dan-olsen/SeniorDesign/DesignReport/Appendix/Images/ProjectPAMPrezi02.png

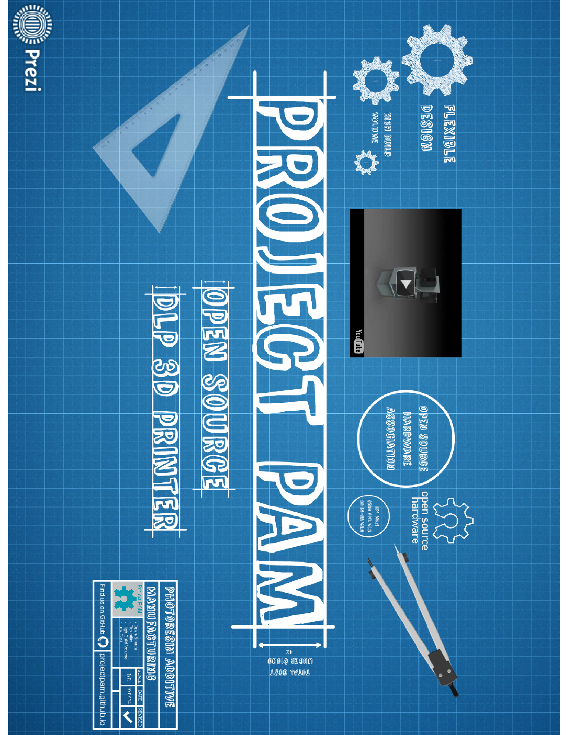
DesignReport/Appendix/Images/ProjectPAMPrezi02.png
