dan-olsen/SeniorDesign/DesignReport/Appendix/Images/Cool Crowdfunding_ October 26, 20141.png

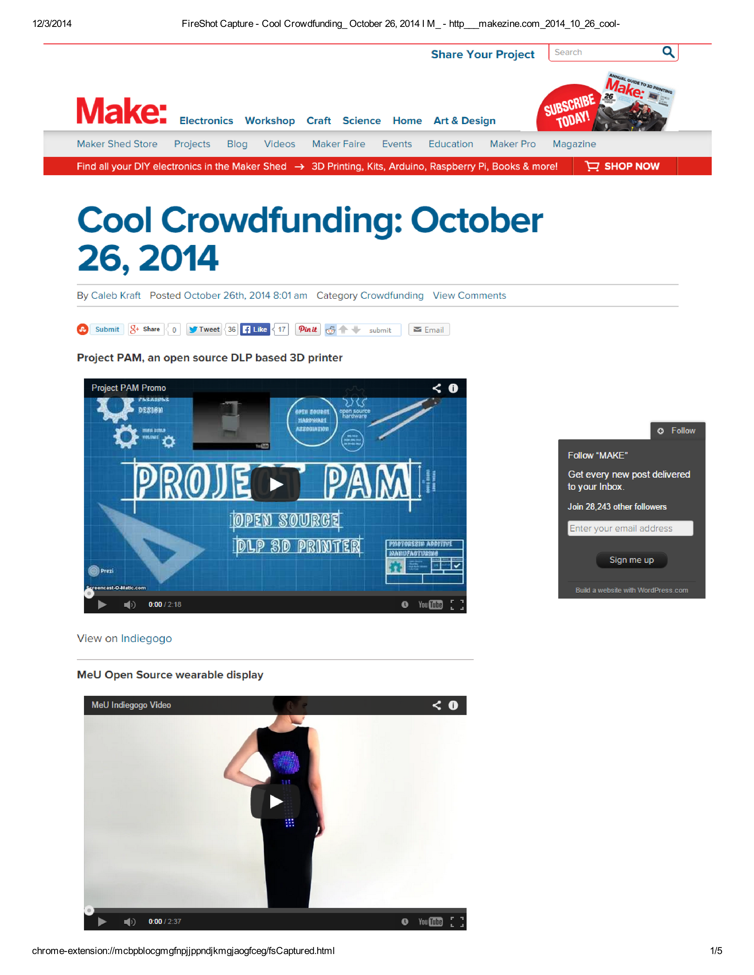
DesignReport/Appendix/Images/Cool Crowdfunding_ October 26, 20141.png
