dan-olsen/SeniorDesign/Poster/ProjectPAMPoster.pptx

## Project PAM

The world’s first open source dlp
3d printer

## Slide 2

## Slide 3

## Slide 4

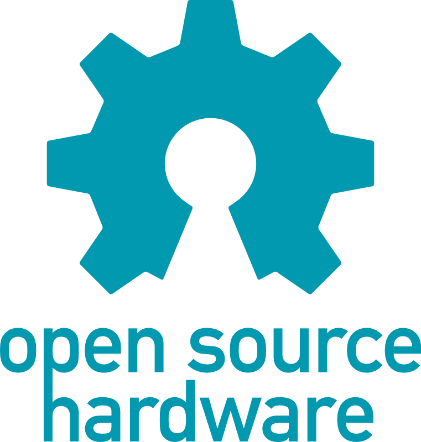
[picture p15: figure]

## Problem

  - High resolution additive manufacturing is not accessible for hobbyists (under $1,000)
  - Current hobbyist 3D printers are imprecise, fault-prone, and poorly documented
  - Available PAM systems are inflexible, use proprietary hardware and software

## Solution

  - Libre
  - Accessible to the hobbyist
  - Precise and repeatable
  - Flexible for the end user
  - Off-the-shelf open-source hardware
  - A thoroughly documented reference design

## Market Gap

## Specifications

Geometry | Dimension/Tolerance
Build Volume Size | 192 mm x 216 mm x 216 mm
X and Y Axis Resolution | 0.100 mm
Minimum Layer Height | 0.015 ± 0.002 mm
Parallelism/Perpendicularity of a 20 mm cube | 0.050 mm
Dimensional Tolerance of a 20 mm cube | ± 0.050 mm

## Current Prototype

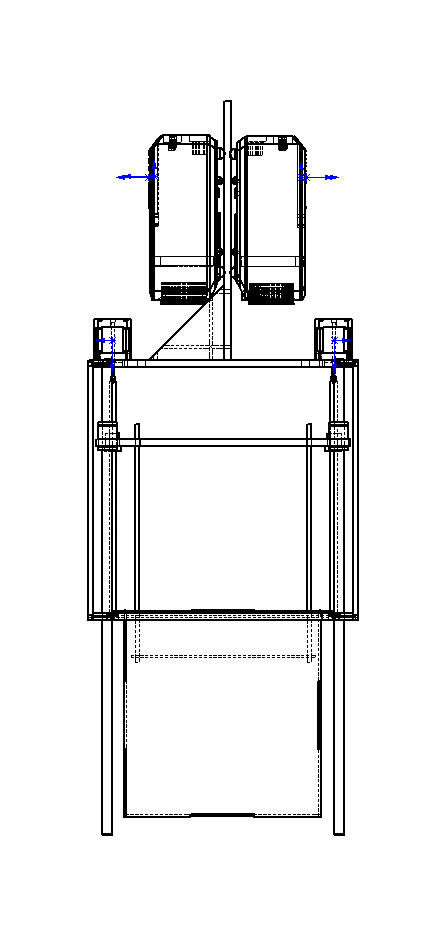
[picture p16: figure]
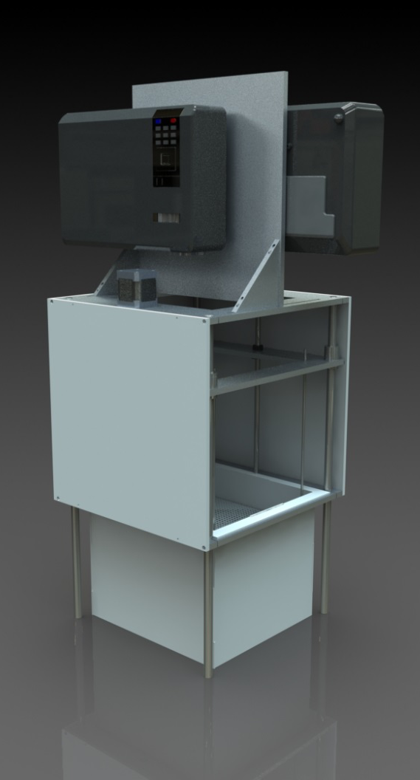
[picture p17: figure]
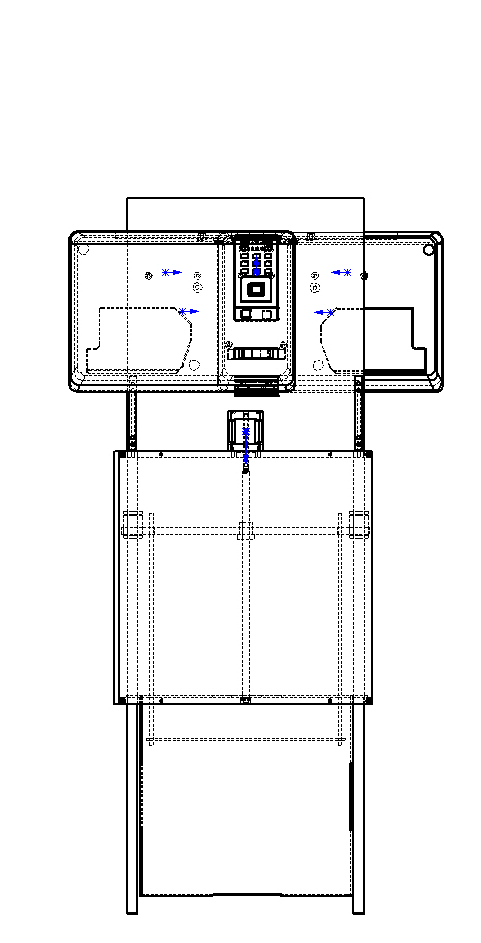
[picture p18: figure]

## Slide 10

## Wire Diagram

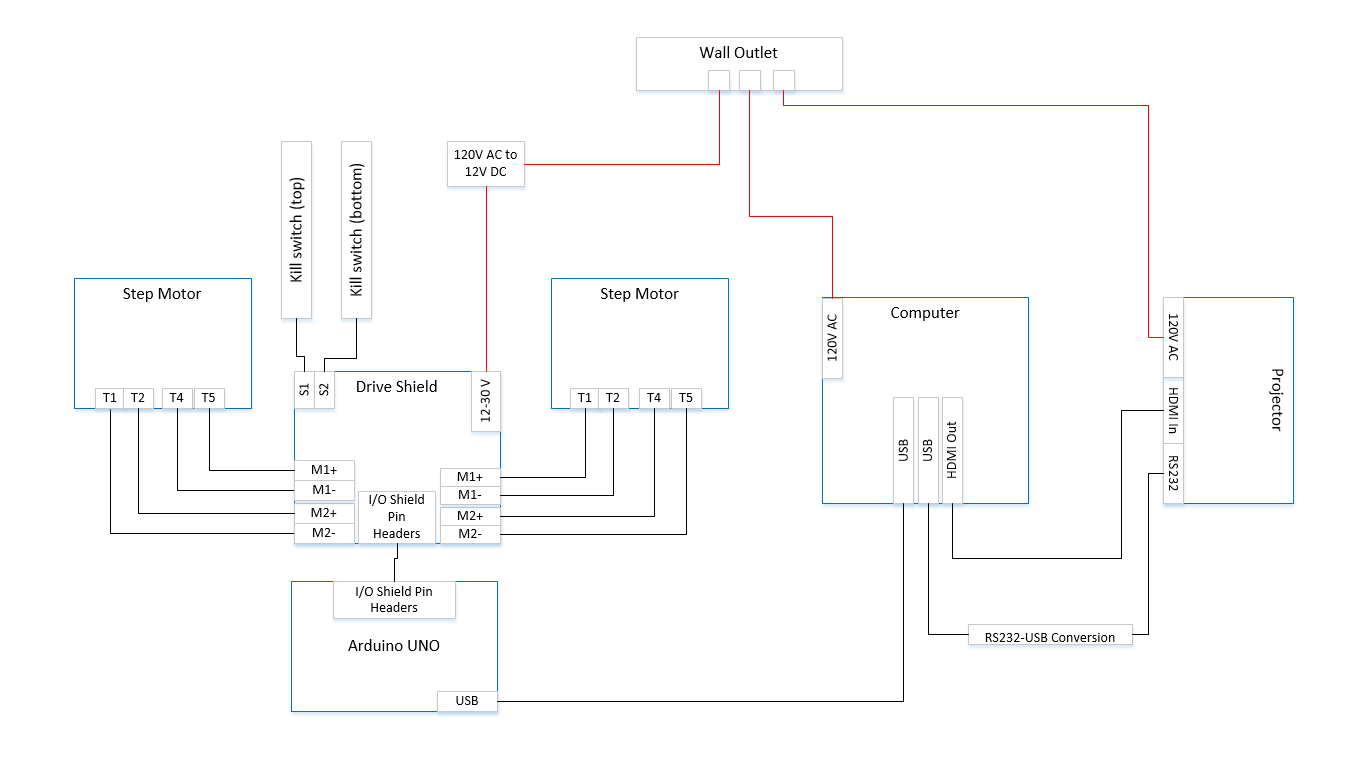
[picture p19: figure]

## Functional Block Diagram

## Cost

Item | Price
Motion control | $113.61
Chassis | $315.99
Hardware software interface | $25.97
Motors/motor control | $82.83
Maker Juice resins | $45.00
Total | $602.17

## Full System Run

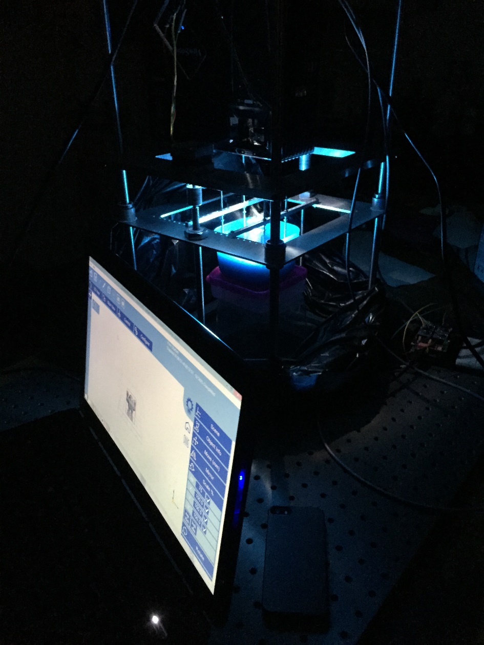
[picture p20: figure]

## Test Prints

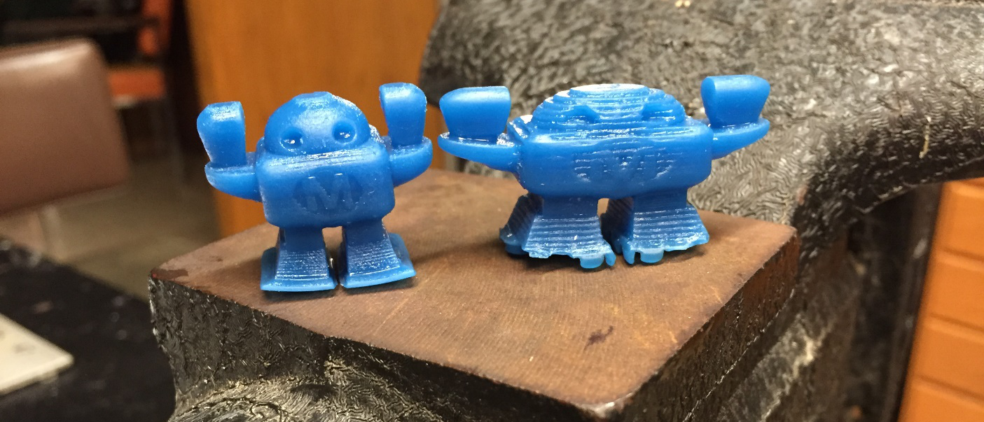
[picture p21: figure]
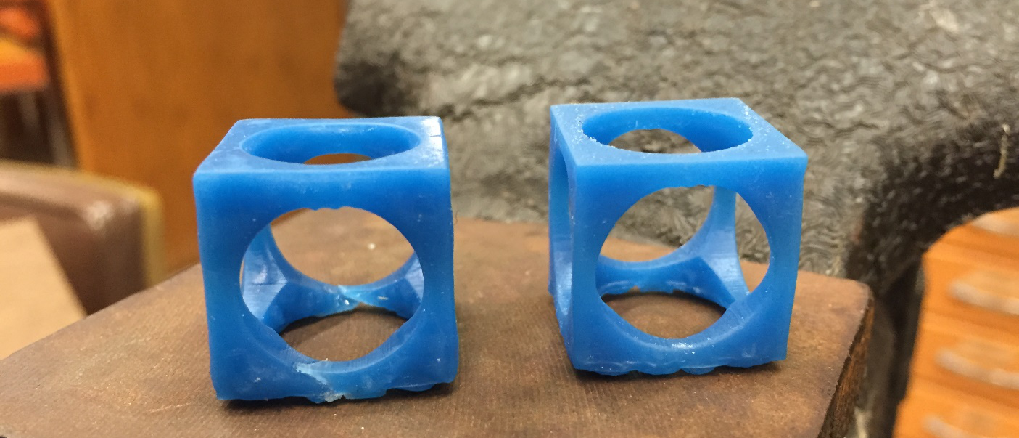
[picture p22: figure]

## Slide 16

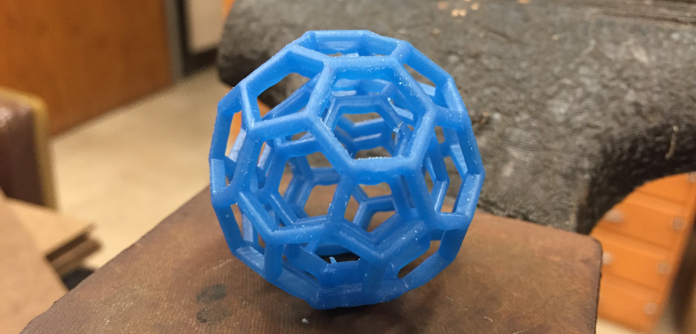
[picture p23: figure]
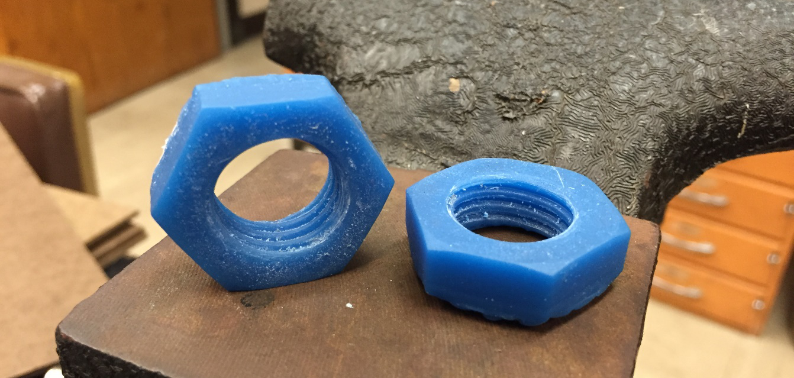
[picture p24: figure]
