dan-olsen/SeniorDesign/DesignReport/jeffsPart/ProjectPamReport.docx

Project PAM

A Reference Design for

Photoresin Additive Manufacturing for

The Open Source Community

Saluki Engineering Company

Reference Number: S14-75-3DPR

Date

Nicholas Lowman | Computer Engineering
Daniel Olsen | Computer Engineering
Chance Baker | Electrical Engineering
Casey Spencer | Electrical Engineering
Jeffrey Burdick | PM Mechanical Engineering
Nathaniel Tyler | Mechanical Engineering

# Transmittal Letter: CWB

2014-11-18

Saluki Engineering Company

Southern Illinois University Carbondale

College of Engineering – Mail Code 6603

1230 Lincoln Drive

Carbondale, IL 62901

Steven Blair, President

Saluki Makerspace

Southern Illinois University Carbondale

College of Engineering – Mail Code 6603

Room E0021

1230 Lincoln Drive

Carbondale, IL 62901

Mr. Blair,

On behalf of the Saluki Engineering Company, I would like to thank you for including us in the bid for a project to design a digital light processing printer. Attached is a design report for a DLP photoresin printer, Project PAM. Along with this report, we have included the computer host software code and build instructions of the prototype.

Project PAM proposes a reference Photoresin Additive Manufacturing (PAM) system which maximizes accessibility to the hobbyist. It is intended to be easily obtainable to consumers. This is achieved through extensive use of currently available or easily fabricated hardware and open-source software. The design allows this hardware to be very flexible, to scale to the size requirements of the maker. The reference design will be open-source hardware and software to the lowest practical level. Thorough documentation will provide the necessary means for the maker to go from an empty table to a functioning printer.

Our prototype is constructed to allow a build volume up to 192 mm x 216 mm x 216 mm with an X and Y pixel size of 100 μm and layer thicknesses down to 10 µm. In its current single-projector configuration it can provide a build volume of up to 216 mm x 121.5 mm with an X and Y pixel size of 112.5 µm. It can also close focus to provide a much smaller pixel size for smoother builds of smaller objects. This can be accompanied with a smaller build table and build vat to involve a smaller volume of resin.

The prototype comes with a 1920 x 1080 pixel ViewSonic projector which has been proven to provide very close focusing and will be perfect for later expansion to a large volume two projector system.

Please feel free to contact me at (815) 214 9661 or by email, burdickjp@siu.edu, if you have questions about this project.

Sincerely,

Jeffrey P Burdick

Project Manager

Project PAM: Team75-3DPR

Saluki Engineering Company

(815) 214-9661

burdickjp@siu.edu

# Acknowledgements: CWB

We would like to express our thanks to Dr. Spyros Tragoudas and Dr. Rasit Koc along with the Electrical and Computer Department and the Mechanical Department for the support and financial contributions. The project would not have been possible without their financial backings.

We would also like to take the time to thank the backers of the crowed funding campaign. Very person’s contribution was very much accommodating to the needs of our group. We would like to thank them for not only their financial report but their words of encouragement and belief in our project.

From the beginning of the project Dr. Lizette Chevalier has given priceless words of encouragement and advice that has been very critical to the success of the project.

At this time we would like to thank Lakendria Kenner of WSIU, Scott J. Grunewald of 3D Printing Industry, Eddie Krassenstein of 3D Print, and Austin Miller of Dailey Egyptian for the kind words in their articles. Their articles have help spread the work of Project PAM out to the global community.

We would like to take this opportunity to thank Dr. James Mathias for him allowing us to have use to his laboratory space giving Project PAM a place to call home.

We also would like to express a deep sense of gratitude to the team’s Faculty Technical Advisors; Dr. James Mabry and Joe Lennox, for their constant support, valuable guidance, and professional advice throughout the various stages of the design project.

We are grateful for the assistance of Tim Attig of the SIUC Machine Shop. His vast machining skills and knowledge have been a great part of the project’s success. Tim’s time and technical advice was invaluable to the team.

Lastly, we would like to thank the professors and teachers of the class; Dr. Tod Policandriotes, Dr. Vidya Singh-Gupta, Dr. Frances Harackiewicz, and Dr. Alan J. Weston for their support, ideas, and suggestions.

# Table of Contents: CWB

# Table of Figures: CWB

# Table of Tables: CWB

# Table of Drawings: CWB

# 1 Executive Summary:CWB

Project PAM proposes a reference Photoresin Additive Manufacturing (PAM) system which maximizes accessibility to the hobbyist. It is intended to be flexible by allowing for configurations of hardware available or easily obtainable to the maker. This is achieved through extensive use of currently available or easily fabricated hardware and open-source software. The reference design uses open-source hardware and software to the lowest practical level. Thorough documentation provides the necessary means for the maker to go from an empty table to a functioning printer.

The major subsystems of Project PAM include: Mechanical Motion, Chassis, Printer Control Software, Hardware-Software Interface, Resin Management, Optics, Vat, and Coupler. Our teams is still striving to achieve the optimist solution to achieve the highest level of quality.

Several of the design activities and decisions show how Project PAM is more desirable than the competition. One example of this is Project PAM’s build volume size. The maximum build volume is almost double that of any other DLP printer. This is achieved by supporting the use of two 1920 x 1080 pixel projectors. As consumer resins increase with quality this feature will allow the PAM system to grow. Though the maximum build volume would use up to 9 L of resin, Project PAM’s flexible design can accommodate smaller vats and build tables. The maker can use a vat and build table sized appropriately for their build. This will minimize resin waste, saving the maker money.

This printer is expected to have the capability of producing high quality prints. The initial goals of Project PAM included: keep the cost of the project under $700 excluding the price of the projectors, support the use of two projectors, have a maximum build size of approximately 8 L, layer thickness as thin as 100 µm, and have a printing resolution error within 100 µm.

The prototype is sized to support a build volume of 192 mm x 216 mm x 216 mm which is a volume of 8.9 L. This would be achieved through the use of two 1920 x 1080 pixel projectors used in tandem, providing a pixel size of 100 μm. The prototype is currently configured with a single 1920 x 1080 pixel projector. With 2mm pitch lead screws and stepper motors providing 200 steps per revolution layer heights can be as thin as 10 µm without microstepping.

This report consists of: a project description that will introduce the report and project, a cost analysis allowing the open-source community to see the end cost, expected build time schedule, detailed subsystems descriptions along with recommendations, and an appendix.

# 2 Project Description:

## 2.1 Introduction: CWS

Today when one uses the term "3D printing" they referring to the manufacturing process that allows a digital model to be manufactured through an additive process. 3D printing is unique from other machining processes because it implements what's known as additive manufacturing rather than the more common techniques of drilling or cutting to remove material. 3D Printers are able to accomplish this by slicing the virtual models into several two dimensional layers and then printing those layer one by one to build up the object. This is advantageous because it is much less wasteful than traditional techniques. A 3D printer is also capable of building nearly any object which allows manufacturers to change products without having to buy any new equipment.

The first 3D printer was built in 1984 by Chuck Hall [1] but the process has not been widely available until the early 2010's. Printers are most commonly used for cheap and rapid prototyping but the process has shown potential in a number of fields, including architecture, automotive design, and even the biomedical field to print human tissue and organs. Because of this potential the industry is estimated to be worth more than $2.2 billion today [2].

There are several techniques used to accomplish this layer-by-layer building operation, the most common of the additive manufacturing processes today is extrusion deposition. With this extrusion deposition each 2D layer is built by extruding a bead of material which will harden almost instantly upon leaving the extruder nozzle. The nozzle head moves across a surface depositing the material in the shape of the given layer and then moves on to build the next layer of the object. As each layer is added the print object gains volume. This method is simple and inexpensive but is less accurate than other techniques and also error prone since any defect can lead to a jam or clog in the extruder.

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

## 2.2 overall Printer Diagram:

Figure 1. Flow Diagram for Project PAM printer control software

# 3 Costs:

# 4 Schedules:

# 5 Subsystem Descriptions:

## 5.1 Chassis-JPB

### 5.1.1 Process of Design

An early goal of the hardware design was to have a product which was very rigid and allowed adjustability for all pieces which need to be aligned. Several options were considered for the construction of the chassis, from an incorporated enclosure and chassis design to open source linear motion systems.

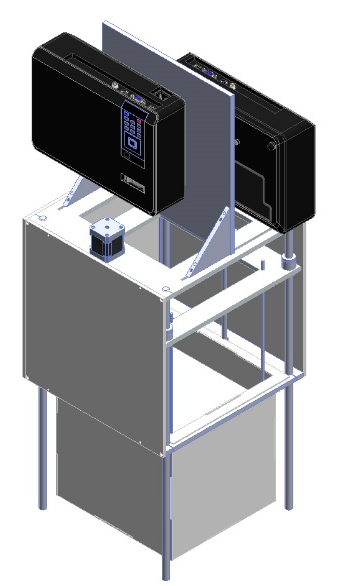
[picture p33: figure]

Figure 2. An isometric view of the current chassis design

It was decided that conventional round linear bearing shafts could be used as the vertical component of the chassis, as shown in Figure 2. This removes the necessity for a separate vertical chassis structure. This simplified the chassis design to just two horizontal structural plates to hold the motion-driving components, projector, and vat, and the linear bearing shafts. The chassis plates attach to the linear bearing shafts by clamping. The height of the system could then be easily changed, and the system could be easily squared by adjusting the plates and shafts.

A design was considered which used three linear bearing shafts as legs instead of four, as this would make the alignment process easier and was thought to reduce material. It was found that material costs would not be reduced, as a configuration using three or four legs would involve ordering the same length of shaft because of minimal material requirements with most industrial suppliers. The tripod design would also necessitate larger chassis plates and more material waste.

The initial design proposal involved chassis dimensions of 300 x 320 mm to accommodate stepper motors mounted on the bottom chassis plate. This would require the order of a 12 x 18 inch plate and involve wasting a lot of material. In order to fit the design within a 12 x 12 inch plate the stepper motors were moved to the top plate. This also allowed the weight of the carriage to be carried by thrust bearings in the bottom plate rather than the stepper motors and couplers.

The throw and focusing distance of the project allowed it to be clamped directly to the top chassis plate. Testing could then be accomplished without needing to permanently mount the projector.

### 5.1.2 Process of Assembling

The four bearing shafts are placed in the bottom chassis plate. The protrusion of the shafts from the plate is established using calipers. One of the shafts is tightened fully, while the others are left snug. The assembly is then placed on a surface plate and the chassis plate is leveled using a height gage. The carriage is placed on the bearing shafts and the top plate is placed. After the correct distance between the two plates is determined, the top chassis plate is leveled using the height gage and the carriage can be leveled according to the assembly directions in section 5.2.2.

### 5.1.3 IMPLEMENTATION SCHEDULE

### 5.1.4 Equipment Needed

Manufacturing of the prototype was completed using machine tools, but manufacturing for the maker can be achieved by water jetting, EDM, or CNC machining. This is easy and inexpensive to contract with machine shops, or made in bulk. Finish machining can be done using hand tools.

### 5.1.5 Health and Safety Issues

### 5.1.6 Recommendations

An enclosure can be assembled from nearly any sheet material. Gaffers tape is good for sealing. When doing quick testing a leaf bag can be used as an expedient enclosure.

## 5.2 Mechanical Motion-JPB

### 5.2.1 Process of Design

The single axis of motion is achieved by the use of a carriage plate riding on four linear bearings riding on the chassis shafts. The build table hangs from this carriage into the vat.

The initial motion control design involved a single lead screw. It was determined that the rigidity required to implement the design with a single lead screw would require a prohibitive amount of complication. Using two lead screws would allow for smoother operation without an excessive cost increase. Both lead screws ride on ball-bearing thrust bearings held in the bottom chassis plate.

Backlash has been a rather prolific problem with 3d printers of all varieties. Many interesting and complicated methods of handling backlash have been suggested in the community [3]. It was decided to make the lead screw nut out of acetal and attempt a novel method of implementing threads which involved heating the lead screw and allowing the acetal to flow form around it [4]. The cooled lead screw nut would then fit more snugly than cut threads. This proved excessively difficult with the acetal used. It was decided to abandon this method in favor of a more traditionally manufactured lead screw nut, but retain delrin as the material of choice. A section of lead screw was used to construct a tap and a section of acetal was drilled to the smallest inside diameter specified for the thread profile in the hopes that a tight fit could be achieved. After tapping this proved to provide a sufficiently tight enough fit to prevent backlash. When implemented on the chassis it has shown to not produce so much friction as to cause mistepping of the stepper motors.

The stepper motors are connected to the lead screws by flexible couplers, which allow axial misalignment while maintaining torque transmission. While off-the-shelf components are readily available and inexpensive, a design for these couplers is included in the project.

### 5.2.2 Process of Assembling

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

The build table should be suspended from the carriage and leveled. The level of the build table should be checked by filling the vat with salt water and adjusting the build table to ensure that the liquid is level over the build table.

### 5.2.3 IMPLEMENTATION SCHEDULE

### 5.2.4 Equipment Needed

Proper leveling should be done on a surface plate with a height gage, but can be achieved on any sufficiently flat surface with a good ruler, calipers, or trammel points.

### 5.2.5 Health and Safety Issues

### 5.2.6 Recommendations

Suspending smaller build tables by three rods instead of four should allow faster leveling. If there is a bend or warp to the table the fourth rod can be introduced to minimize this. Level and flatness of the build table is much more obvious when suspended over a level of liquid than when just using a height gage.

## 5.3 Printer Control Software- DMO

## 5.4 Hardware-Software Interface- NAL

## 5.5 Resin Management-CWB

### 5.5.1 Process of Design

As Project PAM was unfolding, the decision to become a photoresin printer emerged. The first design of the resign was to use a custom product from Momentive. Momentive Specialty Chemicals Inc. serves the global wood and industrial markets through a broad range of thermoset technologies, specialty products and technical support for customers in a diverse range of applications and industries [3]. This would have allowed Project PAM complete control over the wavelength needed to cure the resin, over the color, over the density, and over the curing agents.

Because of the goal of the project to be completely open source, this idea was abandon for buying resins that will be more accessible to the open source community. While looking through photoresin system forums, there was one company that had shown up on mutable post as being reliable and cost effective, MakerJuice [4]. MakerJuice is an American company first started in 2013 with a focus of quality and low cost resins aimed for the hobbyists’ community [5]. They have sold over eight-thousand items and have over two-thousand customers since their start [5]. This gave Project PAM the facts it needed to use MakerJuice for the prototype.

### 5.5.2 Health and Safety Issues

Resins by MakerJuice are in compliance of USA and Canada standards [5]. Safety Data Sheets (SDS) for all of their products can be found on their website. The SDS for the resin G+, ordered by Project Pam can be found in this report at 7.1.

G+ is a category 2 skin corrosion, category 1 serious eye damage, and a category 1 for skin sensitization set by the 2012 OSHA Hazard Communication Standard [5]. The precautionary prevention steps are as follows: Wash face, hands and any exposed skin thoroughly after handling, wear protective gloves/protective clothing/eye protection/face protection, avoid breathing dust/fume/gas/mist/vapors/spray, and contaminated work clothing should not be allowed out of the workplace [5].

The precautionary response steps are as follows: If in the eyes; Rinse cautiously with water for several minutes. Remove contact lenses, if present and easy to do. Continue rinsing. Immediately call a POISON CENTER or doctor/physician. If on the skin; Wash with plenty of soap and water. Take off contaminated clothing and wash before reuse. If skin irritation or rash occurs: Get medical advice/attention [5].

### 5.5.3 Recommendations

There are several different types of resins that are open to the hobbyist community. Some resins cure harder than other resin, but this can result in a longer cure time. Different types of resins can allow for the end print to be flexible, like MakerJuice’s Flex [5].

There are a few things to keep in mind while shopping for resin. The first thought is the cost. There are several companies that are based out of the US who have cheaper resins but the shipping cost is sometimes up to triple the cost of their product. Another thought is the shrink percent. MakerJuice’s G+ substance has an experimental shrinkage of 3.3%, while their G substance has an 8% experimental shrinkage [5]. Shrinkage is the most common problem with prints with a build volume over 100cm³ [4]. The G+ was $45.00 a liter, and the G was $40 a liter in May of 2014 [5]. The maker will have to decide if it is worth the extra $5 to ensure precise prints.

To help offset the use of resin several hobbyist have had success of using saltwater [4]. The resin floats on top of the saltwater. This means that a hobbyist only needs to put as much resin in the vat as what is needed for the build or the layer thickness. With the price of most resins being around $50, this idea is a great way to save resin and money.

## 5.6 Optics-CWB

### 5.6.1 Process of Design

## 5.7 Vat-NBT

## 5.8 Coupler-NBT

# 6 References: CWB

[1] | "3D Printing: What You Need to Know," [Online]. Available: http://www.pcmag.com/slideshow_viewer/0,3253,l=293816&a=289174&po=1,00.asp. [Accessed 17 April 2014].
[2] | "3D Printing Scales Up," The Economist, 7 September 2013.
[3] | "Momentive," Momentive, 2014. [Online]. Available: http://www.momentive.com/. [Accessed 2014].
[4] | "Resin," Build Your Own SLA, January 2014. [Online]. Available: www.buildyourownsla.com. [Accessed 26 February 2014].
[5] | "MakerJuice," MakrJuice Labs, 2014. [Online]. Available: www.makerjuice.com. [Accessed May 2014].

# 7 Appendix

## 7.1 MakerJuice Safety Data Sheet

Issue Date 19-Nov-2013 Revision Date 22-May-2014 Version 2

1. IDENTIFICATION OF THE SUBSTANCE/PREPARATION AND OF THE COMPANY/UNDERTAKING

Product identifier

Product Name SUBSTANCE G+

Other means of identification

Synonyms SubG+

Recommended use of the chemical and restrictions on use

Recommended Use General Purpose UV Cure Resin

Uses advised against No information available

Details of the supplier of the safety data sheet

Manufacturer Address

MakerJuice Labs LLC

14100 Santa Fe Trail Drive

Suite #105

Lenexa, KS 66215 USA

Email: josh@makerjuice.com

Website: http://www.makerjuice.com

Emergency telephone number

Company Phone Number (913) 777-4996 [9-5PM CST, M-F]

2. HAZARDS IDENTIFICATION

Classification

OSHA Regulatory Status

This chemical is considered hazardous by the 2012 OSHA Hazard Communication Standard (29 CFR 1910.1200)

Skin corrosion/irritation Category 2

Serious eye damage/eye irritation Category 1

Skin sensitization Category 1

Label elements

Emergency Overview

Danger

Hazard statements

Causes skin irritation

Causes serious eye damage

May cause an allergic skin reaction

Appearance viscous Physical state liquid Odor Ester

Precautionary Statements - Prevention

Wash face, hands and any exposed skin thoroughly after handling

Wear protective gloves/protective clothing/eye protection/face protection

Avoid breathing dust/fume/gas/mist/vapors/spray

Contaminated work clothing should not be allowed out of the workplace

Precautionary Statements - Response

IF IN EYES: Rinse cautiously with water for several minutes. Remove contact lenses, if present and easy to do. Continue rinsing.

Immediately call a POISON CENTER or doctor/physician

IF ON SKIN: Wash with plenty of soap and water

Take off contaminated clothing and wash before reuse

If skin irritation or rash occurs: Get medical advice/attention

Precautionary Statements - Disposal

Dispose of contents/container to an approved waste disposal plant

Hazards not otherwise classified (HNOC)

Not Applicable

Other Information

Unknown Acute Toxicity 0% of the mixture consists of ingredient(s) of unknown toxicity

3. COMPOSITION/INFORMATION ON INGREDIENTS

Chemical Name CAS No. Weight-% Trade Secret

acrylate ester proprietary >60 *

photoinitiator proprietary <1 *

* If CAS number is "proprietary", the specific chemical identity has been withheld as a trade secret. The exact percentage

(concentration) of composition has been withheld as a trade secret.

4. FIRST AID MEASURES

First aid measures

General advice If symptoms persist, call a physician.

Eye contact Immediately flush with plenty of water. After initial flushing, remove any contact lenses

and continue flushing for at least 15 minutes. Keep eye wide open while rinsing. If

symptoms persist, call a physician.

Skin Contact Avoid UV-radiation/sunlight. Wash off immediately with soap and plenty of water while

removing all contaminated clothes and shoes. If skin irritation persists, call a physician.

Wash contaminated clothing before reuse.

Inhalation If fumes from reactions are inhaled, move to fresh air immediately. If symptoms persist,

call a physician.

Ingestion Rinse mouth. Drink plenty of water. Do NOT induce vomiting. Call a physician immediately.

Self-protection of the first aider Use personal protective equipment as required.

Most important symptoms and effects, both acute and delayed

Symptoms May cause allergic skin reaction.

Indication of any immediate medical attention and special treatment needed

Note to physicians May cause sensitization of susceptible persons. Treat symptomatically.

5. FIRE-FIGHTING MEASURES

Suitable extinguishing media

Dry chemical, CO2, alcohol-resistant foam or water spray.

Unsuitable extinguishing media: Do not use a solid water stream as it may scatter and spread fire.

Specific hazards arising from the chemical

In the event of fire and/or explosion do not breathe fumes. May cause sensitization by inhalation and skin contact. Thermal

decomposition can lead to release of irritating and toxic gases and vapors.

Hazardous combustion products: Formaldehyde.

Explosion data

Sensitivity to Mechanical Impact: None.

Sensitivity to Static Discharge: None.

Protective equipment and precautions for firefighters

Wear self-contained breathing apparatus for firefighting if necessary.

6. ACCIDENTAL RELEASE MEASURES

Personal precautions, protective equipment and emergency procedures

Personal precautions Ensure adequate ventilation, especially in confined areas. Use personal protective

equipment as required. Avoid contact with eyes and skin. Evacuate personnel to safe

areas. Keep people away from and upwind of spill/leak.

Environmental precautions

Environmental precautions Do not flush into surface water or sanitary sewer system. See Section 12 for additional

ecological information.

Methods and material for containment and cleanup

Methods for containment Prevent further leakage or spillage if safe to do so.

Methods for cleaning up Soak up with inert absorbent material. Pick up and transfer to properly labeled containers.

After cleaning, flush away traces with water.

7. HANDLING AND STORAGE

Precautions for safe handling

Advice on safe handling Use only in well-ventilated areas. Avoid breathing fumes from hot material. Use personal

protective equipment as required. Do not breathe dust/fume/gas/mist/vapors/spray.

Conditions for safe storage, including any incompatibilities

Storage Conditions Keep out of the reach of children. Keep containers tightly closed in a cool, well-ventilated

place. Keep in properly labeled containers. Protect from direct sunlight and ultraviolet (UV).

Keep away from heat.

Incompatible materials Strong oxidizing agents. Strong acids. Strong bases.

8. EXPOSURE CONTROLS/PERSONAL PROTECTION

Control parameters

Exposure Guidelines This product, as supplied, does not contain any hazardous materials with occupational

exposure limits established by the region specific regulatory bodies.

Appropriate engineering controls

Engineering Controls Ensure adequate ventilation, especially in confined areas.

Individual protection measures, such as personal protective equipment

Eye/face protection Tight sealing safety goggles.

Skin and body protection Wear protective nitrile rubber gloves.

Respiratory protection In case of insufficient ventilation, wear suitable respiratory equipment.

General Hygiene Considerations When using do not eat, drink or smoke. Wash face, hands and any exposed skin thoroughly

after handling. Wash contaminated clothing before reuse. Regular cleaning of equipment,

work area and clothing is recommended.

9. PHYSICAL AND CHEMICAL PROPERTIES

Information on basic physical and chemical properties

Physical state liquid

Appearance viscous Odor Ester

Color red, yellow, green, blue, black, white Odor threshold No information available

Property Values Remarks • Method

pH No information available

Melting point/freezing point No information available

Boiling point / boiling range No information available

Flash point > 100 °C (> 212 °F)

Evaporation rate No information available

Flammability (solid, gas) No information available

Flammability Limit in Air

Upper flammability limit: No information available

Lower flammability limit: No information available

Vapor pressure No information available

Vapor density No information available

Specific Gravity Approx. 1

Water solubility Low solubility

Solubility in other solvents No information available

Partition coefficient No information available

Autoignition temperature No information available

Decomposition temperature No information available

Kinematic viscosity No information available

Dynamic viscosity 90 cP @ 20 °C

Explosive properties No information available

Oxidizing properties No information available

Other Information Softening point No information available

Molecular weight No information available

VOC Content (%) No information available

Density No information available

Bulk density No information available

10. STABILITY AND REACTIVITY

Reactivity

No data available

Chemical stability

Stable under recommended storage conditions.

Possibility of Hazardous Reactions

None under normal processing.

Conditions to avoid

Heat, flames and sparks. Extremes of temperature and direct sunlight. To avoid thermal decomposition, do not overheat. UVradiation/sunlight.

Incompatible materials

Strong oxidizing agents. Strong acids. Strong bases.

Hazardous Decomposition Products

Formaldehyde.

11. TOXICOLOGICAL INFORMATION

Information on likely routes of exposure

Product Information

Inhalation No data available.

Eye contact Risk of serious damage to eyes.

Skin Contact May cause sensitization by skin contact.

Ingestion

Component Information

No data available.

Chemical Name Oral LD50 Dermal LD50 Inhalation LC50

acrylate ester = 4600 mg/kg ( Rat ) > 2 g/kg ( Rabbit ) -

Information on toxicological effects

Symptoms May cause an allergic skin reaction.

Delayed and immediate effects as well as chronic effects from short and long-term exposure

Corrosivity Risk of serious damage to eyes.

Sensitization May cause sensitization by skin contact.

Germ cell mutagenicity No information available.

Carcinogenicity May release formaldehyde when heated to high temperatures [> 150 °C (> 212 °F)] in

the presence of air. Formaldehyde is a known skin and lung sensitizer and is regulated

as a carcinogen.

Reproductive toxicity No information available.

STOT - single exposure No information available.

STOT - repeated exposure No information available.

Aspiration hazard No information available.

Numerical measures of toxicity - Product Information

Unknown Acute Toxicity 0% of the mixture consists of ingredient(s) of unknown toxicity

12. ECOLOGICAL INFORMATION

Ecotoxicity

Toxic to aquatic life

Persistence and degradability

No information available.

Bioaccumulation

No information available.

Other adverse effects No information available

15. REGULATORY INFORMATION

International Inventories

TSCA Complies

Legend:

TSCA - United States Toxic Substances Control Act Section 8(b) Inventory

US Federal Regulations

SARA 313

Section 313 of Title III of the Superfund Amendments and Reauthorization Act of 1986 (SARA). This product does not contain any

chemicals which are subject to the reporting requirements of the Act and Title 40 of the Code of Federal Regulations, Part 372

SARA 311/312 Hazard Categories

Acute health hazard Yes

Chronic Health Hazard No

Fire hazard No

Sudden release of pressure hazard No

Reactive Hazard No

CWA (Clean Water Act)

This product does not contain any substances regulated as pollutants pursuant to the Clean Water Act (40 CFR 122.21 and 40

CFR 122.42)

CERCLA

This material, as supplied, does not contain any substances regulated as hazardous substances under the Comprehensive

Environmental Response Compensation and Liability Act (CERCLA) (40 CFR 302) or the Superfund Amendments and

Reauthorization Act (SARA) (40 CFR 355). There may be specific reporting requirements at the local, regional, or state level pertaining to releases of this material

US State Regulations

California Proposition 65

This product does not contain any Proposition 65 chemicals

U.S. State Right-to-Know Regulations

This product does not contain any substances regulated by state right-to-know regulations

Canada

This product has been classified in accordance with the hazard criteria of the Controlled Products Regulations (CPR) and the MSDS contains all the information required by the CPR WHMIS Hazard Class

D2B - Toxic materials

16. OTHER INFORMATION

NFPA Health hazards 2 Flammability 0 Instability 0 Physical and Chemical

Properties -

HMIS Health hazards 2 Flammability 0 Physical hazards 0 Personal protection X

Issue Date 19-Nov-2013

Revision Date 22-May-2014

Disclaimer

The information provided in this Material Safety Data Sheet is correct to the best of our knowledge, information and belief at the date of its publication. The information given is designed only as a guidance for safe handling, use, processing, storage, transportation, disposal and release and is not to be considered a warranty or quality specification. The information relates only to the specific material designated and may not be valid for such material used in combination with any other materials or in any process, unless specified in the text.

End of Safety Data Sheet
