dan-olsen/SeniorDesign/Presentations/DesignPres/Lowman.pptx

## Firmware

- GRBL - Lightweight Arduino firmware used to interface the software and the motors/hardware
- CNC Motor Shield: 4 pololu drv8825 drivers
  - 4 dual Hbridge drivers with current control logic, allowing for more precise stepping and power management
  - Adafruit Motor Shield (AFMS): Uses an hbridge motor driver
    - 4 hbridge drivers capable of running 2 stepper motors, however lacks some of the logic for more precise control
