dan-olsen/SeniorDesign/Presentations/DesignPres/Casey_HLD.pptx

## Schematic

Wiring Diagram
