dan-olsen/SeniorDesign/Proposal/Sources/GUIDrawings.docx

Startup Page

Layout Page

Slice Page

Print Page
