dan-olsen/SeniorDesign/Presentations/DesignPres/Jeff's Material/ChassisSlides.pptx

## Previous Chassis Proposal


Figure 5. Isometric view
of proposed chassis


Figure 4. Proposed chassis design

## Current Prototype
