dan-olsen/SeniorDesign/Presentations/PP2_75_CWS.pptx

## 3D Printer Team 75

PowerPoint 2: Understanding Problem and Big Picture

## The Problem

- High resolution prints are not currently accessible for hobbyists.
- A DLP printer can produce higher quality and faster prints over current FDM based 3D printers.

## Motivation / Market Gap

- Current SLA printers are not within the price range of the average hobbyist
- Current hobbyist printers produce subpar quality prints

## Our Solution

- Use off-the-shelf open-source hardware to create an open-source SLA printer that is accessible to the hobbyist.
