dan-olsen/SeniorDesign/Presentations/PP3_75_DMO.pptx

## 3D Printer Team 75

PowerPoint 3: System: Criteria, Constraints, HoQ, Functional Block Diagram

## Criteria

- Accessible to the hobbyist
- Open Source and Free ( as in speech )
- Ability to enlarge print area or have larger print area from beginning
- Precise (projector alignment, etc)

## Constraints

- Build size
- Physical size
- Hardware Cost
- Software availability

## House of Quality

## Functional Block Diagram
