dan-olsen/SeniorDesign/Presentations/PP7_75/PP7_75_DMO.pptx

## Team 75-3D Printer Power Point 7

Daniel Olsen (CE), Nicholas Lowman (CE)
Casey Spencer (EE), Chance Baker (EE)
Jeffrey Burdick (ME)- PM

## Chassis sketch

## CAD Drawing

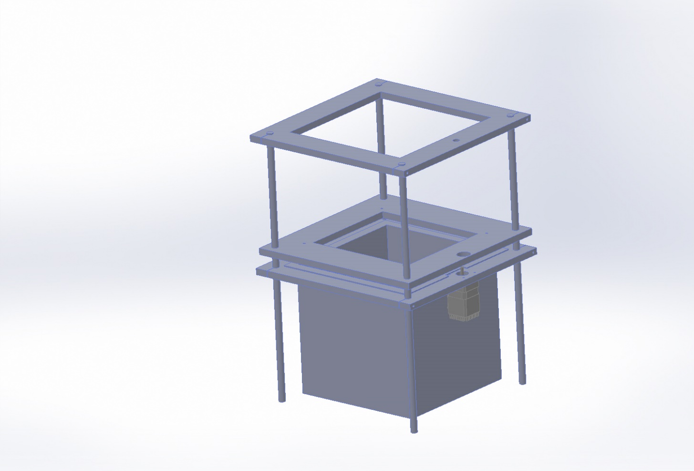
[picture p48: figure]

## User Interface: Startup Page

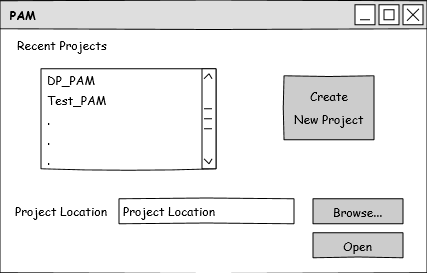
[picture p49: figure]

## User Interface: Layout Page

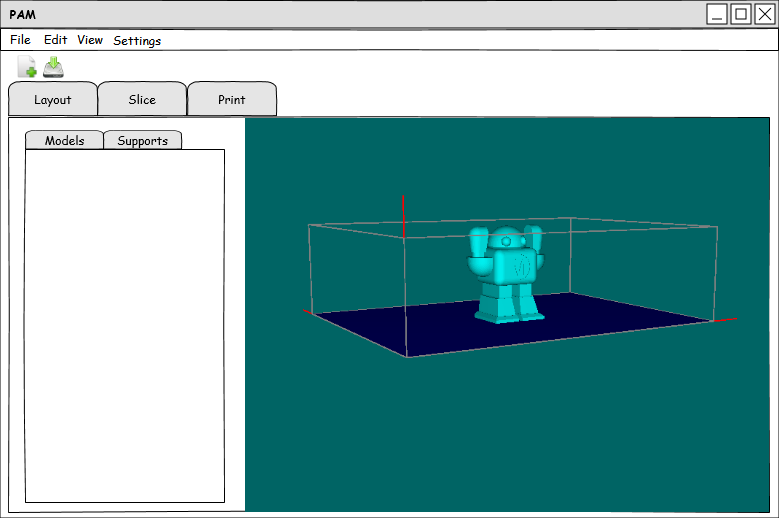
[picture p50: figure]

## User Interface: Slice Page

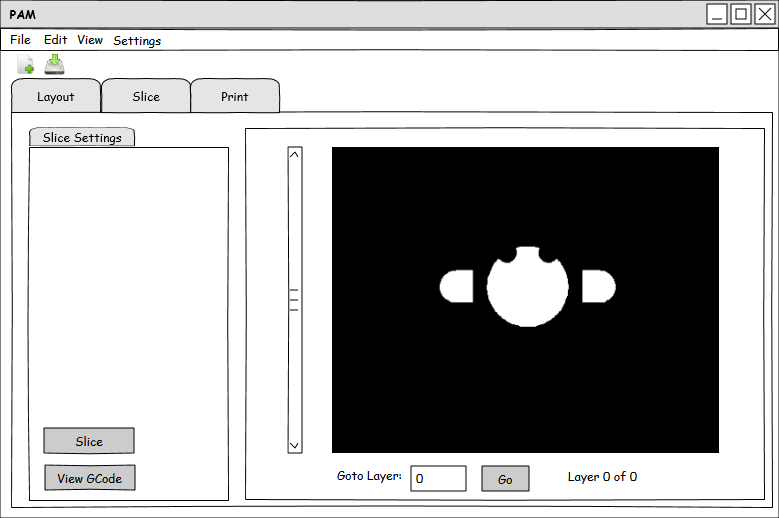
[picture p51: figure]

## User Interface: Print Page

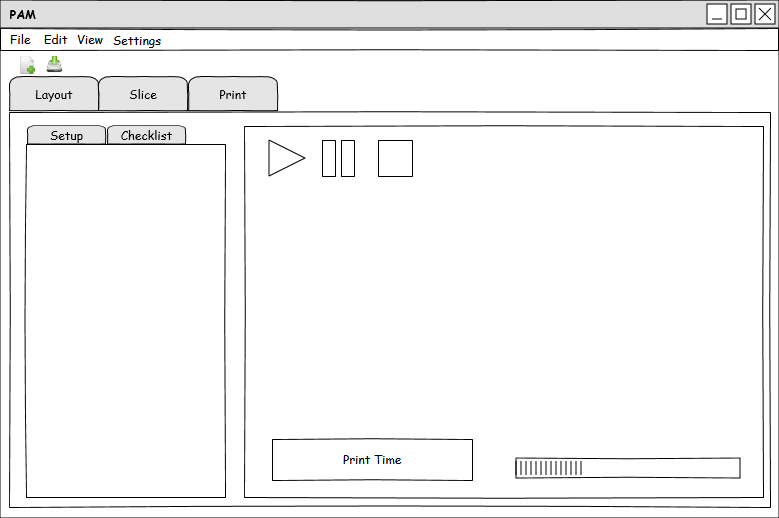
[picture p52: figure]

## Schematic

## Schematic contd.
