dan-olsen/SeniorDesign/Presentations/PP7_75/PP7_75_JPB.pptx

## Team 75-3D Printer Power Point 7

Daniel Olsen (CE), Nicholas Lowman (CE)
Casey Spencer (EE), Chance Baker (EE)
Jeffrey Burdick (ME)- PM

## Chassis sketch

## CAD Drawing


## User Interface: Startup Page


## User Interface: Layout Page


## User Interface: Slice Page


## User Interface: Print Page
