dan-olsen/SeniorDesign/DesignReport/Appendix/Website Screenshots/ProjectPAM_github_io-Hardware.pdf

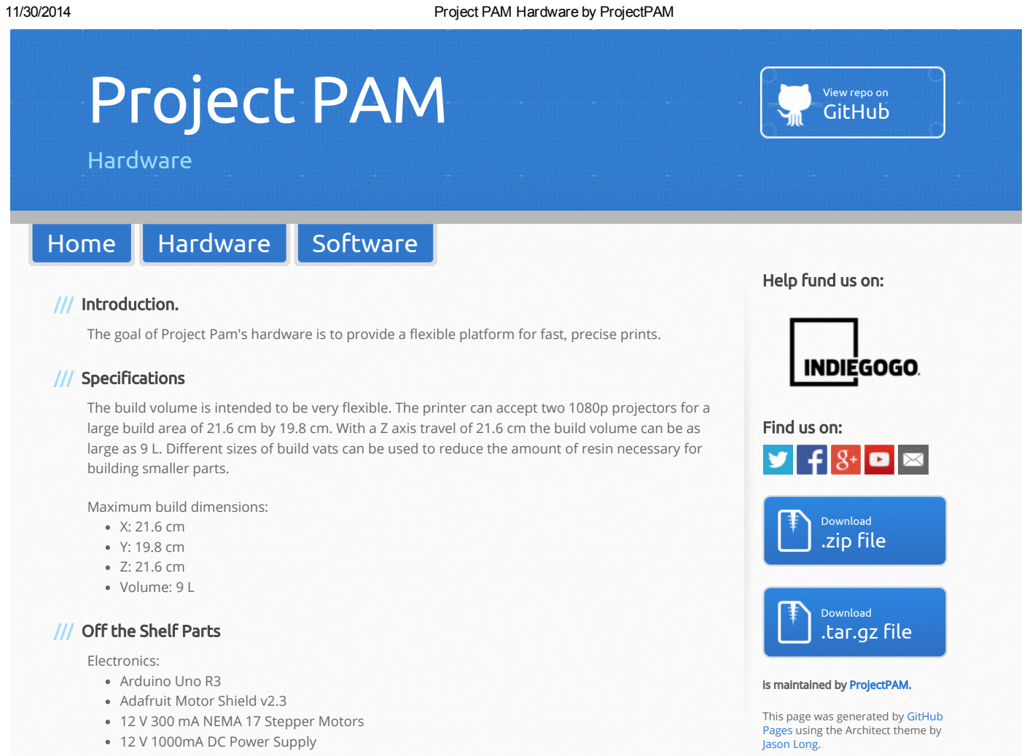
[picture p66: figure]
Project PAM Hardware by ProjectPAM; Home; Hardware; Software; Project PAM; View repo on GitHub; /// Introduction.; /// Specifications; building smaller parts.; Maximum build dimensions: X: 21.6 cm Y: 19.8 cm Z: 21.6 cm Volume: 9 L; /// Off the Shelf Parts; Electronics: Arduino Uno R3 Adafruit Motor Shield v2.3 12 V 300 mA NEMA 17 Stepper Motors 12 V 1000mA DC Power Supply; Help fund us on:; Find us on:; Download .zip file; Download .tar.gz file; is maintained by ProjectPAM.; This page was generated by GitHub Pages using the Architect theme by Jason Long.

file:///C:/Users/Daniel/Documents/GitHub/Hardware/index.html | 1/1

The goal of Project Pam's hardware is to provide a flexible platform for fast, precise prints.

The build volume is intended to be very flexible. The printer can accept two 1080p projectors for a large build area of 21.6 cm by 19.8 cm. With a Z axis travel of 21.6 cm the build volume can be as large as 9 L. Different sizes of build vats can be used to reduce the amount of resin necessary for

The prototype will be tested with G+ resin from MakerJuice Labs.

/// Releases
First Release Coming Soon!

/// Contributing Workflow
Here's how we suggest you go about proposing a change to this project:
1. Fork this project (http://help.github.com/forking/) to your account.
2. Create a branch (https://help.github.com/articles/creating-and-deleting-branches-within-your-repository) for the change you intend to make.
3. Make your changes to your fork.
4. Send a pull request (http://help.github.com/pull-requests/) from your fork's branch to our | master | branch.

Using the web-based interface to make changes is fine too, and will help you by automatically forking the project and prompting to send a pull request too.

/// Contact Us
For general correspondence please email us at projectpam.siu@gmail.com

Questions and comments can be posted on our mailing list (http://groups.google.com/d/forum/projectpam) or you can email them to projectpam@googlegroups.com

Please report all bugs and feature requests through GitHub issues (https://github.com/ProjectPAM/Hardware/issues)

Follow us on GitHub, (https://github.com/ProjectPAM) Twitter, (https://twitter.com/ProjectPAM) Facebook, (https://facebook.com/projectpam.siu) Google+, (https://plus.google.com/+ProjectpamGithubIoSIU) and YouTube. (https://www.youtube.com/user/projectpamsiu)

This work is licensed under a Creative Commons Attribution-ShareAlike 4.0 International License (http://creativecommons.org/licenses/by-sa/4.0/) .
