dan-olsen/SeniorDesign/Proposal/HoQ,Spec,Constraints&DesignBasis/DesignBasis.docx

Design Basis:

Documents | Date | References
B9 Creator | 2013 | In Dan’s lit
MiiCraft | 2012 | In Dan’s Lit
Creation Workshop | 2014 | In Dan’s Lit
