dan-olsen/SeniorDesign/DesignReport/Appendix/Website Screenshots/Project PAM - Indiegogo - Funders.pdf

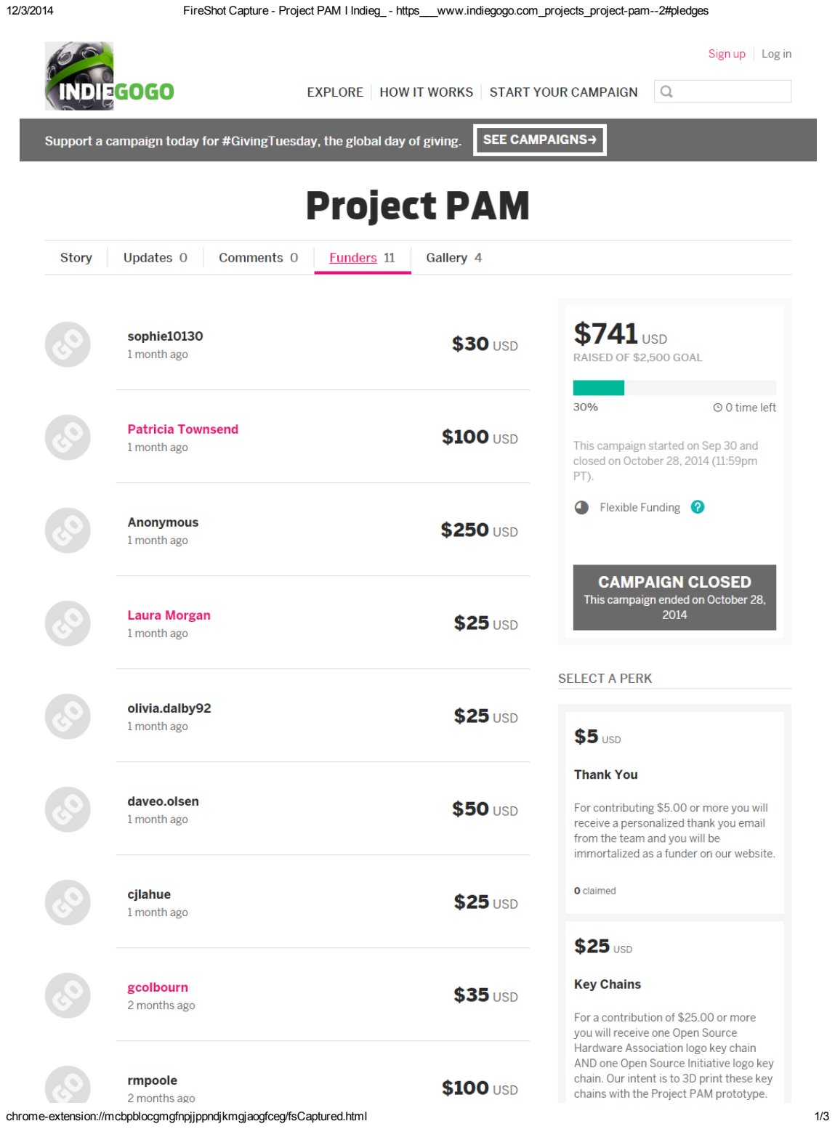
[picture p68: page 1]

12/3/2014 | FireShot Capture Project PAM I Indieg_ https___www.indiegogo.com_projects_projectpam-2#pledges
chromeextension://mcbpblocgmgfnpjjppndjkmgjaogfceg/fsCaptured.html | 1/3

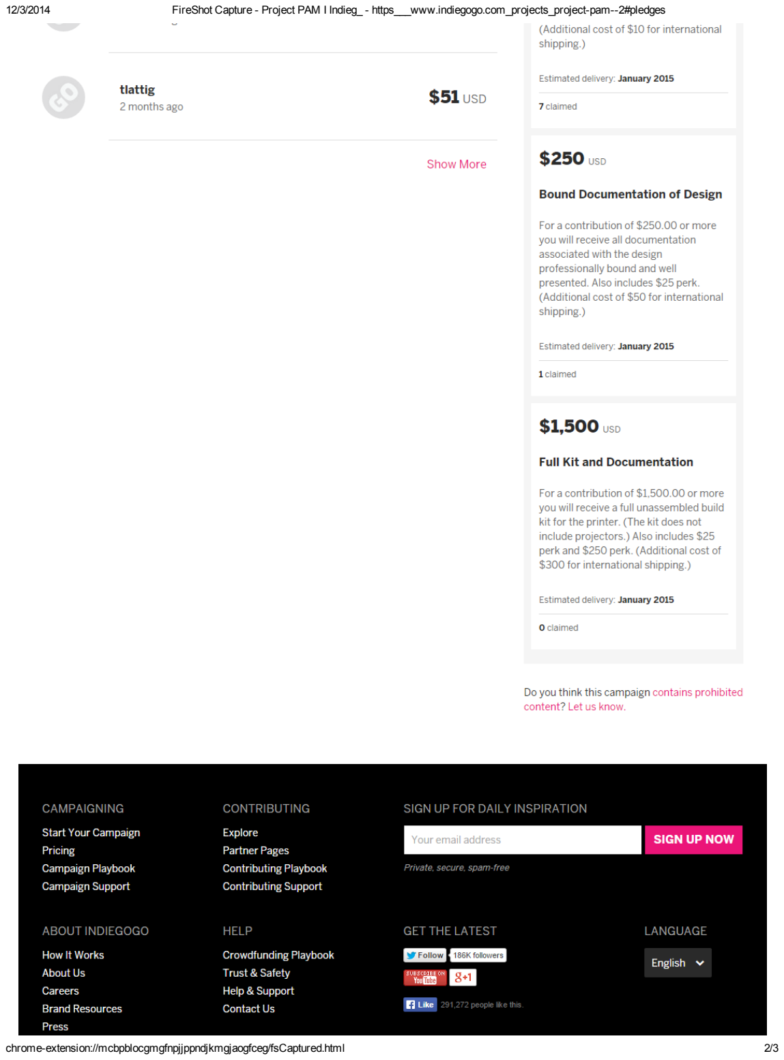
[picture p69: page 2]

chromeextension://mcbpblocgmgfnpjjppndjkmgjaogfceg/fsCaptured.html | 2/3

chromeextension://mcbpblocgmgfnpjjppndjkmgjaogfceg/fsCaptured.html | 3/3
