dan-olsen/SeniorDesign/DesignReport/Appendix/Website Screenshots/Project PAM_Twitter.pdf

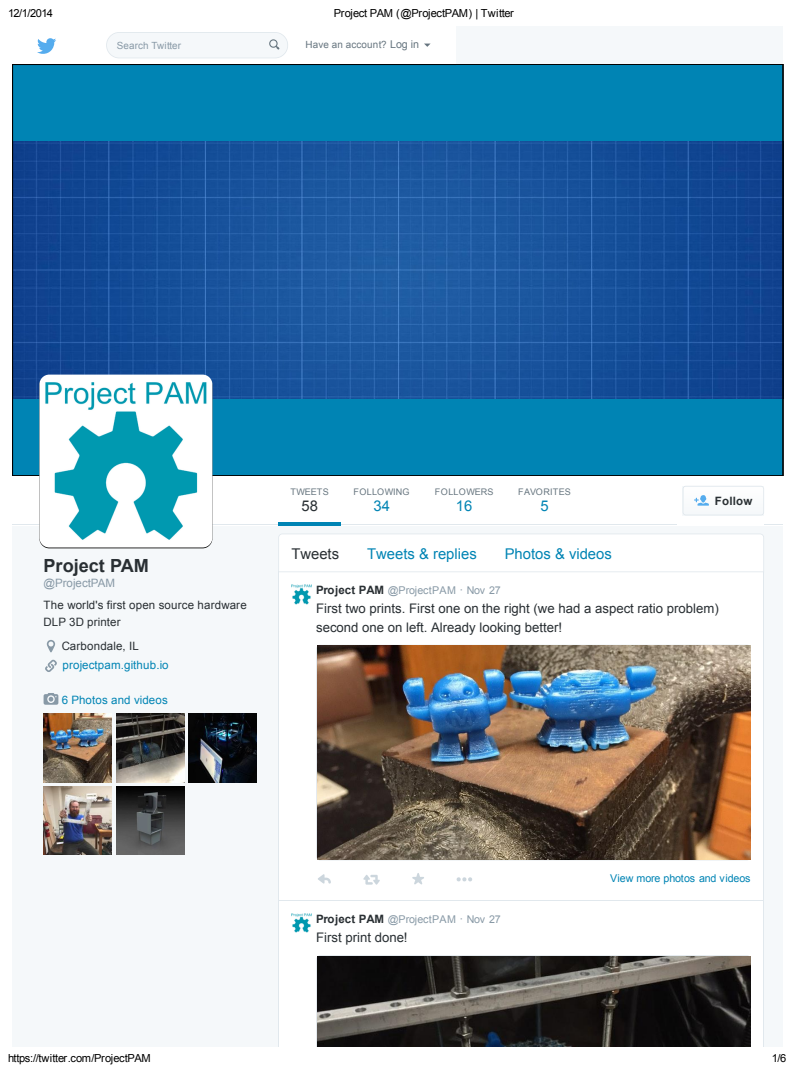
[picture p72: page 1]
Project PAM (@ProjectPAM) | Twitter; https://twitter.com/ProjectPAM; View more photos and videos; Tweets; Tweets & replies; Photos & videos; TWEETS 58; FOLLOWING 34; FOLLOWERS 16; FAVORITES; Follow; Search Twitter; Have an account? Log in

Project PAM
@ProjectPAM (https://twitter.com/ProjectPAM)
The world's first open source hardware
DLP 3D printer
Carbondale, IL
projectpam.github.io (http://t.co/AeYQes1WM2)

Project PAM @ProjectPAM · Nov 27 (https://twitter.com/ProjectPAM/status/538023660268044288)
First two prints. First one on the right (we had a aspect ratio problem)
second one on left. Already looking better!

6 Photos and videos (https://twitter.com/ProjectPAM/media)

Project PAM @ProjectPAM · Nov 27 (https://twitter.com/ProjectPAM/status/538023261888872448)
First print done!

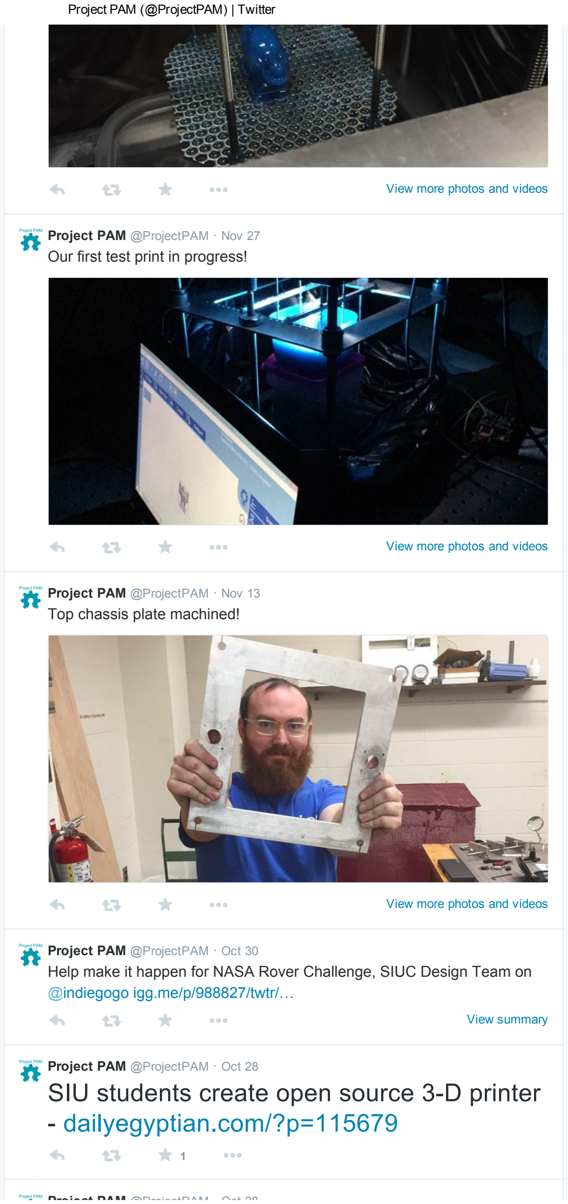
[picture p73: figure]
View more photos and videos; Project PAM @ProjectPAM · Nov 27 Our first test print in progress!; Project PAM @ProjectPAM · Nov 13 Top chassis plate machined!; Project PAM @ProjectPAM · Oct 30; @indiegogo igg.me/p/988827/twtr/…; View summary; Project PAM @ProjectPAM · Oct 28; dailyegyptian.com/?p=115679

### Help make it happen for NASA Rover Challenge, SIUC Design Team on

# SIU students create open source 3-D printer

Project PAM @ProjectPAM · Oct 28 (https://twitter.com/ProjectPAM/status/527144628160434177)
There's less than 12 hours left for Project PAM on (http://t.co/3obojpMzAV) @indiegogo (https://twitter.com/Indiegogo)

### igg.me/p/952142/twtr/… (http://t.co/3obojpMzAV)

- | View summary (https://twitter.com/ProjectPAM/status/527144628160434177)

Project PAM @ProjectPAM · Oct 26 (https://twitter.com/ProjectPAM/status/526552013601906689)

# Cool Crowdfunding: October 26, 2014: wp.me/p22K2I-1ToP via (http://t.co/0CEgzJmwCS) @make (https://twitter.com/make)

- 1 | | View summary (https://twitter.com/ProjectPAM/status/526552013601906689)

ISTCoalition @ISTCoalition · Oct 16 (https://twitter.com/ISTCoalition/status/522885080201850880)

Project PAM (https://twitter.com/ProjectPAM) retweeted

Engineering students at @SIUC (https://twitter.com/SIUC) use crowdfunding for #3Dprinter (https://twitter.com/hashtag/3Dprinter?src=hash) cc: @ProjectPam (https://twitter.com/ProjectPAM) via @WSIURadio (https://twitter.com/WSIURadio) ow.ly/CSIOa (http://t.co/I4ikcDjHZR)

- 1 | 1 |

Project PAM @ProjectPAM · Oct 8 (https://twitter.com/ProjectPAM/status/519937326961922048)

# Hey @MattStultz. (https://twitter.com/MattStultz) Help make it happen for Project PAM The World's First Open

Source DLP 3D Printer on (http://t.co/xSLiOMwNBr) @indiegogo (https://twitter.com/Indiegogo)

# igg.me/p/952142/twtr/… (http://t.co/xSLiOMwNBr)

- 1 | | View summary (https://twitter.com/ProjectPAM/status/519937326961922048)

Crowd Funding @fundmycampaign · Oct 7 (https://twitter.com/fundmycampaign/status/519502585087029248)

Project PAM (https://twitter.com/ProjectPAM) retweeted

Help make it happen for Project PAM on (http://t.co/CufcC81JMO) @indiegogo (https://twitter.com/Indiegogo)

### igg.me/p/952142/twtr/… (http://t.co/CufcC81JMO)

- 1 | 1 | | View summary (https://twitter.com/fundmycampaign/status/519502585087029248)

3D Print .com @3DPrintBoard · Oct 2 (https://twitter.com/3DPrintBoard/status/517673092496510976)

Project PAM (https://twitter.com/ProjectPAM) retweeted

### Project PAM College Students Look to Create an Entirely Open Source DLP 3D Printer 3dprint.com/17504/project… (http://t.co/QKmS4qbATS)

- 3 | 3 | | View more photos and videos (https://twitter.com/3DPrintBoard/media)

3D Printing Industry @3dprintindustry · Oct 2 (https://twitter.com/3dprintindustry/status/517889343625904129)

Project PAM (https://twitter.com/ProjectPAM) retweeted

### Engineering students want to crowd fund their fully open sourced DLP

#3Dprinterhttp://bit.ly/1vbnks9 via @3dprintindustry (https://twitter.com/3dprintindustry) @ProjectPAM (https://twitter.com/ProjectPAM)

- 3 | 1 |

MakerJuice @MakerJuice · Oct 1 (https://twitter.com/MakerJuice/status/517487053894742016)

Project PAM (https://twitter.com/ProjectPAM) retweeted

### Check out Project PAM, an open source DLP printer by students at

Southern Illinois University Carbondale: indiegogo.com/projects/proje… (https://t.co/8PuTK3lW6p)

- 1 | 2 | | View summary (https://twitter.com/MakerJuice/status/517487053894742016)

Semi-Utilitronic @SemiU_co_uk · Oct 3 (https://twitter.com/SemiU_co_uk/status/518022356426452992)

Project PAM (https://twitter.com/ProjectPAM) retweeted

### Awesome largebuildvolume OSHW DLP printer Help make it happen

for Project PAM igg.me/p/projectpam… (http://t.co/mqcScyfzeF) #indiegogo (https://twitter.com/hashtag/indiegogo?src=hash) via @indiegogo (https://twitter.com/Indiegogo)

- 1 | 1 | | View summary (https://twitter.com/SemiU_co_uk/status/518022356426452992)

Project PAM @ProjectPAM · Oct 2 (https://twitter.com/ProjectPAM/status/517777486180913152)

### Project PAM – College Students Look to Create an Entirely Open Source DLP 3D Printer 3dprint.com/17504/project… (http://t.co/GCkAGrHjyF)

Project PAM @ProjectPAM · Oct 2 (https://twitter.com/ProjectPAM/status/517715739776540673)

# Help The Open Sourced DLP 3D Printer called Project Pam on Indiegogo? 3dprintingindustry.com/2014/10/02/hel… (http://t.co/MzmuKy9oMc) via @3dprintindustry (https://twitter.com/3dprintindustry)

- 1

Project PAM @ProjectPAM · Oct 1 (https://twitter.com/ProjectPAM/status/517499692121595905)
Thanks for the shoutout @MakerJuice! (https://twitter.com/MakerJuice) We'll be ordering a lot of resin for

### prints out of that gigantic #9Lvat! (https://twitter.com/hashtag/9Lvat?src=hash)

- | View conversation (https://twitter.com/ProjectPAM/status/517499692121595905)
- Project PAM followed All Tech Considered, (https://twitter.com/npralltech) LulzBot, (https://twitter.com/lulzbot3D) you3Dit (https://twitter.com/you3Dit) and 11 others (https://twitter.com/ProjectPAM/following)

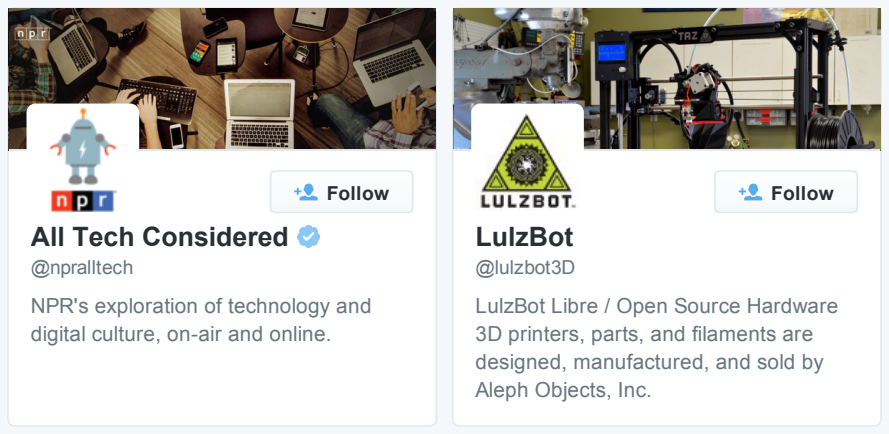
[picture p74: figure]
@npralltech; NPR's exploration of technology and digital culture, onair and online.; Follow; All Tech Considered; LulzBot; @lulzbot3D; LulzBot Libre / Open Source Hardware 3D printers, parts, and filaments are designed, manufactured, and sold by Aleph Objects, Inc.

Project PAM @ProjectPAM · Sep 30 (https://twitter.com/ProjectPAM/status/517037526968565761)
Help fund Project PAM on @indiegogo (https://twitter.com/Indiegogo) igg.me/p/952142/twtr/… (http://t.co/3obojpMzAV)
- | View summary (https://twitter.com/ProjectPAM/status/517037526968565761)

Project PAM @ProjectPAM · Sep 18 (https://twitter.com/ProjectPAM/status/512746123602055170)

# Project PAM Promo youtu.be/zL18pSLKOzU?a (http://t.co/e15sI3PoZe)

YouTube (https://twitter.com/YouTube)

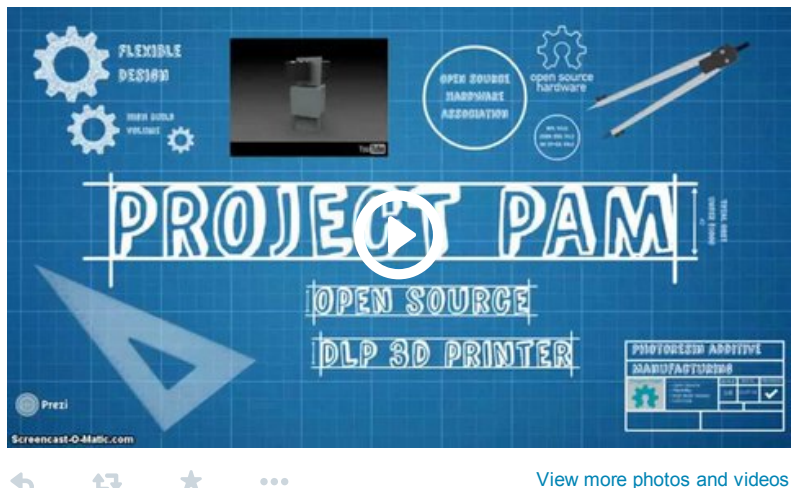
[picture p75: figure]

- | View more photos and videos (https://twitter.com/ProjectPAM/media)

Project PAM @ProjectPAM · Sep 16 (https://twitter.com/ProjectPAM/status/511960376536072192)
The first render of Project PAM.

# youtube.com/watch?v=nInJxA… (https://t.co/M0u0XQQbEe)

YouTube (https://twitter.com/YouTube)

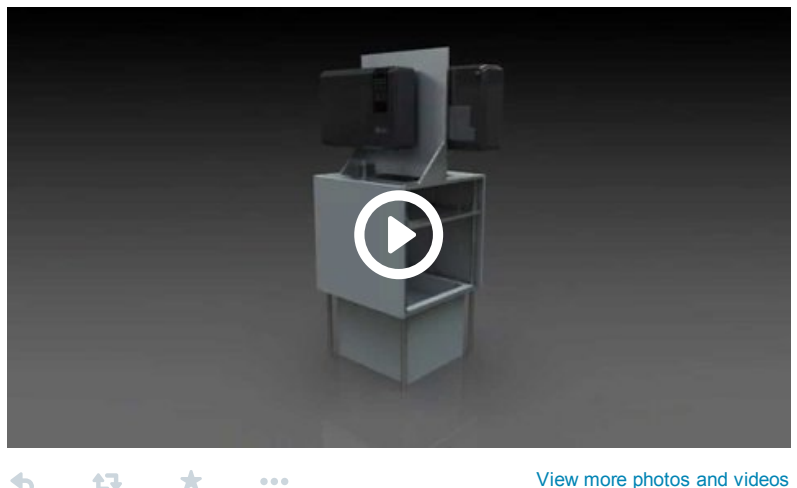
[picture p76: figure]

- | View more photos and videos (https://twitter.com/ProjectPAM/media)
- Project PAM followed Creative Commons, (https://twitter.com/creativecommons) Share A Hack, (https://twitter.com/shareahack) 3D Printing Industry (https://twitter.com/3dprintindustry) and 17 others (https://twitter.com/ProjectPAM/following)

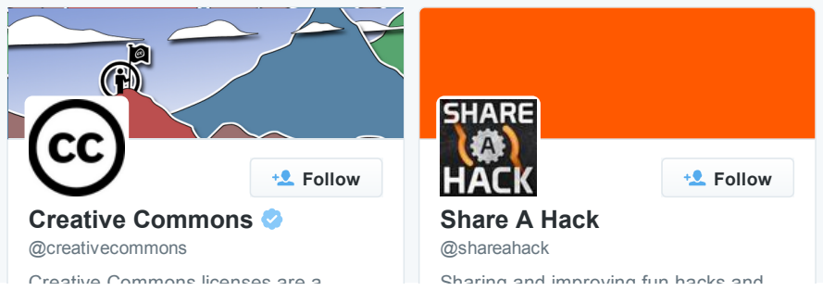
[picture p77: figure]
@creativecommons; Creative Commons licenses are a; Follow; Creative Commons; Share A Hack; @shareahack; Sharing and improving fun hacks and

# Don’t miss any updates from

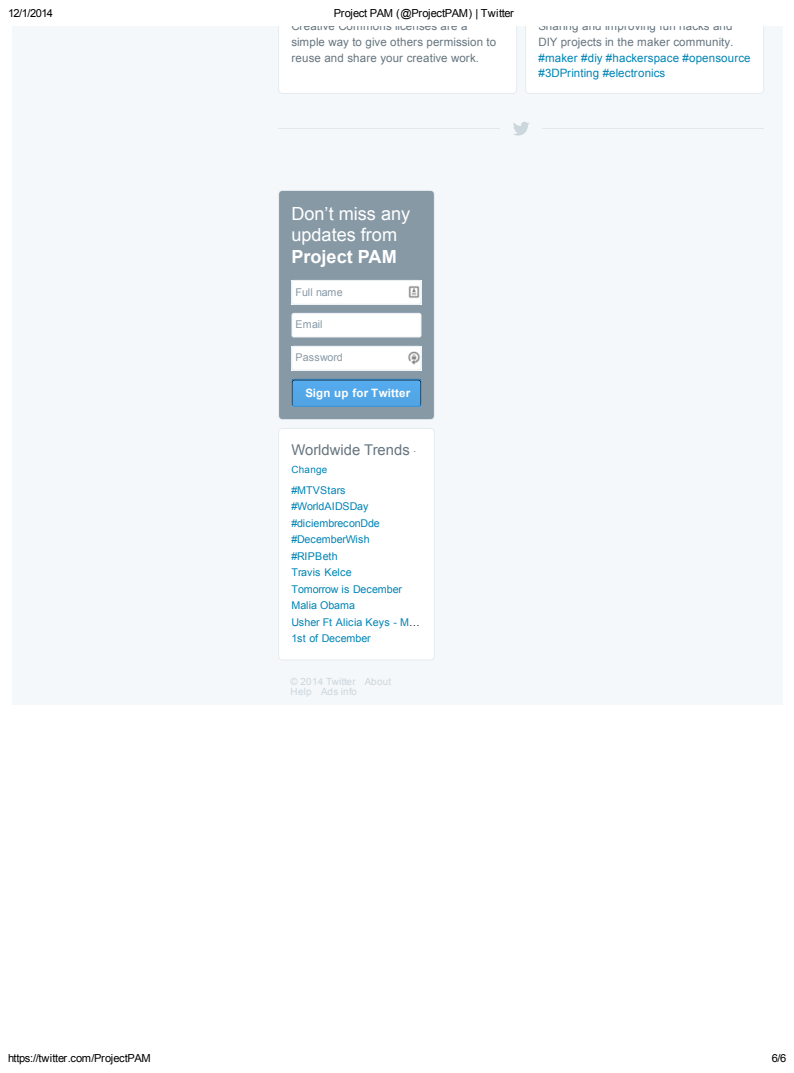
[picture p78: page 6]
Project PAM; Full name; Email; Password; Worldwide Trends ·

Creative Commons licenses are a
simple way to give others permission to
reuse and share your creative work.

Sharing and improving fun hacks and
DIY projects in the maker community.
#maker (https://twitter.com/hashtag/maker?src=hash) #diy (https://twitter.com/hashtag/diy?src=hash) #hackerspace (https://twitter.com/hashtag/hackerspace?src=hash) #opensource (https://twitter.com/hashtag/opensource?src=hash)
#3DPrinting (https://twitter.com/hashtag/3DPrinting?src=hash) #electronics (https://twitter.com/hashtag/electronics?src=hash)

Sign up for Twitter

Change
#MTVStars (https://twitter.com/hashtag/MTVStars?src=tren)
#WorldAIDSDay (https://twitter.com/hashtag/WorldAIDSDay?src=tren)
#diciembreconDde (https://twitter.com/hashtag/diciembreconDde?src=tren)
#DecemberWish (https://twitter.com/hashtag/DecemberWish?src=tren)
#RIPBeth (https://twitter.com/hashtag/RIPBeth?src=tren)
Travis Kelce (https://twitter.com/search?q=%22Travis%20Kelce%22&src=tren)
Tomorrow is December (https://twitter.com/search?q=%22Tomorrow%20is%20December%22&src=tren)
Malia Obama (https://twitter.com/search?q=%22Malia%20Obama%22&src=tren)
Usher Ft Alicia Keys M… (https://twitter.com/search?q=%22Usher%20Ft%20Alicia%20Keys%20-%20My%20Boo%22&src=tren)
1st of December (https://twitter.com/search?q=%221st%20of%20December%22&src=tren)

© 2014 Twitter About (https://twitter.com/about)
Help (https://support.twitter.com/) Ads info (https://support.twitter.com/articles/20170451)
