dan-olsen/SeniorDesign/DesignReport/Appendix/Images/Analytics All Web Site Data My Dashboard 20140901-20141202.png

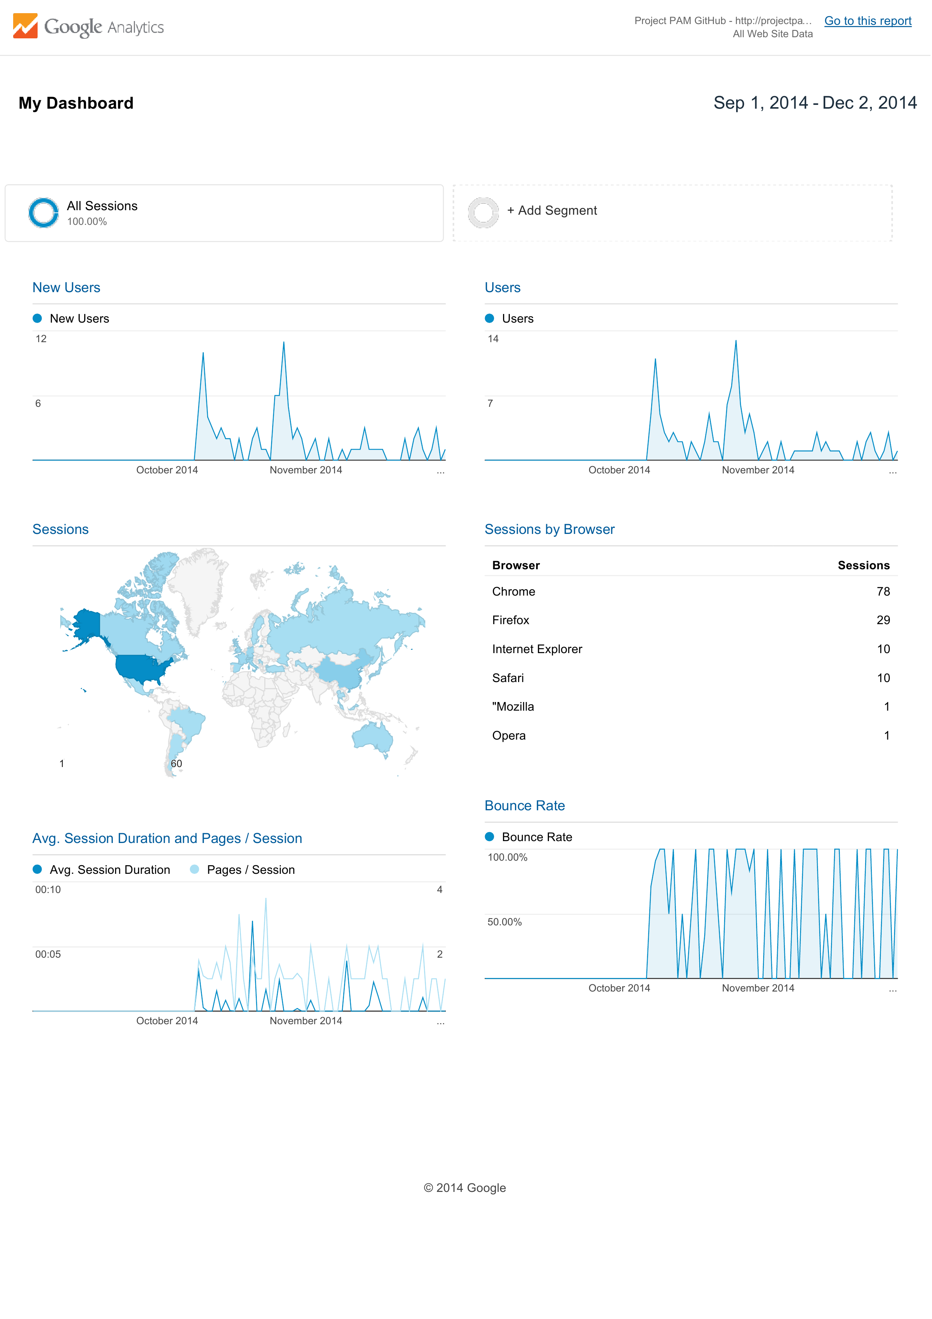
DesignReport/Appendix/Images/Analytics All Web Site Data My Dashboard 20140901-20141202.png
