dan-olsen/SeniorDesign/DesignReport/Appendix/Images/Budget_75_JPB1.png

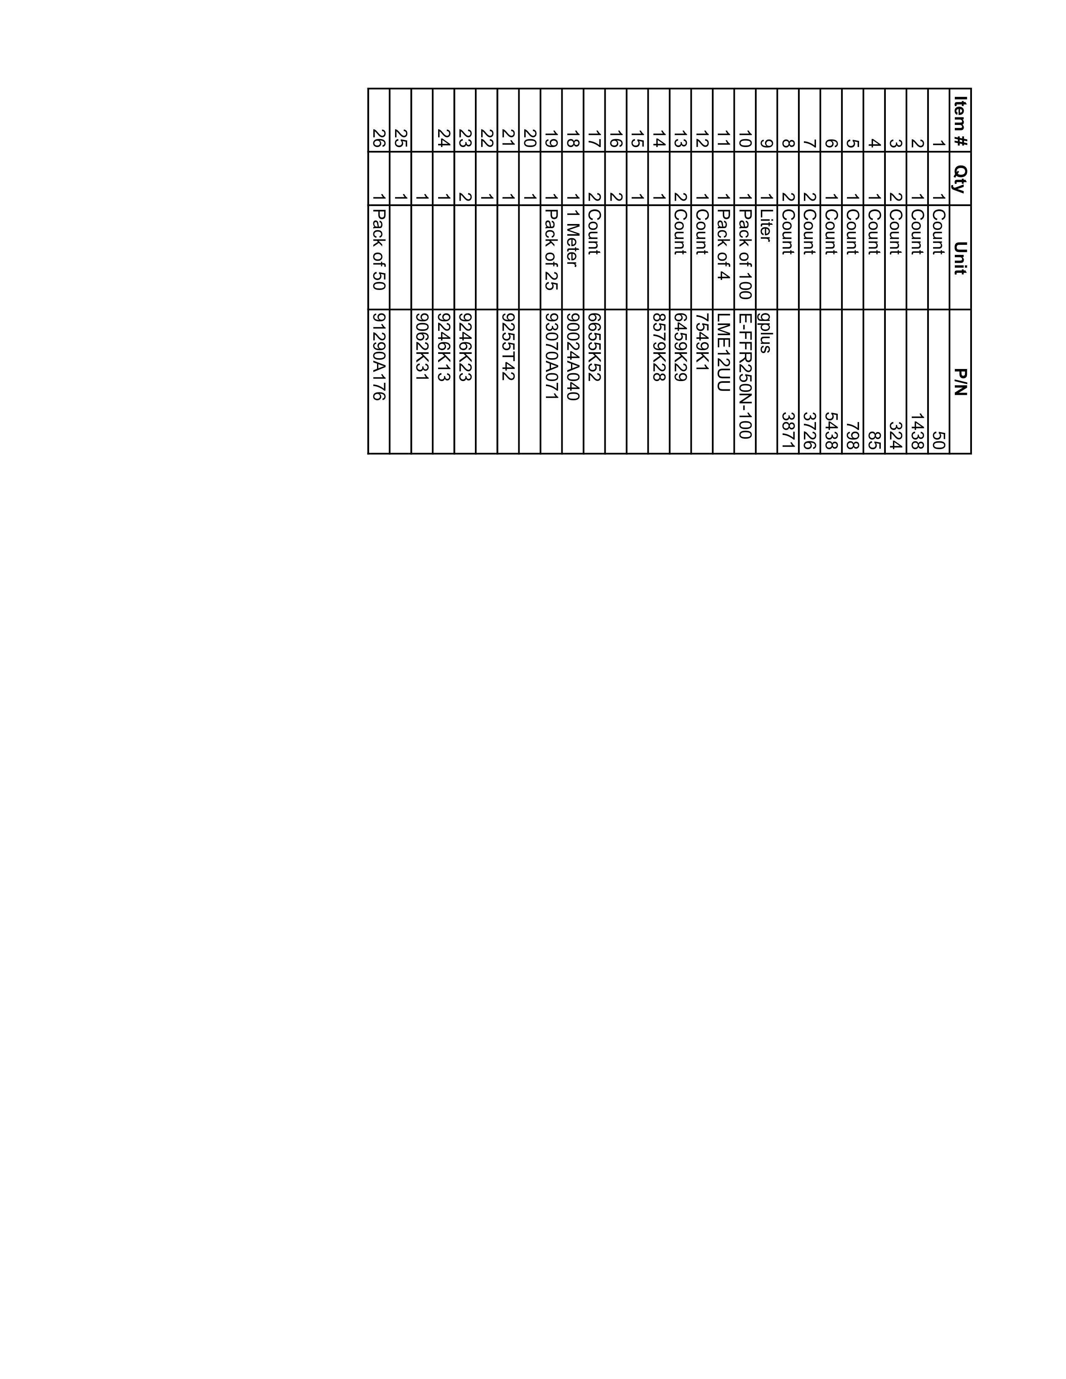
DesignReport/Appendix/Images/Budget_75_JPB1.png
