dan-olsen/SeniorDesign/DesignReport/Appendix/Images/Budget_75_JPB2.png

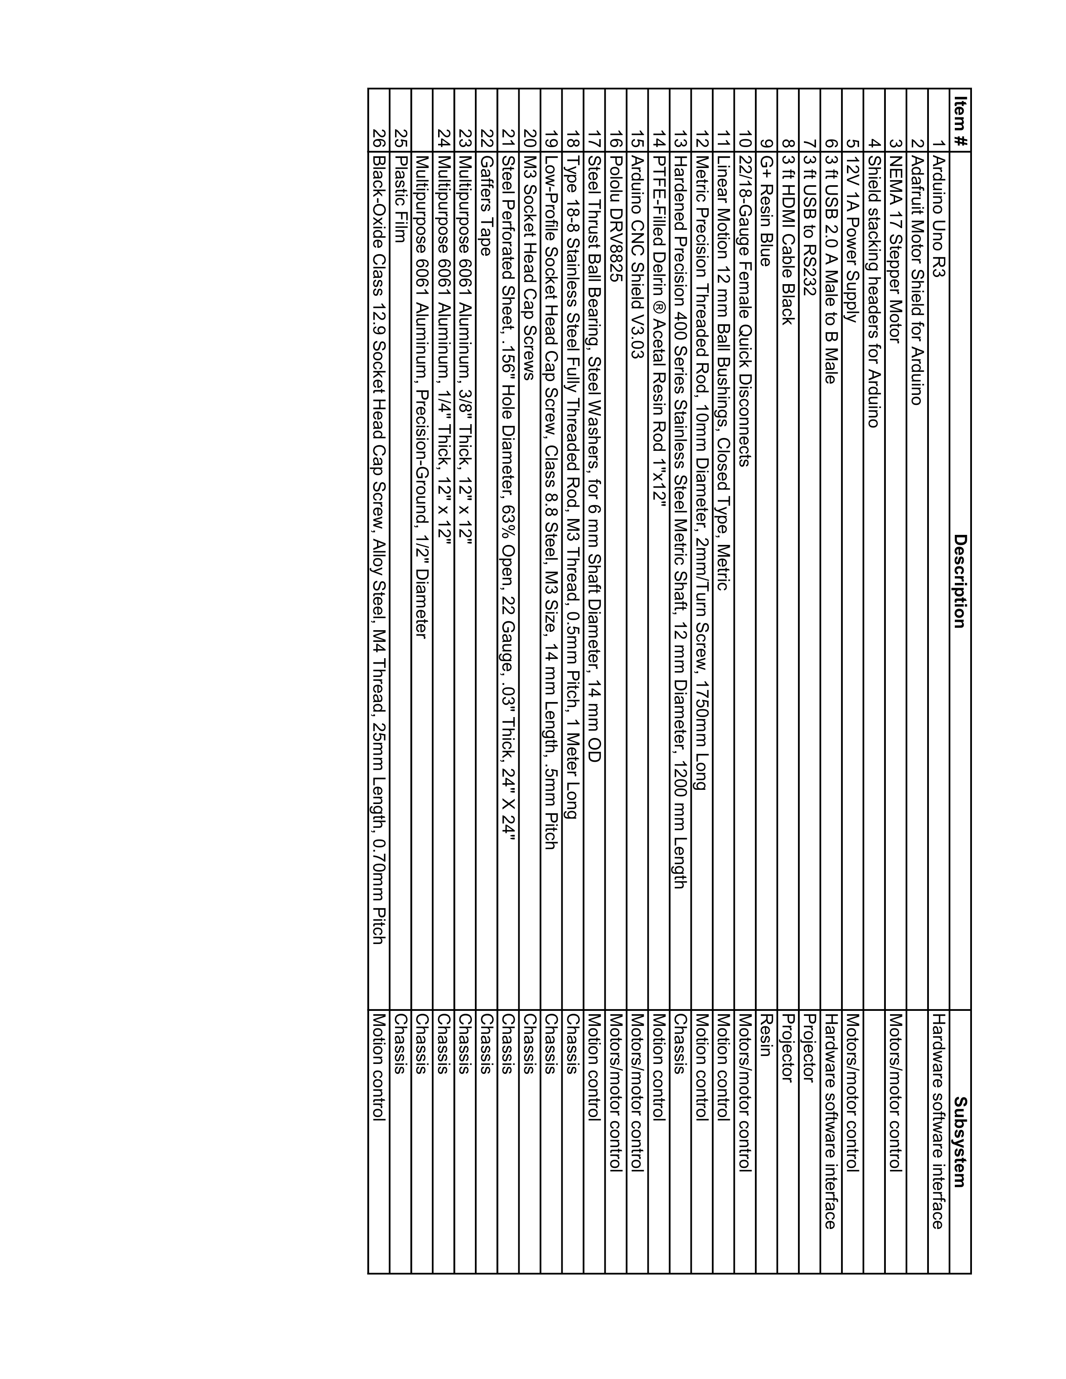
DesignReport/Appendix/Images/Budget_75_JPB2.png
