dan-olsen/SeniorDesign/DesignReport/Appendix/Images/Budget_75_JPB3.png

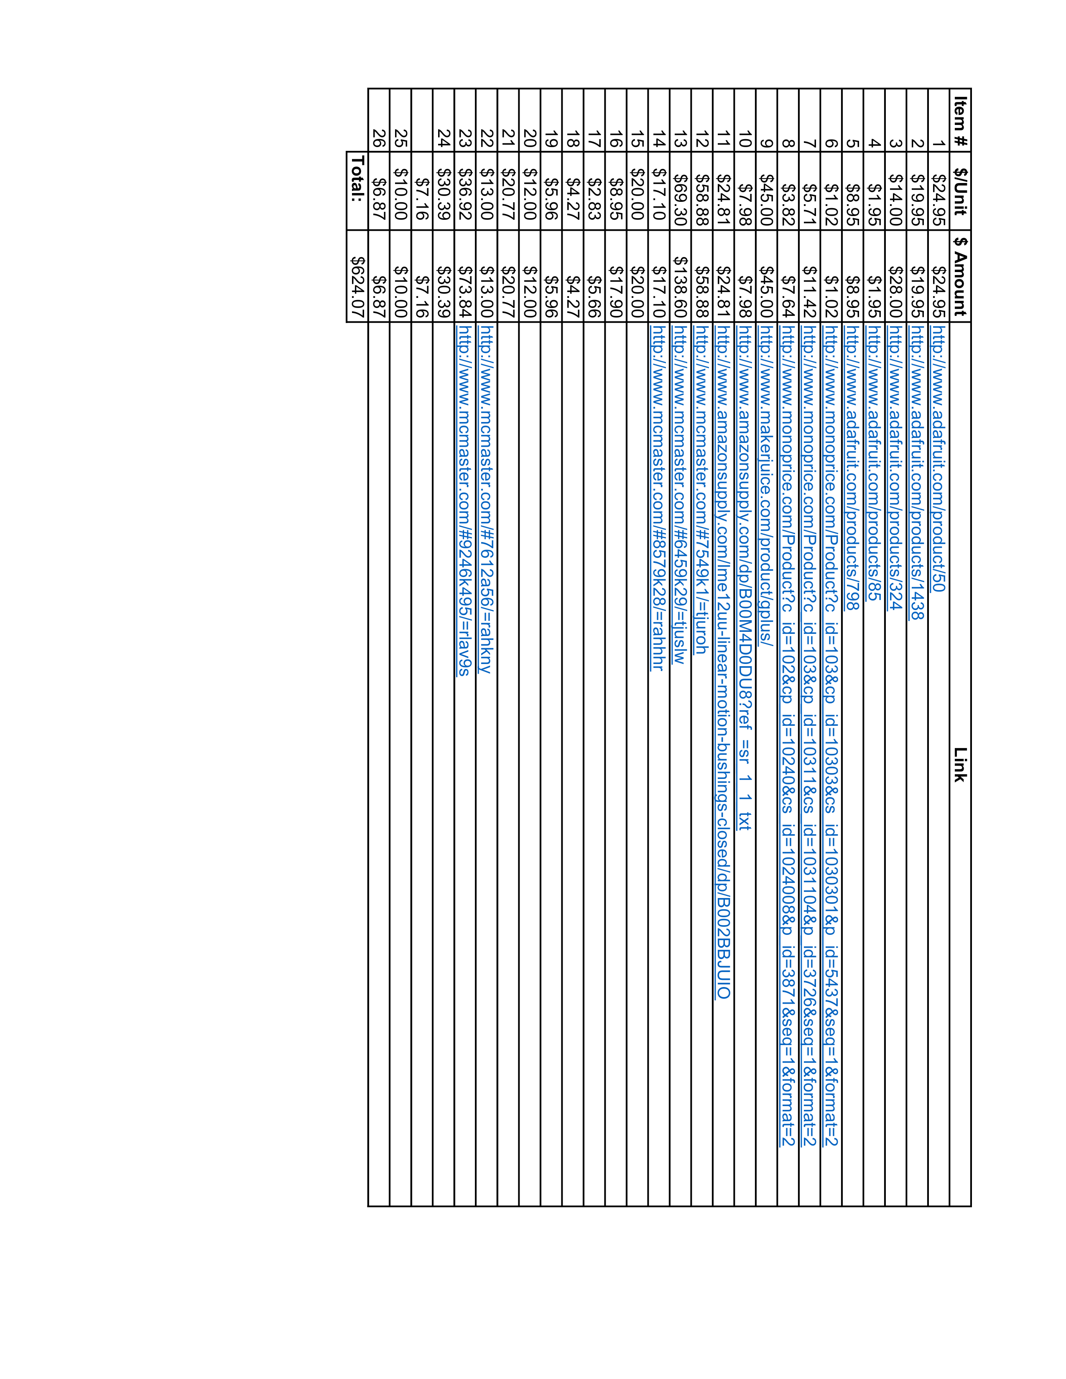
DesignReport/Appendix/Images/Budget_75_JPB3.png
