dan-olsen/SeniorDesign/DesignReport/Appendix/Images/Chassis1.png

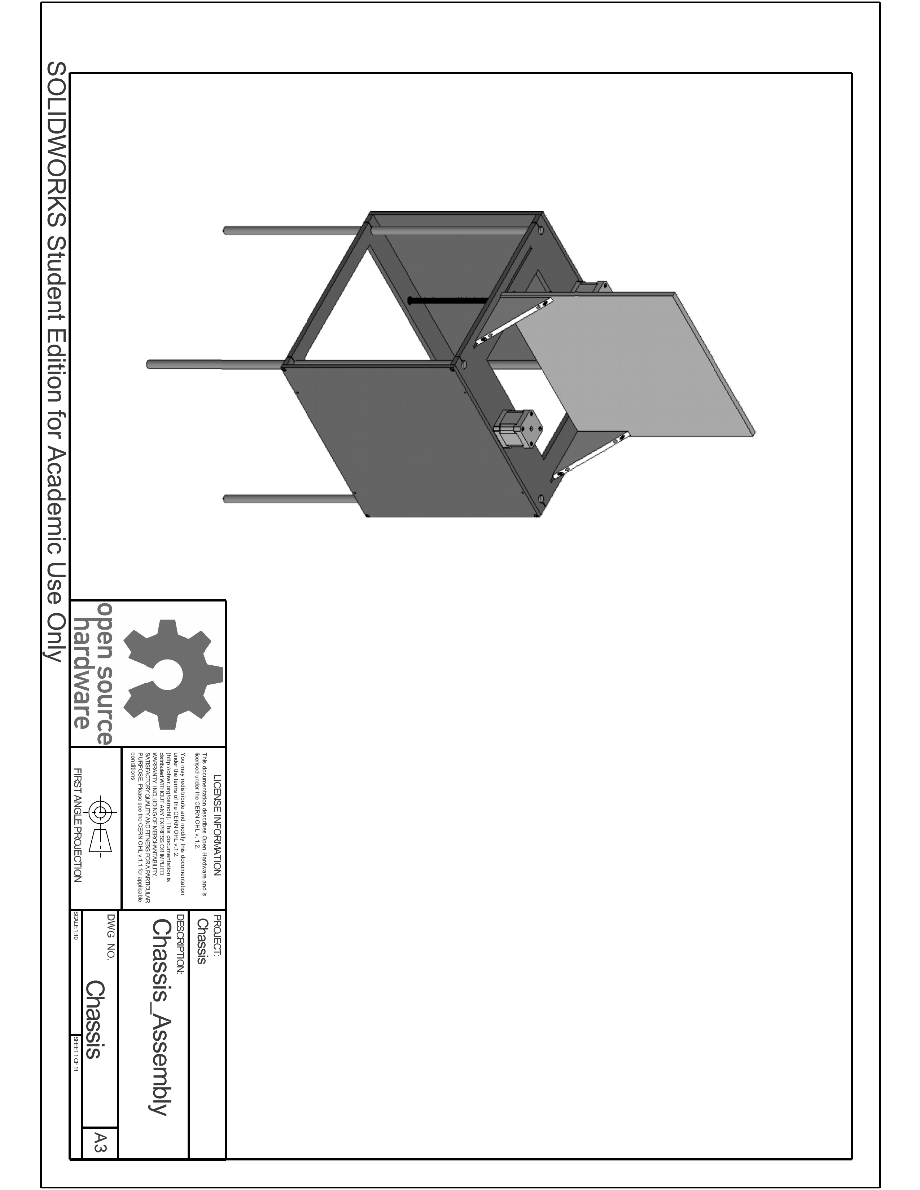
DesignReport/Appendix/Images/Chassis1.png
