dan-olsen/SeniorDesign/DesignReport/Appendix/Images/Chassis2.png

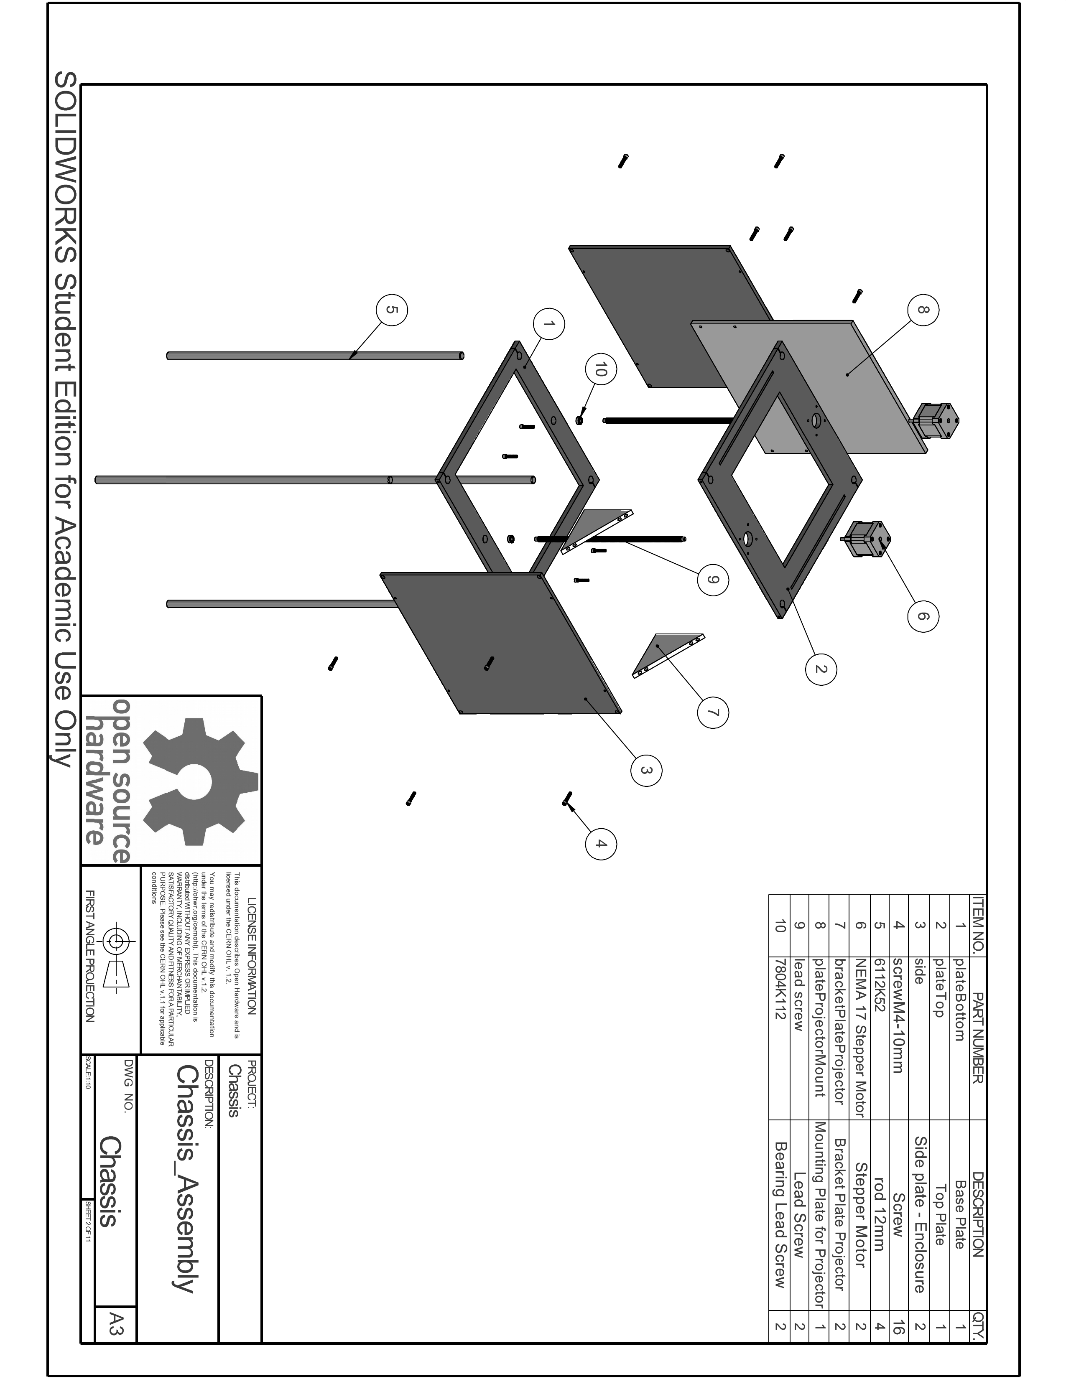
DesignReport/Appendix/Images/Chassis2.png
