dan-olsen/SeniorDesign/DesignReport/Appendix/Images/Chassis3.png

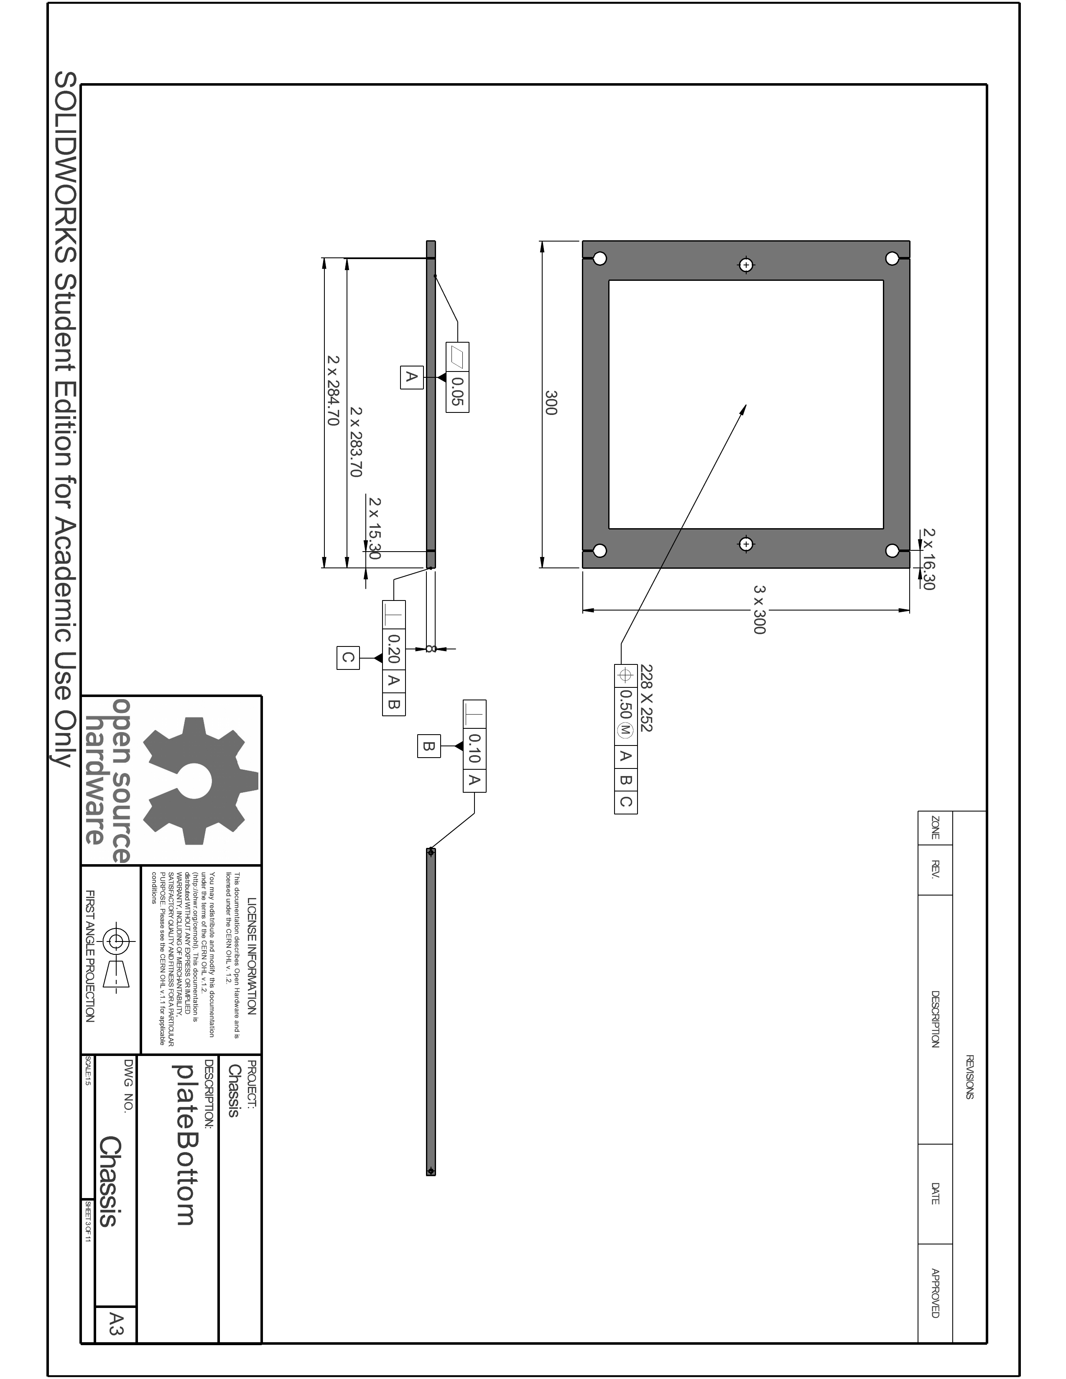
DesignReport/Appendix/Images/Chassis3.png
