dan-olsen/SeniorDesign/DesignReport/Appendix/Images/Chassis4.png

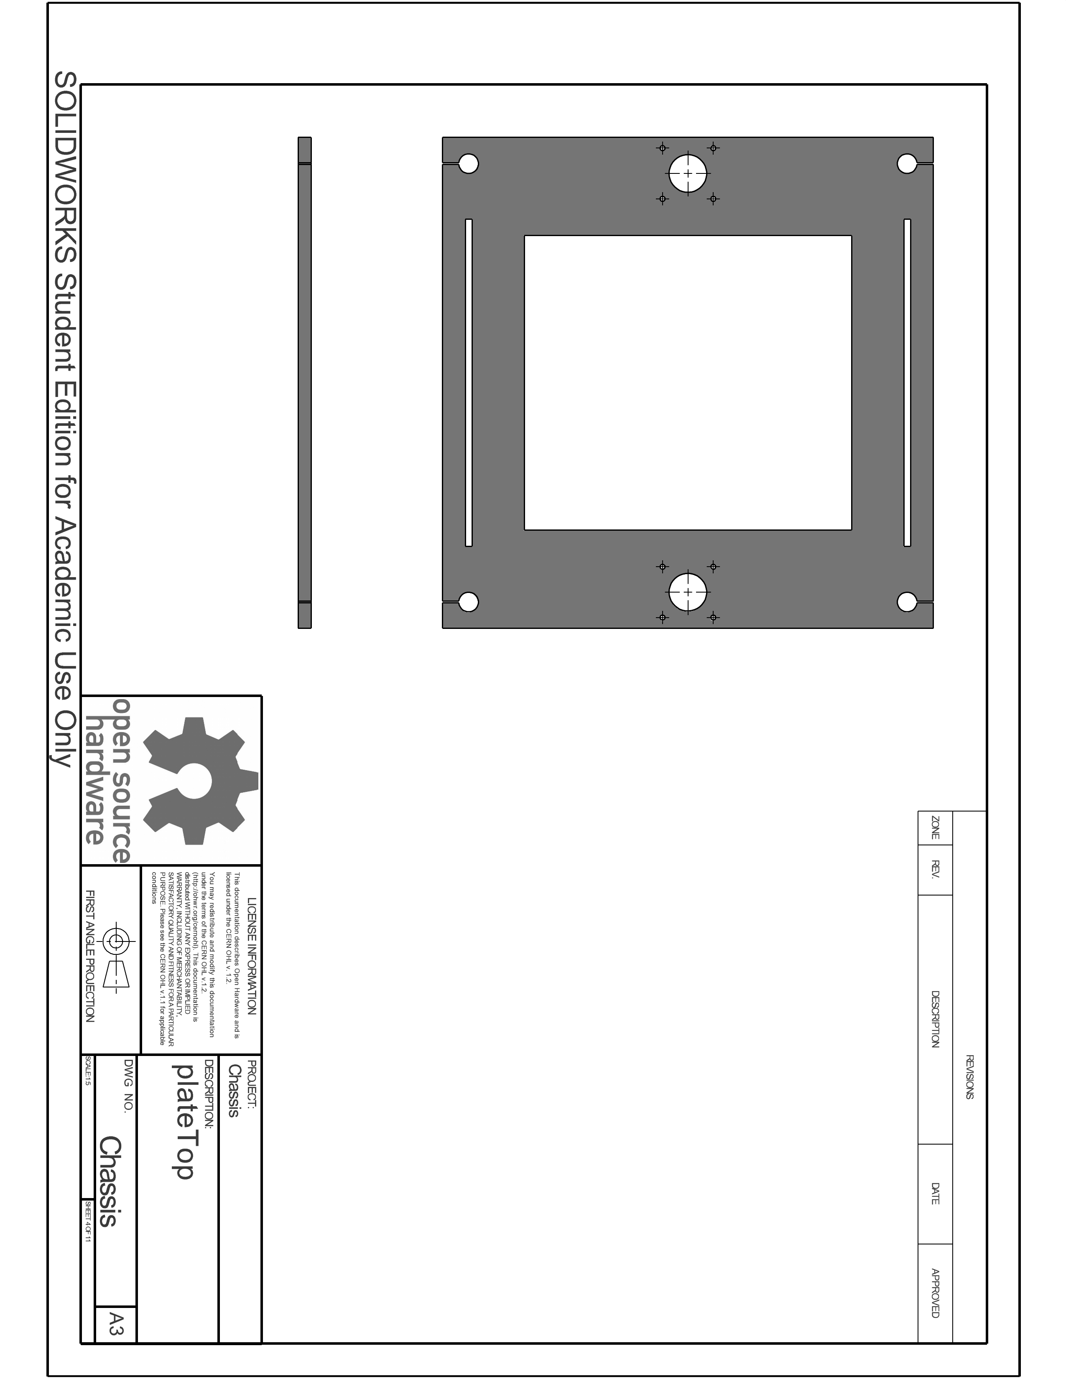
DesignReport/Appendix/Images/Chassis4.png
