dan-olsen/SeniorDesign/DesignReport/Appendix/Images/Chassis5.png

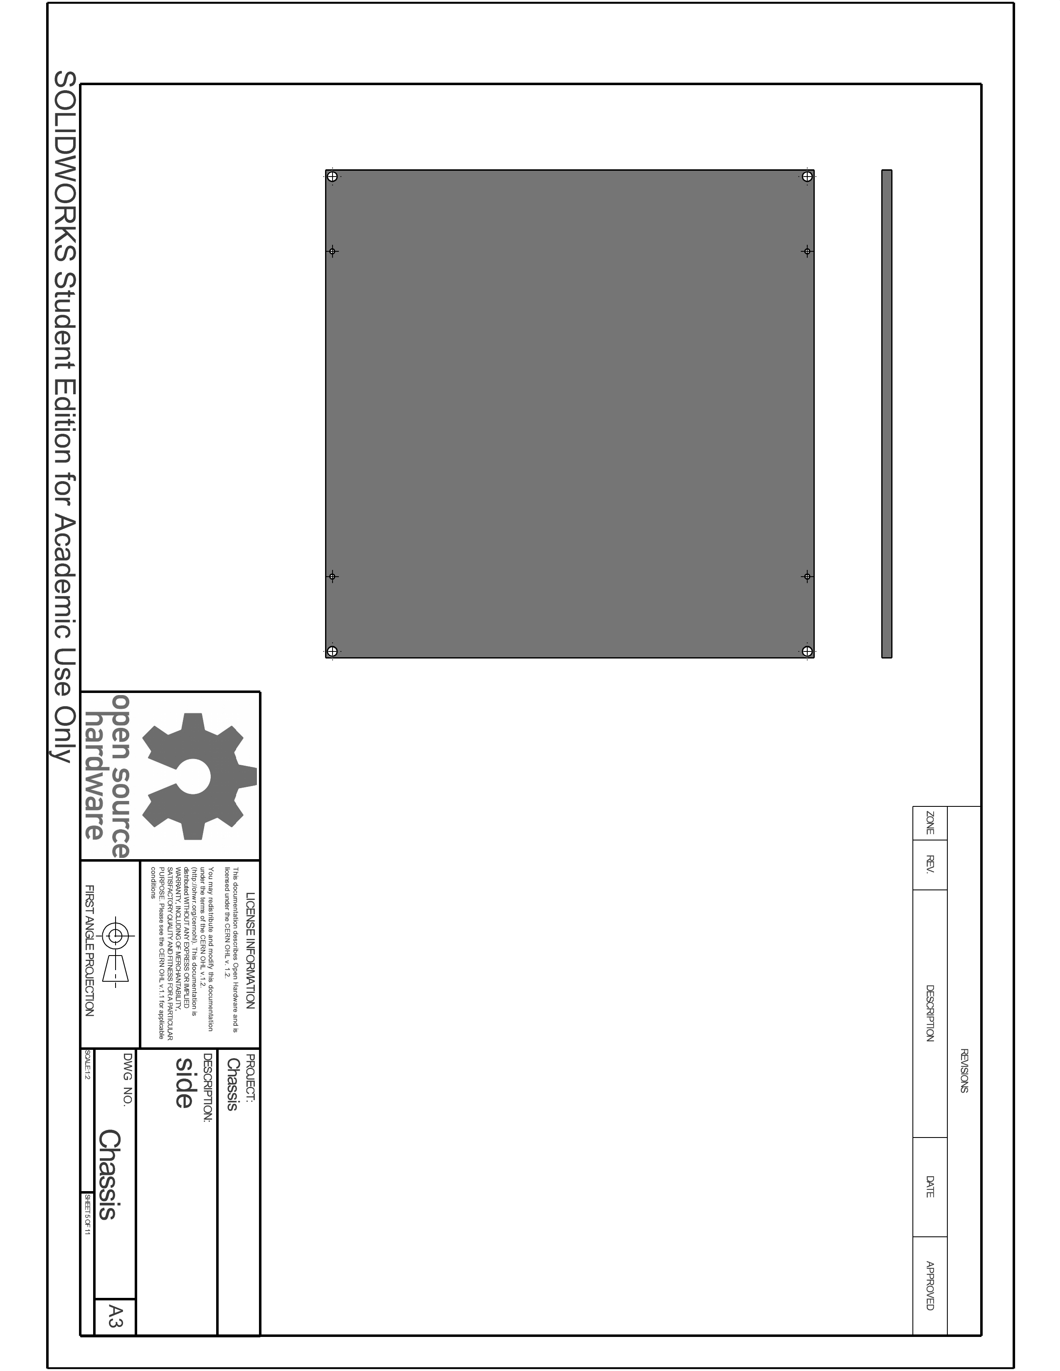
DesignReport/Appendix/Images/Chassis5.png
