dan-olsen/SeniorDesign/DesignReport/Appendix/Images/Chassis6.png

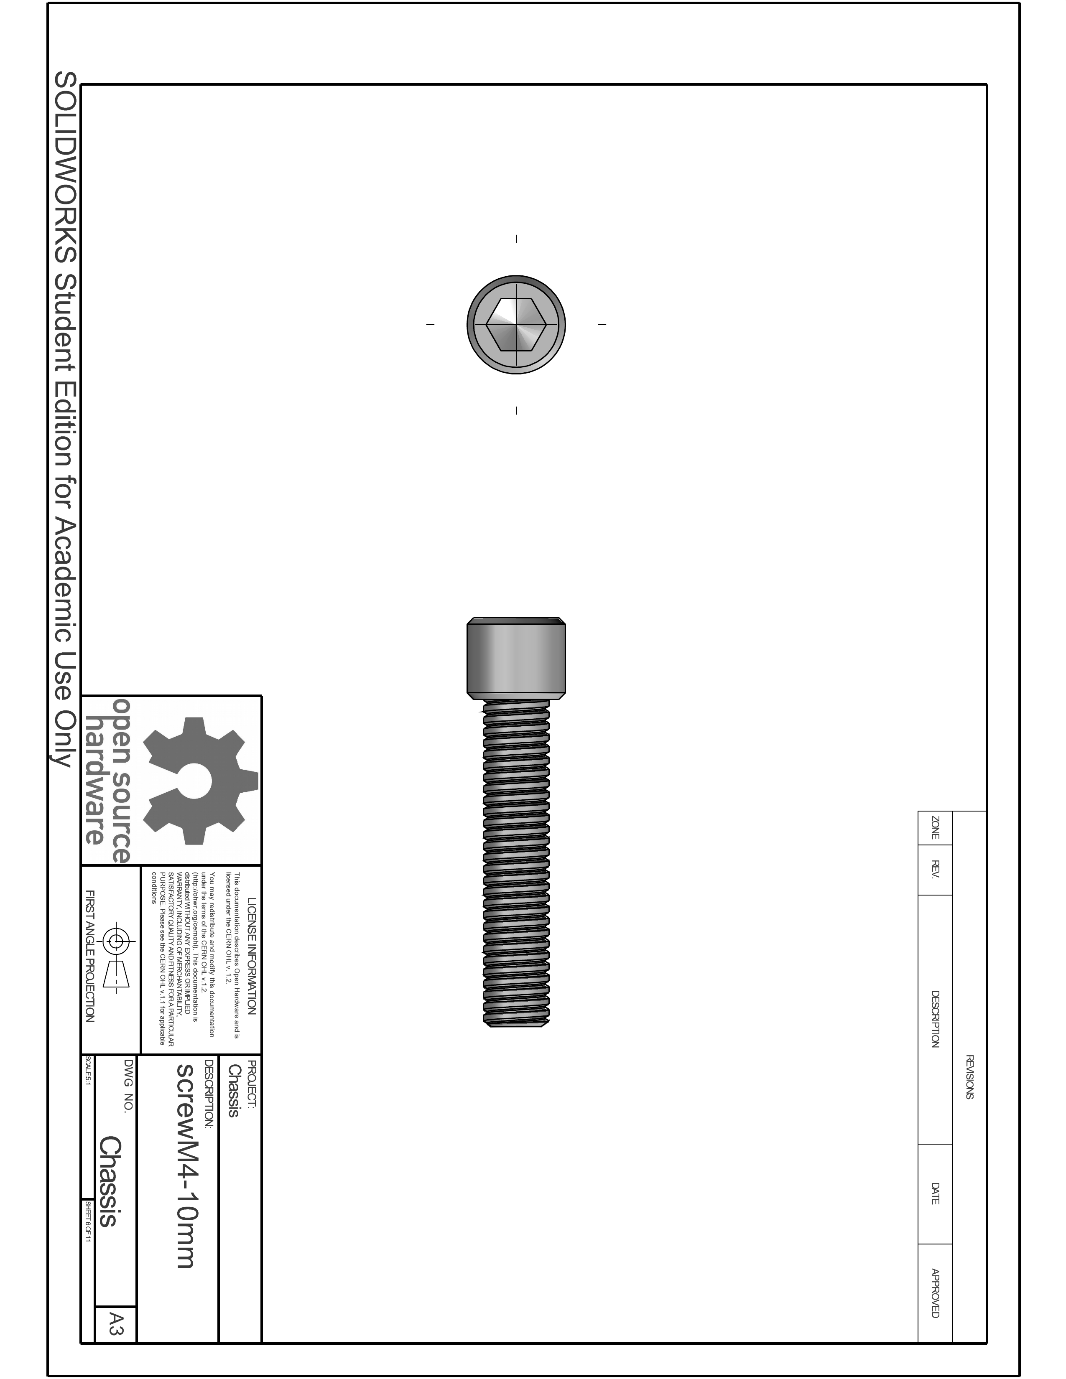
DesignReport/Appendix/Images/Chassis6.png
