dan-olsen/SeniorDesign/DesignReport/Appendix/Images/Chassis7.png

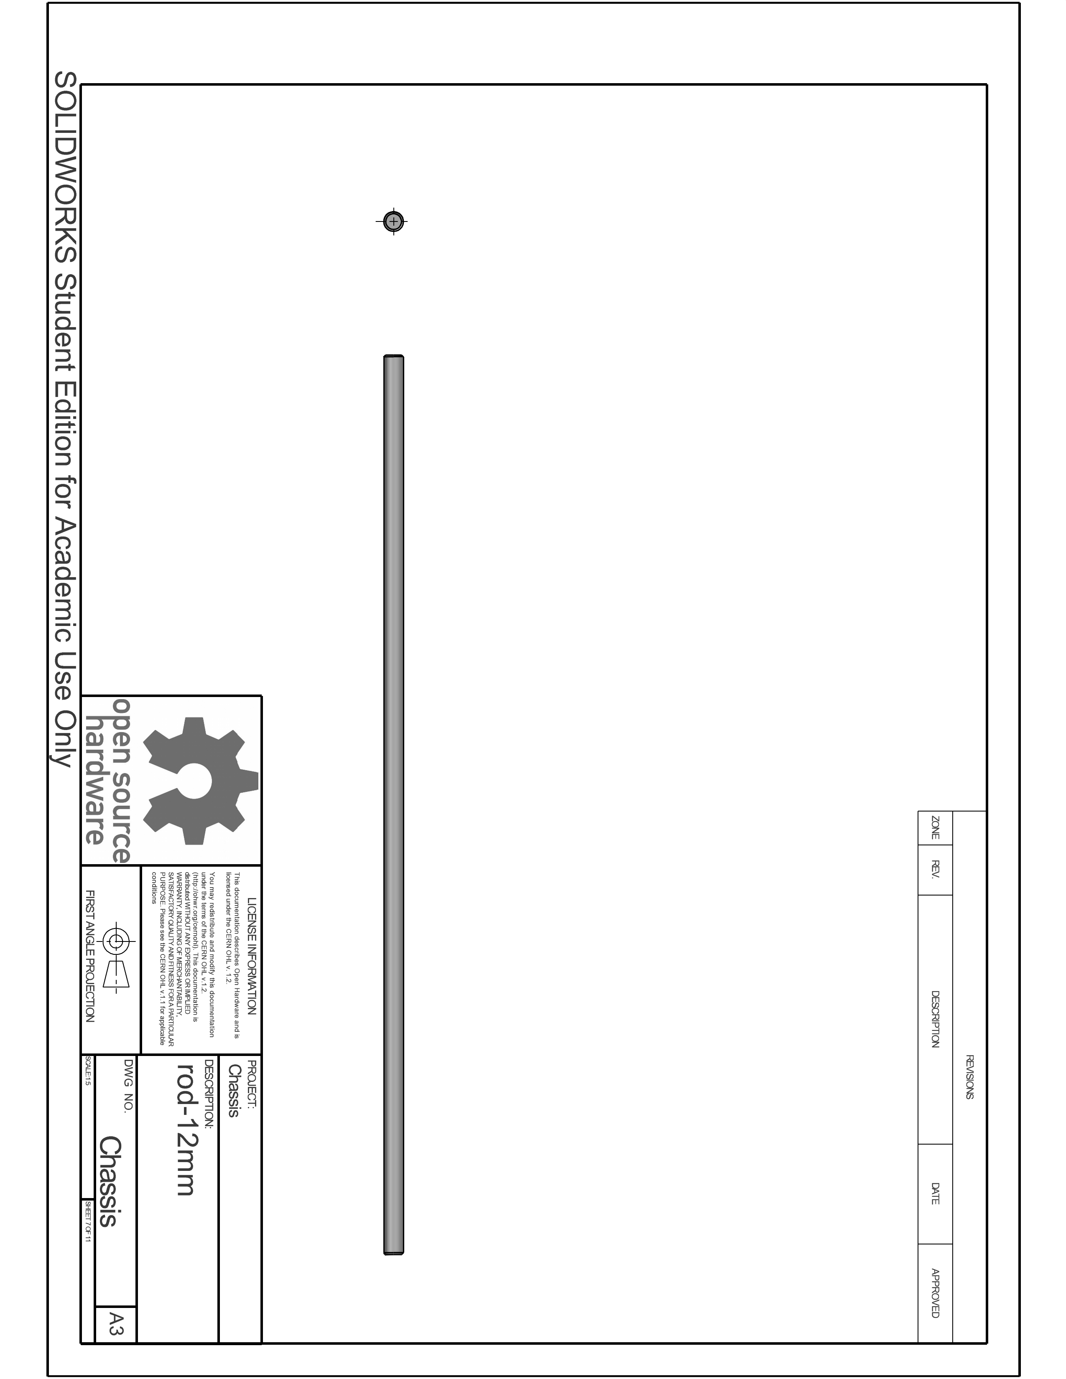
DesignReport/Appendix/Images/Chassis7.png
