dan-olsen/SeniorDesign/DesignReport/Appendix/Images/Chassis8.png

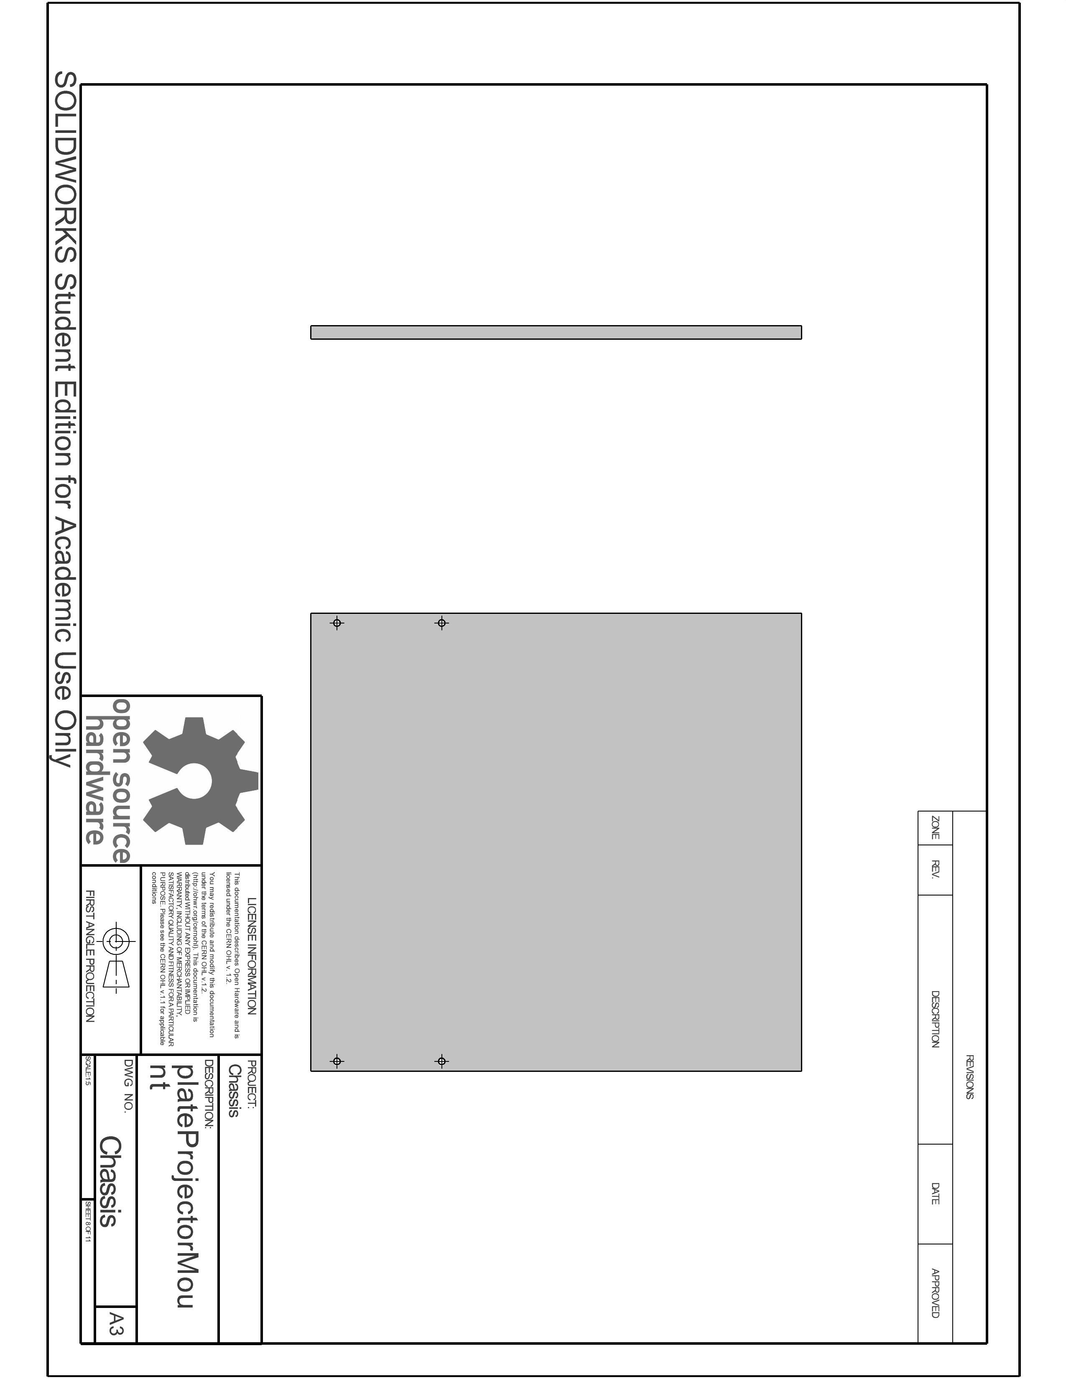
DesignReport/Appendix/Images/Chassis8.png
