dan-olsen/SeniorDesign/DesignReport/Appendix/Images/Chassis9.png

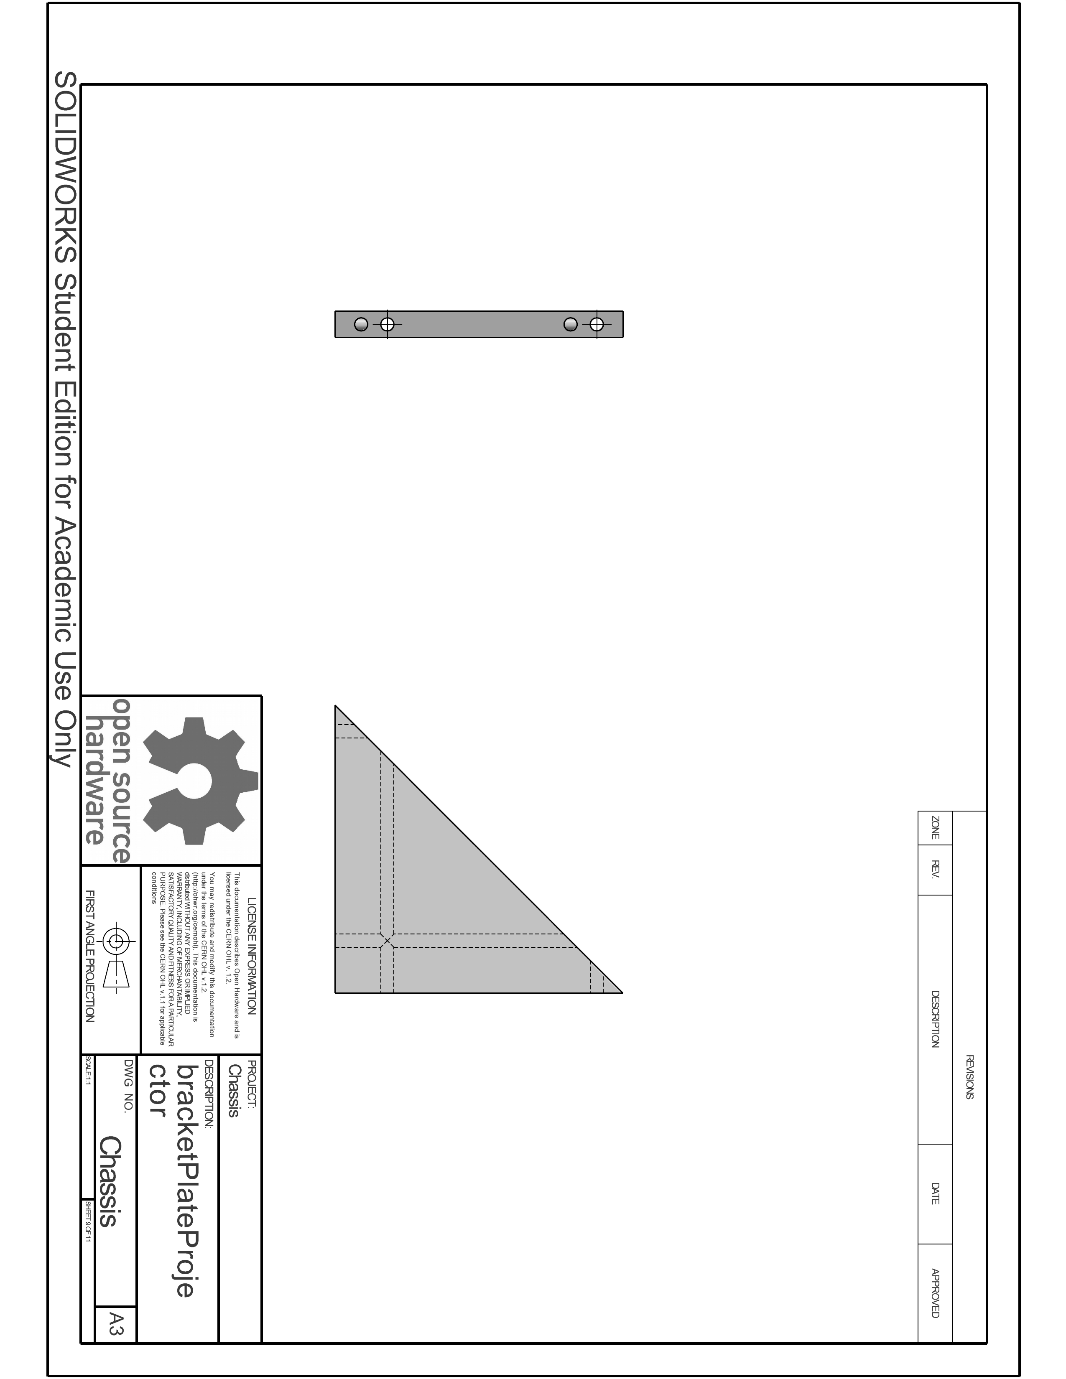
DesignReport/Appendix/Images/Chassis9.png
