dan-olsen/SeniorDesign/DesignReport/Appendix/Images/Chassis11.png

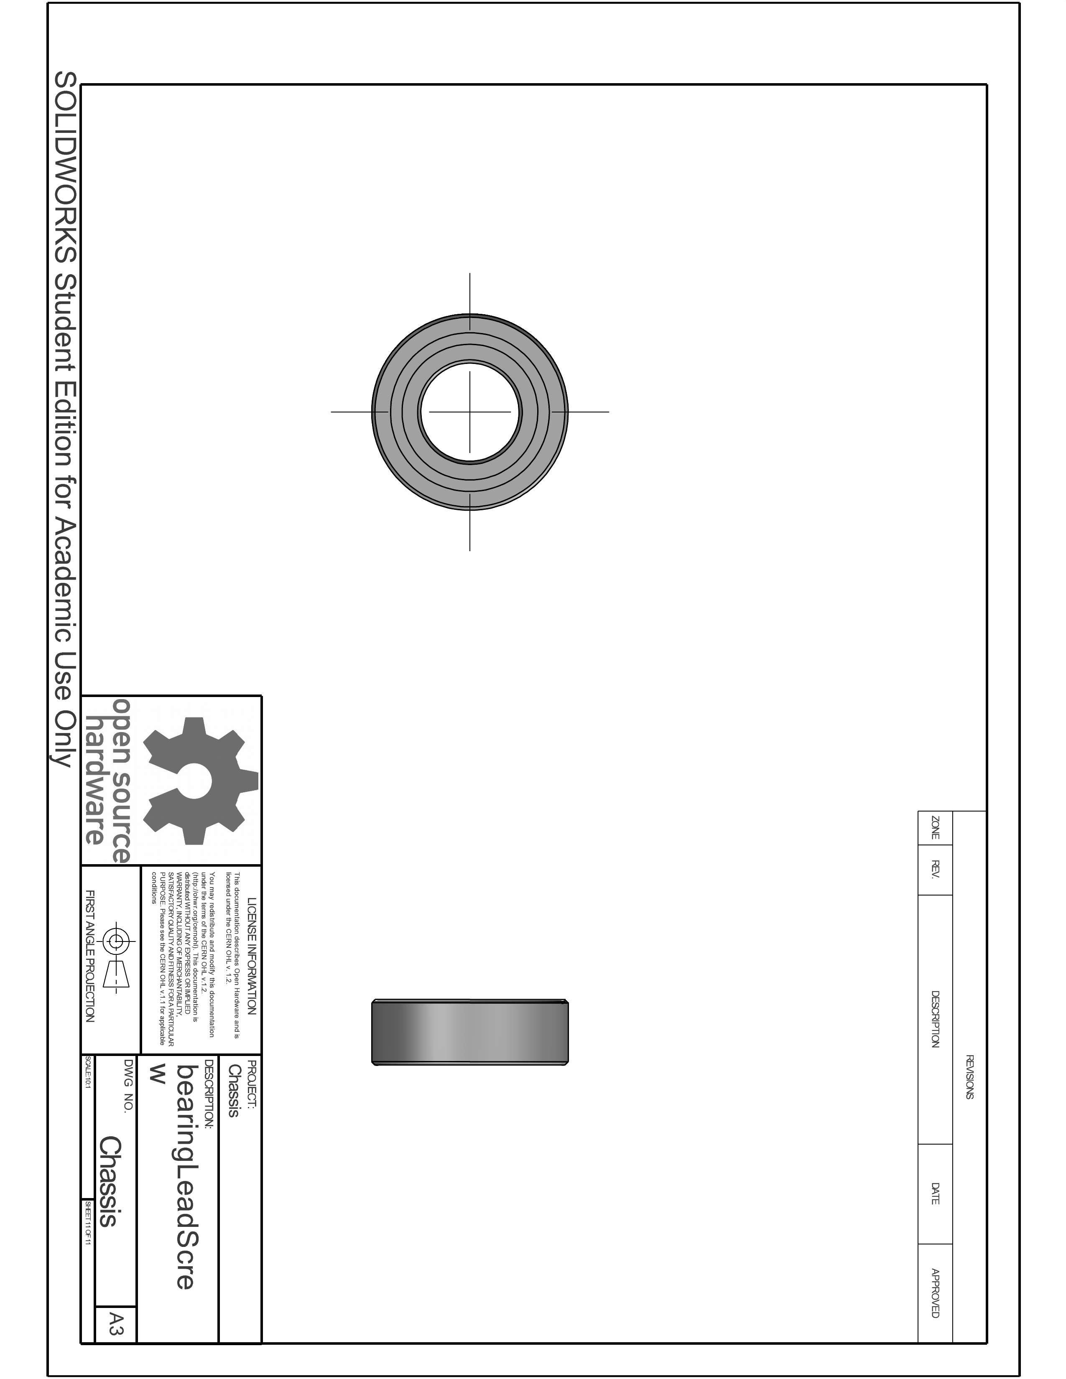
DesignReport/Appendix/Images/Chassis11.png
