dan-olsen/SeniorDesign/DesignReport/Appendix/Images/motionControl1.png

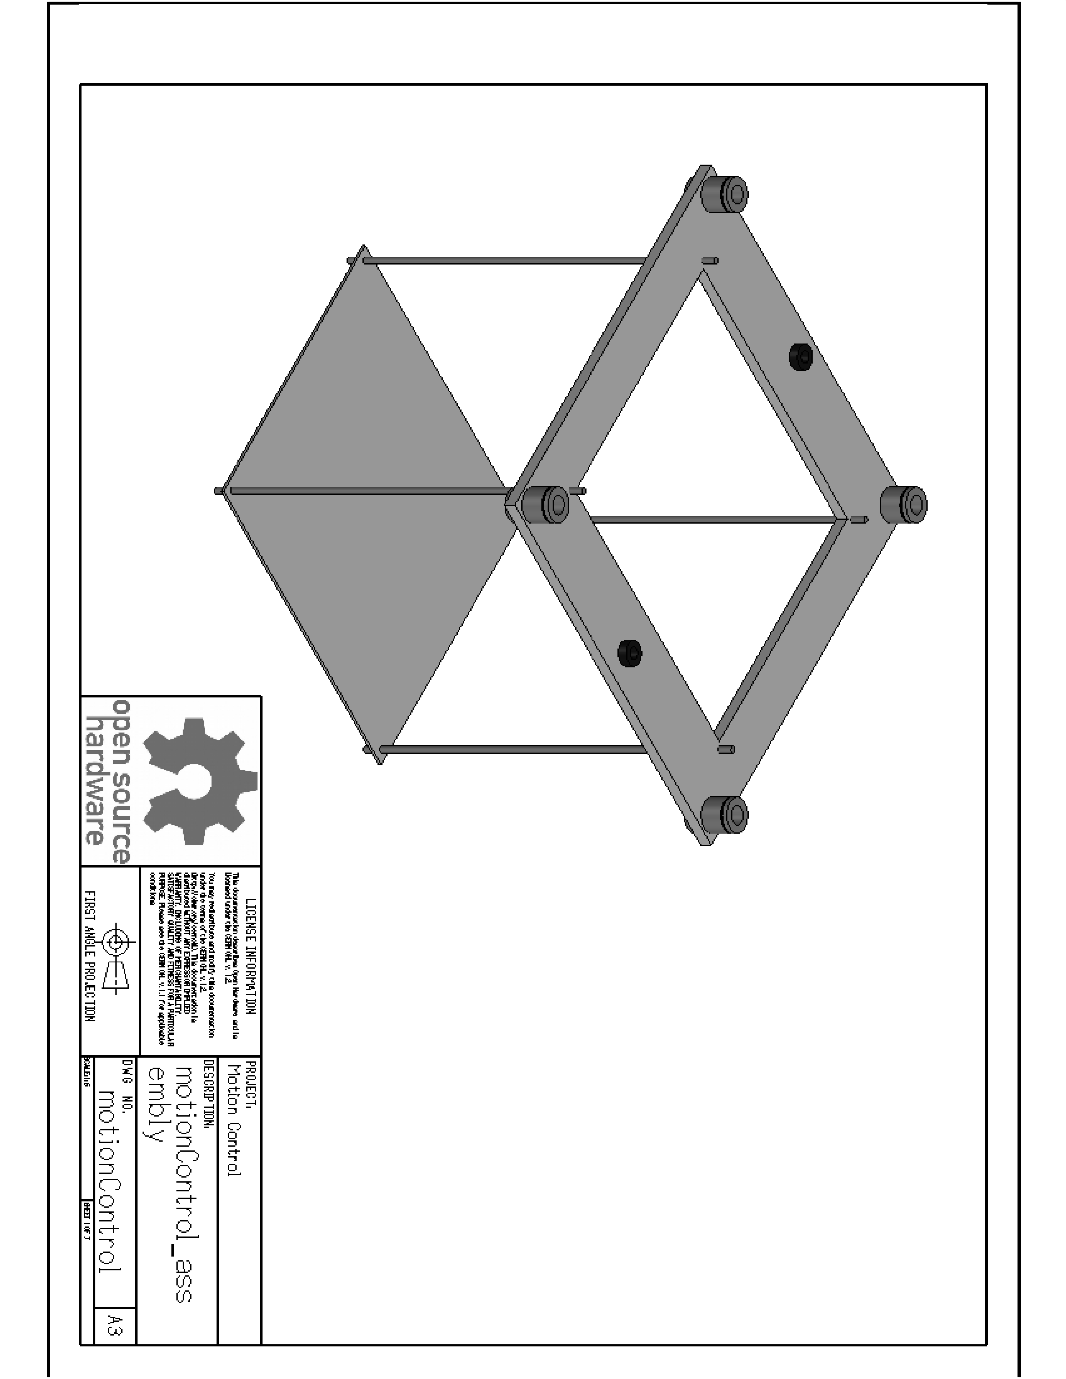
DesignReport/Appendix/Images/motionControl1.png
