dan-olsen/SeniorDesign/DesignReport/Appendix/Images/motionControl2.png

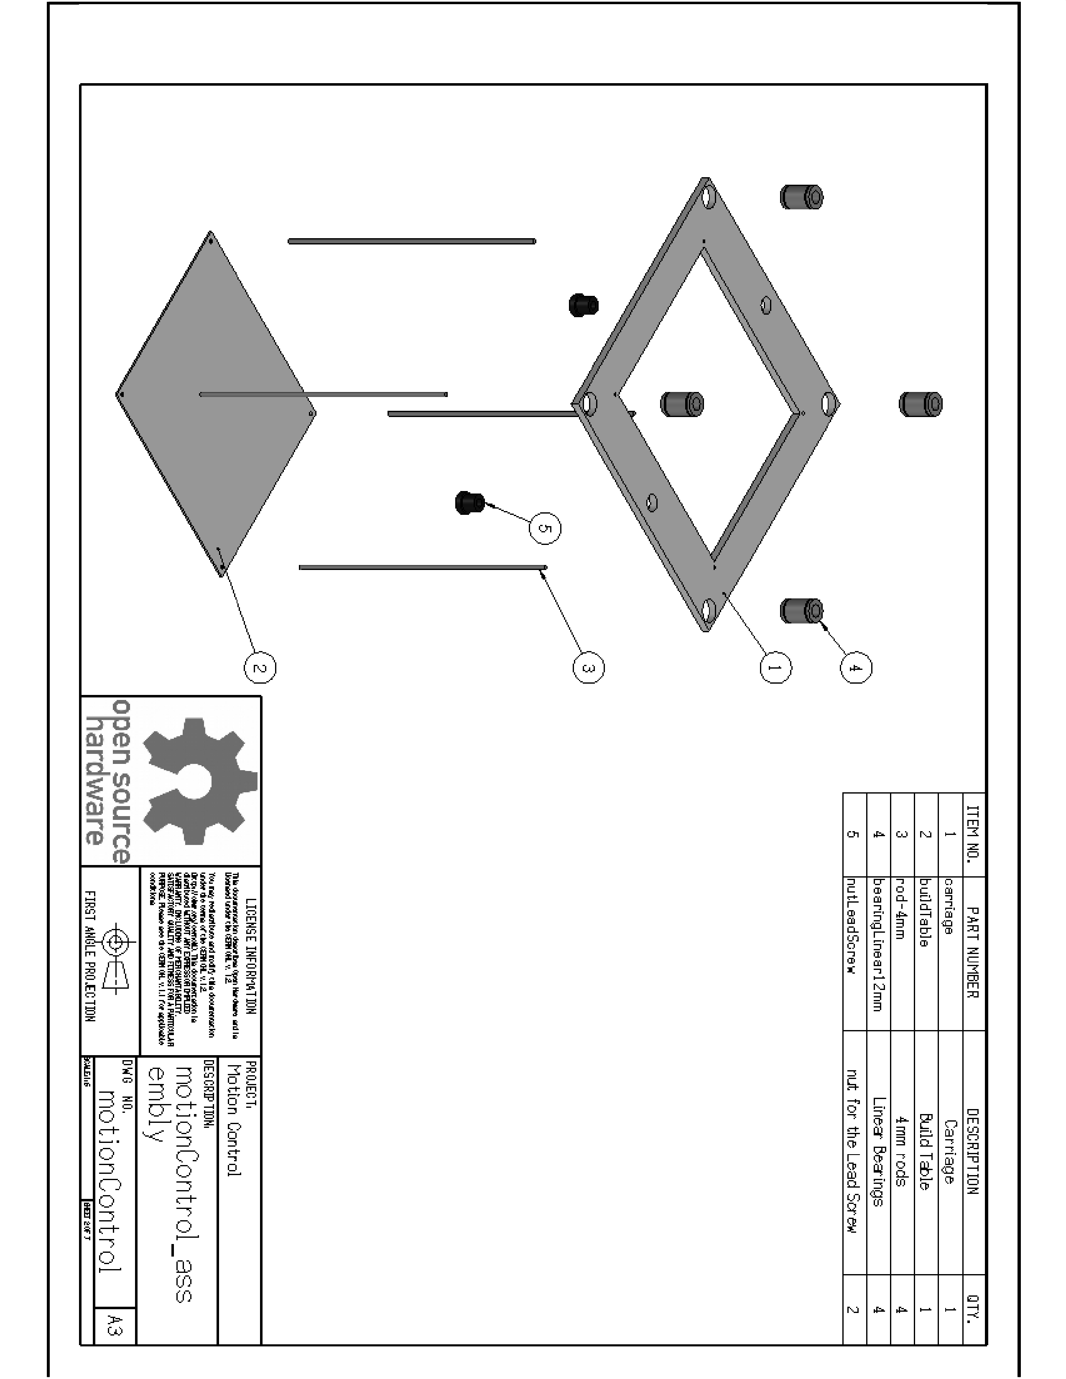
DesignReport/Appendix/Images/motionControl2.png
