dan-olsen/SeniorDesign/DesignReport/Appendix/Images/motionControl3.png

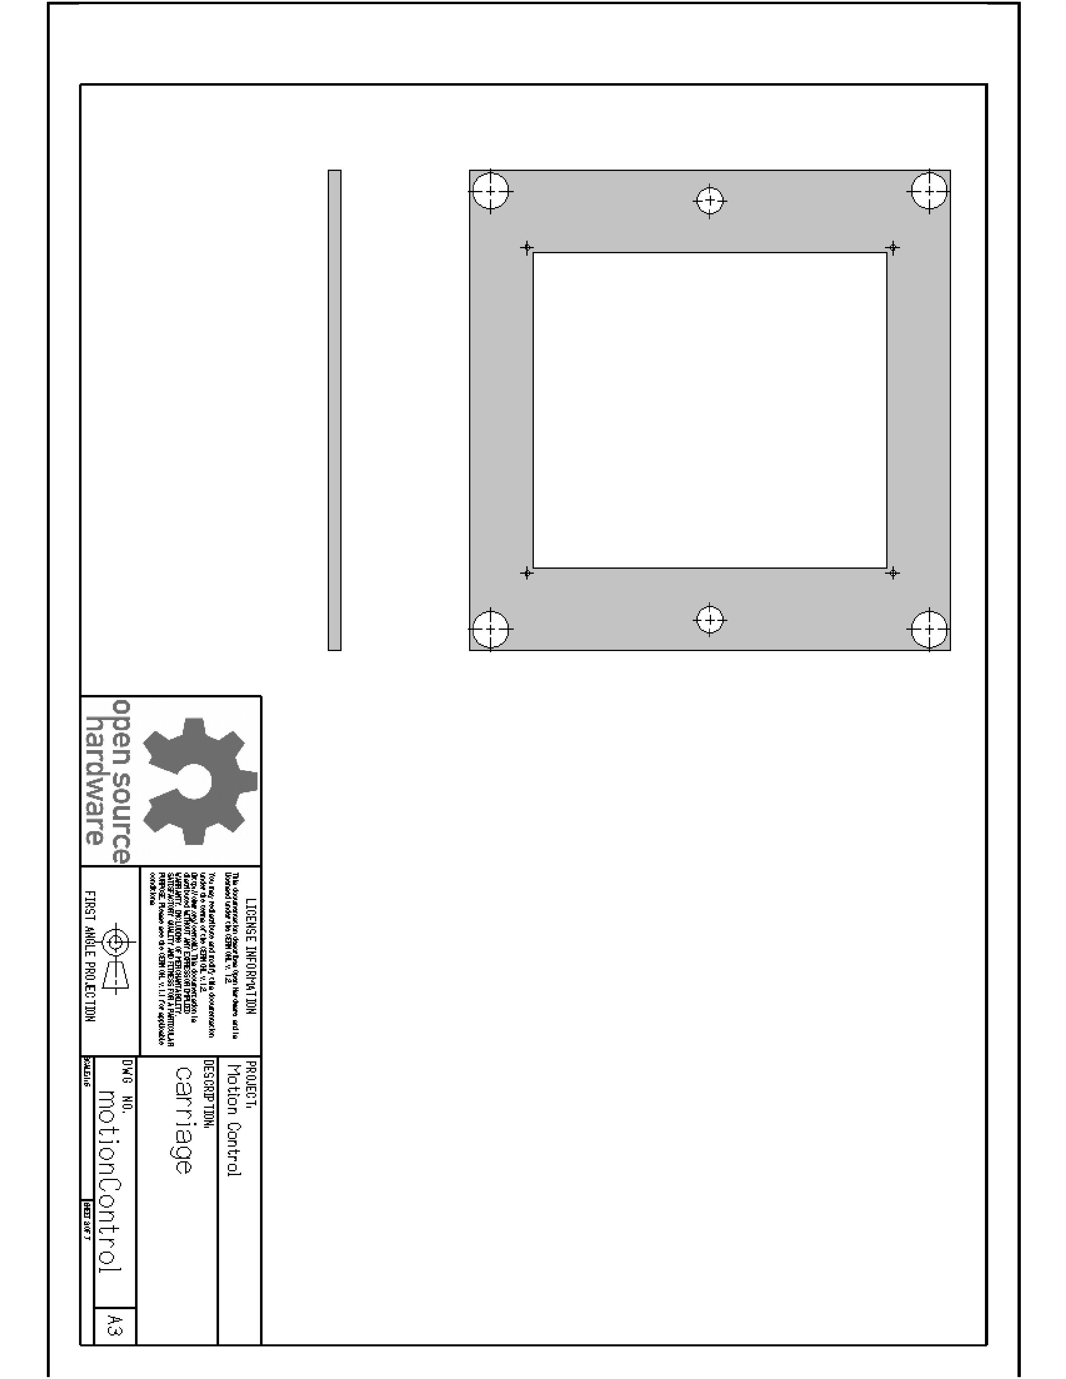
DesignReport/Appendix/Images/motionControl3.png
