dan-olsen/SeniorDesign/DesignReport/Appendix/Images/motionControl4.png

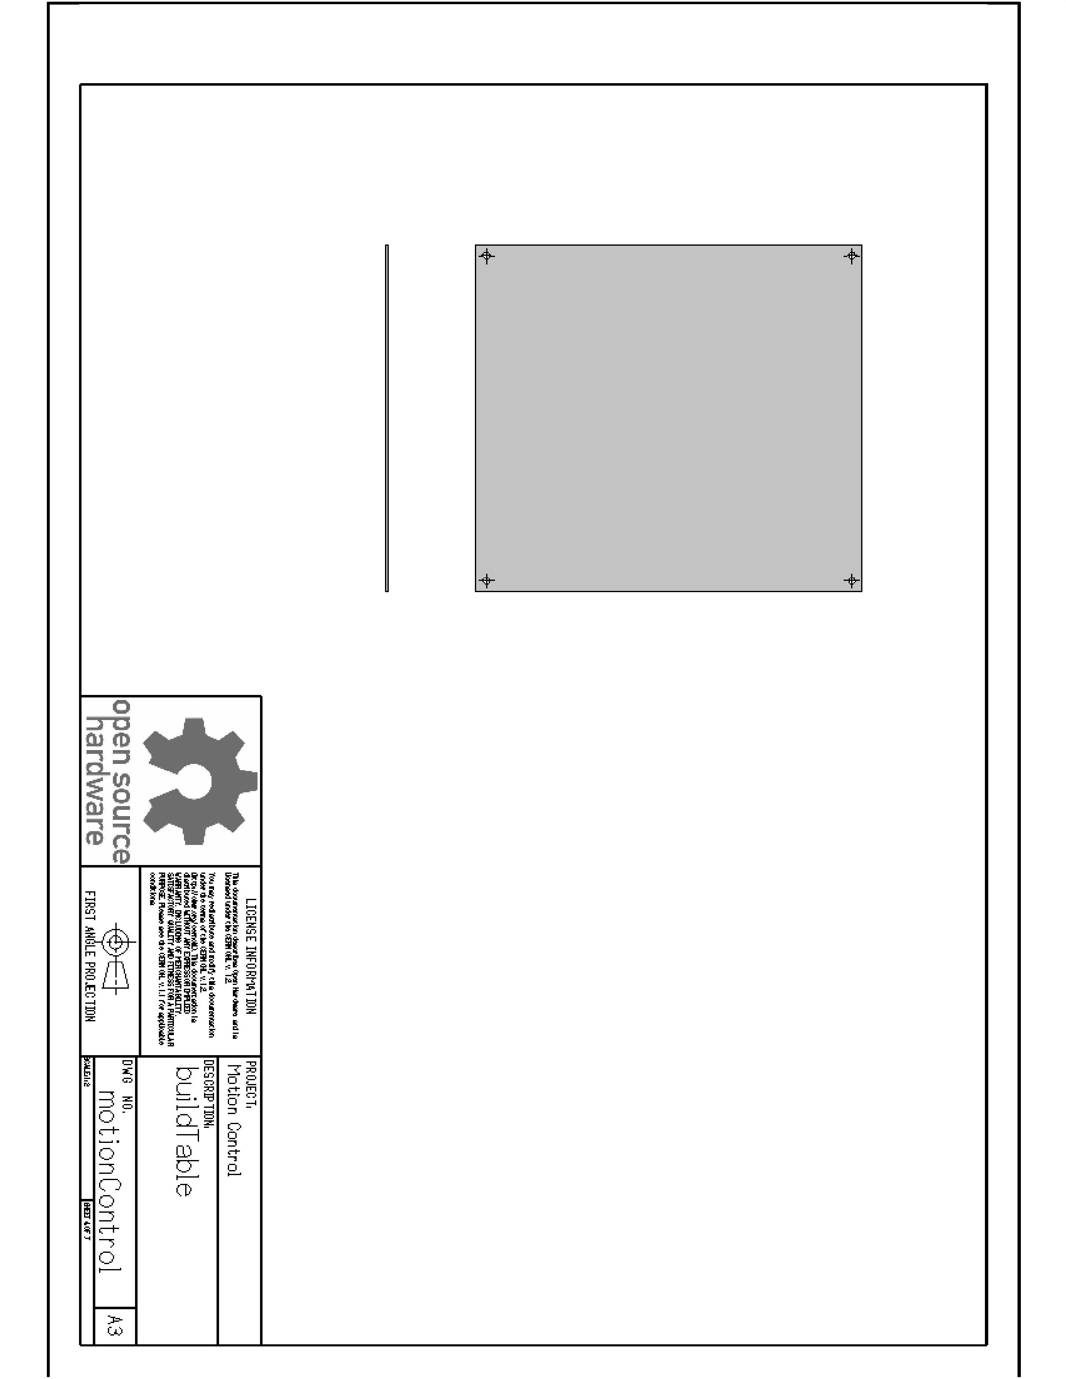
DesignReport/Appendix/Images/motionControl4.png
