dan-olsen/SeniorDesign/DesignReport/Appendix/Images/motionControl5.png

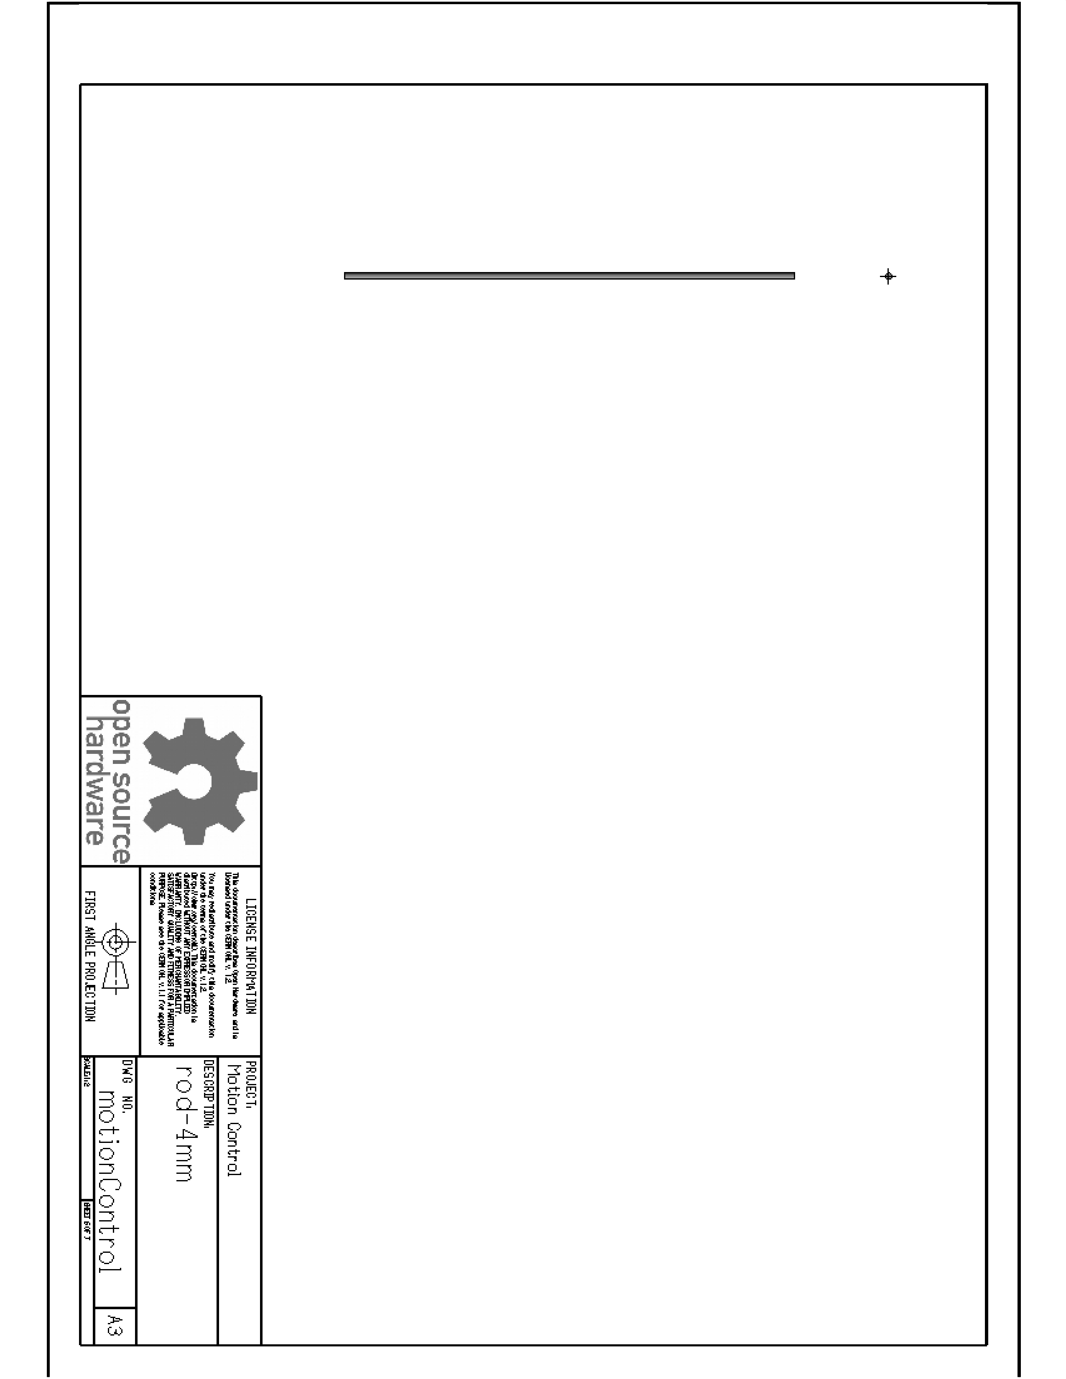
DesignReport/Appendix/Images/motionControl5.png
