dan-olsen/SeniorDesign/DesignReport/Appendix/Images/motionControl6.png

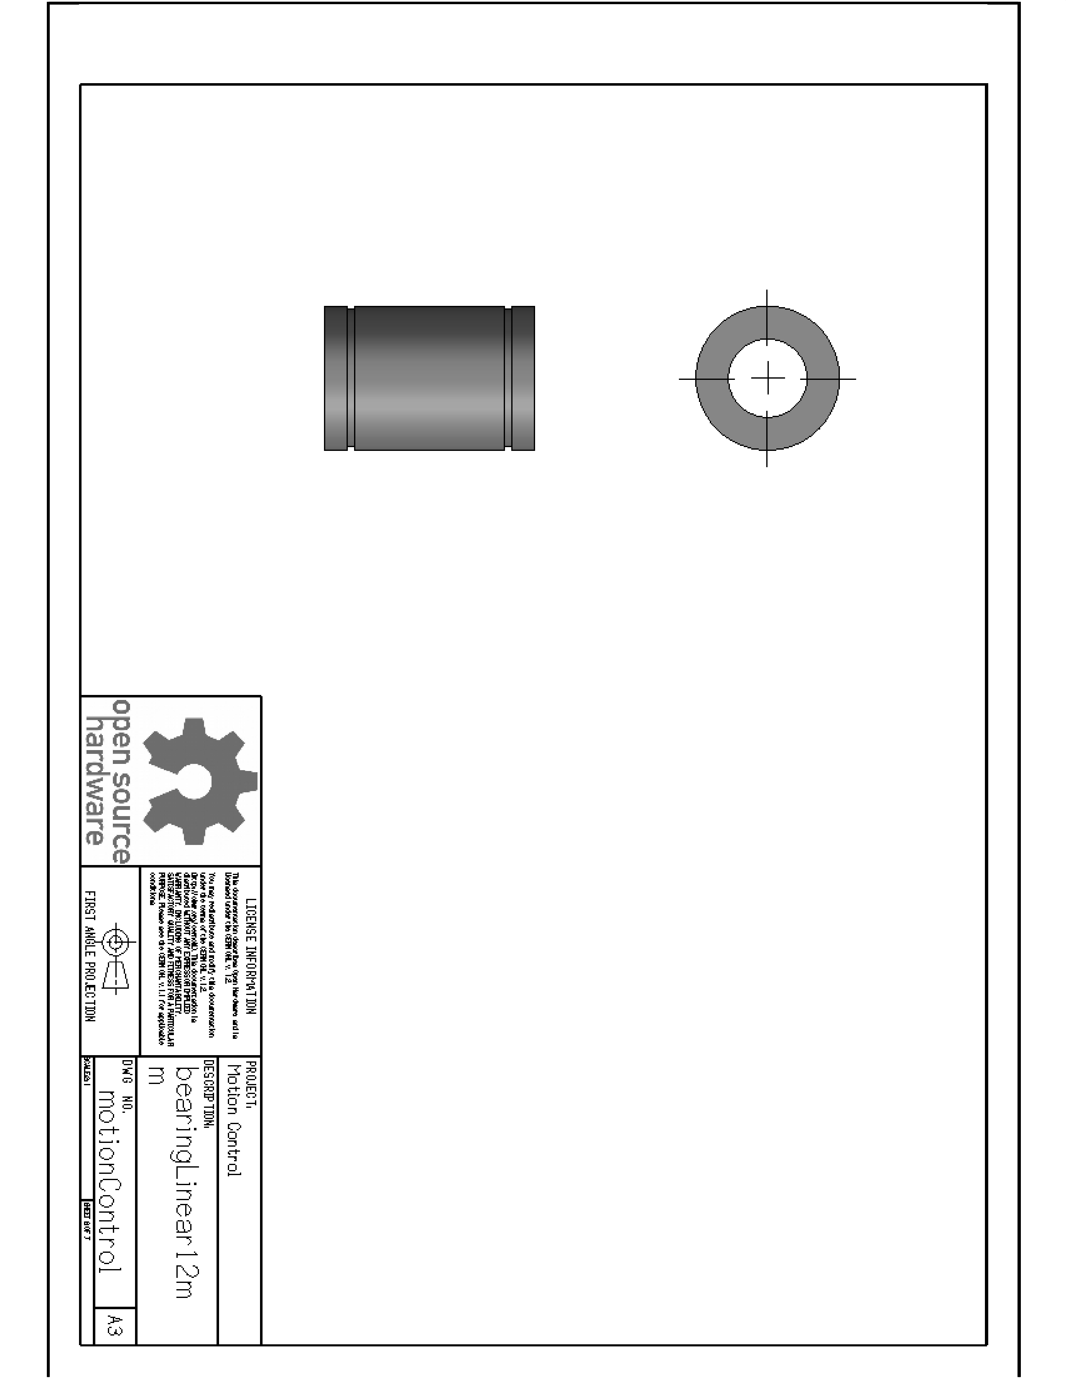
DesignReport/Appendix/Images/motionControl6.png
