dan-olsen/SeniorDesign/DesignReport/Appendix/Images/Project PAM - Indiegogo - Funders3.png

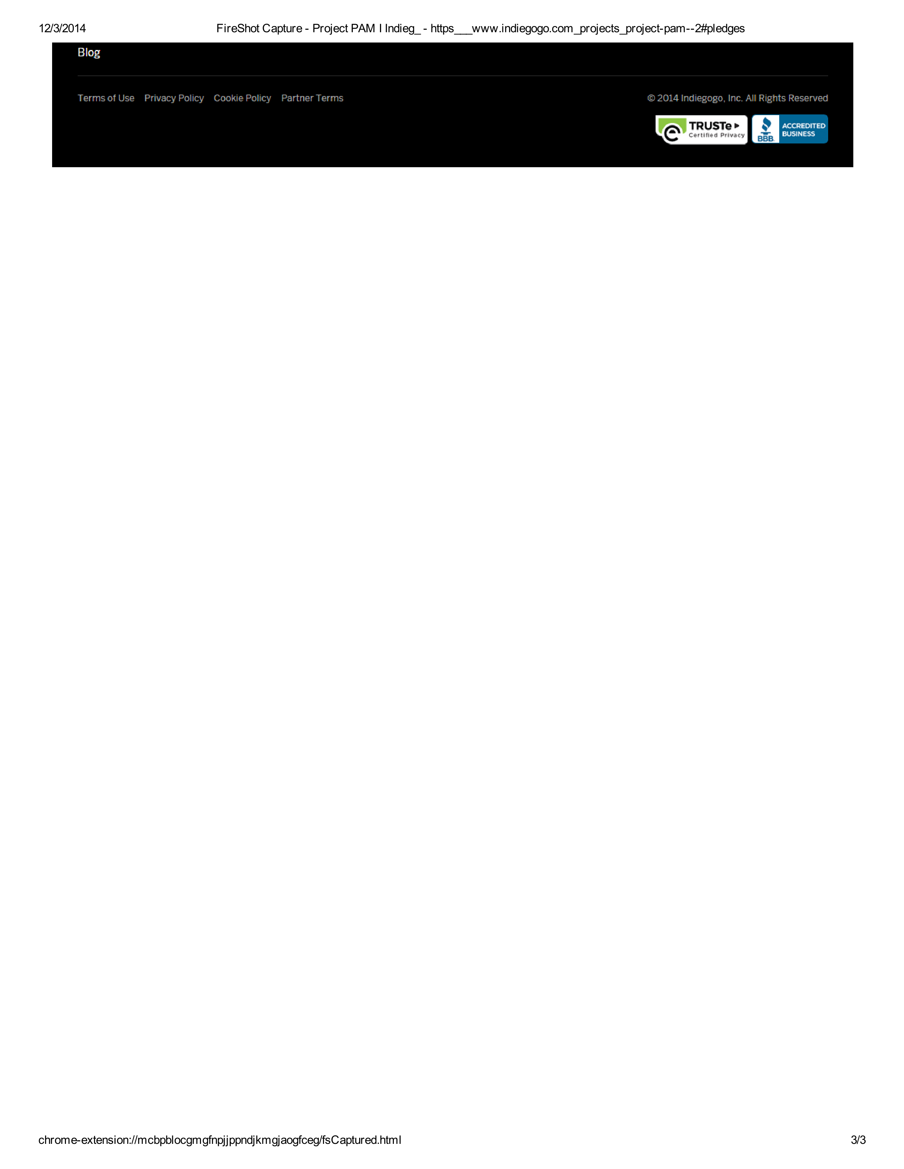
DesignReport/Appendix/Images/Project PAM - Indiegogo - Funders3.png
