dan-olsen/SeniorDesign/DesignReport/Appendix/Images/Project PAM - Indiegogo - Gallery1.png

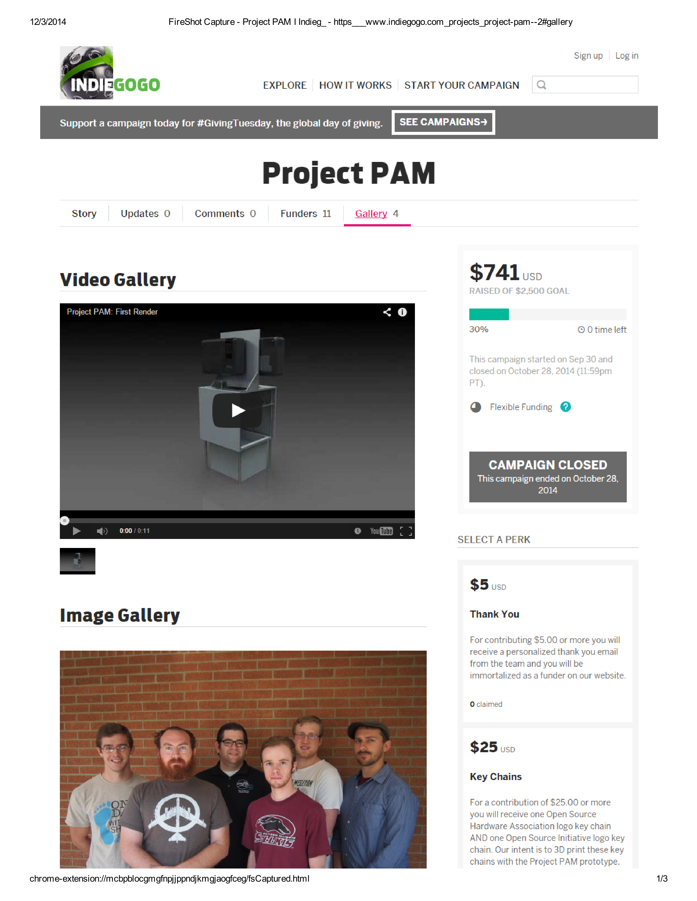
DesignReport/Appendix/Images/Project PAM - Indiegogo - Gallery1.png
