dan-olsen/SeniorDesign/DesignReport/Appendix/Images/Project PAM - Indiegogo - Story1.png

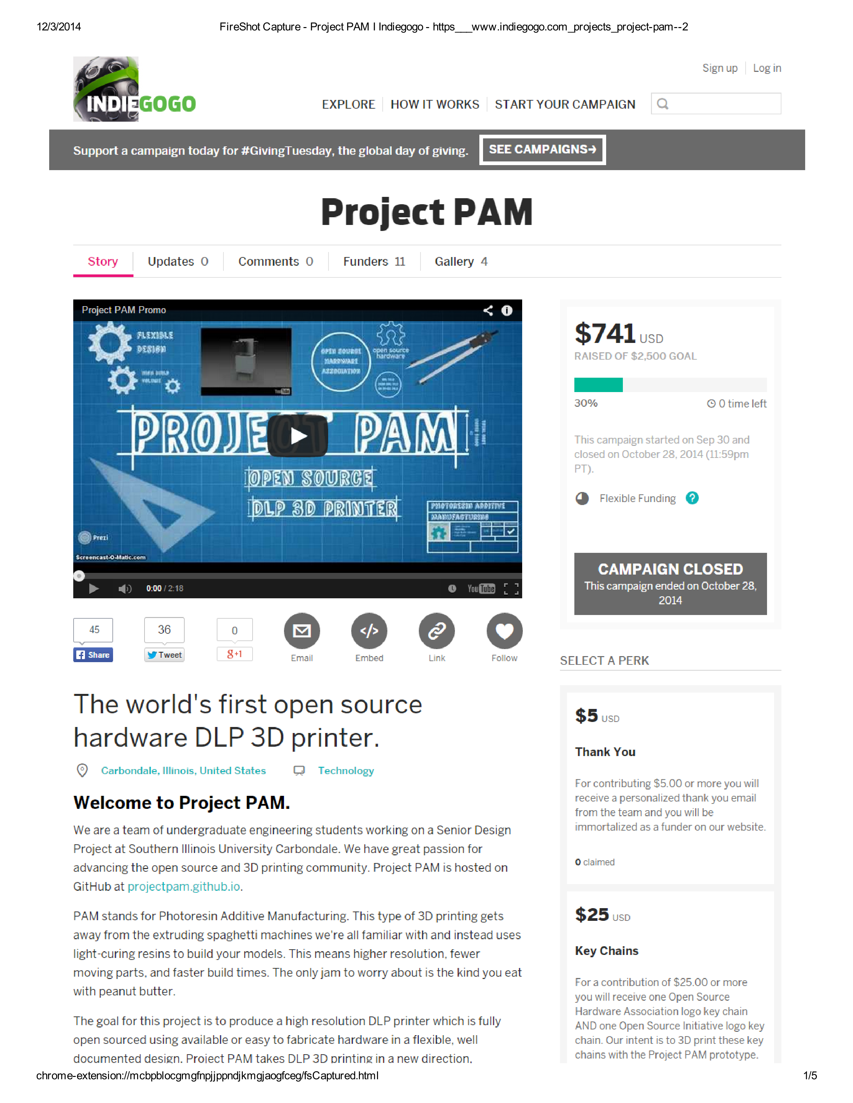
DesignReport/Appendix/Images/Project PAM - Indiegogo - Story1.png
