dan-olsen/SeniorDesign/DesignReport/Appendix/Images/Project PAM - Indiegogo - Story2.png

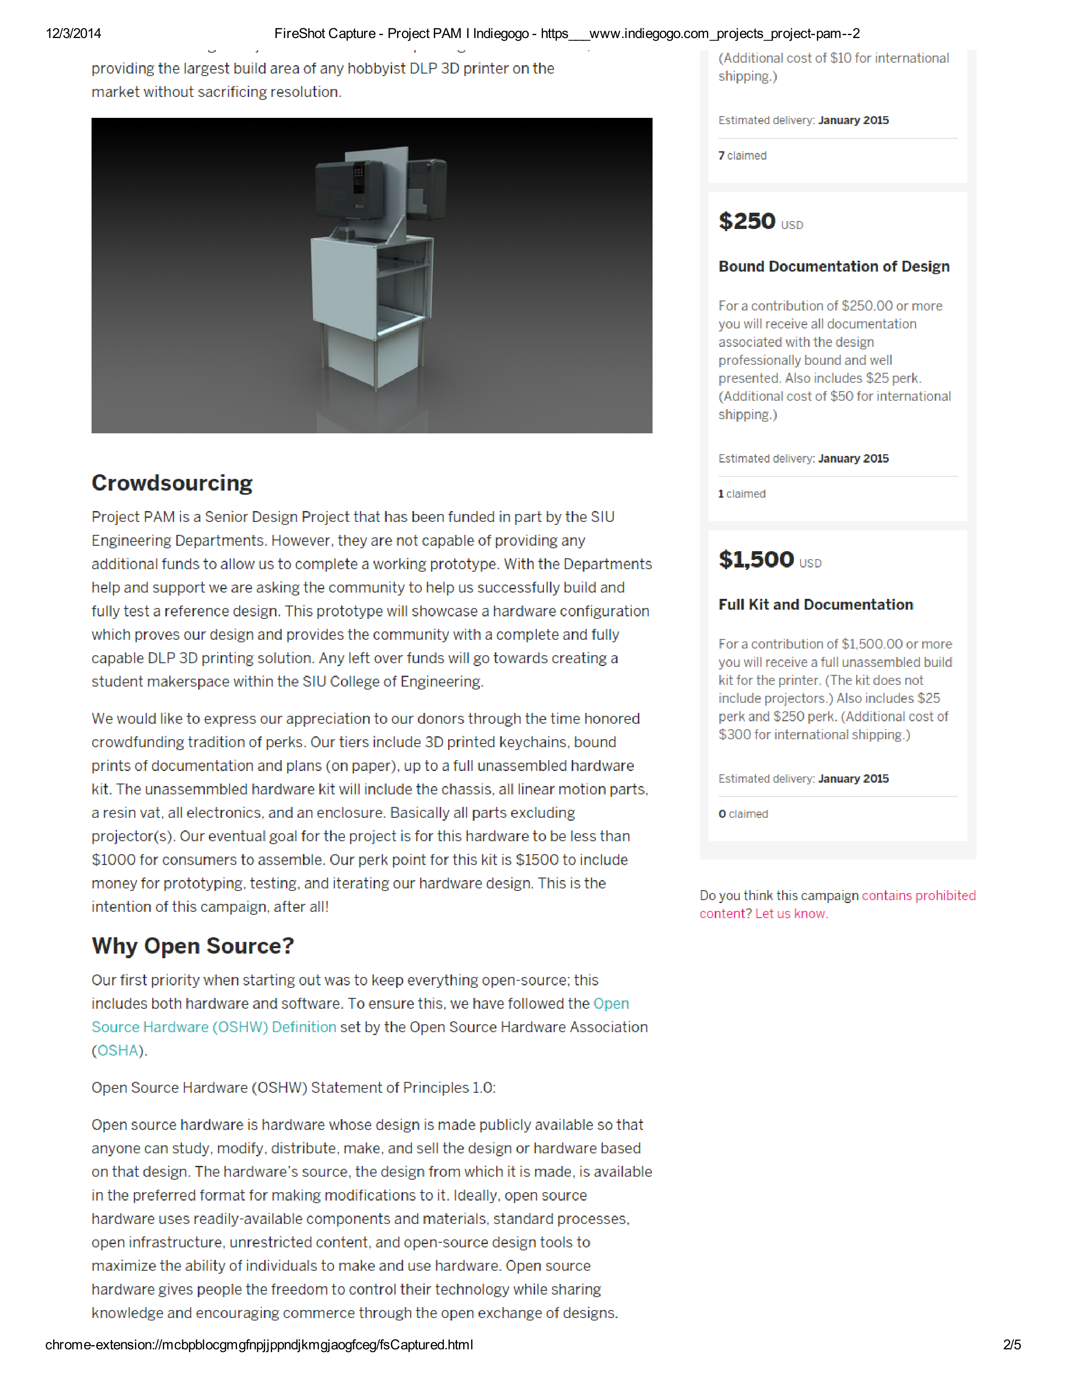
DesignReport/Appendix/Images/Project PAM - Indiegogo - Story2.png
