dan-olsen/SeniorDesign/DesignReport/Appendix/Images/Project PAM - Indiegogo - Story3.png

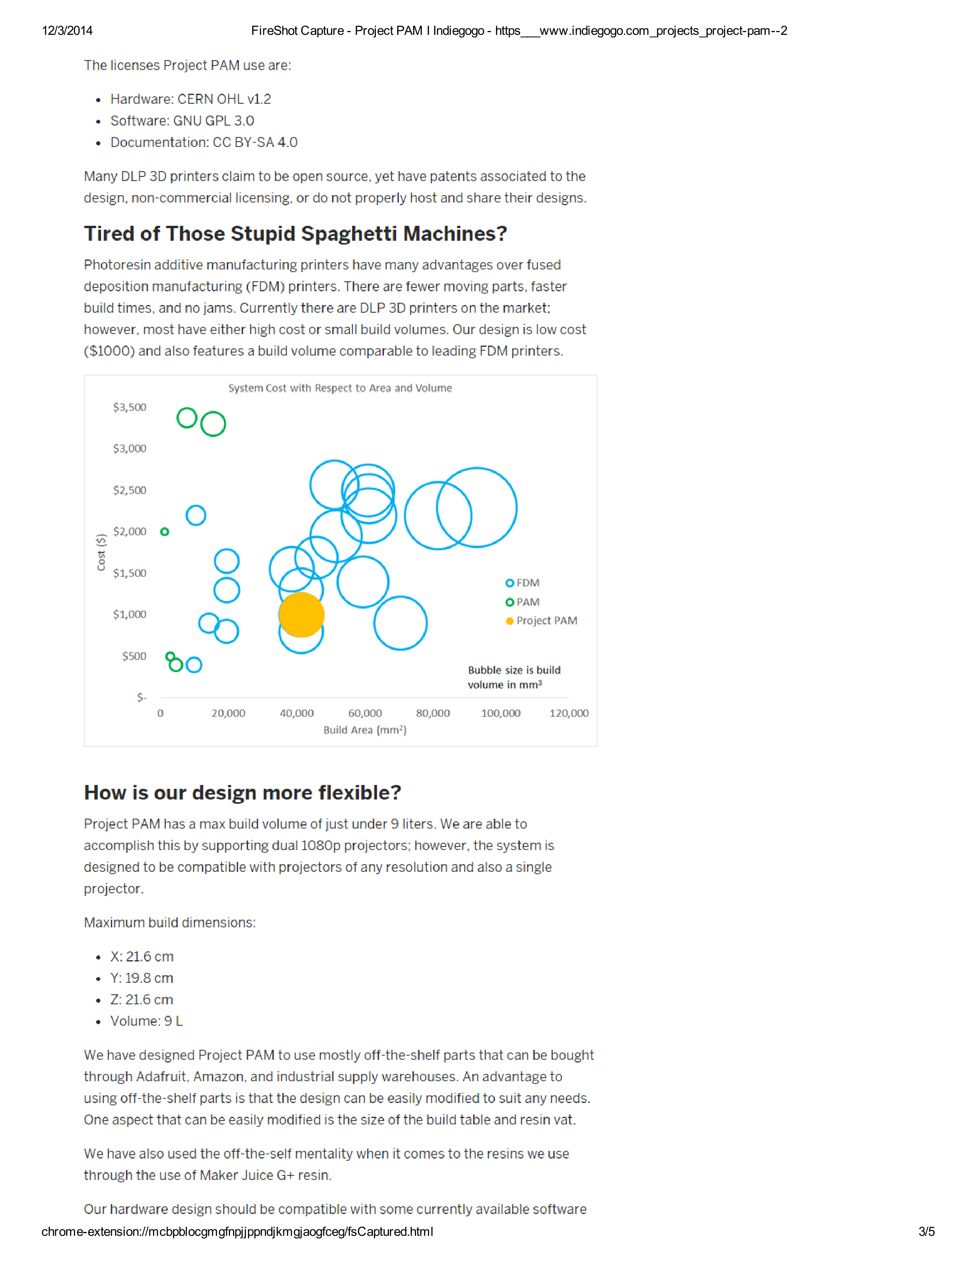
DesignReport/Appendix/Images/Project PAM - Indiegogo - Story3.png
