dan-olsen/SeniorDesign/DesignReport/Appendix/Images/Project PAM - Indiegogo - Story4.png

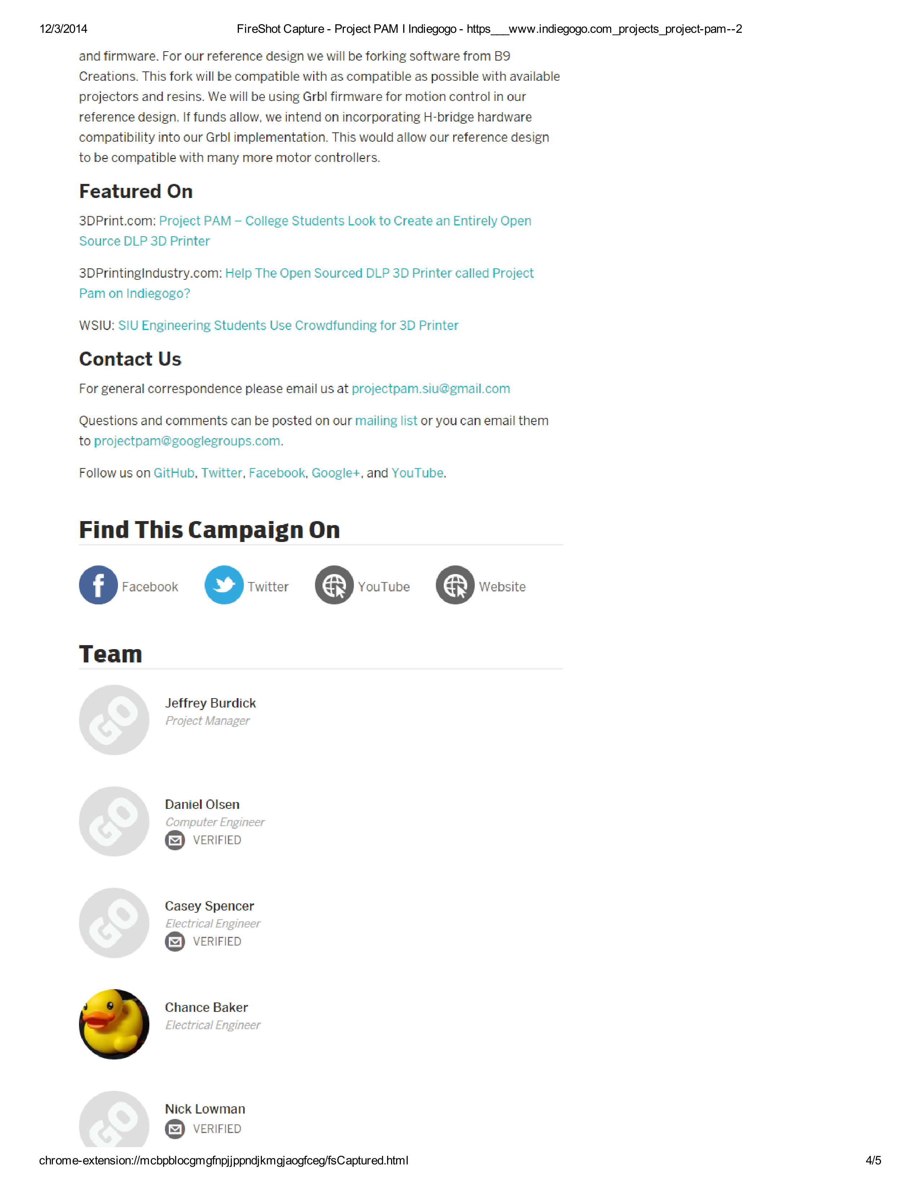
DesignReport/Appendix/Images/Project PAM - Indiegogo - Story4.png
