dan-olsen/SeniorDesign/DesignReport/Appendix/Images/Project PAM - Indiegogo - Story5.png

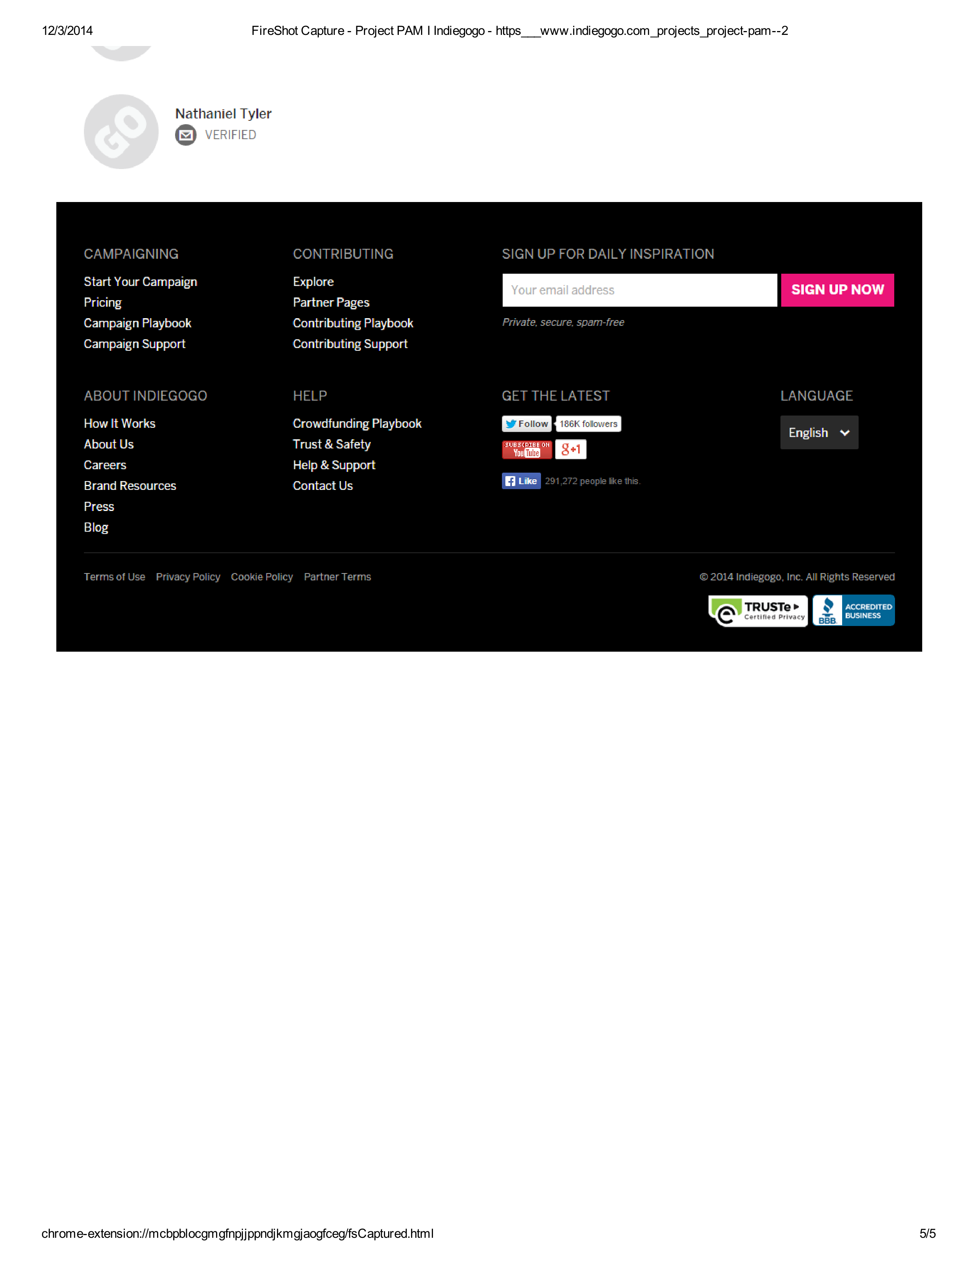
DesignReport/Appendix/Images/Project PAM - Indiegogo - Story5.png
