dan-olsen/SeniorDesign/DesignReport/Appendix/Images/Project PAM_Facebook1.png

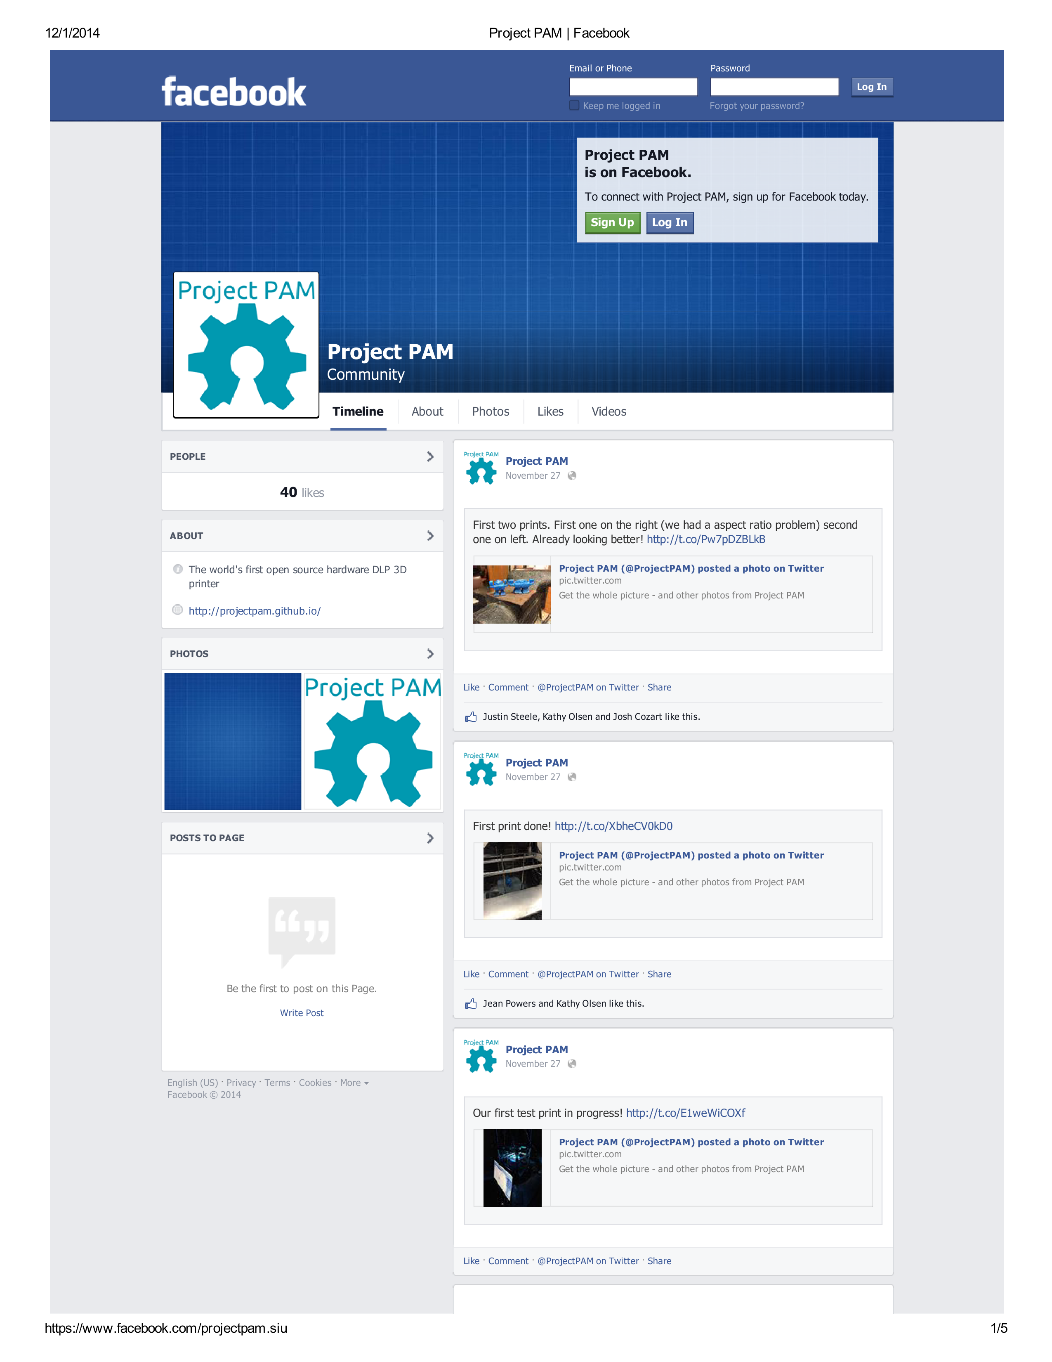
DesignReport/Appendix/Images/Project PAM_Facebook1.png
