dan-olsen/SeniorDesign/DesignReport/Appendix/Images/Project PAM_Facebook2.png

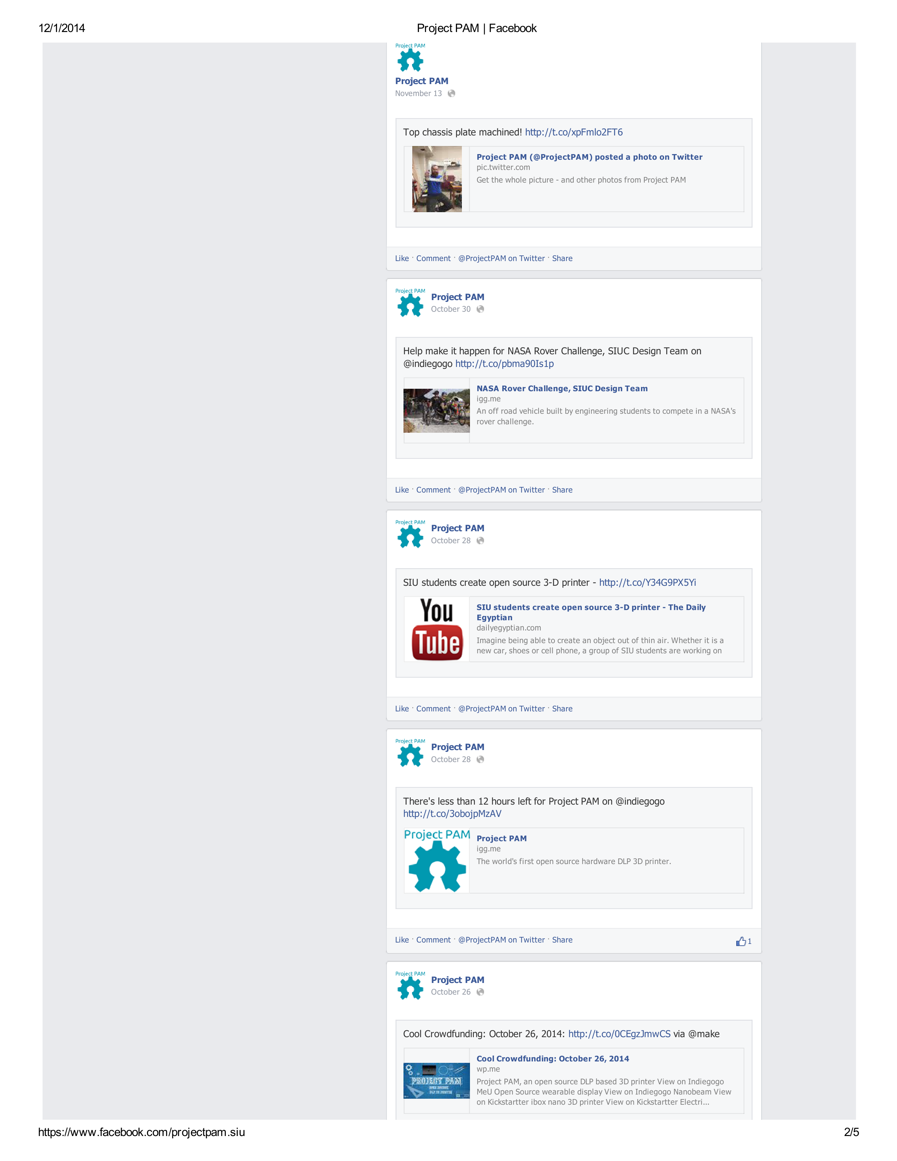
DesignReport/Appendix/Images/Project PAM_Facebook2.png
