dan-olsen/SeniorDesign/DesignReport/Appendix/Images/Project PAM_Facebook3.png

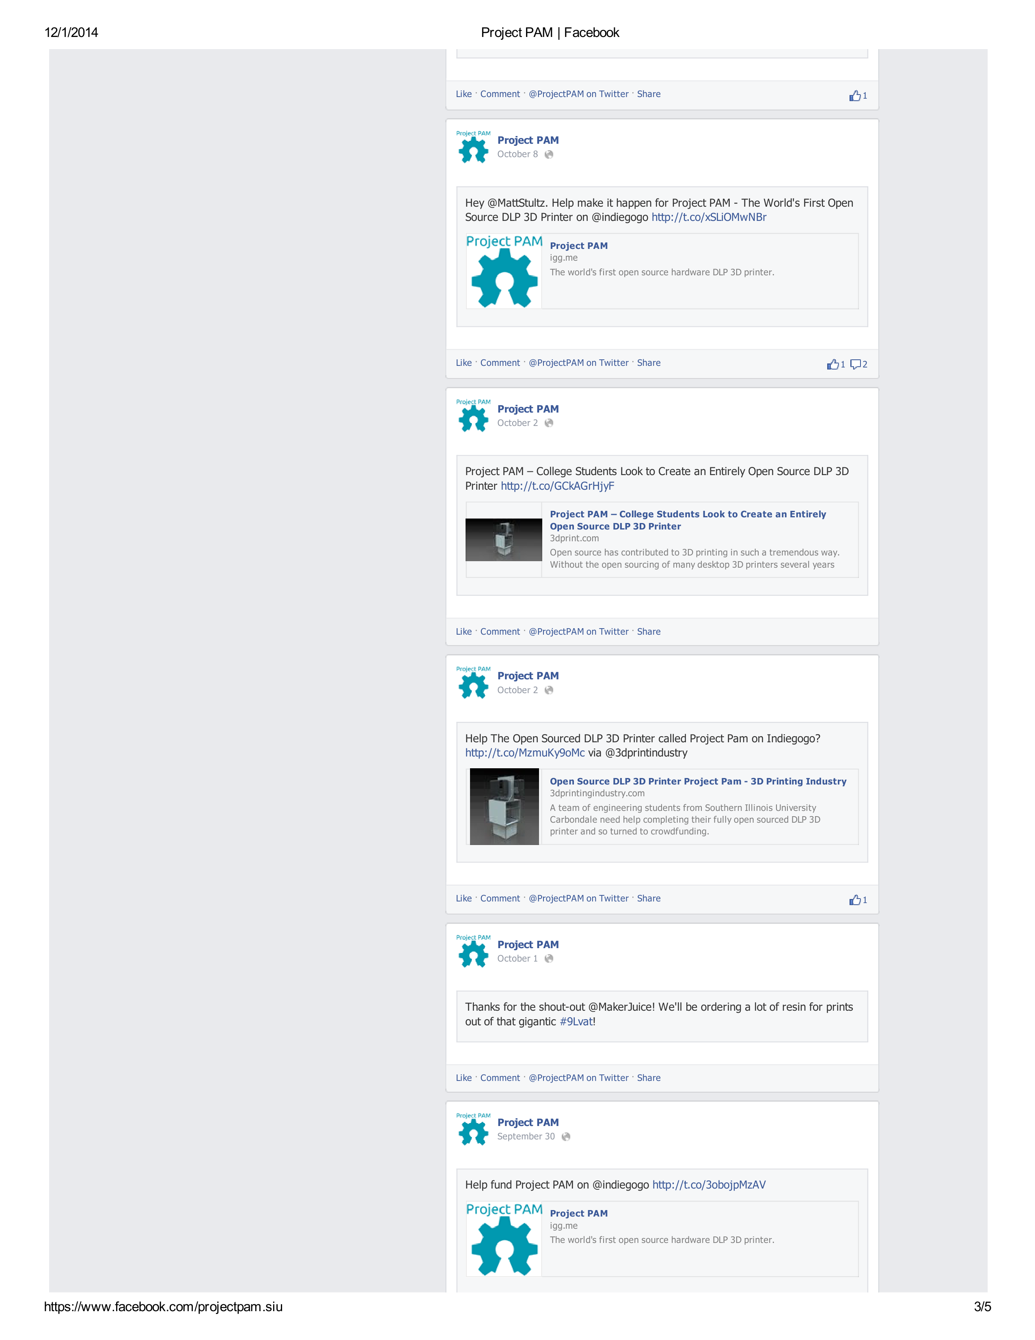
DesignReport/Appendix/Images/Project PAM_Facebook3.png
