dan-olsen/SeniorDesign/DesignReport/Appendix/Images/Project PAM_Facebook4.png

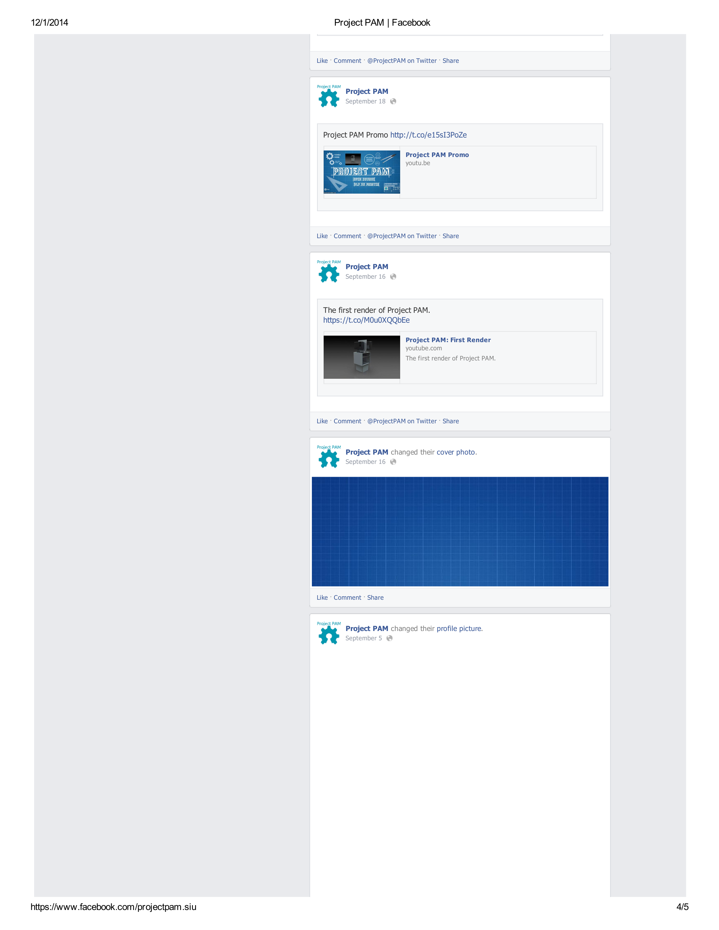
DesignReport/Appendix/Images/Project PAM_Facebook4.png
