dan-olsen/SeniorDesign/DesignReport/Appendix/Images/Project PAM_Facebook5.png

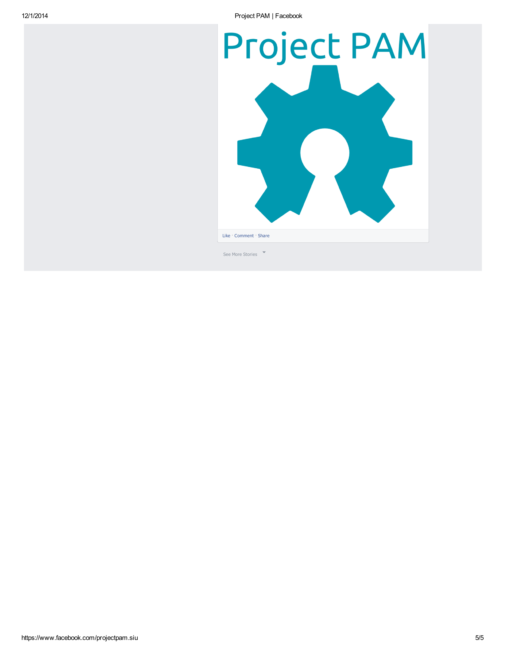
DesignReport/Appendix/Images/Project PAM_Facebook5.png
