dan-olsen/SeniorDesign/DesignReport/Appendix/Images/Project PAM_Twitter2.png

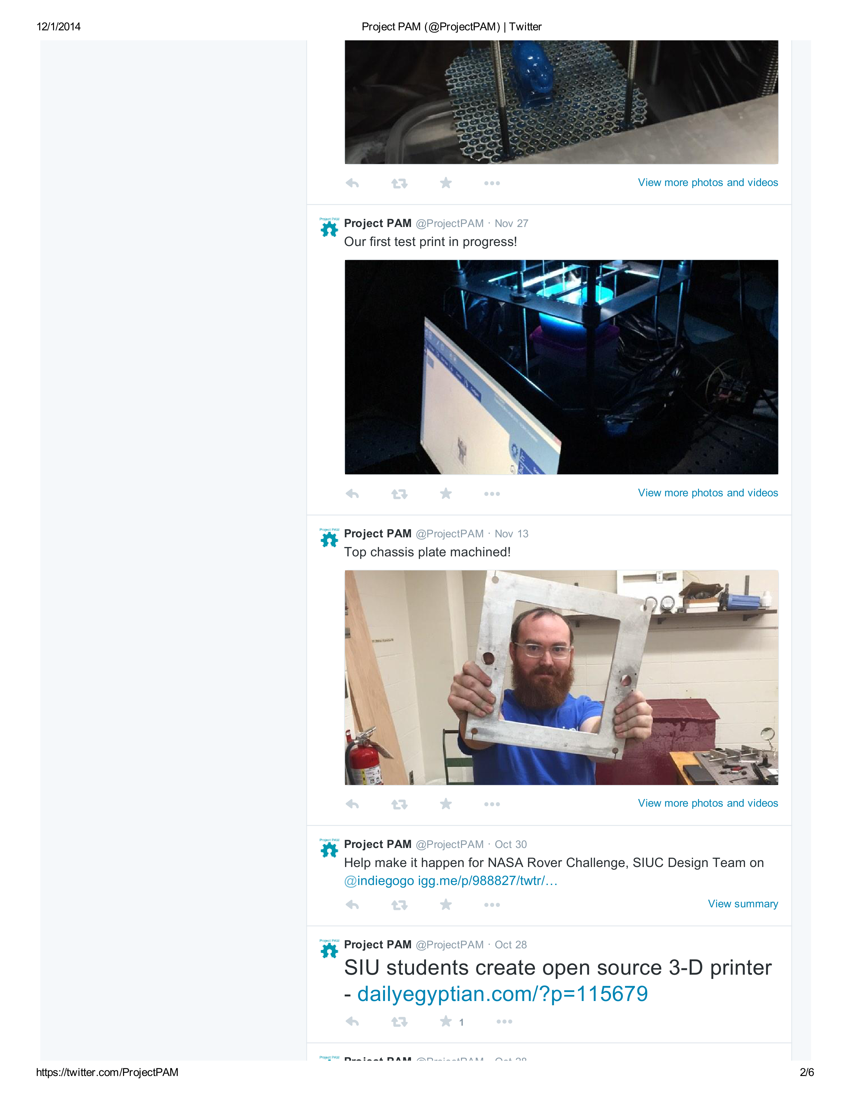
DesignReport/Appendix/Images/Project PAM_Twitter2.png
