dan-olsen/SeniorDesign/DesignReport/Appendix/Images/Project PAM_Twitter3.png

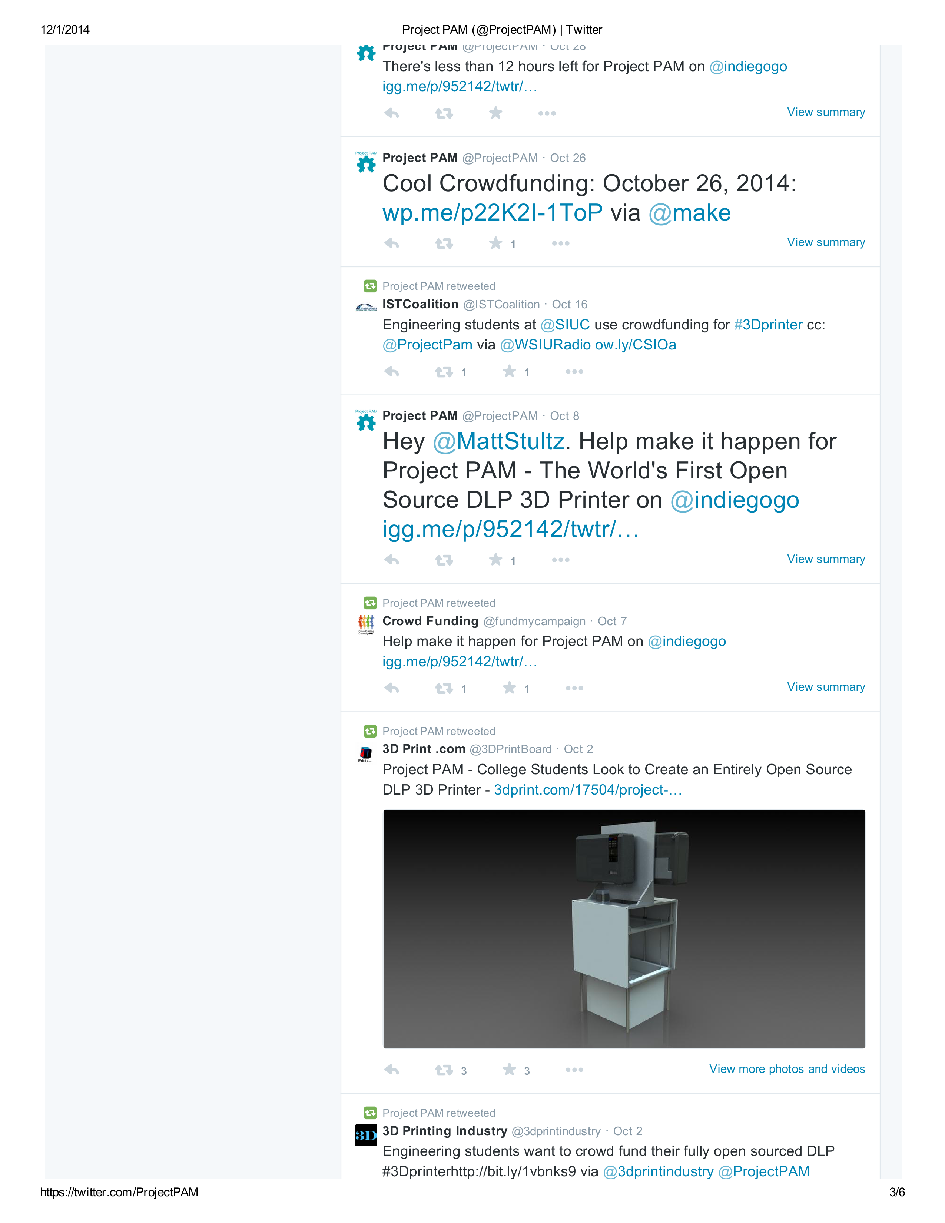
DesignReport/Appendix/Images/Project PAM_Twitter3.png
