dan-olsen/SeniorDesign/DesignReport/Appendix/Images/Project PAM_Twitter4.png

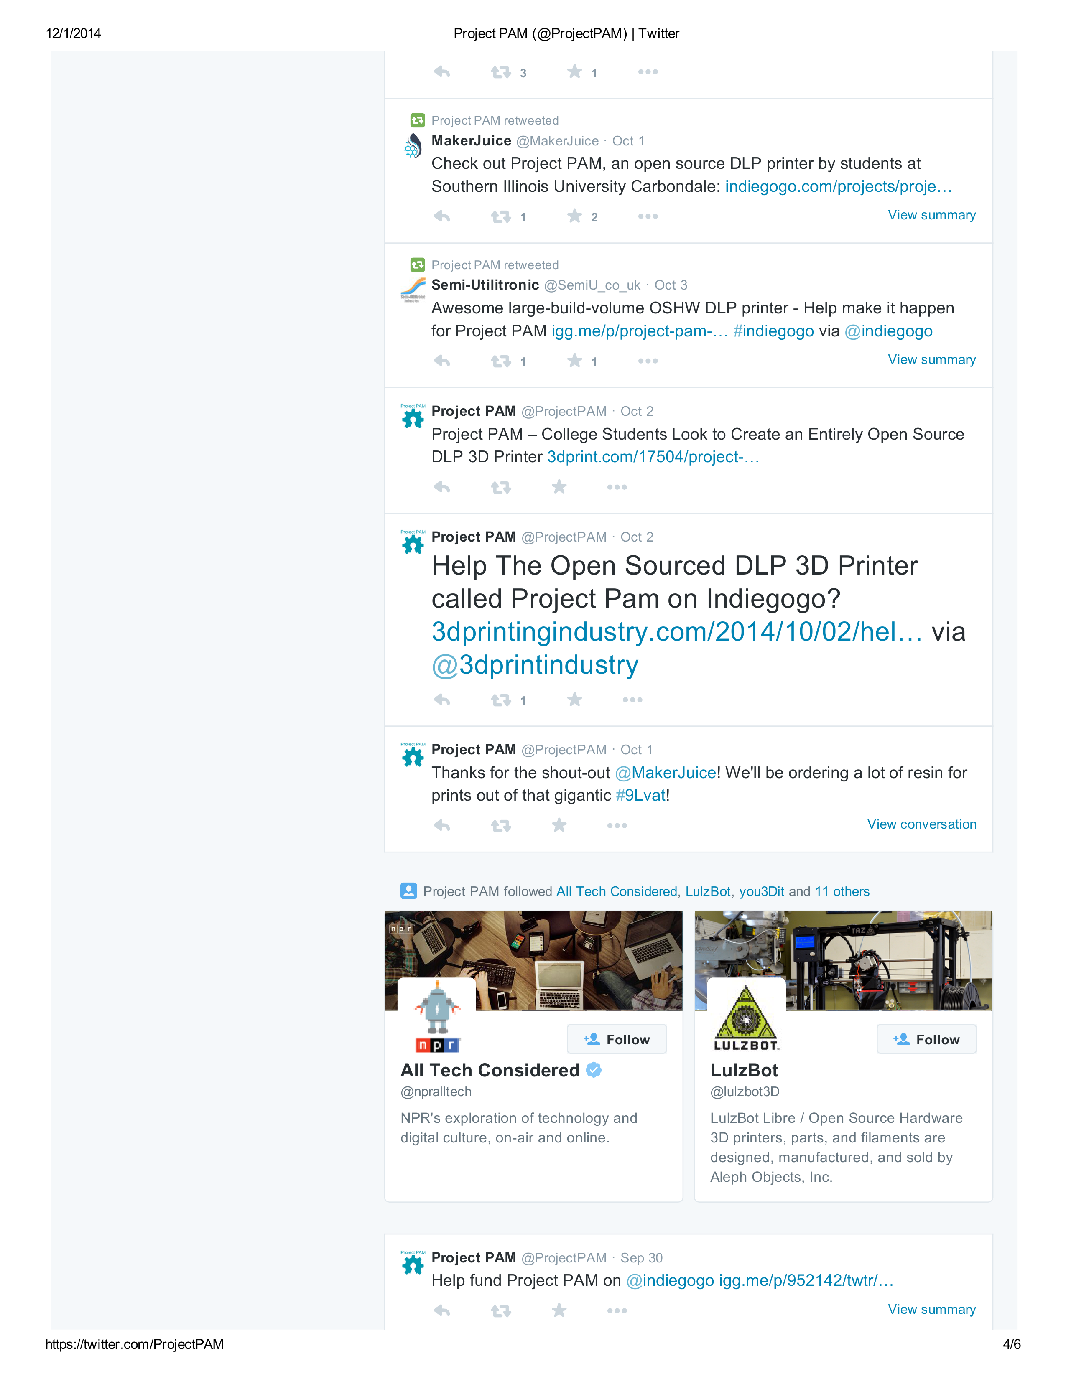
DesignReport/Appendix/Images/Project PAM_Twitter4.png
