dan-olsen/SeniorDesign/DesignReport/Appendix/Images/Project PAM_Twitter5.png

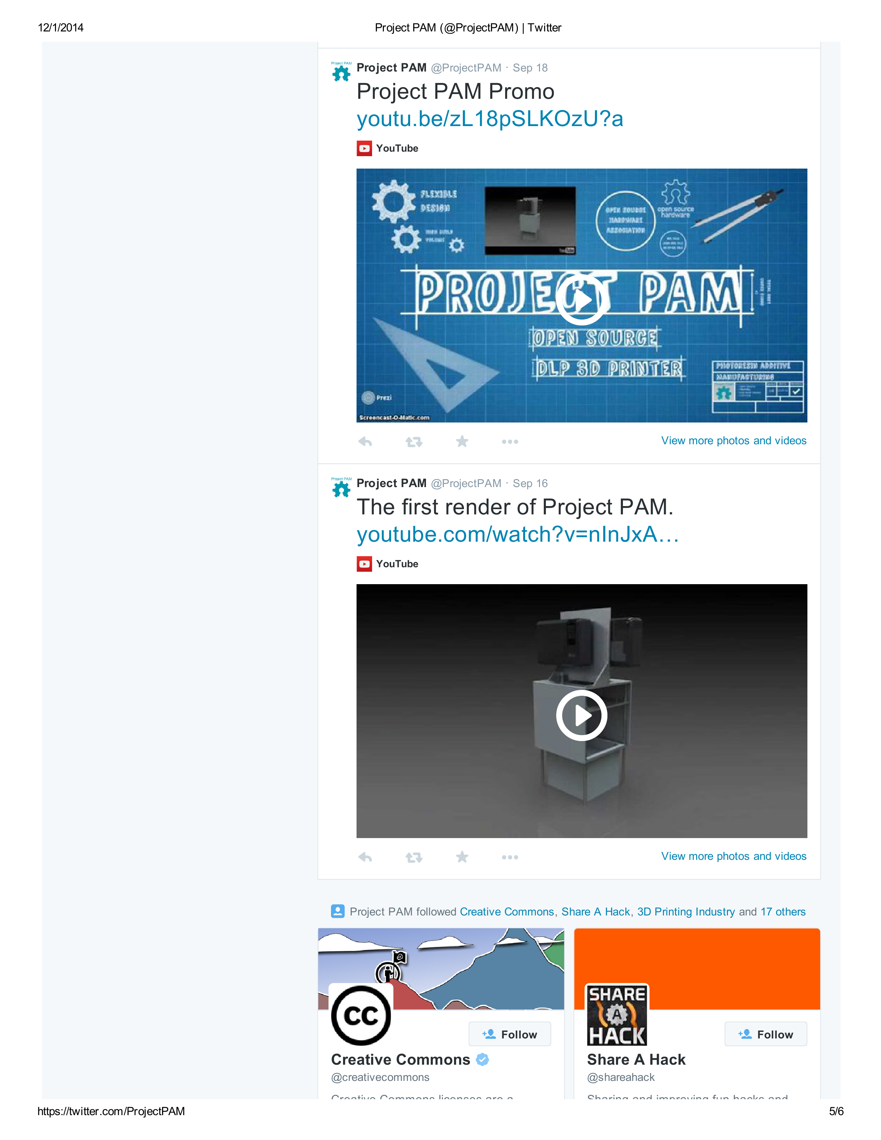
DesignReport/Appendix/Images/Project PAM_Twitter5.png
