dan-olsen/SeniorDesign/DesignReport/Appendix/Images/Project PAM_Twitter6.png

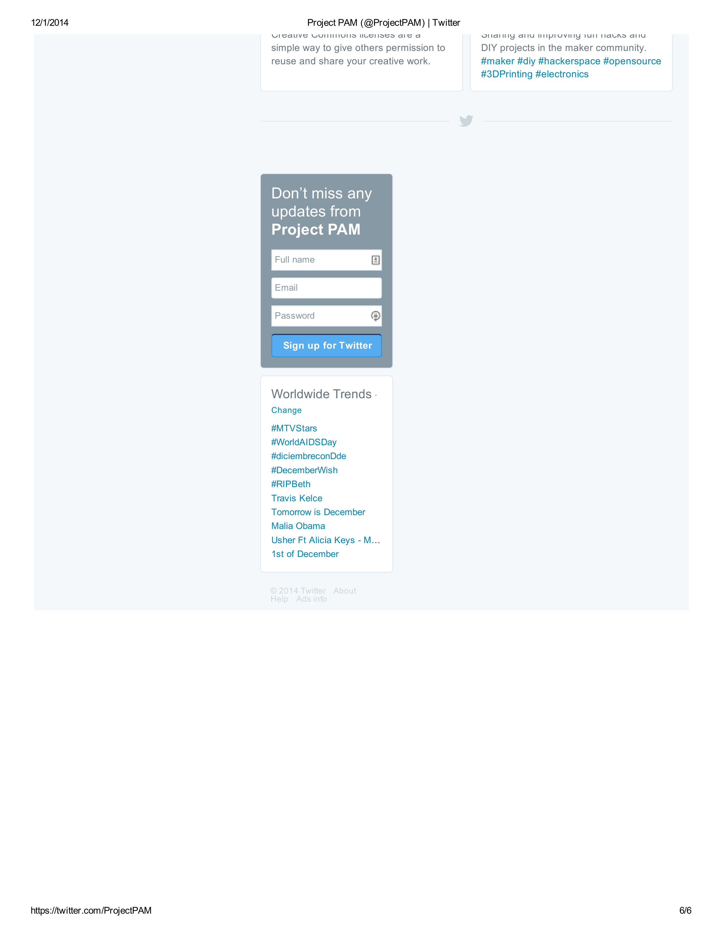
DesignReport/Appendix/Images/Project PAM_Twitter6.png
