dan-olsen/SeniorDesign/DesignReport/Appendix/Images/ProjectPAM_github_io1.png

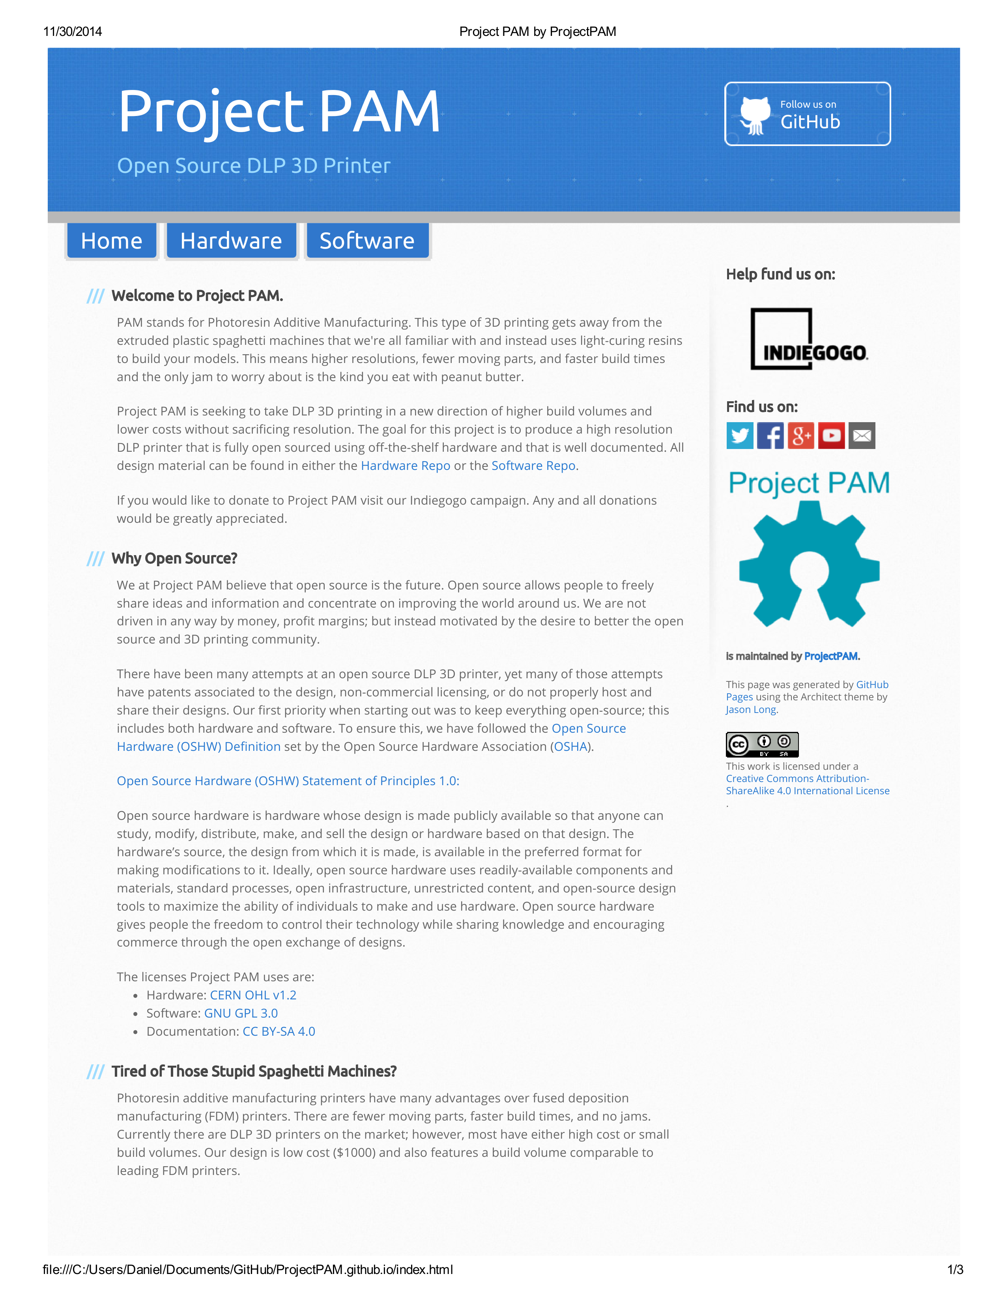
DesignReport/Appendix/Images/ProjectPAM_github_io1.png
