dan-olsen/SeniorDesign/DesignReport/Appendix/Images/ProjectPAM_github_io2.png

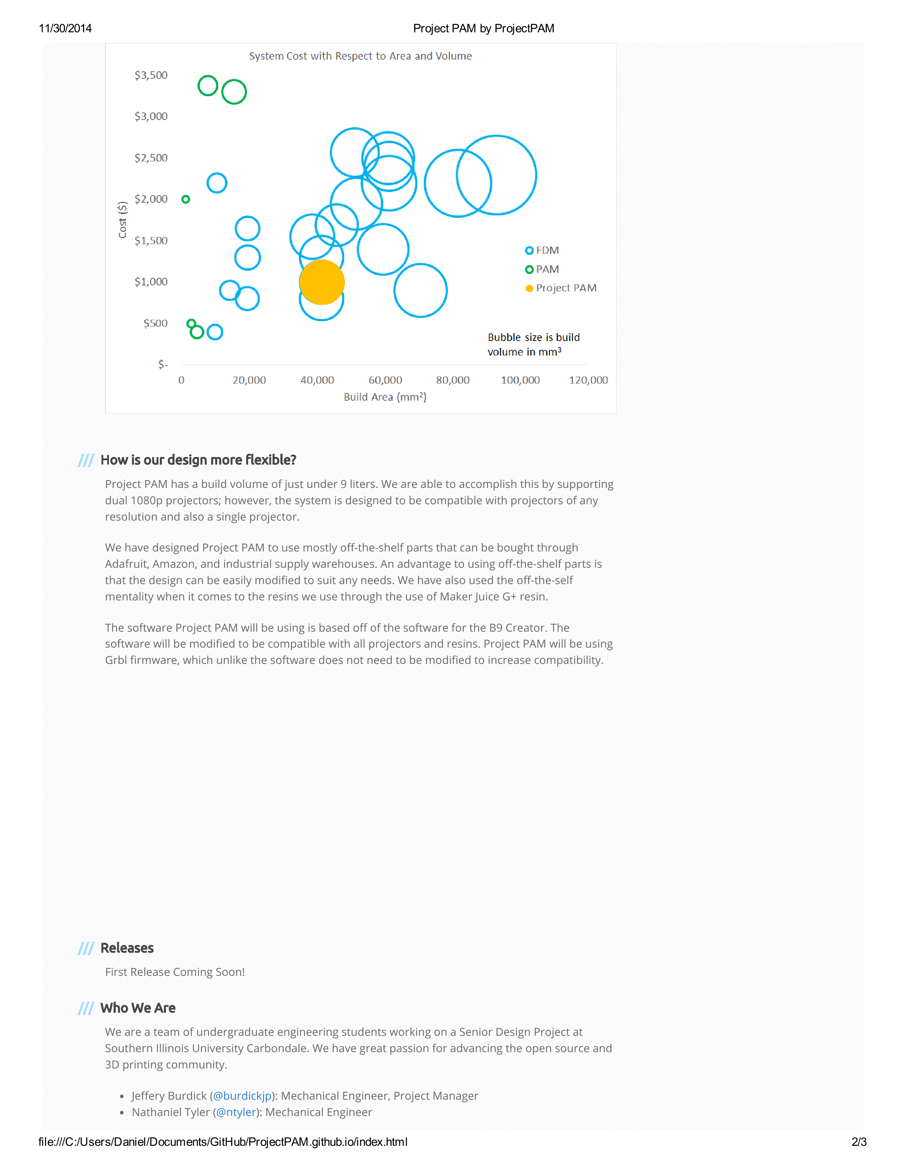
DesignReport/Appendix/Images/ProjectPAM_github_io2.png
