dan-olsen/SeniorDesign/DesignReport/Appendix/Images/ProjectPAM_github_io3.png

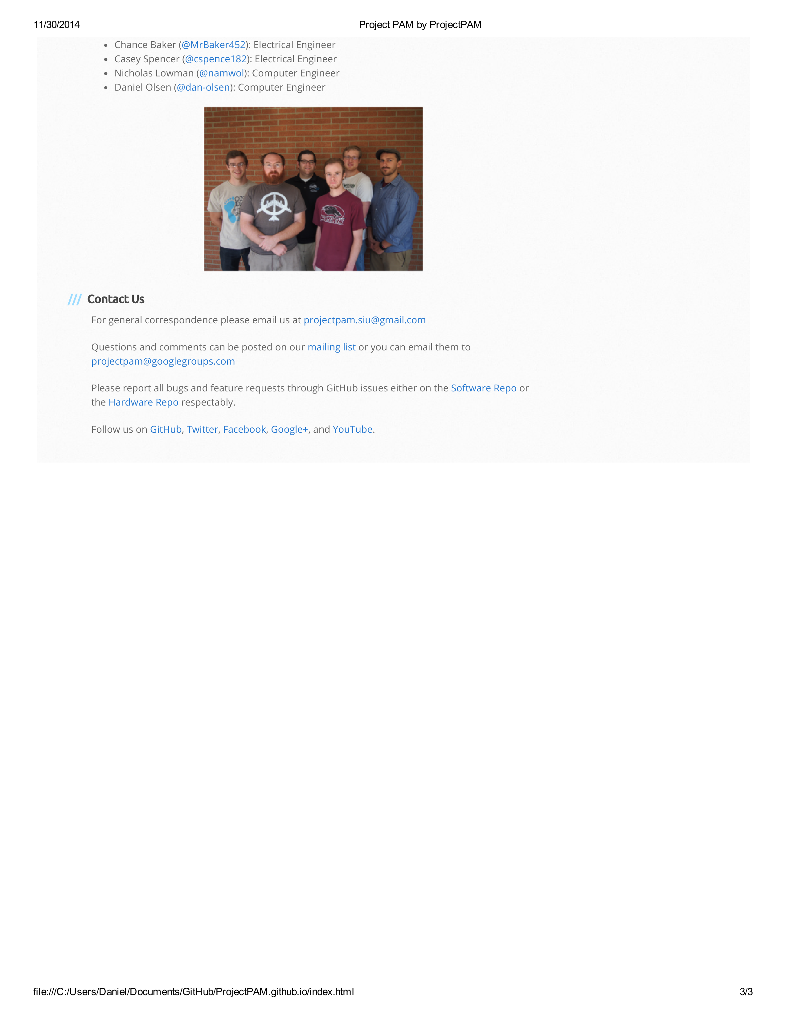
DesignReport/Appendix/Images/ProjectPAM_github_io3.png
