dan-olsen/SeniorDesign/DesignReport/Appendix/Images/ProjectPAM_github_io-Hardware.png

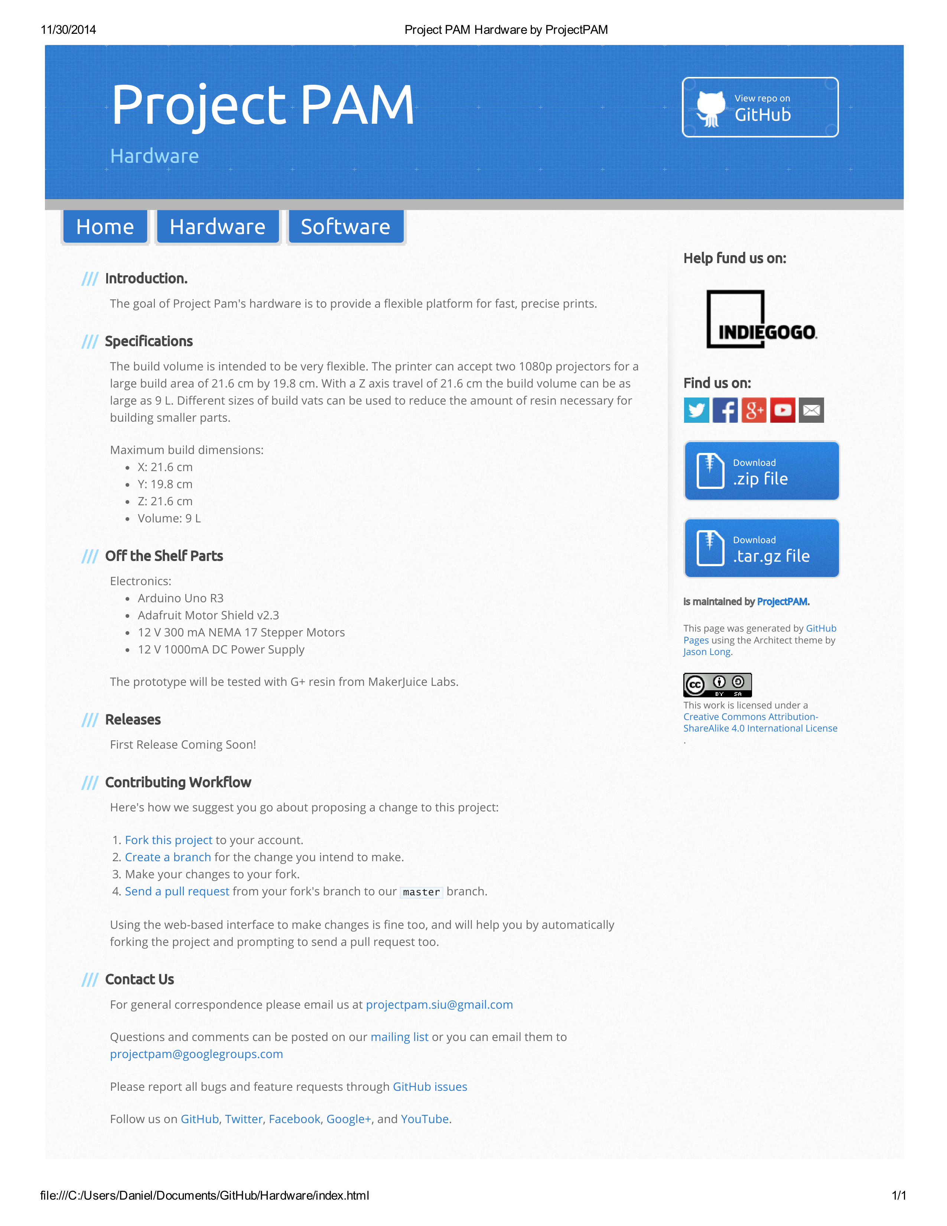
DesignReport/Appendix/Images/ProjectPAM_github_io-Hardware.png
