dan-olsen/SeniorDesign/DesignReport/Appendix/Images/ProjectPAM_github_io-Software.png

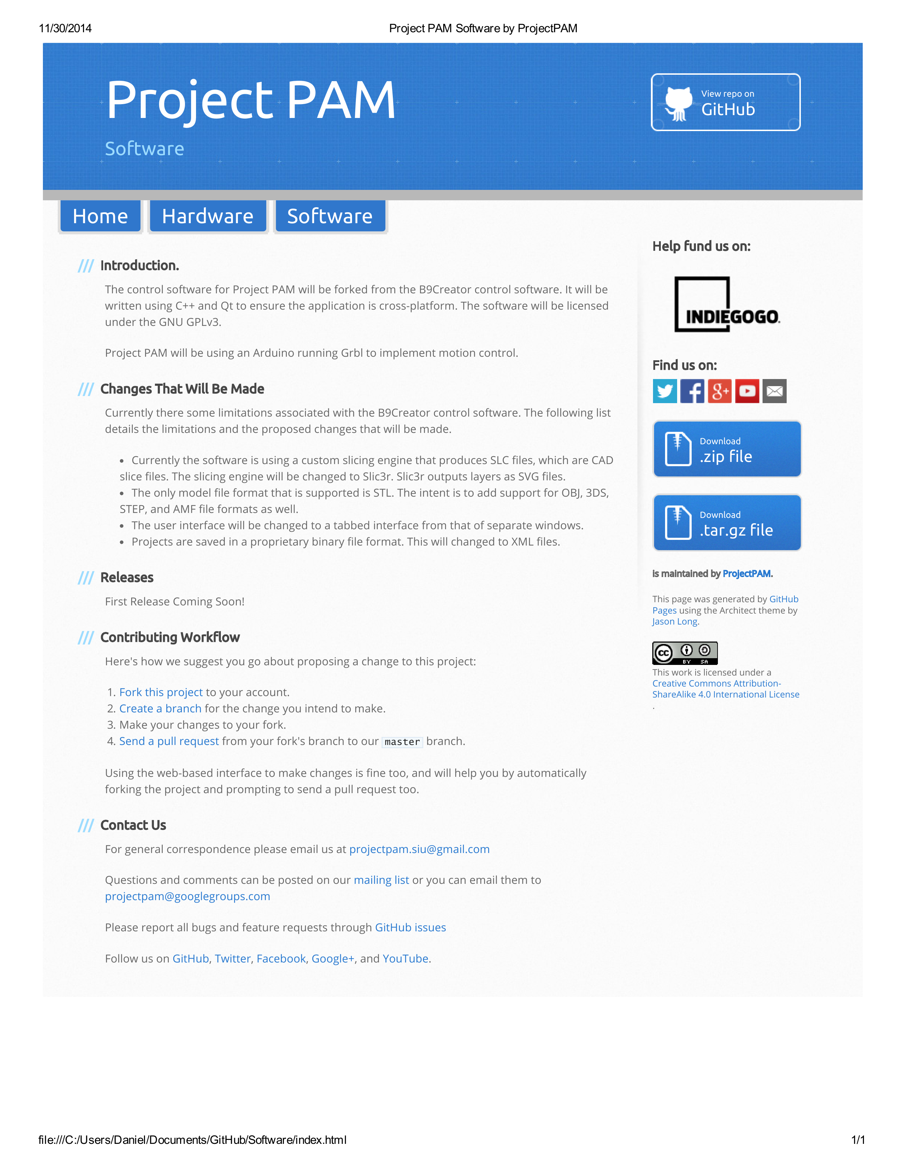
DesignReport/Appendix/Images/ProjectPAM_github_io-Software.png
