dan-olsen/SeniorDesign/DesignReport/Appendix/Images/ProjectPAMPrezi03.png

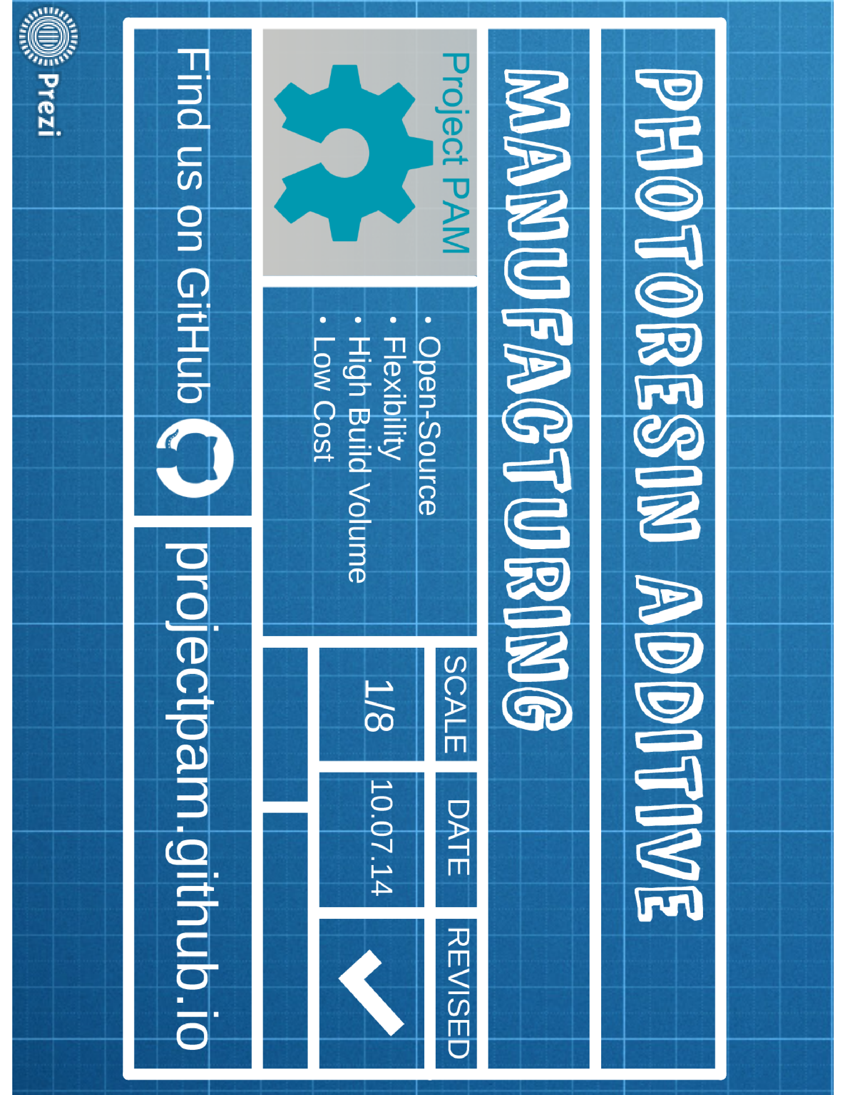
DesignReport/Appendix/Images/ProjectPAMPrezi03.png
