dan-olsen/SeniorDesign/DesignReport/Appendix/Images/ProjectPAMPrezi04.png

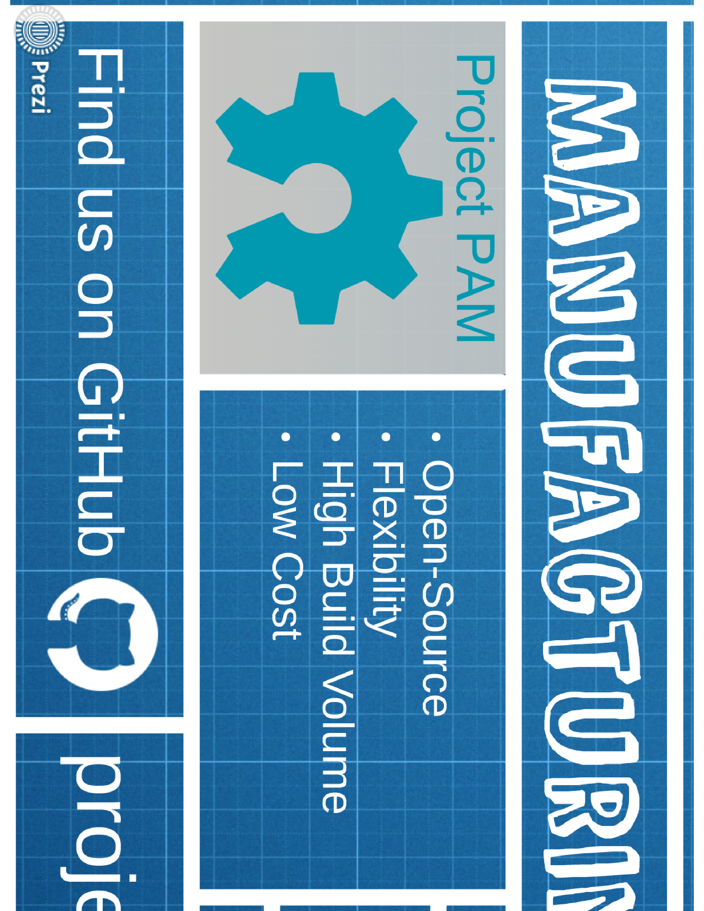
DesignReport/Appendix/Images/ProjectPAMPrezi04.png
