dan-olsen/SeniorDesign/DesignReport/Appendix/Images/ProjectPAMPrezi05.png

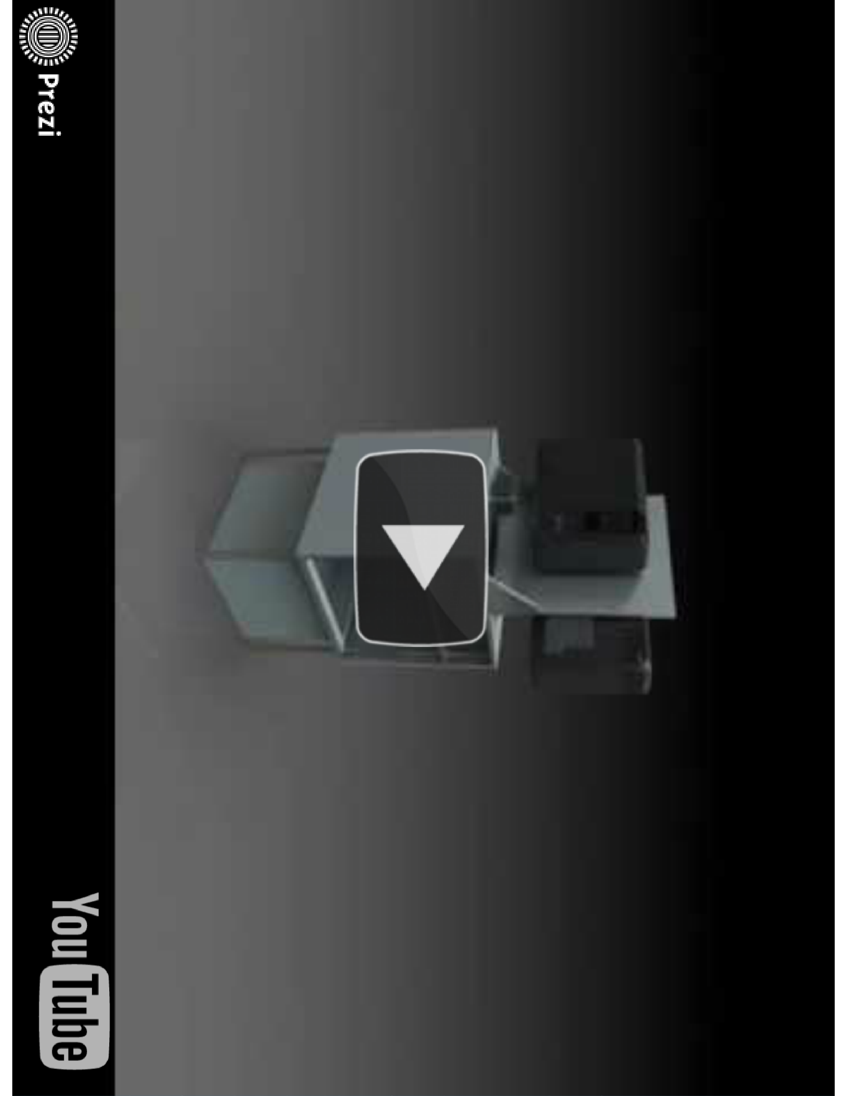
DesignReport/Appendix/Images/ProjectPAMPrezi05.png
