dan-olsen/SeniorDesign/DesignReport/Appendix/Images/ProjectPAMPrezi06.png

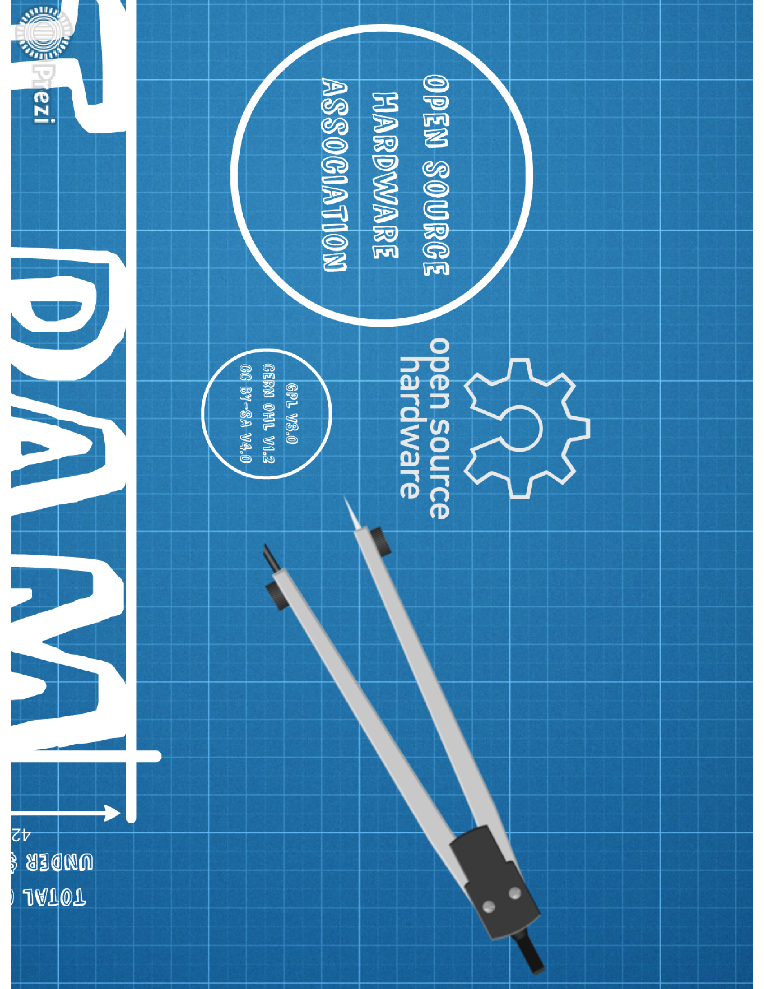
DesignReport/Appendix/Images/ProjectPAMPrezi06.png
