dan-olsen/SeniorDesign/DesignReport/Appendix/Images/ProjectPAMPrezi07.png

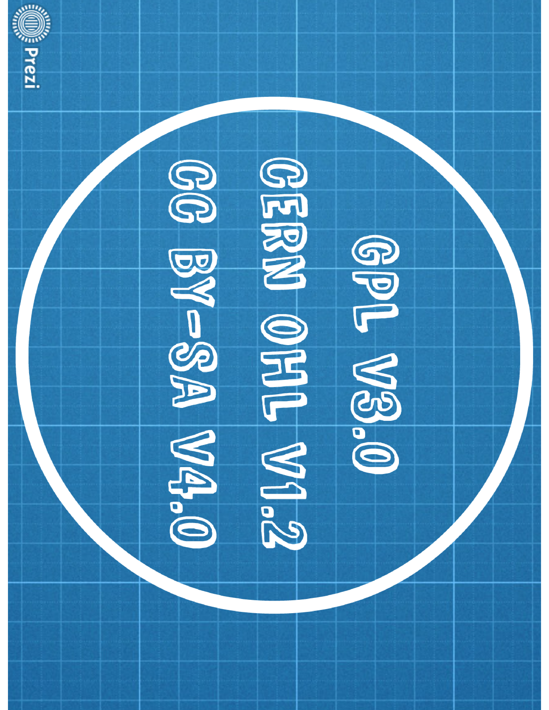
DesignReport/Appendix/Images/ProjectPAMPrezi07.png
