dan-olsen/SeniorDesign/DesignReport/Appendix/Images/ProjectPAMPrezi08.png

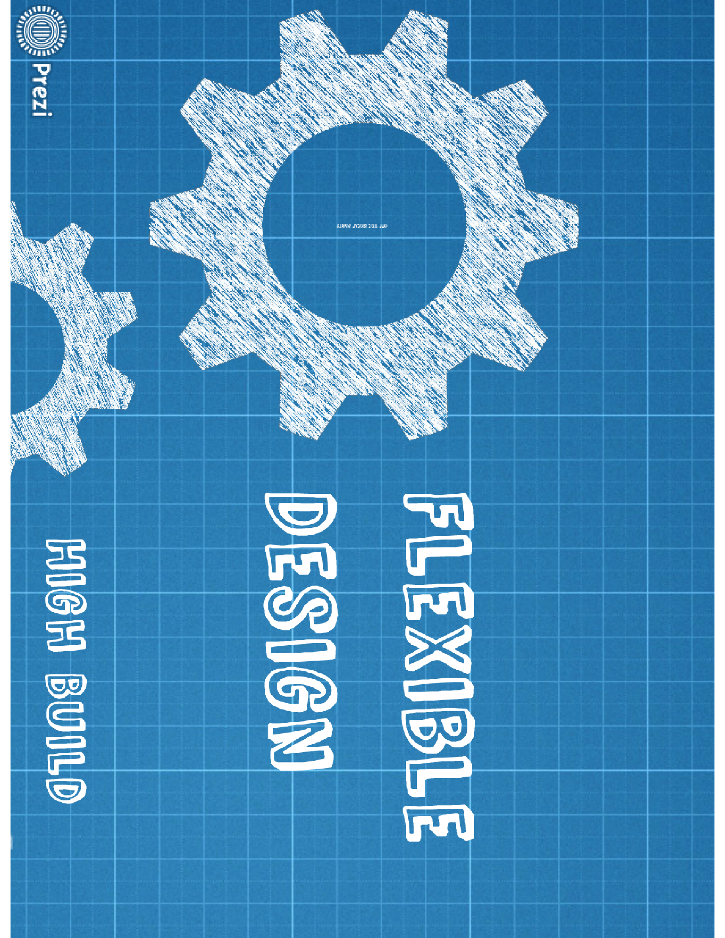
DesignReport/Appendix/Images/ProjectPAMPrezi08.png
