dan-olsen/SeniorDesign/DesignReport/Appendix/Images/ProjectPAMPrezi09.png

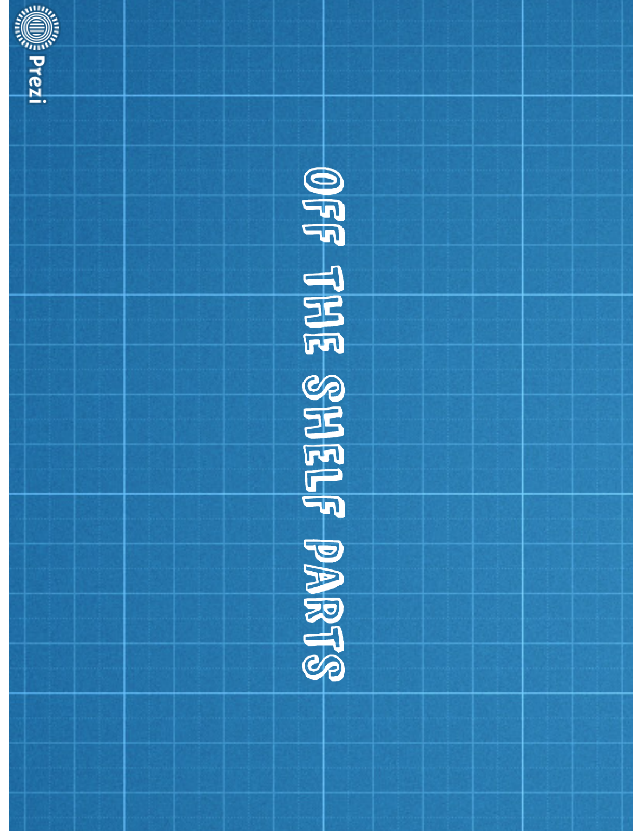
DesignReport/Appendix/Images/ProjectPAMPrezi09.png
