dan-olsen/SeniorDesign/DesignReport/Appendix/Images/ProjectPAMPrezi10.png

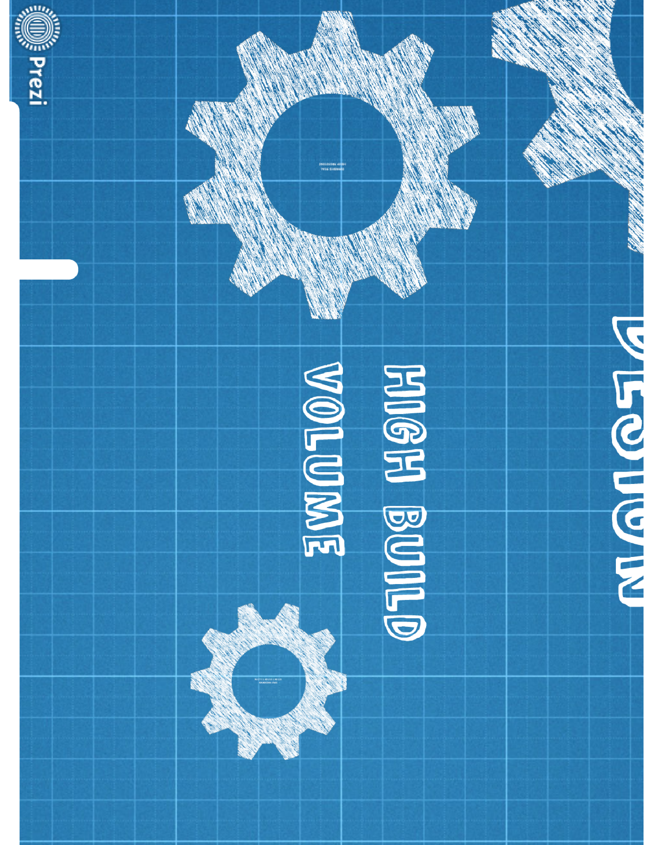
DesignReport/Appendix/Images/ProjectPAMPrezi10.png
