dan-olsen/SeniorDesign/DesignReport/Appendix/Images/ProjectPAMPrezi11.png

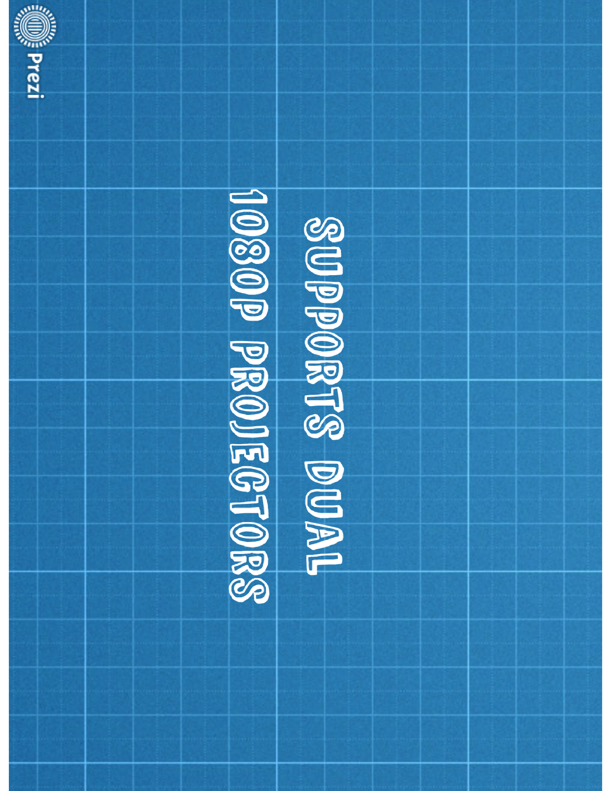
DesignReport/Appendix/Images/ProjectPAMPrezi11.png
