dan-olsen/SeniorDesign/DesignReport/Appendix/Images/ProjectPAMPrezi12.png

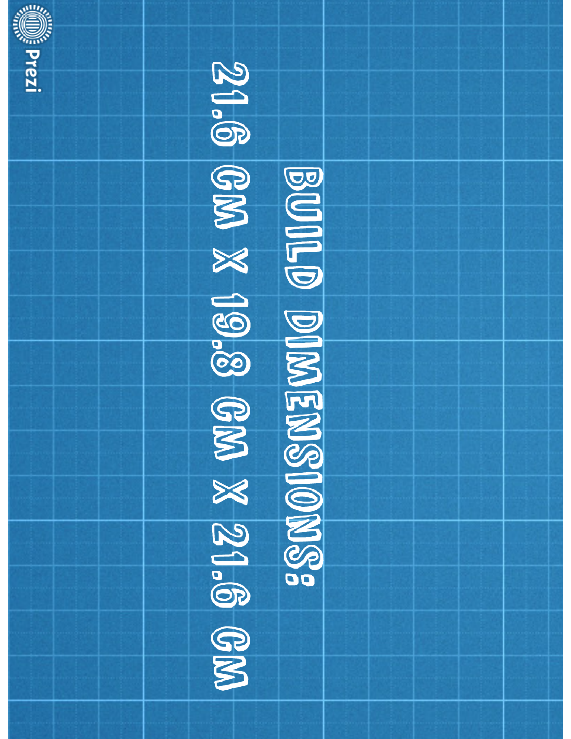
DesignReport/Appendix/Images/ProjectPAMPrezi12.png
