dan-olsen/SeniorDesign/DesignReport/Appendix/Images/ProjectPAMPrezi13.png

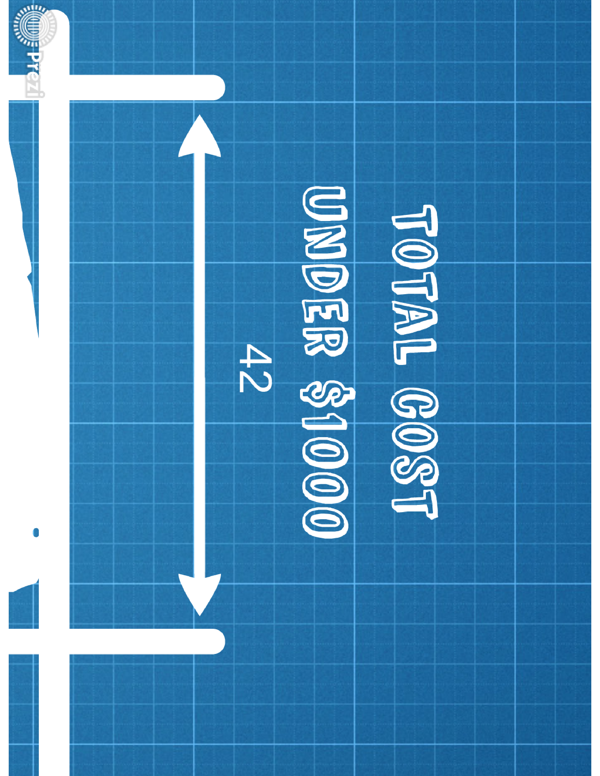
DesignReport/Appendix/Images/ProjectPAMPrezi13.png
