dan-olsen/SeniorDesign/DesignReport/Appendix/Images/Ribbed Vat1.png

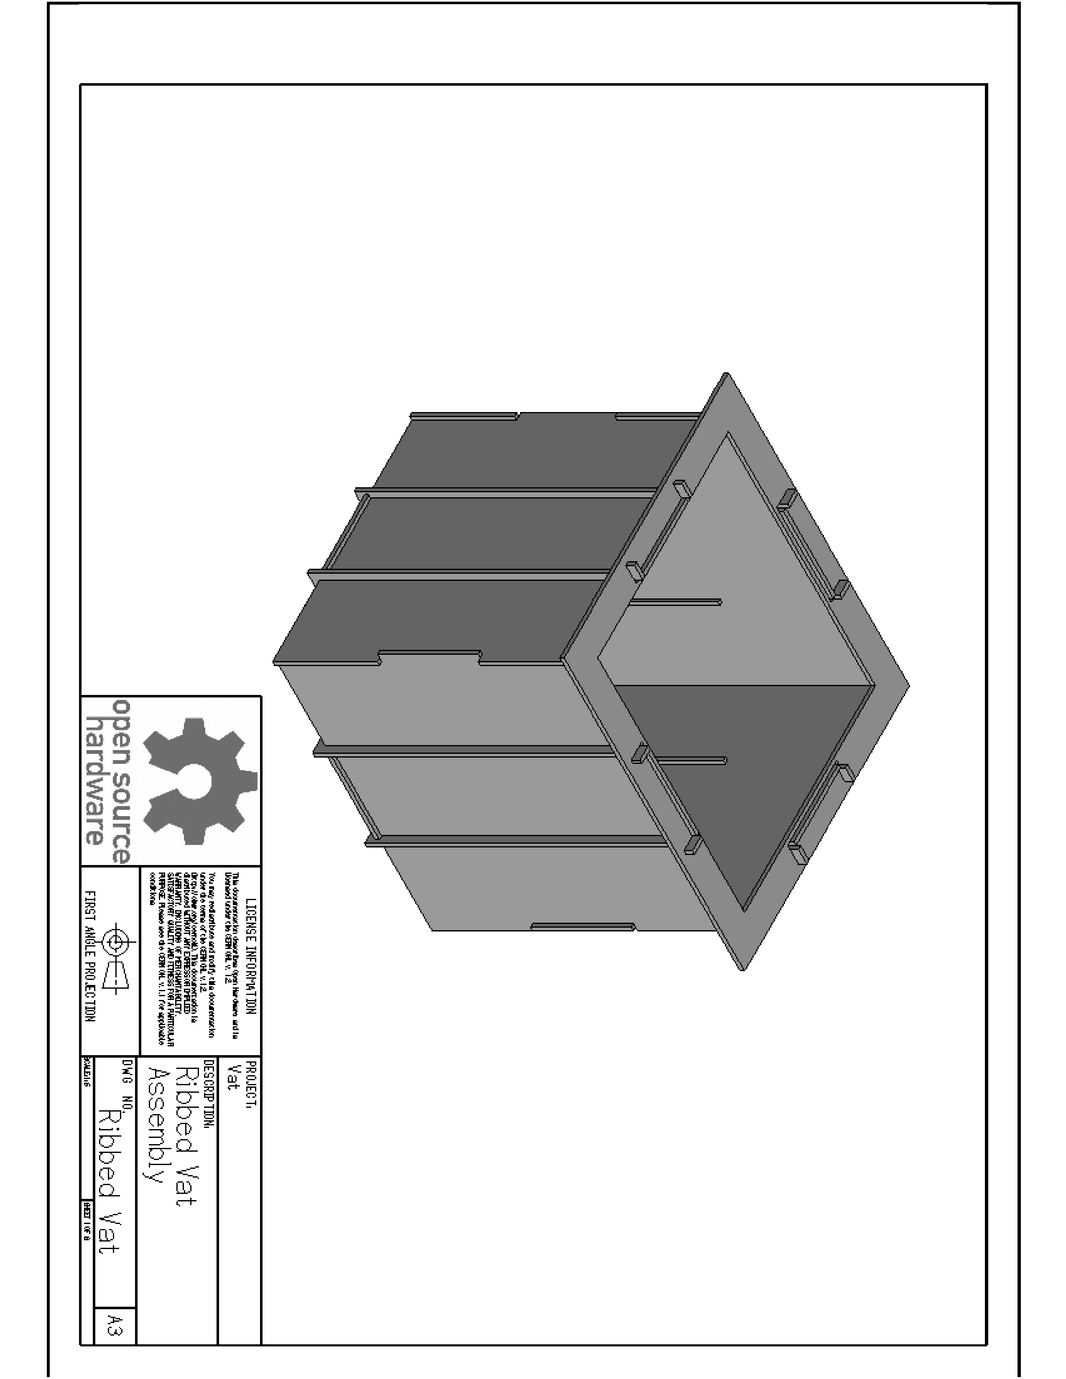
DesignReport/Appendix/Images/Ribbed Vat1.png
