dan-olsen/SeniorDesign/DesignReport/Appendix/Images/Ribbed Vat3.png

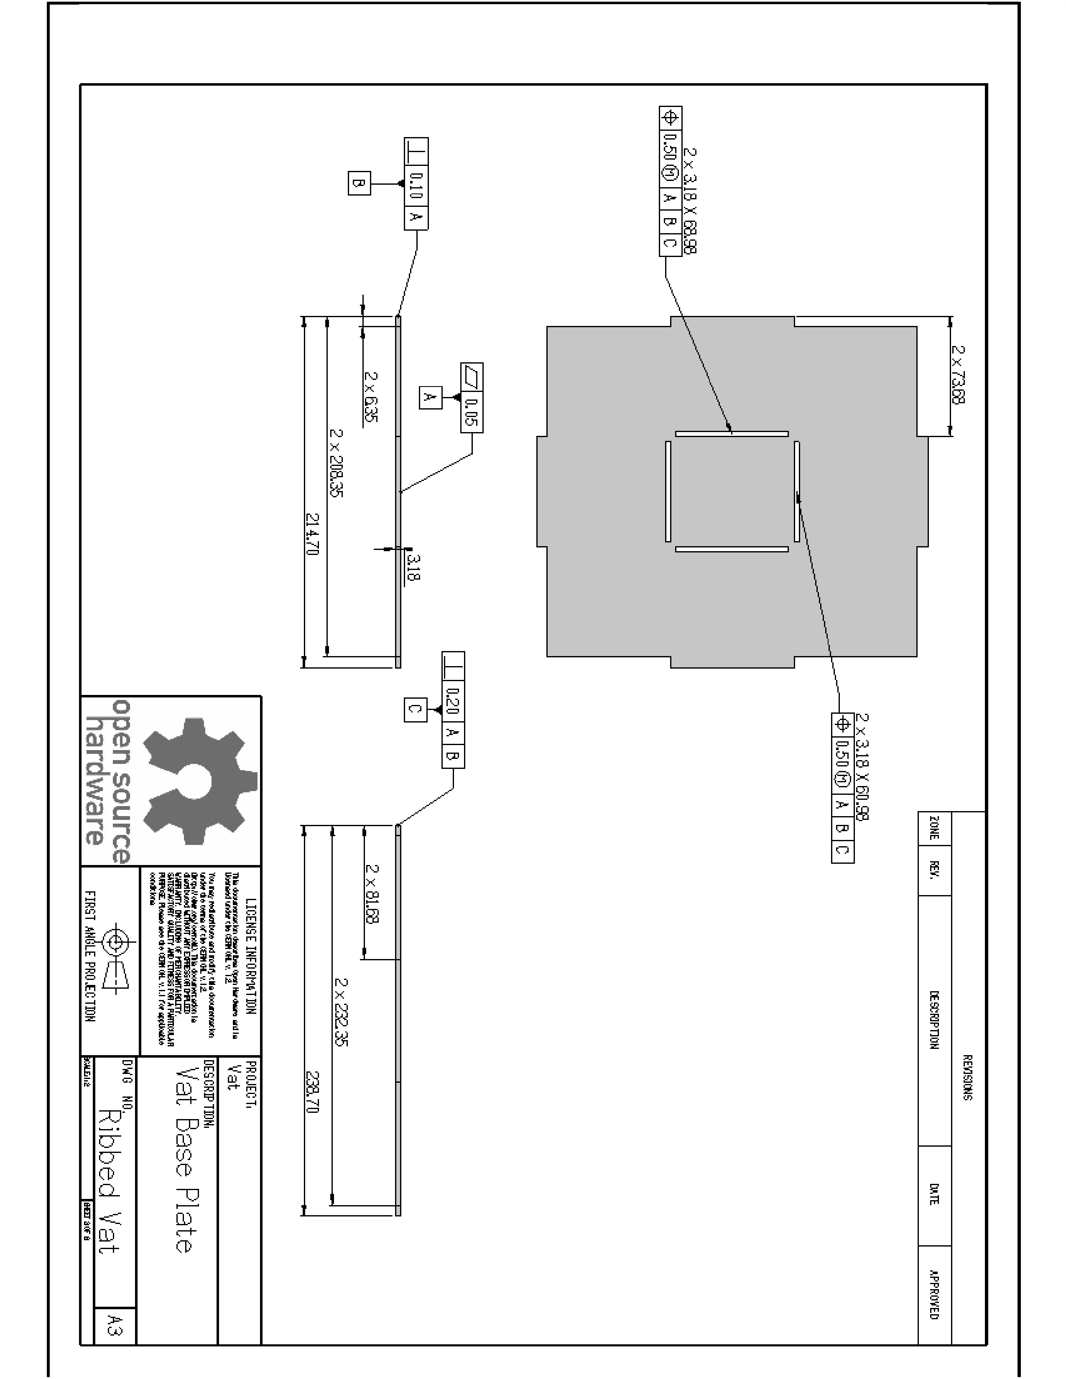
DesignReport/Appendix/Images/Ribbed Vat3.png
