dan-olsen/SeniorDesign/DesignReport/Appendix/Images/Ribbed Vat4.png

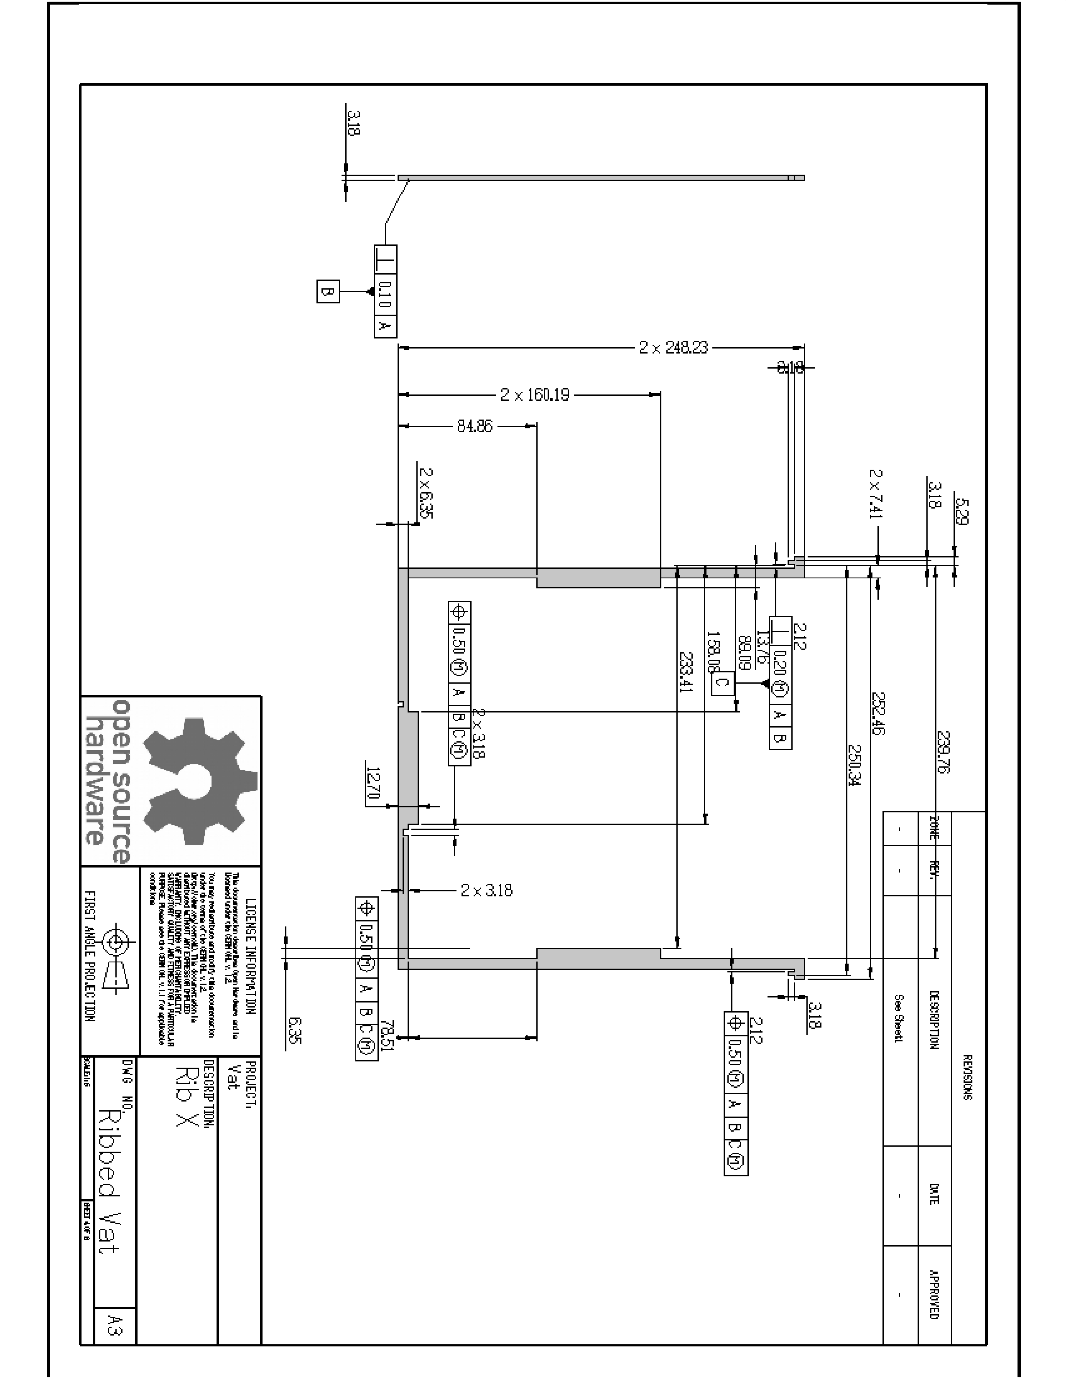
DesignReport/Appendix/Images/Ribbed Vat4.png
