dan-olsen/SeniorDesign/DesignReport/Appendix/Images/Ribbed Vat5.png

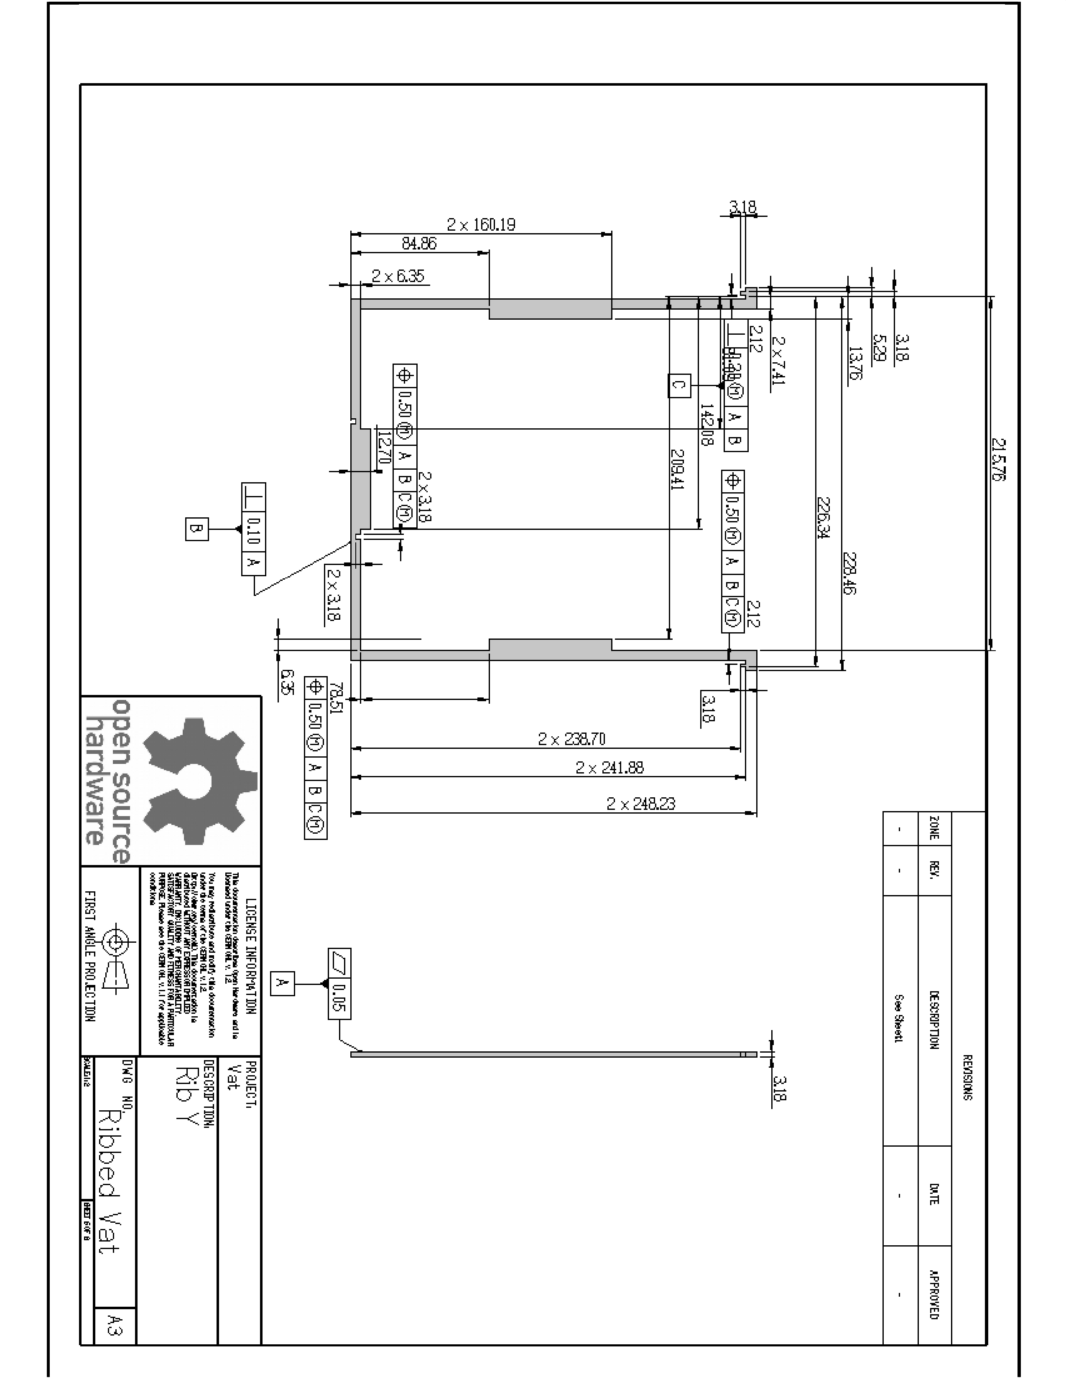
DesignReport/Appendix/Images/Ribbed Vat5.png
