dan-olsen/SeniorDesign/DesignReport/Appendix/Images/Ribbed Vat6.png

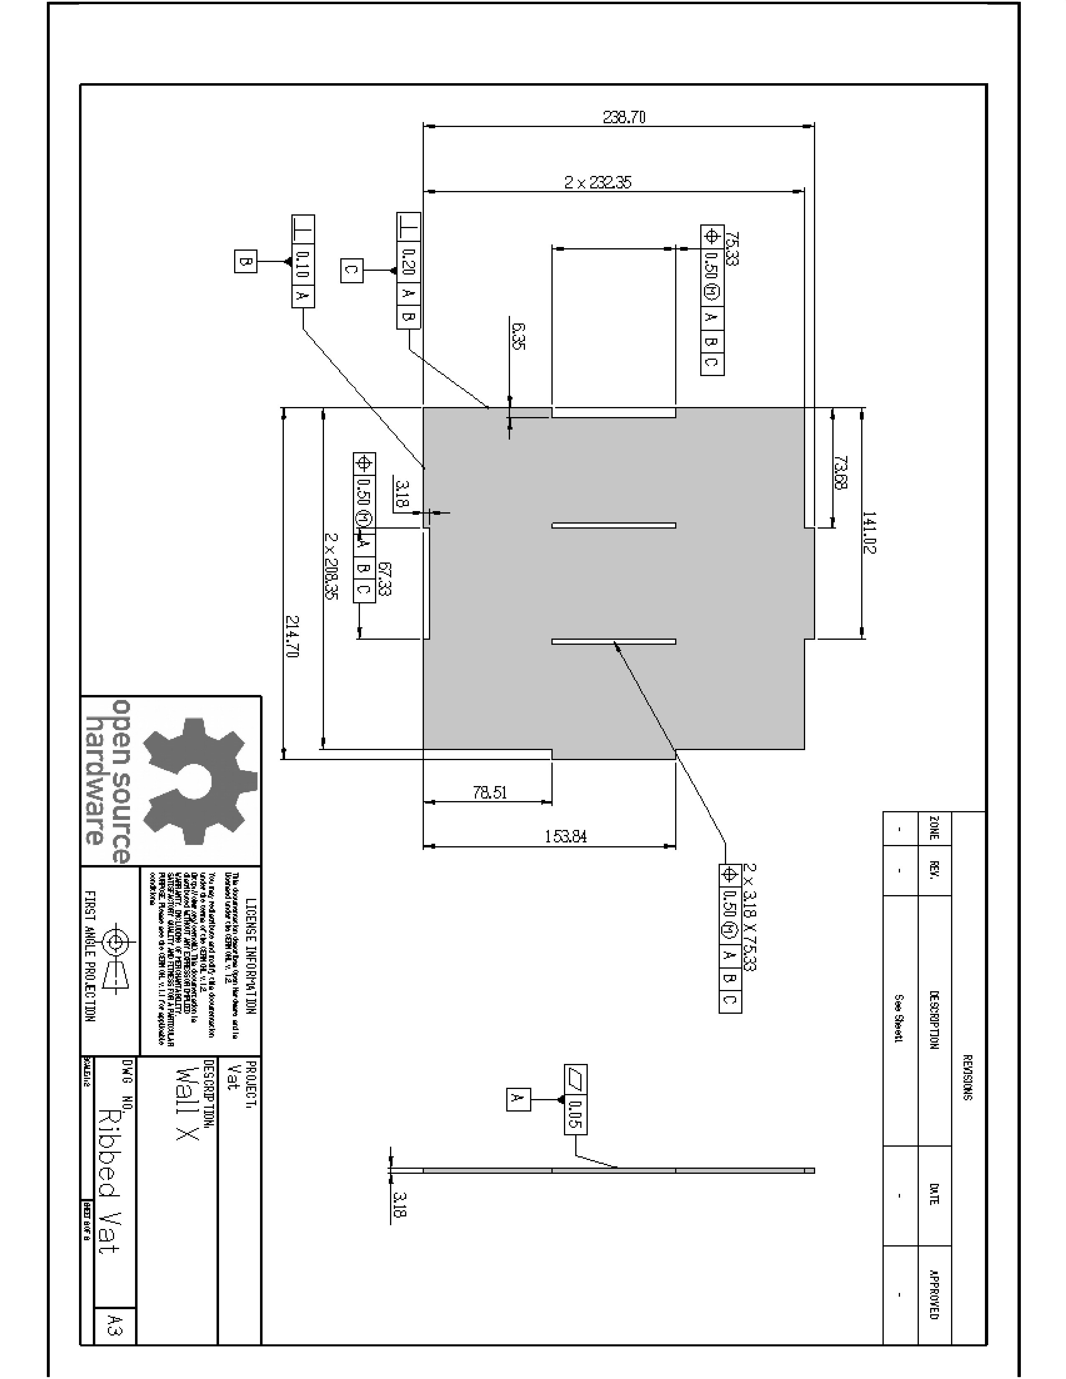
DesignReport/Appendix/Images/Ribbed Vat6.png
