dan-olsen/SeniorDesign/DesignReport/Appendix/Images/Ribbed Vat7.png

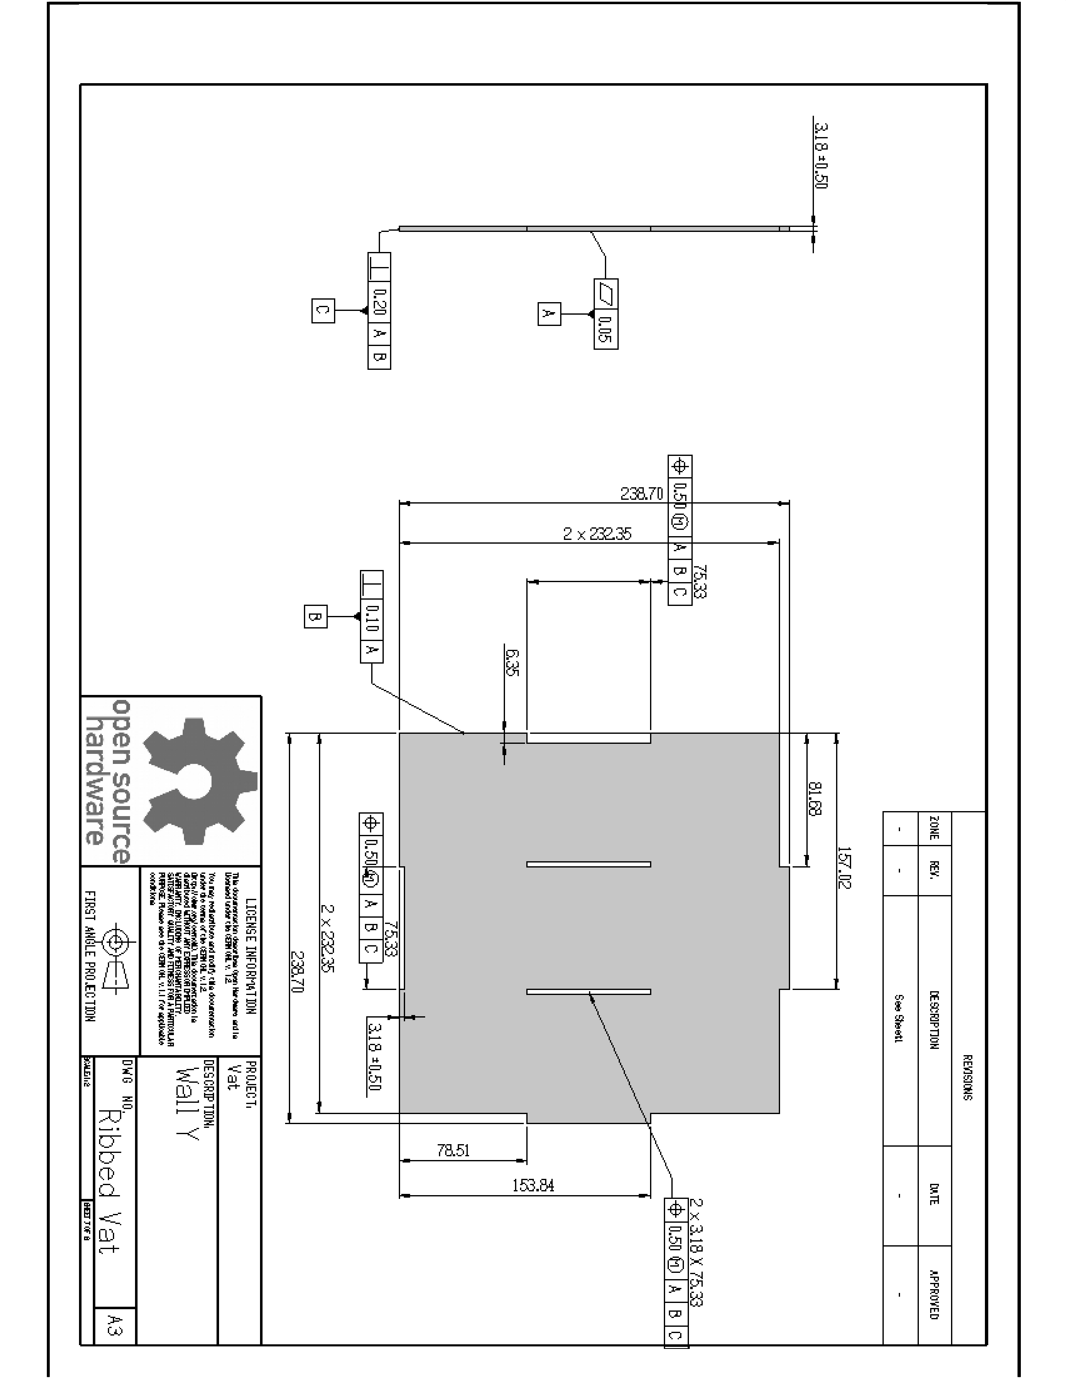
DesignReport/Appendix/Images/Ribbed Vat7.png
