dan-olsen/SeniorDesign/DesignReport/Appendix/Images/Ribbed Vat8.png

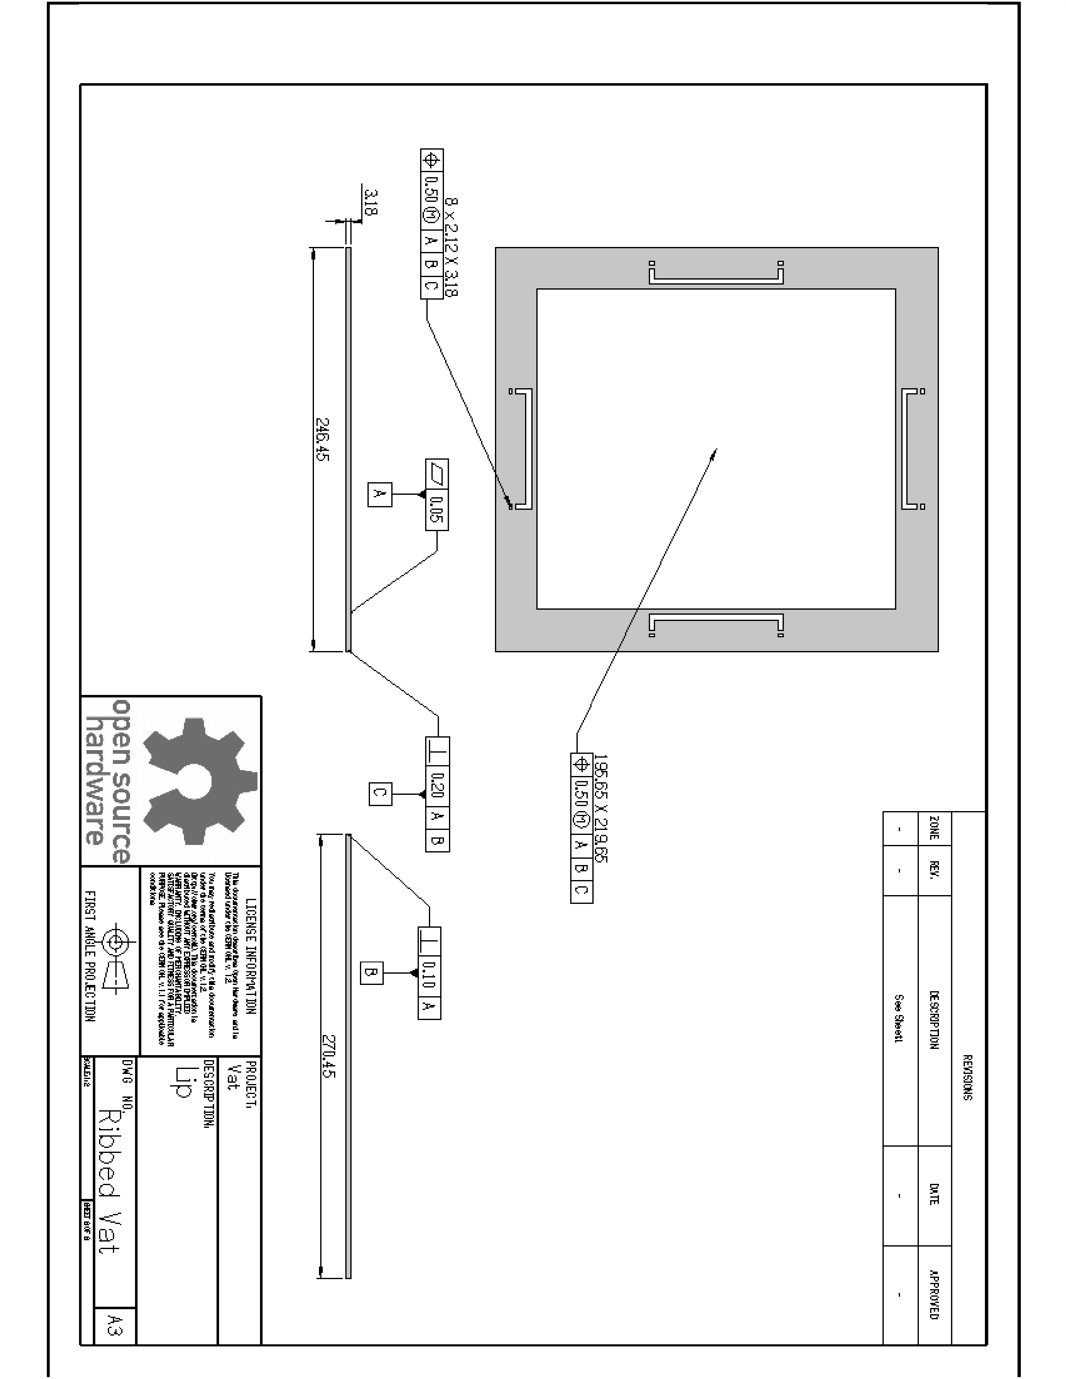
DesignReport/Appendix/Images/Ribbed Vat8.png
