dan-olsen/SeniorDesign/DesignReport/Appendix/Images/SubGPlus-MSDS1.png

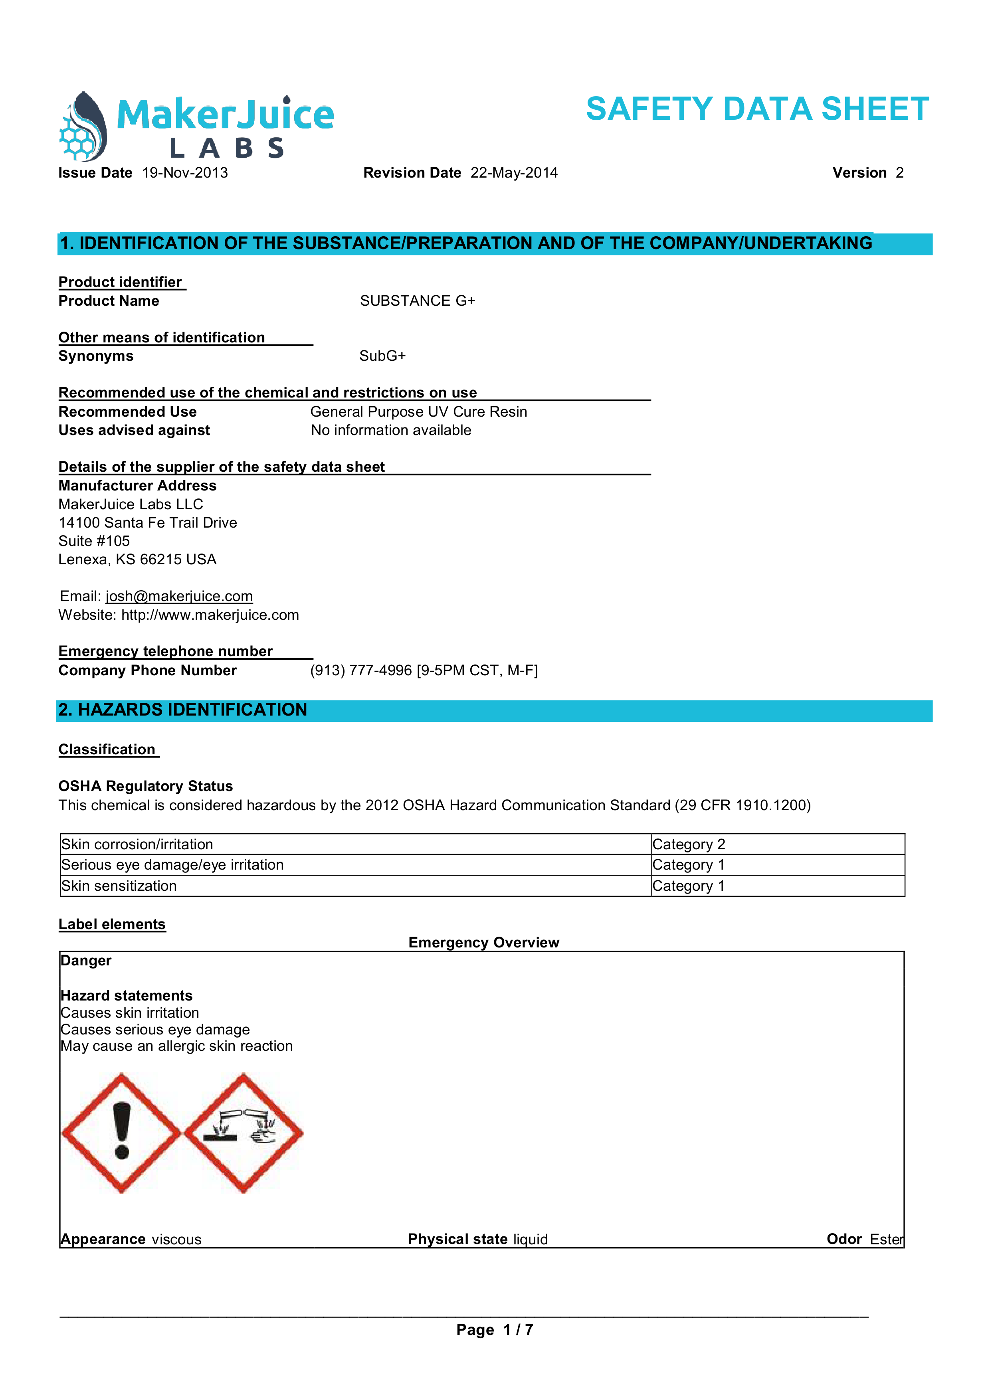
DesignReport/Appendix/Images/SubGPlus-MSDS1.png
