dan-olsen/SeniorDesign/DesignReport/Appendix/Images/SubGPlus-MSDS2.png

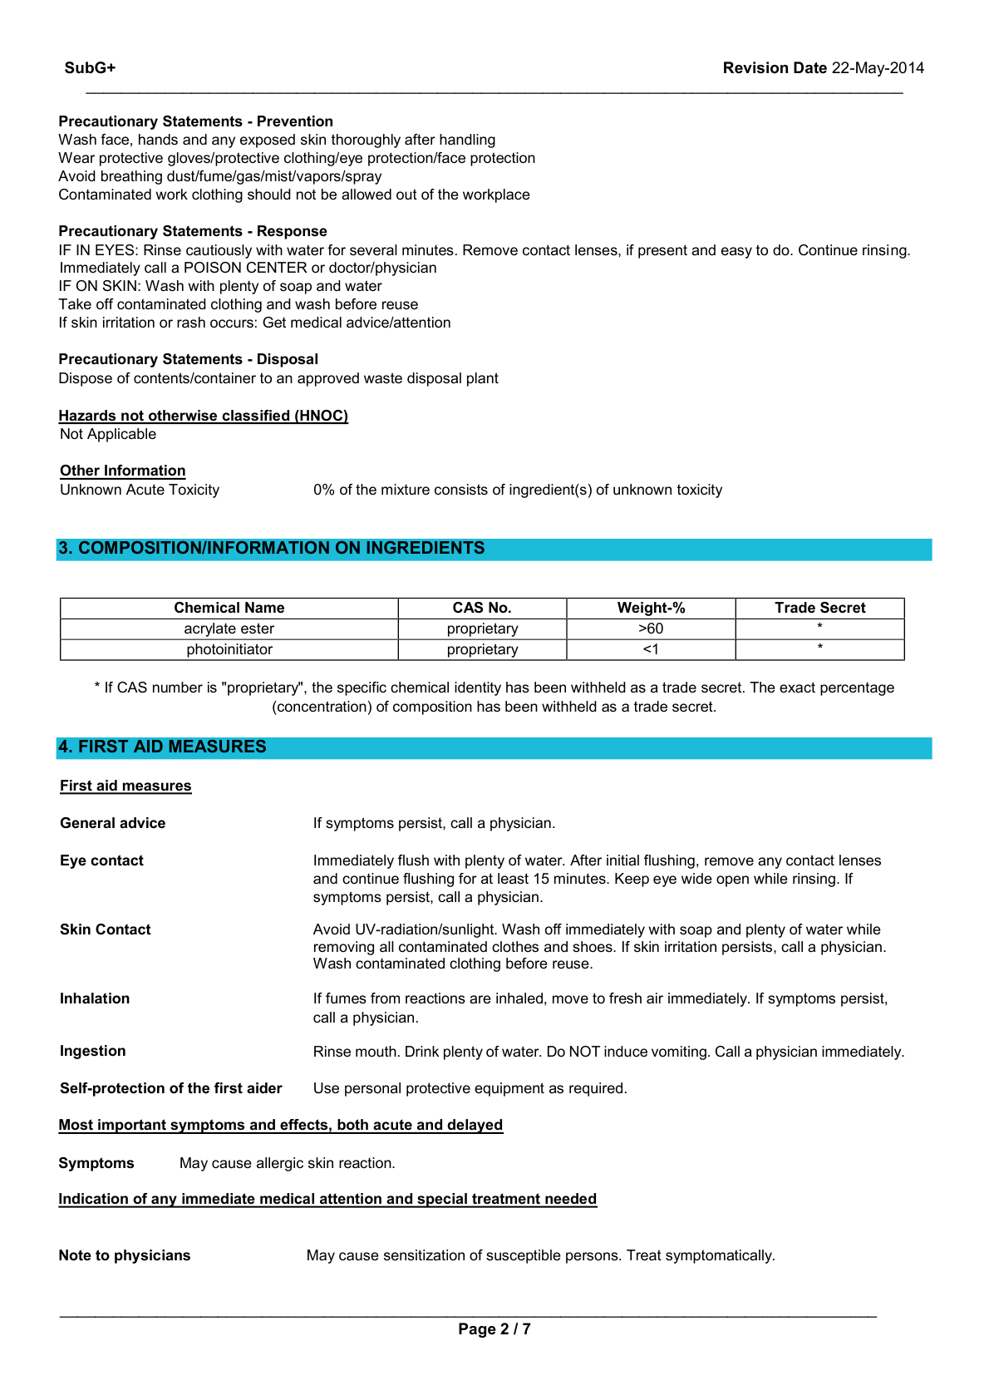
DesignReport/Appendix/Images/SubGPlus-MSDS2.png
