dan-olsen/SeniorDesign/DesignReport/Appendix/Images/SubGPlus-MSDS3.png

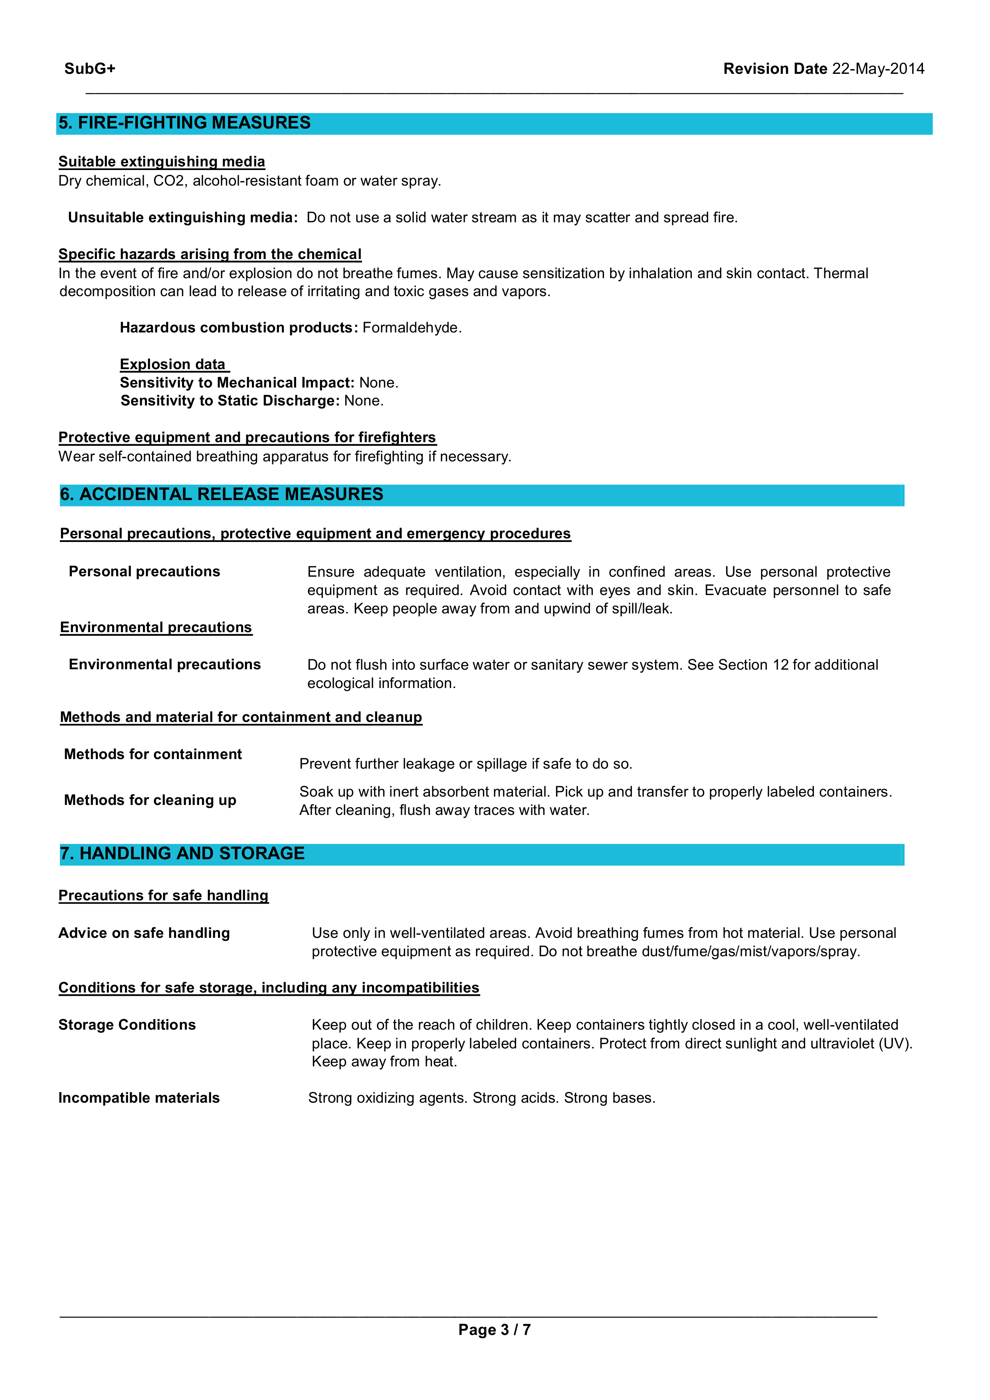
DesignReport/Appendix/Images/SubGPlus-MSDS3.png
