dan-olsen/SeniorDesign/DesignReport/Appendix/Images/SubGPlus-MSDS4.png

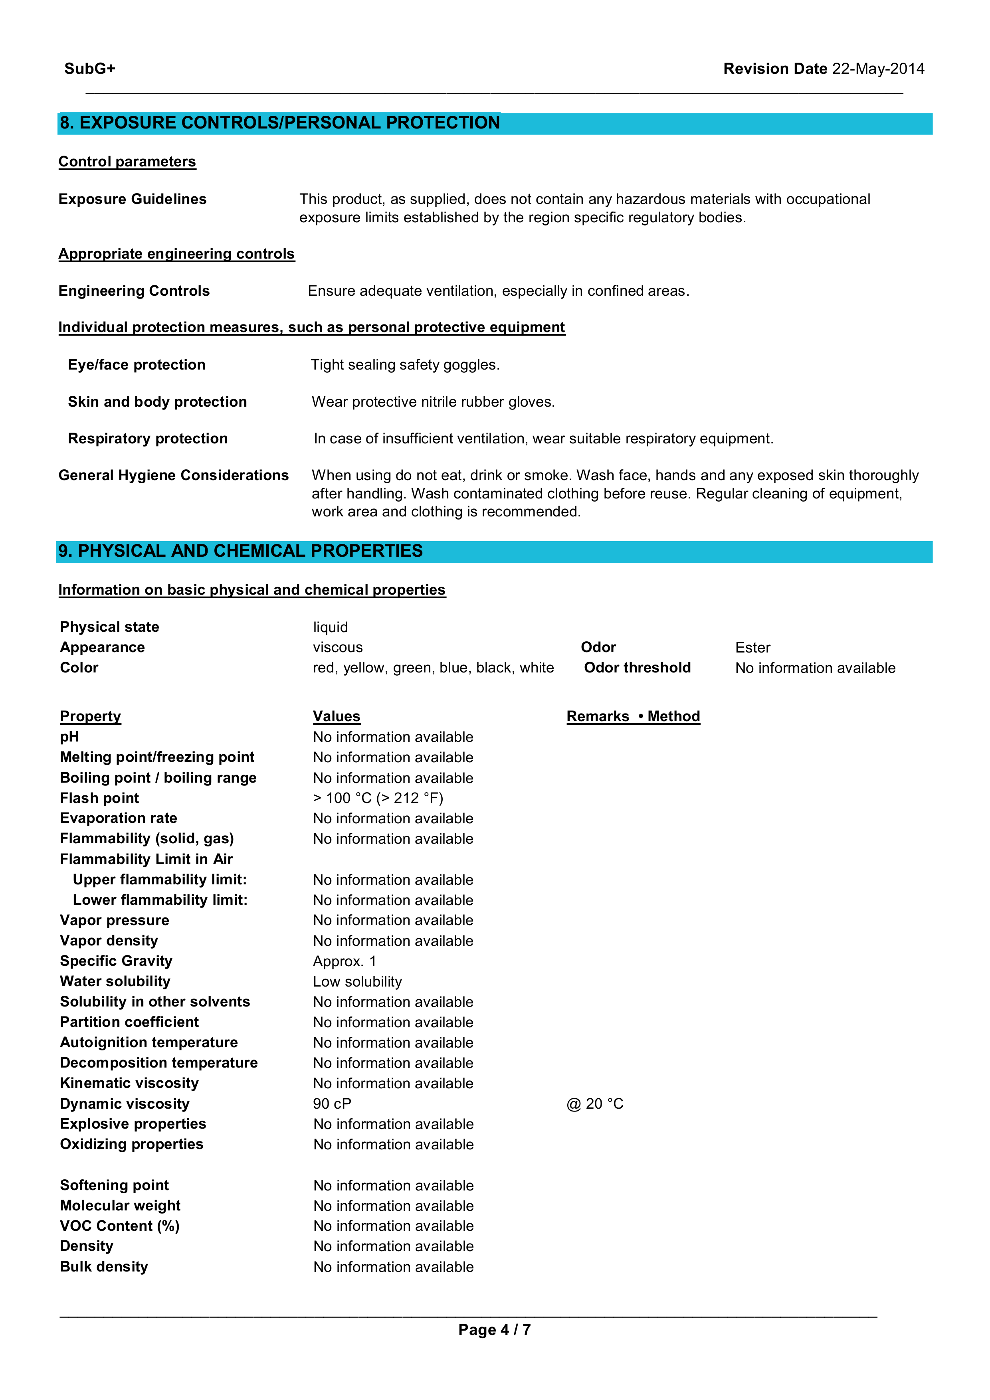
DesignReport/Appendix/Images/SubGPlus-MSDS4.png
