dan-olsen/SeniorDesign/DesignReport/Appendix/Images/SubGPlus-MSDS5.png

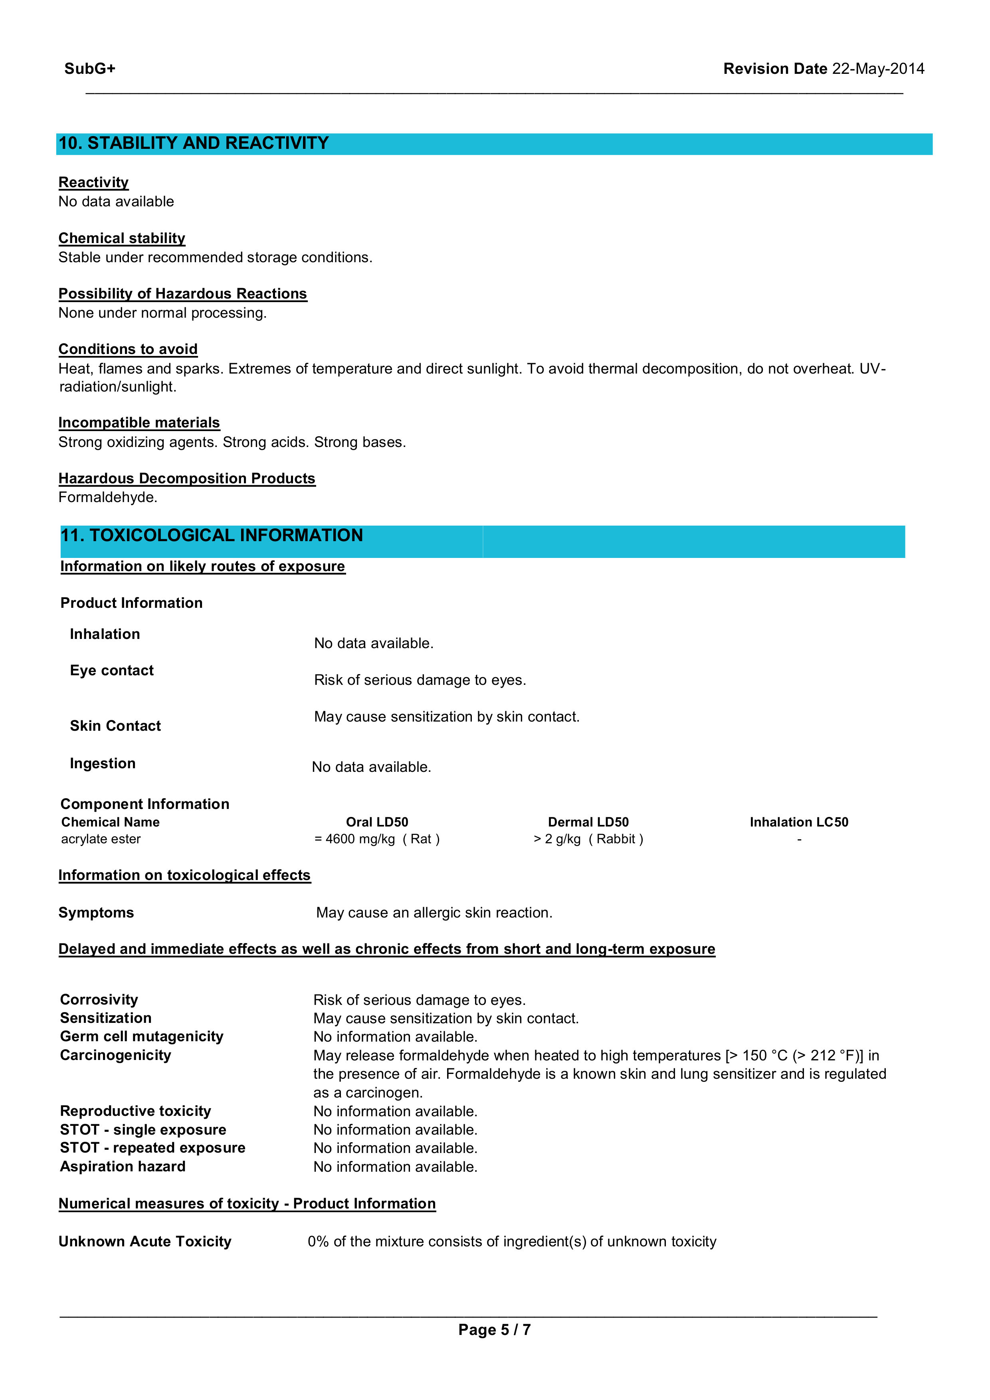
DesignReport/Appendix/Images/SubGPlus-MSDS5.png
