dan-olsen/SeniorDesign/DesignReport/Appendix/Images/SubGPlus-MSDS6.png

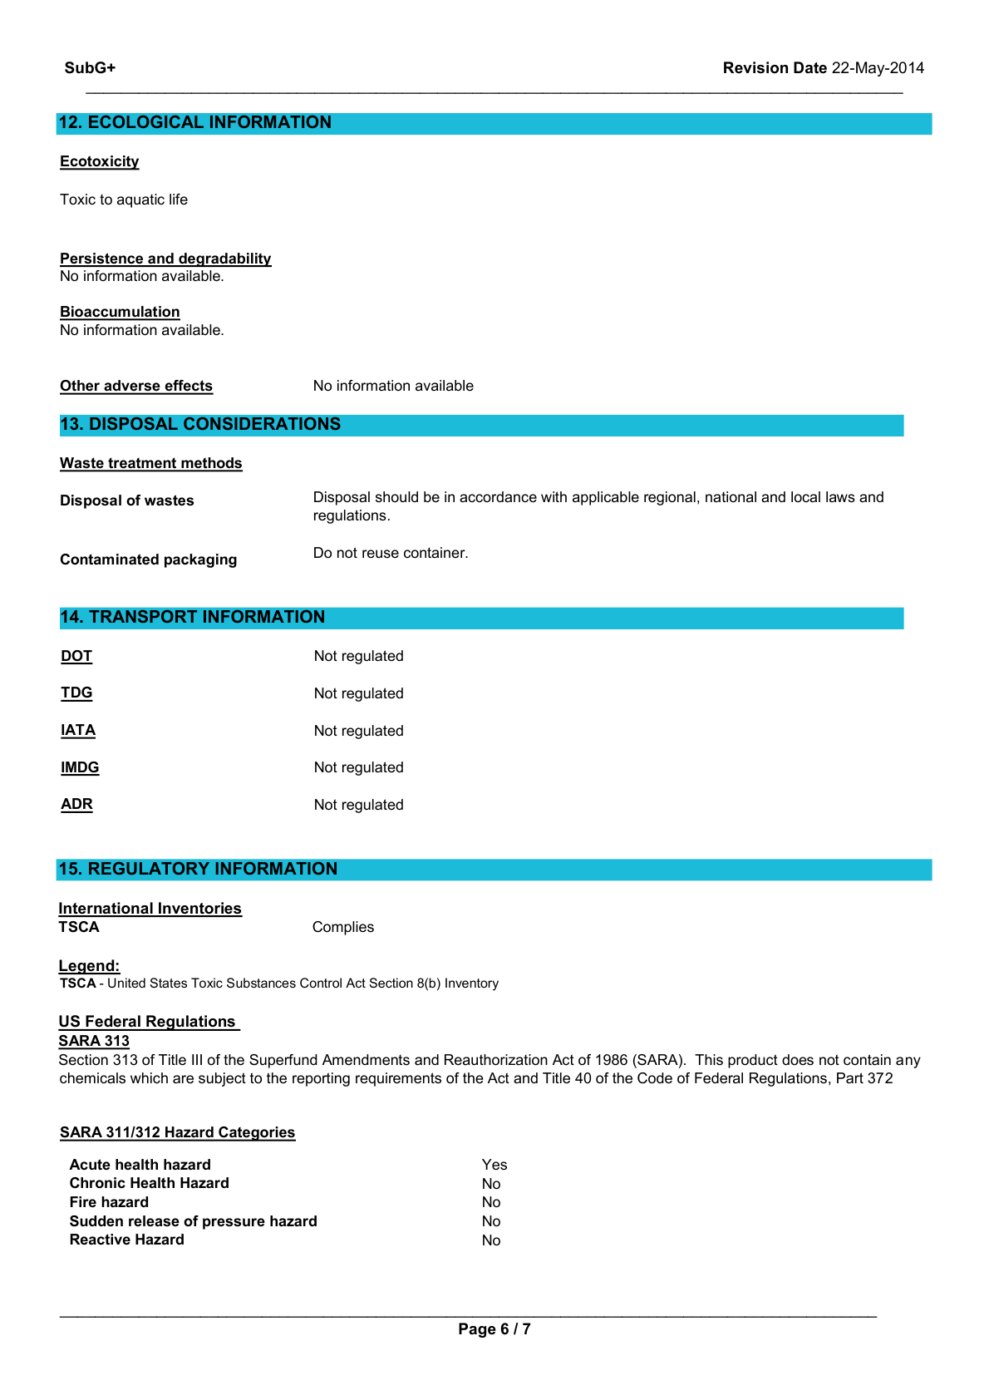
DesignReport/Appendix/Images/SubGPlus-MSDS6.png
