dan-olsen/SeniorDesign/DesignReport/Appendix/Images/SubGPlus-MSDS7.png

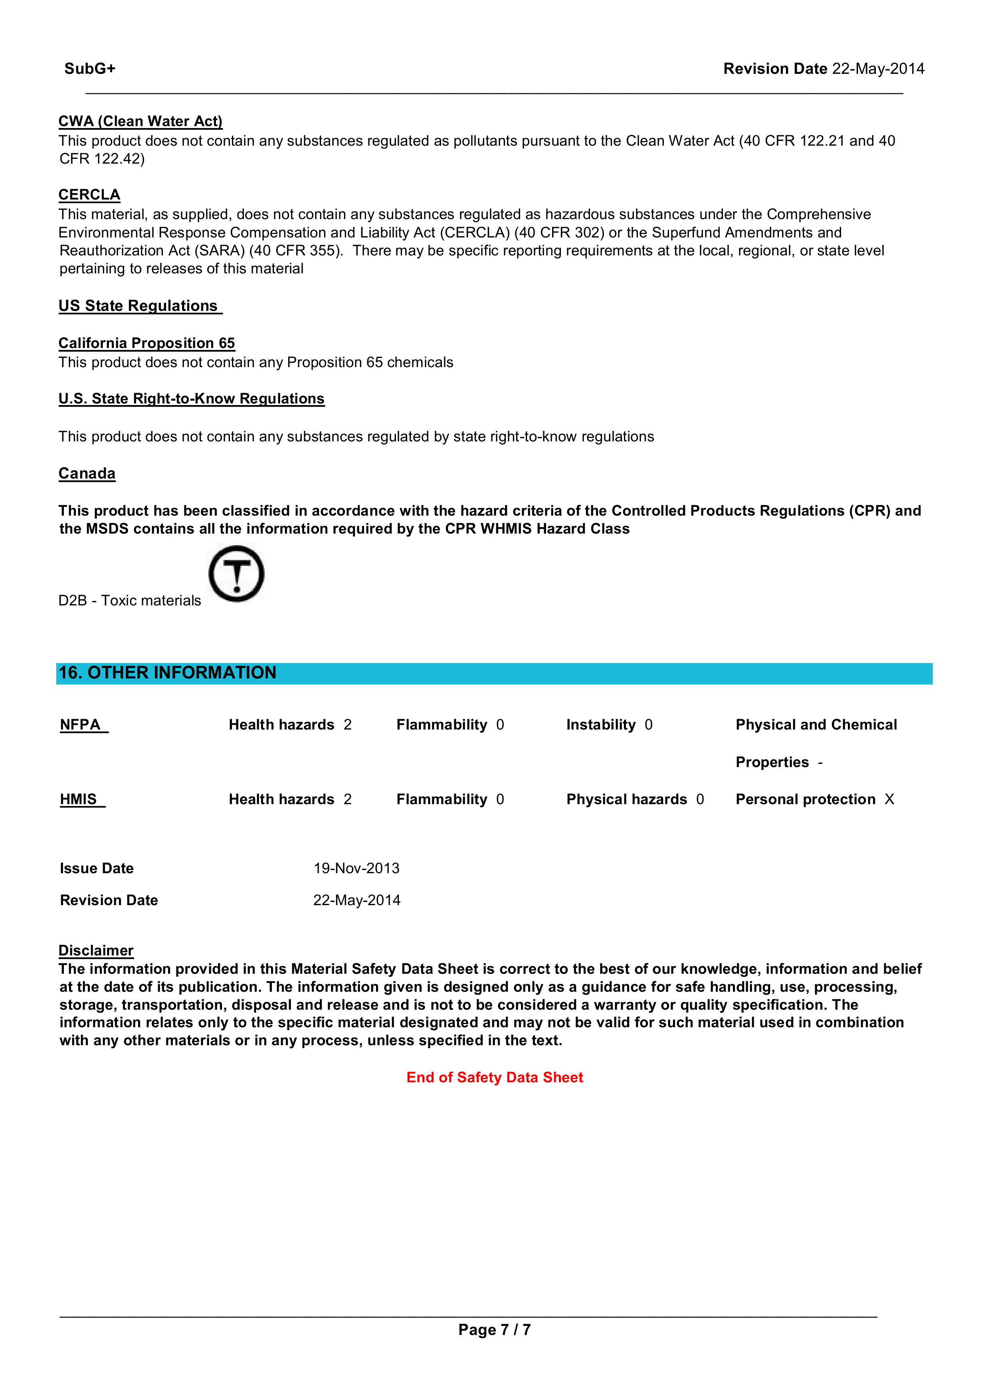
DesignReport/Appendix/Images/SubGPlus-MSDS7.png
