dan-olsen/SeniorDesign/DesignReport/Appendix/Images/SubGPlus-TDS.png

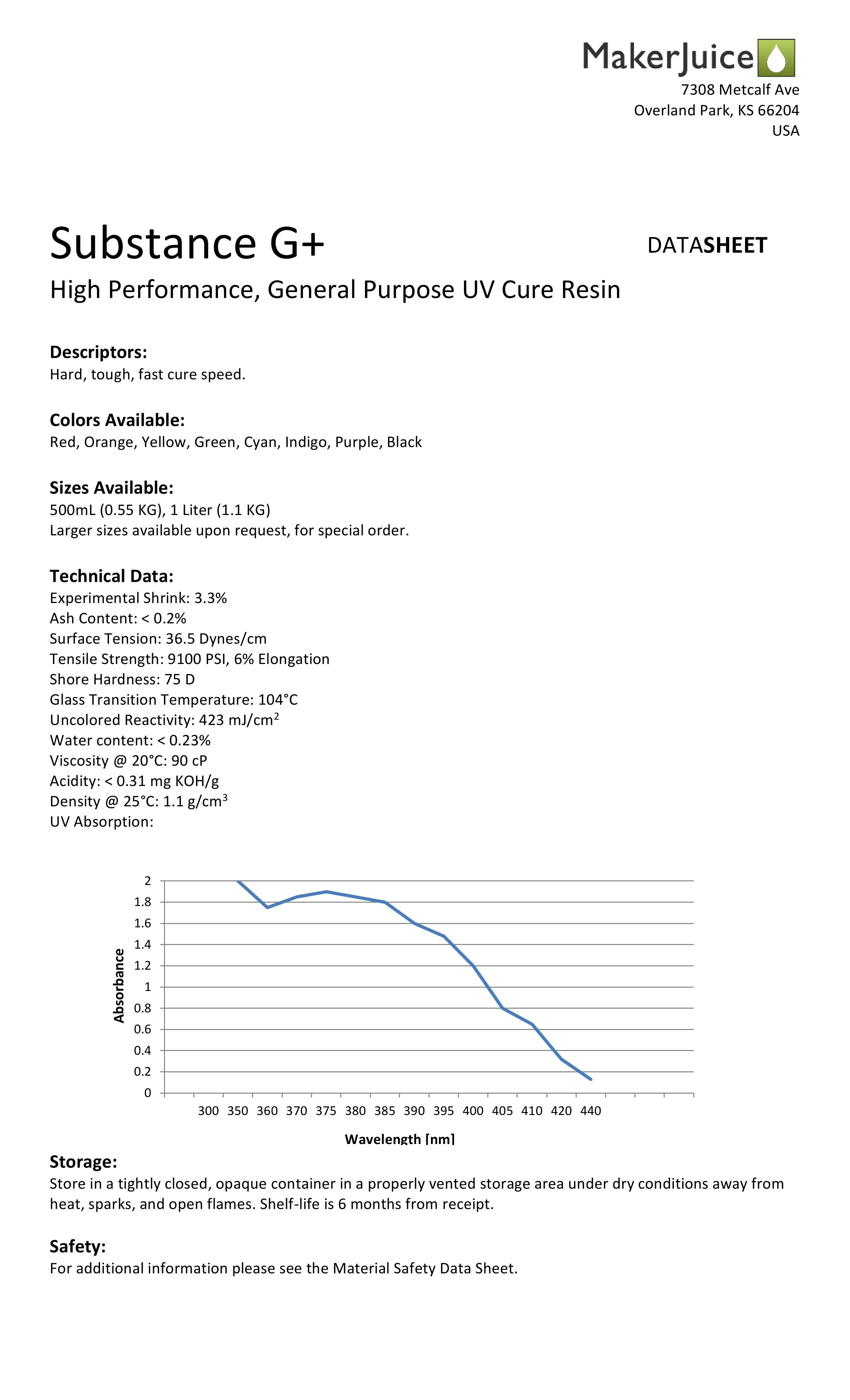
DesignReport/Appendix/Images/SubGPlus-TDS.png
