dan-olsen/SeniorDesign/DesignReport/Appendix/Images/Timeline_75_DMO1.png

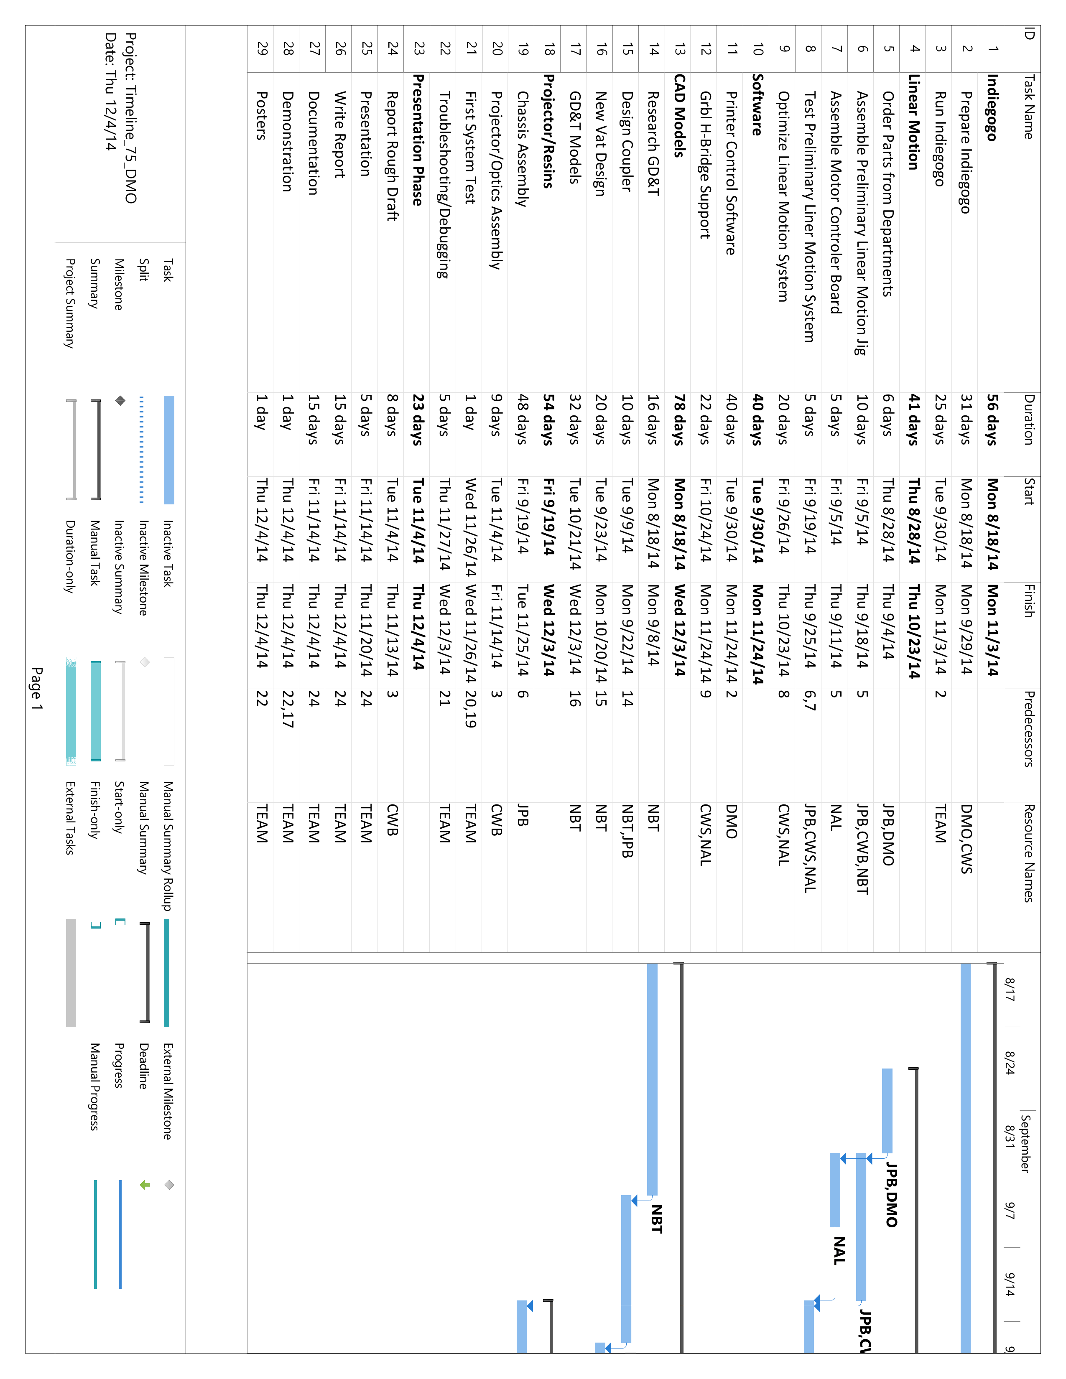
DesignReport/Appendix/Images/Timeline_75_DMO1.png
