dan-olsen/SeniorDesign/DesignReport/Appendix/Images/Timeline_75_DMO2.png

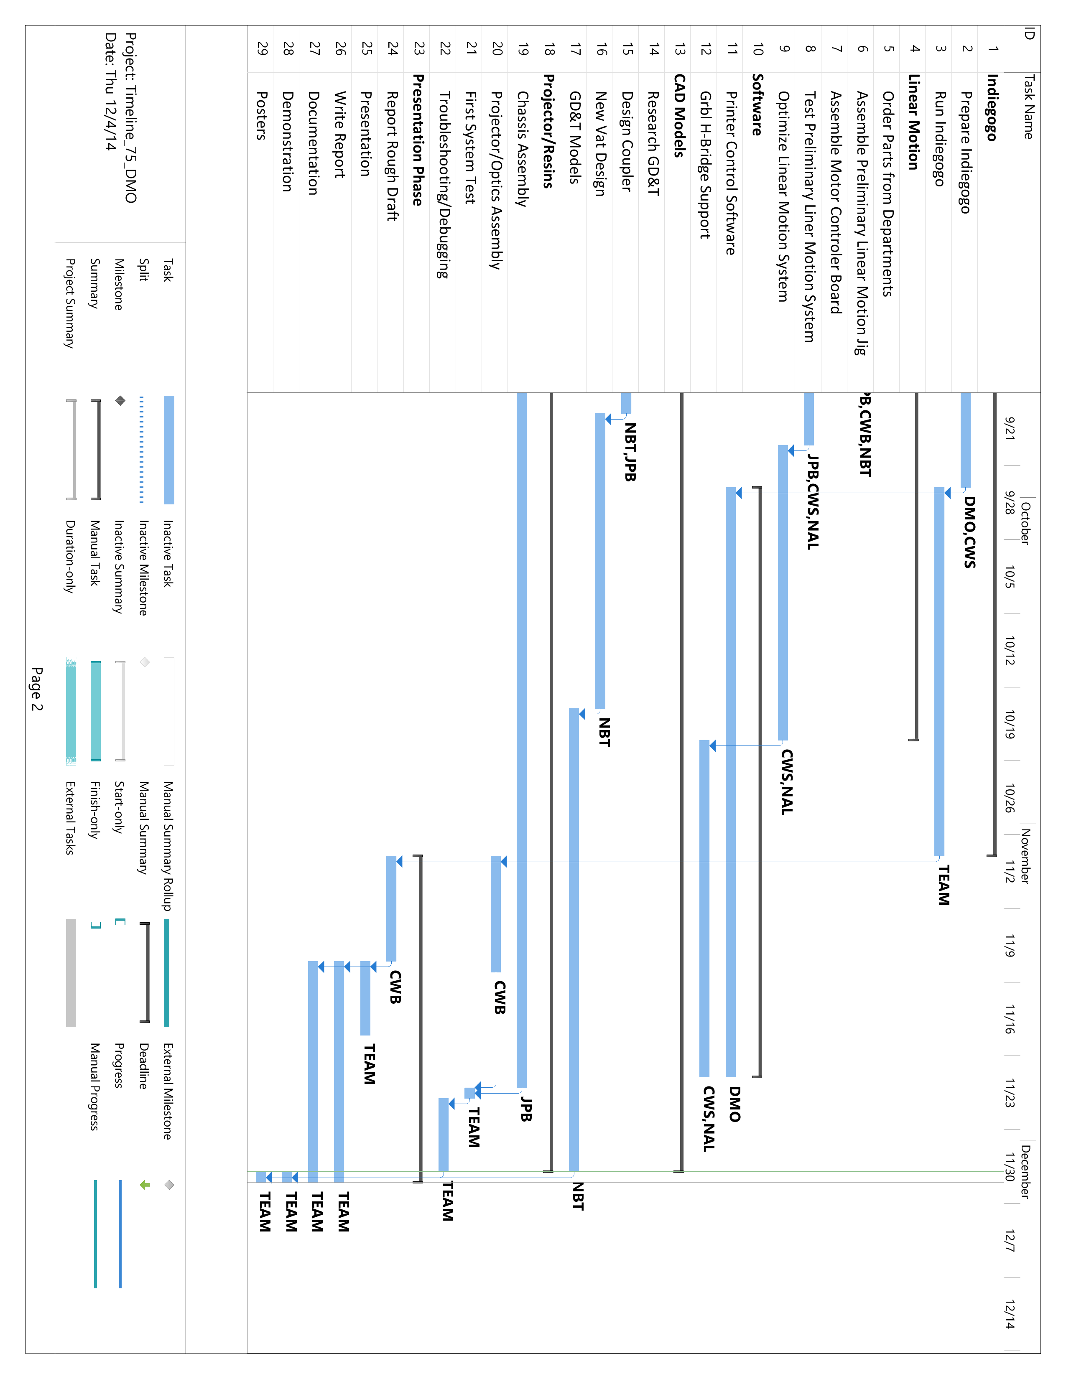
DesignReport/Appendix/Images/Timeline_75_DMO2.png
