dan-olsen/SeniorDesign/DesignReport/Appendix/Images/Timeline_75_DMO_proposed_reworked1.png

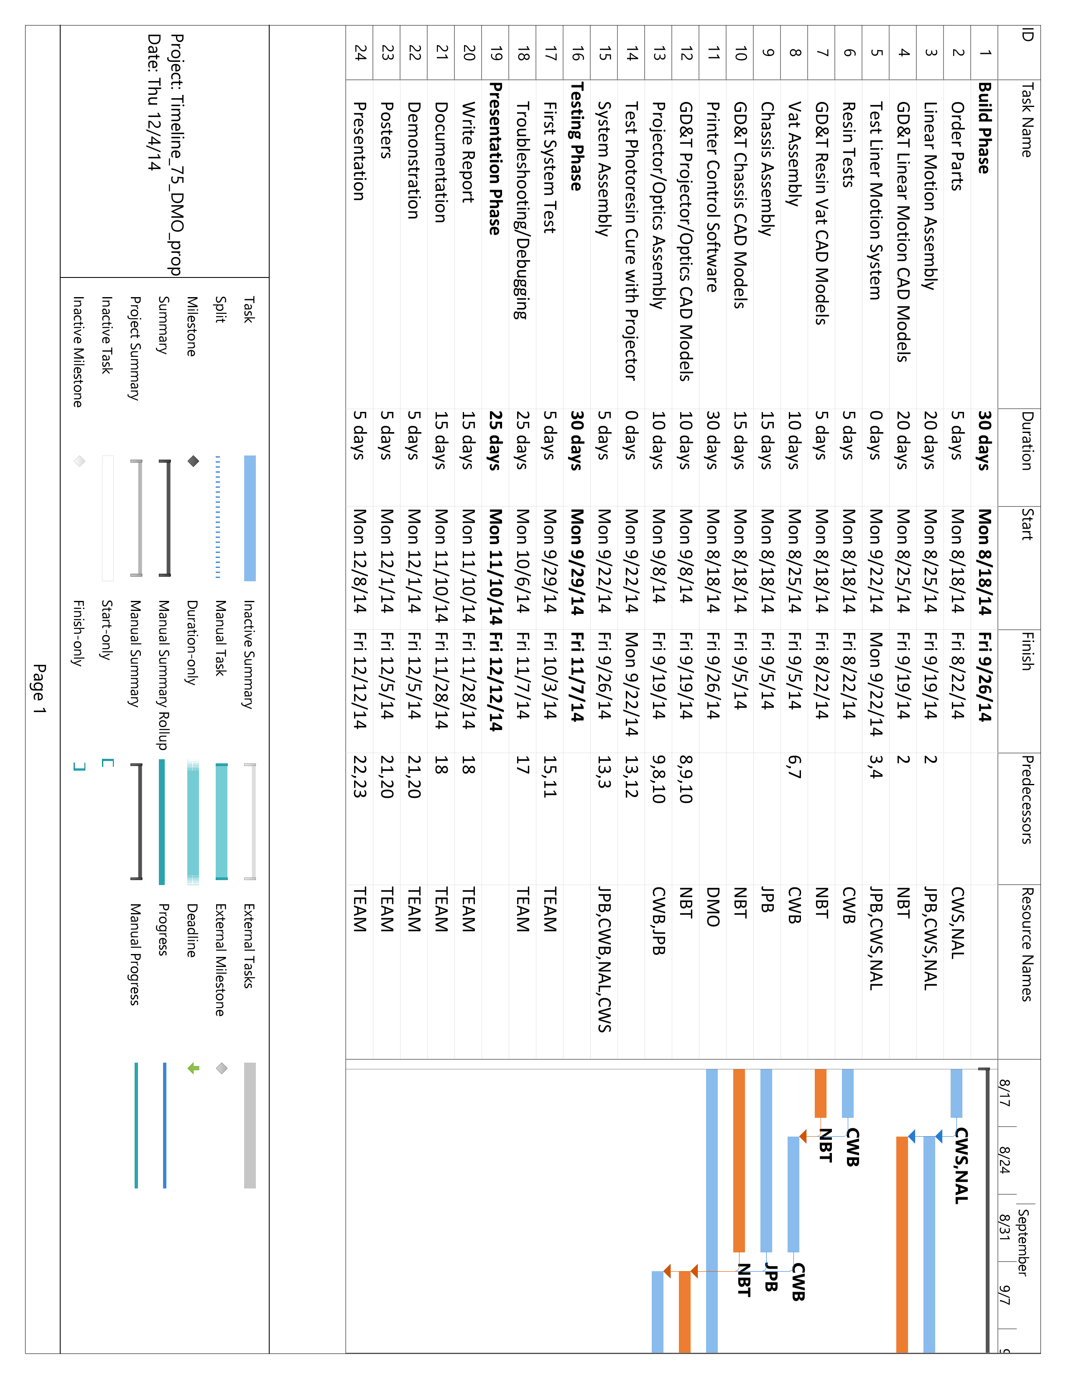
DesignReport/Appendix/Images/Timeline_75_DMO_proposed_reworked1.png
