dan-olsen/SeniorDesign/Photos/TeamPhoto2.JPG

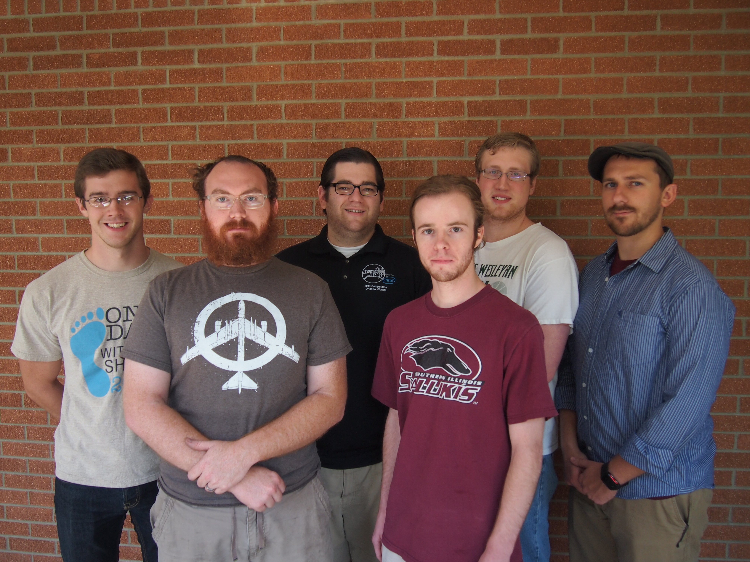
Photos/TeamPhoto2.JPG
