dan-olsen/SeniorDesign/Photos/TeamPhoto.JPG

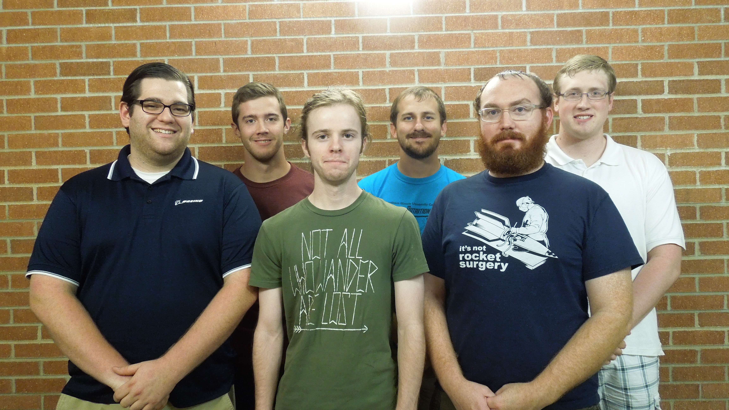
Photos/TeamPhoto.JPG
