dan-olsen/SeniorDesign/Crowdsourcing/ThankYouLetter.docx

Dear ,

We would like to express our greatest appreciation for your generosity to support Project PAM. Your personal commitment was incredibly supportive and allowed us to continue building a working prototype. Your assistance means so much to us and to the open source community. Thank you from all of us at Project PAM.

Sincerely,

Project PAM
