dan-olsen/SeniorDesign/Logistics/ECE_Parts Order Form_75.xlsx

SENIOR DESIGN PARTS REQUEST BY VENDOR
Team #: | 75 |  |  | Team Name: _3DPR___________________
Date: | 2014-09-02 |  |  | Initiator: _Daniel Olsen________________
Contact Person: |  | _Daniel Olsen_________________ |  | Phone: __812-573-1942____________ | Email: __dolsen@siu.edu__________
Project Total: (Sum of ALL Vendors) |  |  |  | $379.15
Item # | Qty | Unit | P/N | Description | $/Unit | $ Amount | DATE NEEDED BY | LINK
1 | 1 | Count | 50 | Arduino Uno R3 | $24.95 | $24.95 | 2014-09-05 | http://www.adafruit.com/product/50
3 | 1 | Count | 1438 | Adafruit Motor Shield for Arduino | $19.95 | $19.95 | 2014-09-05 | http://www.adafruit.com/products/1438
4 | 2 | Count | 324 | NEMA 17 Stepper Motor | $14.00 | $28.00 | 2014-09-05 | http://www.adafruit.com/products/324
5 | 1 | Count | 85 | Shield stacking headers for Arduino | $1.95 | $1.95 | 2014-09-05 | http://www.adafruit.com/products/85
7 | 1 | Count | 798 | 12V 1A Power Supply | $8.95 | $8.95 | 2014-09-05 | http://www.adafruit.com/products/798
 |  |  |  |  | Total: | $83.80
VENDOR INFORMATION
Name: ___Adafruit Industries_________________________________ |  |  |  | Website: ___http://www.adafruit.com_________________________________________
Contact Person: |  | __N/A_________________________
Phone: __N/A______________ |  |  |  | Fax: __N/A__________________
Special Approval (as needed): _________________________________________ |  |  |  |  | Order Date: ________________
Item # | Qty | Unit | P/N | Description | $/Unit | $ Amount | DATE NEEDED BY | LINK
8 | 1 | Count | 5438 | 3 ft USB 2.0 A Male to B Male | $1.02 | $1.02 | 2014-09-05 | http://www.monoprice.com/Product?c_id=103&cp_id=10303&cs_id=1030301&p_id=5437&seq=1&format=2
9 | 2 | Count | 3726 | 3 ft USB to RS232 | $5.71 | $11.42 | 2014-09-05 | http://www.monoprice.com/Product?c_id=103&cp_id=10311&cs_id=1031104&p_id=3726&seq=1&format=2
10 | 2 | Count | 3871 (http://www.monoprice.com/Product?c_id=102&cp_id=10240&cs_id=1024008&p_id=3871&seq=1&format=2) | 3 ft HDMI Cable Black | $3.82 | $7.64 | 2014-09-05 | http://www.monoprice.com/Product?c_id=102&cp_id=10240&cs_id=1024008&p_id=3871&seq=1&format=2
 |  |  |  |  | Total: | $20.08
VENDOR INFORMATION
Name: _Monoprice___________________ |  |  |  | Website: ____http://www.monoprice.com_______________________________________
Contact Person: |  | _N/A__________________________
Phone: ___N/A_____________ |  |  |  | Fax: __N/A__________________
Special Approval (as needed): _________________________________________ |  |  |  |  | Order Date: ________________
Item # | Qty | Unit | P/N | Description | $/Unit | $ Amount | DATE NEEDED BY | LINK
11 | 1 | Liter | gplus | G+ Resin Blue | $45.00 | $45.00 | 2014-09-05 | http://www.makerjuice.com/product/gplus/
 |  |  |  |  | Total: | $45.00
VENDOR INFORMATION
Name: __Makerjuice__________________________________ |  |  |  | Website: ___http://www.makerjuice.com_________________________________________
Contact Person: |  | __N/A_________________________
Phone: _N/A_______________ |  |  |  | Fax: _N/A___________________
Special Approval (as needed): _________________________________________ |  |  |  |  | Order Date: ________________
Item # | Qty | Unit | P/N | Description | $/Unit | $ Amount | DATE NEEDED BY | LINK
12 | 1 | Pack of 100 | E-FFR250N-100 | 22/18-Gauge Female Quick Disconnects | $7.98 | $7.98 | 2014-09-05 | http://www.amazonsupply.com/dp/B00M4D0DU8?ref_=sr_1_1_txt
13 | 1 | Pack of 4 | LME12UU | Pack of 4 LME12UU Linear Motion 12 mm Ball Bushings, Closed Type, Metric | $24.81 | $24.81 | 2014-09-05 | http://www.amazonsupply.com/lme12uu-linear-motion-bushings-closed/dp/B002BBJUIO
 |  |  |  |  | Total: | $32.79
VENDOR INFORMATION
Name: __Amazon Supply_________________________ |  |  |  | Website: __http://www.amazonsupply.com__________________________________________
Contact Person: |  | ___________________________
Phone: ________________ |  |  |  | Fax: ____________________
Special Approval (as needed): _________________________________________ |  |  |  |  | Order Date: ________________
Item # | Qty | Unit | P/N | Description | $/Unit | $ Amount | DATE NEEDED BY | LINK
14 | 1 | Count | 7549K1 | Metric Precision Threaded Rod, 10mm Diameter, 2mm/Turn Screw, 1750mm Long | $58.88 | $58.88 | 2014-09-05 | http://www.mcmaster.com/#7549k1/=tjuroh
15 | 2 | Count | 6459K29 | Hardened Precision 400 Series Stainless Steel Metric Shaft, 12 mm Diameter, 1200 mm Length | $69.30 | $138.60 | 2014-09-05 | http://www.mcmaster.com/#6459k29/=tjuslw
 |  |  |  |  | Total: | $197.48
VENDOR INFORMATION
Name: __McMaster Carr_________________________ |  |  |  | Website: _____http://www.mcmaster.com_______________________________________
Contact Person: |  | ___________________________
Phone: ________________ |  |  |  | Fax: ____________________
Special Approval (as needed): _________________________________________ |  |  |  |  | Order Date: ________________
