dan-olsen/SeniorDesign/Logistics/Budget_75_JPB.xlsx

Item # | Qty | Unit | P/N | Description | Subsystem | $/Unit | $ Amount | Link
1 | 1 | Count | 50 | Arduino Uno R3 | Hardware software interface | $24.95 | $24.95 | http://www.adafruit.com/product/50
2 | 1 | Count | 1438 | Adafruit Motor Shield for Arduino |  | $19.95 | $19.95 | http://www.adafruit.com/products/1438
3 | 2 | Count | 324 | NEMA 17 Stepper Motor | Motors/motor control | $14.00 | $28.00 | http://www.adafruit.com/products/324
4 | 1 | Count | 85 | Shield stacking headers for Arduino |  | $1.95 | $1.95 | http://www.adafruit.com/products/85
5 | 1 | Count | 798 | 12V 1A Power Supply | Motors/motor control | $8.95 | $8.95 | http://www.adafruit.com/products/798
6 | 1 | Count | 5438 | 3 ft USB 2.0 A Male to B Male | Hardware software interface | $1.02 | $1.02 | http://www.monoprice.com/Product?c_id=103&cp_id=10303&cs_id=1030301&p_id=5437&seq=1&format=2
7 | 2 | Count | 3726 | 3 ft USB to RS232 | Projector | $5.71 | $11.42 | http://www.monoprice.com/Product?c_id=103&cp_id=10311&cs_id=1031104&p_id=3726&seq=1&format=2
8 | 2 | Count | 3871 (http://www.monoprice.com/Product?c_id=102&cp_id=10240&cs_id=1024008&p_id=3871&seq=1&format=2) | 3 ft HDMI Cable Black | Projector | $3.82 | $7.64 | http://www.monoprice.com/Product?c_id=102&cp_id=10240&cs_id=1024008&p_id=3871&seq=1&format=2
9 | 1 | Liter | gplus | G+ Resin Blue | Resin | $45.00 | $45.00 | http://www.makerjuice.com/product/gplus/
10 | 1 | Pack of 100 | E-FFR250N-100 | 22/18-Gauge Female Quick Disconnects | Motors/motor control | $7.98 | $7.98 | http://www.amazonsupply.com/dp/B00M4D0DU8?ref_=sr_1_1_txt
11 | 1 | Pack of 4 | LME12UU | Linear Motion 12 mm Ball Bushings, Closed Type, Metric | Motion control | $24.81 | $24.81 | http://www.amazonsupply.com/lme12uu-linear-motion-bushings-closed/dp/B002BBJUIO
12 | 1 | Count | 7549K1 | Metric Precision Threaded Rod, 10mm Diameter, 2mm/Turn Screw, 1750mm Long | Motion control | $58.88 | $58.88 | http://www.mcmaster.com/#7549k1/=tjuroh
13 | 2 | Count | 6459K29 | Hardened Precision 400 Series Stainless Steel Metric Shaft, 12 mm Diameter, 1200 mm Length | Chassis | $69.30 | $138.60 | http://www.mcmaster.com/#6459k29/=tjuslw
14 | 1 |  | 8579K28 | PTFE-Filled Delrin ® Acetal Resin Rod 1"x12" | Motion control | $17.10 | $17.10 | http://www.mcmaster.com/#8579k28/=rahhhr
15 | 1 |  |  | Arduino CNC Shield V3.03 | Motors/motor control | $20.00 | $20.00
16 | 2 |  |  | Pololu DRV8825 | Motors/motor control | $8.95 | $17.90
17 | 2 | Count | 6655K52 | Steel Thrust Ball Bearing, Steel Washers, for 6 mm Shaft Diameter, 14 mm OD | Motion control | $2.83 | $5.66
18 | 1 | 1 Meter | 90024A040 | Type 18-8 Stainless Steel Fully Threaded Rod, M3 Thread, 0.5mm Pitch, 1 Meter Long | Chassis | $4.27 | $4.27
19 | 1 | Pack of 25 | 93070A071 | Low-Profile Socket Head Cap Screw, Class 8.8 Steel, M3 Size, 14 mm Length, .5mm Pitch | Chassis | $5.96 | $5.96
20 | 1 |  |  | M3 Socket Head Cap Screws | Chassis | $12.00 | $12.00
21 | 1 |  | 9255T42 | Steel Perforated Sheet, .156" Hole Diameter, 63% Open, 22 Gauge, .03" Thick, 24" X 24" | Chassis | $20.77 | $20.77
22 | 1 |  |  | Gaffers Tape | Chassis | $13.00 | $13.00 | http://www.mcmaster.com/#7612a56/=rahkny
23 | 2 |  | 9246K23 | Multipurpose 6061 Aluminum, 3/8" Thick, 12" x 12" | Chassis | $36.92 | $73.84 | http://www.mcmaster.com/#9246k495/=rlav9s
24 | 1 |  | 9246K13 | Multipurpose 6061 Aluminum, 1/4" Thick, 12" x 12" | Chassis | $30.39 | $30.39
 | 1 |  | 9062K31 | Multipurpose 6061 Aluminum, Precision-Ground, 1/2" Diameter | Chassis | $7.16 | $7.16
25 | 1 |  |  | Plastic Film | Chassis | $10.00 | $10.00
26 | 1 | Pack of 50 | 91290A176 | Black-Oxide Class 12.9 Socket Head Cap Screw, Alloy Steel, M4 Thread, 25mm Length, 0.70mm Pitch | Motion control | $6.87 | $6.87
 |  |  |  |  |  | Total: | $624.07
