dan-olsen/SeniorDesign/Logistics/AIL_75_JPB_Fall.xlsx

Project PAM |  |  |  |  |  |  | Sec Ref #: S14-75-3DPrinter
Action Item List
Team Members:
 | JPB | Jeffrey Burdick ME
 | CWB | Chance Baker EE
 | CWS | Casey Spencer EE
 | DMO | Daniel Olsen CE
 | NBT | Nathaniel Tyler ME
 | NAL | Nick Lowman CE
# | Activity | Person(s) | Date Assigned | Date Due | New Due | Status | Comments
1 | Complete Prezi Draft | DMO | 2014-08-19 | 2014-08-28 |  | Done
2 | Complete Prezi Script Draft | CWS | 2014-08-26 | 2014-08-28 | 2014-08-29 | Done | "Casey is bad at script writing" - Casey
3 | Create Attendance Sheet | CWB | 2014-08-26 | 2014-09-02 |  | Done
4 | Funding Letters | CWS, JPB | 2014-08-26 | 2014-08-27 |  | Done | Waiting on Kickstarter
5 | ECE Order Forms | NAL, DMO | 2014-08-26 | 2014-08-28 |  | Done
6 | ME Part Order | JPB | 2014-08-26 | 2014-08-28 |  | Done | Waiting to hear from ECE parts order
7 | Software Mashup | DMO | 2014-08-26 | 2014-09-02 |  | Done
8 | Firmware Mashup | NAL | 2014-08-26 | 2014-09-03 | 2014-09-11 | Done
9 | Update Timeline | DMO | 2014-08-26 | 2014-08-28 |  | Done
10 | Turn in N&E Statement | NAL | 2014-08-26 | 2014-08-27 |  | Done
11 | Get Projector | NAL | 2014-08-26 | 2014-09-03 |  | N/A | Projector not DLP
12 | Take new Team Photo | ALL | 2014-08-27 | 2014-08-27 |  | Done
13 | Initial Models | JPB | 2014-08-28 | 2014-09-02 |  | Done
14 | Get Access to Spring D2L | ALL | 2014-08-28 | 2014-08-28 |  | N/A | Not happening
15 | Bring in Macro Lense | JPB | 2014-08-28 | 2014-09-02 |  | Done
16 | Complete Prezi Final Draft | DMO | 2014-09-02 | 2014-09-09 |  | Done
17 | Complete Prezi Script Final Draft | CWS | 2014-09-02 | 2014-09-09 |  | Done
18 | Website Content Draft | DMO, CWS | 2014-09-02 | 2014-09-04 |  | Done
19 | Source Prelim Motion Sys | NAL, NBT, JPB | 2014-09-02 | 2014-09-04 |  | Done
20 | Generate UML | DMO | 2014-09-02 | 2014-09-04 |  | Canceled | Not worth it
21 | Learn Code | DMO | 2014-09-02 | 2014-09-04 | 2014-10-03 | Done
22 | Update Website Format | DMO | 2014-09-04 | 2014-09-09 |  | Done
23 | Update GitHub READMEs | DMO | 2014-09-04 | 2014-09-09 |  | Done
24 | Assemble Prelim Motor Board | NAL | 2014-09-04 | 2014-09-09 |  | Done
25 | Assemble Prelim Linear Motion Sys | JPB, NBT | 2014-09-04 | 2014-09-11 |  | Done
26 | Record Prezi | CWS | 2014-09-09 | 2014-09-11 | 2014-09-18 | Done
27 | Model Renderings | DMO | 2014-09-09 | 2014-09-11 |  | Done | 14 hours to render
28 | Add Facebook Content | CWS | 2014-09-09 | 2014-09-11 | 2014-09-23 | Done
29 | Add Twitter Content | CWB | 2014-09-09 | 2014-09-11 | 2014-09-23 | Done
30 | Add Google+ Content | CWS | 2014-09-09 | 2014-09-11 | 2014-09-23 | Done
31 | Add Website Content | DMO, CWS, CWB | 2014-09-09 | 2014-09-09 | 2014-09-23 | Done
32 | List of Media Outlets | CWB | 2014-09-09 | 2014-09-09 | 2014-09-18 | Done
33 | Test Prelim Motor Control | NAL | 2014-09-09 | 2014-09-18 | 2014-09-25 | Done
34 | Test Prelim Linear Motion Sys | JPB, NBT | 2014-09-11 | 2014-09-18 | 2014-09-25 | Done | Waiting for #34
35 | Upload Prezi to Youtube | CWS | 2014-09-11 | 2014-09-11 | 2014-09-18 | Done
36 | Indiegogo Content | DMO, CWS | 2014-09-11 | 2014-09-11 | 2014-09-23 | Done
37 | Grbl H-Bridge Support | NAL, CWS | 2014-09-25 | 2014-10-16 | 2014-11-30
38 | Coupler Design | NAT | 2014-09-25 | 2014-10-02 | 2014-10-16 | 95%
42 | Optimizing Prelim Linear Motion Sys | JPB, CWS | 2014-09-30 | 2014-10-09 |  | Done
39 | Launch Indiegogo | JPB, DMO | 2014-09-30 | 2014-09-30 |  | Done
40 | Lead Screw Nut | JPB, NAT | 2014-09-30 | 2014-10-14
41 | Rename Files | DMO | 2014-10-02 | 2014-10-07 |  | Done
43 | Normalize Encodings to UTF-8 | DMO | 2014-10-02 | 2014-10-07 |  | Done
44 | Rename Classes | DMO | 2014-10-09 | 2014-10-14 |  | N/A | Change of framework
45 | Fix White Space and Formating | DMO | 2014-10-09 | 2014-10-14 |  | N/A | Change of framework
46 | Change Icons to System Default | DMO | 2014-10-09 | 2014-10-14 |  | N/A | Change of framework
47 | Implement Tab Interface | DMO | 2014-10-09 | 2014-10-14 |  | N/A | Change of framework
48 | Plates | JPB, NAT | 2014-10-16 | 2014-10-23 | 2014-10-31 | 30%
49 | Linear Motion Rails | JPB, NAT | 2014-10-16 | 2014-10-23 | 2014-11-07 | 10%
50 | GD&T Mechanical Components | JPB, NAT | 2014-10-16 | 2014-10-23 |  | 30%
51 | Figure out the Frame work | DMO | 2014-10-21 | 2014-10-30 |  | 20%
52 | Map Out Design Report | CWB | 2014-10-21 | 2014-10-06 |  | 15%
53
54
55
56
57
58
59
60
61
62
63
64
65
66
67
68
69
70
71
72
