dan-olsen/SeniorDesign/Logistics/AIL_75_JPB_Spring.xlsx

Project PAM |  |  |  |  |  |  |  | Sec Ref #: S14-75-3DPrinter
 |  | Action Item List
Team Members:
 | JPB | Jeffrey Burdick ME
 | CWB | Chance Baker EE
 | CWS | Casey Spencer EE
 | DMO | Daniel Olsen CE
 | NAL | Nick Lowman CE
# | Sub-System | Activity | Person | Date Assigned | Date Due | New Due | Status | Comments
1 | Imaging | Spec Projector | DMO | 2014-02-18 | 2014-02-27 |  | Done
2 | Imaging | Spec Slicing Software | DMO | 2014-02-18 | 2014-02-27 |  | Done
3 | Controls | Spec Controller Hardware | NAL | 2014-02-18 | 2014-02-27 | 2014-03-06 | Done
4 | Controls | Spec Controller Software | NAL | 2014-02-18 | 2014-02-27 | 2014-03-06 | Done
5 | Controls | Spec Stepper Motors | CWS | 2014-02-18 | 2014-02-27 |  | Done
6 | Controls | Spec Stepper Motor Driver | CWS | 2014-02-18 | 2014-02-27 | 2014-03-06 | Done
7 | Chassis | Determine Degrees of Freedom | JPB | 2014-02-18 | 2014-03-04 |  | Done
8 | Resin | Spec Resin | CWB | 2014-02-18 | 2014-02-27 | 2014-03-06 | Done
9 | Resin | Spec Photocuring Catalyst | CWB | 2014-02-18 | 2014-02-27 | 2014-03-06 | N/A | Resins and Catalyst are seen as a single unit
10 | Resin | Spec Vat Material | CWB | 2014-02-18 | 2014-02-27 |  | Done
11 | Resin | Spec Vat Coating | CWB | 2014-02-18 | 2014-02-27 |  | Done
12 | Resin | Spec Build Table Surface | CWB | 2014-02-18 | 2014-02-27 |  | Done
13 | Chassis | Resin Filling | JPB | 2014-02-18 | 2014-03-06 |  | Canceled | Waiting for #34
15 | Chassis | Spec Linear Motion Hardware | JPB | 2014-02-18 | 2014-02-27 |  | Done
16 | Chassis | Spec Linear Motion Driving | JPB | 2014-02-18 | 2014-02-27 |  | Done
17 | Chassis | Spec Framing | JPB | 2014-02-18 | 2014-02-27 |  | Done
18 | Chassis | Spec Enclosure | JPB | 2014-02-18 | 2014-02-27 |  | Done
19 | Imaging | Candidate Projectors | DMO | 2014-02-20 | 2014-03-04 |  | Done
20 | Imaging | Candidate Slicing Software | DMO | 2014-02-20 | 2014-03-04 |  | Done
21 | Controls | Candidate Controller Hardware | NAL | 2014-02-20 | 2014-03-04 | 2014-03-06 | Done
22 | Controls | Candidate Controller Software | NAL | 2014-02-20 | 2014-03-04 | 2014-03-06 | Late
23 | Controls | Candidate Stepper Motors | CWS | 2014-02-20 | 2014-03-04 |  | Done
24 | Controls | Candidate Stepper Motor Drivers | CWS | 2014-02-20 | 2014-03-04 | 2014-03-06 | Done
25 | Resin | Candidate Resins | CWB | 2014-02-20 | 2014-03-04 | 2014-03-20 | Done
26 | Resin | Candidate Catalysts | CWB | 2014-02-20 | 2014-03-04 | 2014-03-20 | N/A
27 | Resin | Candidate Vat Material | CWB | 2014-02-20 | 2014-03-04 |  | Done
28 | Resin | Candidate Vat Coating | CWB | 2014-02-20 | 2014-03-04 |  | Done
29 | Resin | Candidate Build Table Surface | CWB | 2014-02-20 | 2014-03-04 |  | Done
30 | Chassis | Candidate Linear Motion Hardware | JPB | 2014-02-20 | 2014-03-04 |  | Done
31 | Chassis | Candidate Linear Motion Driving | JPB | 2014-02-20 | 2014-03-04 |  | Done
32 | Chassis | Candidate Framing | JPB | 2014-02-20 | 2014-03-04 |  | Done
33 | Chassis | Candidate Enclosure | JPB | 2014-02-20 | 2014-03-04 |  | Done
34 | Chassis | Top Down or Bottom Up | JPB | 2014-03-06 | 2014-03-20 |  | Done
35 | Chassis | Compile Parts List | JPB | 2014-03-25 | 2014-03-27 |  | Done
36 | Imaging | Compile Parts List | DMO | 2014-03-25 | 2014-03-27 |  | Done
37 | Computing | Compile Parts List | NAL | 2014-03-25 | 2014-03-27 |  | Done
38 | Resin | Compile Parts List | CWB | 2014-03-25 | 2014-03-27 |  | Done
39 | Controls | Compile Parts List | CWS | 2014-03-25 | 2014-03-27 |  | Done
40 | Chassis | Budget Parts | JPB | 2014-03-25 | 2014-03-27 |  | Done
41 | Imaging | Budget Parts | DMO | 2014-03-25 | 2014-03-27 |  | Done
42 | Computing | Budget Parts | NAL | 2014-03-25 | 2014-03-27 |  | Done
43 | Resin | Budget Parts | CWB | 2014-03-25 | 2014-03-27 |  | Done
44 | Controls | Budget Parts | CWS | 2014-03-25 | 2014-03-27 |  | Done
45 | Chassis | Drawings/Schematics | JPB | 2014-03-25 | 2014-04-01 | 2014-04-03 | Done | with CWB
46 | Imaging | Feature List | DMO | 2014-03-25 | 2014-04-01 | 2014-04-03 | Done
47 | Computing | Power Distribution and Electrical Connections | NAL | 2014-03-25 | 2014-04-01 | 2014-04-03 | Done
48 | Imaging | GUI Wire Frames | DMO | 2014-03-25 | 2014-04-01 | 2014-04-03 | Done
49 | Resins | Drawings/Schematics | CWB | 2014-03-25 | 2014-04-01 | 2014-04-03 | Done | with JPB
50 | Controls | Power Distribution and Electrical Connections | CWS | 2014-03-25 | 2014-04-01 | 2014-04-03 | Done
51 | Controls | Drawings/Schematics | CWS | 2014-03-25 | 2014-04-01 | 2014-04-03 | Done
52 | Chassis | Design Review Handouts | JPB | 2014-03-25 | 2014-04-03 | 2014-04-10 | Done | Moved back because Design Reviews not till 2014-04-15
53 | Computing | Design Review Handouts | NAL | 2014-03-25 | 2014-04-03 | 2014-04-10 | Done | Moved back because Design Reviews not till 2014-04-15
54 | Imaging | Design Review Handouts | DMO | 2014-03-25 | 2014-04-03 | 2014-04-10 | Done | Moved back because Design Reviews not till 2014-04-15
55 | Resin | Design Review Handouts | CWB | 2014-03-25 | 2014-04-03 | 2014-04-10 | Done | Moved back because Design Reviews not till 2014-04-15
56 | Controls | Design Review Handouts | CWS | 2014-03-25 | 2014-04-03 | 2014-04-10 | Done | Moved back because Design Reviews not till 2014-04-15
52 | Chassis | Design Proposal | JPB | 2014-03-25 | 2014-04-15 | 2014-04-17
53 | Computing | Design Proposal | NAL | 2014-03-25 | 2014-04-15 | 2014-04-17
54 | Imaging | Design Proposal | DMO | 2014-03-25 | 2014-04-15 | 2014-04-17
55 | Resin | Design Proposal | CWB | 2014-03-25 | 2014-04-15 | 2014-04-17
56 | Controls | Design Proposal | CWS | 2014-03-25 | 2014-04-15 | 2014-04-17
57 | Team | Talk to ECE Chair for funding | DMO, CWS | 2014-04-15 | 2014-04-24
58 | Team | Talk to ME Chair for funding | JPB, CWB | 2014-04-15 | 2014-04-24
59 | Team | Meeting on 2014-04-21 to work on Oral Pres. | ALL | 2014-04-15 | 2014-04-21
