dan-olsen/SeniorDesign/Crowdsourcing/GitHubPagesOutline.docx

1. projectpam.github.io
  a. Welcome to Project PAM
    i. Who we are
      1. We are a team of undergraduate engineering students working on a Senior Design Project at Southern Illinois University Carbondale.
        a. Photo
      2. We have great passion for advancing the open source and 3D printing community.
    ii. Motivation
      1. Produce a high resolution DLP projector that is fully open sourced using off-the-shelf hardware
    iii. What is Project PAM
      1. Photoresin Additive Manufacturing: Fully open source design and well documented printer design.
    iv. GitHub
      1. Hardware and Software Repos
        a. Hardware Repo
          i. Link
        b. Software Repo
          i. Link
  b. Crowdsourcing
    i. Indiegogo
  c. Why Open-Source?
    i. Answer the Question
      1. Because open-source is better...
      2. some DLP printers aren't open-source
      3. Use of special software and patented hardware
    ii. Open-Source Hardware Association
    iii. Licenses
  d. Tired of Those Stupid Spaghetti Machines?
    i. FDM vs DLP
    ii. Market Gap
      1. Build Volume
      2. Cost
  e. How is our design more flexible?
    i. Dual 1080p projectors
      1. Also works with just one
    ii. Compatible with lots of DLP projectors
    iii. Off the shelf parts
      1. Most parts can be found off of Amazon or industrial supply warehouses
    iv. Resins
    v. Software Compatibility
    vi. Grbl
  f. Releases
    i. Most Recent
  g. Contact Us.
    i. Email List
    ii. GitHub Issues
    iii. GitHub, Twitter, Facebook, Google+, YouTube
2. projectpam.github.io/Software
  a. Introduction
    i. What it is based off of
  b. Open-Source
    i. OSHWA
  c. Releases
  d. Contributing
  e. Contact Us.
    i. Email List
    ii. GitHub Issues
    iii. GitHub, Twitter, Facebook, Google+, YouTube
3. projectpam.github.io/Hardware
  a. Introduction
    i. Intended to be adjustable to ensure precision and accuracy
    ii. GD&T models and drawings
    iii. Documentation intended for production
  b. Open-Source
    i. OSHWA
  c. Releases
  d. Contributing
  e. Contact Us.
    i. Email list
    ii. GitHub Issues
    iii. GitHub, Twitter, Facebook, Google+, YouTube
4. READMES
  a. Introduction
    i. GitHub Pages
    ii. OSHWA
  b. Releases
  c. Contributing workflow
  d. Contact Us.
    i. Email List
    ii. GitHub Issues
    iii. GitHub, Twitter, Facebook, Google+, YouTube
  e. License
