dan-olsen/SeniorDesign/Proposal/FrontEndMaterials/CoverPage-75-JPB.docx

# Project PAM

# Project PAM

A Reference Design for

Photopolymer Additive Manufacturing

for the

Saluki Makerspace

Saluki Engineering Company

Team 75

Chance Baker (EE)

Jeffrey Burdick (ME)

Nicholas Lowman (CE)

Daniel Olsen (CE)

Casey Spencer (EE)
