dan-olsen/SeniorDesign/Crowdsourcing/MediaOutlist.xlsx

Sheet: Sheet1
Name | Email | Website | Phone | Contacted On
3D Printing Industry | news@3dprintingindustry.com |  |  | 2014-10-01
Build Your Own SLA Forum |  | http://www.buildyourownsla.com/forum/
Hackaday | tips@hackaday.com | http://forums.hackaday.com/ |  | 2014-10-01
Make Magazine |  | http://makezine.com/forums/, http://makermedia.com/contact-us/ |  | 2014-10-01
OSHWA | info@oshwa.org |  |  | 2014-10-01
OSI |  | http://opensource.org/contact
Reddit |  | http://www.reddit.com/r/3Dprinting/ |  | 2014-09-30
RepRap Forums |  | http://forums.reprap.org/
SIU DE | See Sheet 2 |  |  | 2014-10-01
Tim Crosby (Campus Promo Guy) | crosby@siu.edu |  | 618-534-3045
Makerjuice Labs |  | https://www.makerjuice.com/contact/ |  | 2014-10-01
Guardian Tech | See Sheet 2 |  |  | 2014-10-01
The Verge |  | http://www.theverge.com/contact-the-verge |  | 2014-10-01
HuffPost Tech | See Sheet 2 |  |  | 2014-10-01
Popular Mechanics | See Sheet 2 |  |  | 2014-10-01
Popular Science | queries@popsci.com |  |  | 2014-10-01
Wired | submit@wired.com |  |  | 2014-10-01
Mashable |  | http://mashable.com/submit/ |  | 2014-10-01
Tested | tips@tested.com |  |  | 2014-09-30
Gizmodo | See Sheet 2 |  |  | 2014-10-01
Mit Tech Review |  | http://www.technologyreview.com/contact/submit/?type=pitch |  | 2014-10-01
Engadget |  | http://www.engadget.com/about/contact/ |  | 2014-10-01
TechCrunch |  | http://techcrunch.com/contact/ |  | 2014-10-01
Washington Post Tech |  | http://help.washingtonpost.com/ics/support/ticketnewwizard.asp?style=classic&deptID=15080 |  | 2014-10-01
BBC Tech |  | http://www.bbc.com/news/10725415 |  | 2014-10-01
New York Times | news-tips@nytimes.com |  |  | 2014-10-01
NPR |  | http://help.npr.org/npr/includes/customer/npr/custforms/contactus.aspx |  | 2014-10-01
New Blankets |  |  |  | 2014-10-01
Open Space SI
Eric Weinhoffer | eweinhoffer@gmail.com |  |  | 2014-10-09
Anna, Make | anna@makermedia.com |  |  | 2014-10-09
Justin Leto | jleto@nova-labs.org |  |  | 2014-10-09
 | info@milwaukeemakerspace.org |  |  | 2014-10-09
 | makerspaceu@gmail.com |  |  | 2014-10-09
 | info@pumpingstationone.org |  |  | 2014-10-09
 | andrew.goodin@grandcenterartsacademy.org
Educational Technology Association of St. Louis
Drew Mcallister | dmcallister@vianney.com |  |  | 2014-10-09
Greg Lawrence | greglawrence@wentzville.k12.mo.us |  |  | 2014-10-09
Andrew Ricke | directorofpublicrelations@archreactor.org |  |  | 2014-10-09
Chris Weiss | president@archreactor.org |  |  | 2014-10-09
Joe Cathell | vicepresident@archreactor.org |  |  | 2014-10-09
 | arch-reactor-board@googlegroups.com |  |  | 2014-10-09
 | webmaster@slsc.org |  |  | 2014-10-09
Carolyn Noe | cnoe@academyofsciencestl.org |  |  | 2014-10-09
DE | (618) 536-3311
 | info@techshop.com |  |  | 2014-10-09
 | https://twitter.com/you3dit
 | https://twitter.com/AndersonHTa
 | https://twitter.com/johnabella
 | https://twitter.com/bjepson

Sheet: Sheet2
Jemima Kiss, head of technology | jemima.kiss@theguardian.com
Charles Arthur, technology editor | charles.arthur@theguardian.com
Keith Stuart, Games editor | keith.stuart@theguardian.com
Samuel Gibbs, Technology reporter | samuel.gibbs@theguardian.com
Alex Hern, Technology reporter | alex.hern@theguardian.com
Bianca Bosker, Executive Tech Editor | Bianca@huffingtonpost.com
Jason O. Gilbert, Editor Yahoo Tech | jog@yahoo-inc.com
Gerry Smith, Tech Reporter | gerald.smith@huffingtonpost.com
KELSEY CAMPBELL-DOLLAGHAN | kelsey@gizmodo.com
Leslie Horn | lhorn@gizmodo.com
ANDREW LISZEWSKI | andrewl@gizmodo.com
SARAH ZHANG | sarah@gizmodo.com
DARREN ORF | darren.orf@gizmodo.com
Brian Barrett | bbarrett@gizmodo.com
Meg Neal | meg@gizmodo.com
Christina Warren, Senior Tech Mashable | http://www.christinawarren.com/contact/
Glenn Derene | pmwebmaster@hearst.com
David Dunbar
Joseph Pappalardo
Jim Meigs
Sarah Gardner, Editor-In-Chief | sgardner@dailyegyptian.com
Jack Robinson, Managing Editor | jrobinson@dailyegyptian.com
Luke Nozicka, Campus Editor | lnozicka@dailyegyptian.com
 | editor@dailyegyptian.com
