dan-olsen/SeniorDesign/Logistics/ME_Parts Order Form_75.xlsx

SENIOR DESIGN PARTS REQUEST BY VENDOR
Team #: | 75 |  |  | Team Name: _3DPR___________________
Date: | 2014-09-02 |  |  | Initiator: _Daniel Olsen________________
Contact Person: |  | _Daniel Olsen_________________ |  | Phone: __812-573-1942____________ | Email: __dolsen@siu.edu__________
Project Total: (Sum of ALL Vendors) |  |  |  | #REF!
Item # | Qty | Unit | P/N | Description | $/Unit | $ Amount | DATE NEEDED BY | LINK
1 | 1 |  |  |  |  | $0.00
2 | 1 |  |  |  |  | $0.00
3 | 2 |  |  |  |  | $0.00
4 | 1 |  |  |  |  | $0.00
5 | 1 |  |  |  |  | $0.00
 |  |  |  |  | Total: | $0.00
VENDOR INFORMATION
Name: ____________________________________ |  |  |  | Website: ____________________________________________
Contact Person: |  | ___________________________
Phone: ________________ |  |  |  | Fax: ____________________
Special Approval (as needed): _________________________________________ |  |  |  |  | Order Date: ________________
