dan-olsen/SeniorDesign/Presentations/DesignPres/marketGap.xlsx

Name | type | price | x | y | z | build area | build volume | cost per unit area | cost per unit volume
Makerbot Replicator 2 | FDM | $2199.00 | 284.5 | 36.6 | 154.9 | 10411.968 | 1613230.322 | 0.2111992661 | 0.001363103563
Printrbot Simple | FDM | $399.00 | 99.1 | 99.1 | 99.1 | 9812.8836 | 972064.2494 | 0.04066083083 | 0.0004104666952
Openbeam Mini Kossel | FDM | $900.00 |  |  | 177.8 | 70553.94939 | 12544492.2 | 0.0127561959 | 7.174463386e-05
Bukito | FDM | $799.00 | 127.0 | 152.4 | 127.0 | 19354.8 | 2458059.6 | 0.04128174923 | 0.0003250531435
Ultimaker 2 | FDM | $2565.00 | 226.1 | 226.1 | 205.7 | 51103.1236 | 10513956.65 | 0.05019262658 | 0.0002439614396
Delta Micro Factory Up Plus 2 | FDM | $1649.00 | 139.7 | 139.7 | 133.3 | 19516.09 | 2602470.601 | 0.08449438386 | 0.0006336286754
3D Systems Cube 2 | FDM | $1299.00 | 139.7 | 139.7 | 139.7 | 19516.09 | 2726397.773 | 0.0665604637 | 0.000476452854
Delta Micro Factory Up Mini | FDM | $899.00 | 119.4 | 119.4 | 119.4 | 14251.5844 | 1701354.146 | 0.06308070561 | 0.000528402627
Felix Robotics Felix 2.0 | FDM | $1949.00 | 254.0 | 203.2 | 234.9 | 51612.8 | 12126427.36 | 0.03776195052 | 0.0001607233476
Tinkerine Studios Ditto+ | FDM | $1549.00 | 209.5 | 184.1 | 228.6 | 38588.6325 | 8821361.389 | 0.0401413551 | 0.000175596479
Type A Machines Series 1 | FDM | $2295.00 | 304.8 | 304.8 | 304.8 | 92903.04 | 28316846.59 | 0.02470317441 | 8.104716013e-05
Alpha Objects Lulzbot Taz | FDM | $2195.00 | 297.2 | 274.3 | 248.9 | 81522.4176 | 20292560.19 | 0.02692510925 | 0.0001081677215
Deezmaker Bukobot 8v2 | FDM | $1299.00 | 203.2 | 203.2 | 203.2 | 41290.24 | 8390176.768 | 0.03146021917 | 0.0001548239132
Printrbot Plus | FDM | $999.00 | 203.2 | 203.2 | 203.2 | 41290.24 | 8390176.768 | 0.02419457964 | 0.0001190678132
Code-P West BV 3DPrinter 4U Builder | FDM | $1688.00 | 218.4 | 209.5 | 175.3 | 45774.102 | 8022369.117 | 0.03687674747 | 0.0002104116596
Solidoodle 3 | FDM | $799.00 | 203.2 | 203.2 | 203.2 | 41290.24 | 8390176.768 | 0.01935081995 | 9.523041315e-05
Mendelmax 2.0 | FDM | $2195.00 | 196.8 | 311.1 | 222.2 | 61249.8775 | 13612785.27 | 0.03583680637 | 0.000161245473
Airwolf AW3D XL | FDM | $2399.00 | 304.8 | 200.7 | 177.8 | 61161.168 | 10874455.67 | 0.03922423457 | 0.0002206087433
Leapfrog Creator | FDM | $2500.00 | 228.6 | 266.7 | 198.1 | 60967.62 | 12078904.87 | 0.04100537302 | 0.0002069724057
Magicfirm LLC Mbot Cube II | FDM | $1399.00 | 260.3 | 228.6 | 196.8 | 59516.01 | 11715726.57 | 0.02350628007 | 0.0001194121416
B9 Creator | PAM | $3375.00 | 101.6 | 76.2 | 206.4 | 7741.92 | 1597738.74 | 0.4359383719 | 0.002112360373
Project PAM | PAM | $1000.00 | 216.0 | 192.0 | 216.0 | 41472 | 8957952 | 0.02411265432 | 0.0001116326589
Formlabs Form1 | PAM | $3299.00 | 124.5 | 124.5 | 165.1 | 15490.2916 | 2557447.143 | 0.2129721044 | 0.001289958234
Miicraft | PAM | $1999.00 | 43.0 | 27.0 | 180.0 | 1161 | 208980 | 1.721791559 | 0.009565508661
LittleRP | PAM | $499.00 |  |  |  | 2880 | 288000 | 0.1732638889 | 0.001732638889
DropLit | PAM | $399.00 |  |  |  | 4554 | 694160 | 0.08761528327 | 0.0005747954362
