dan-olsen/SeniorDesign/Presentations/DesignPres/Jeff's Material/FrontForPresentation.JPG

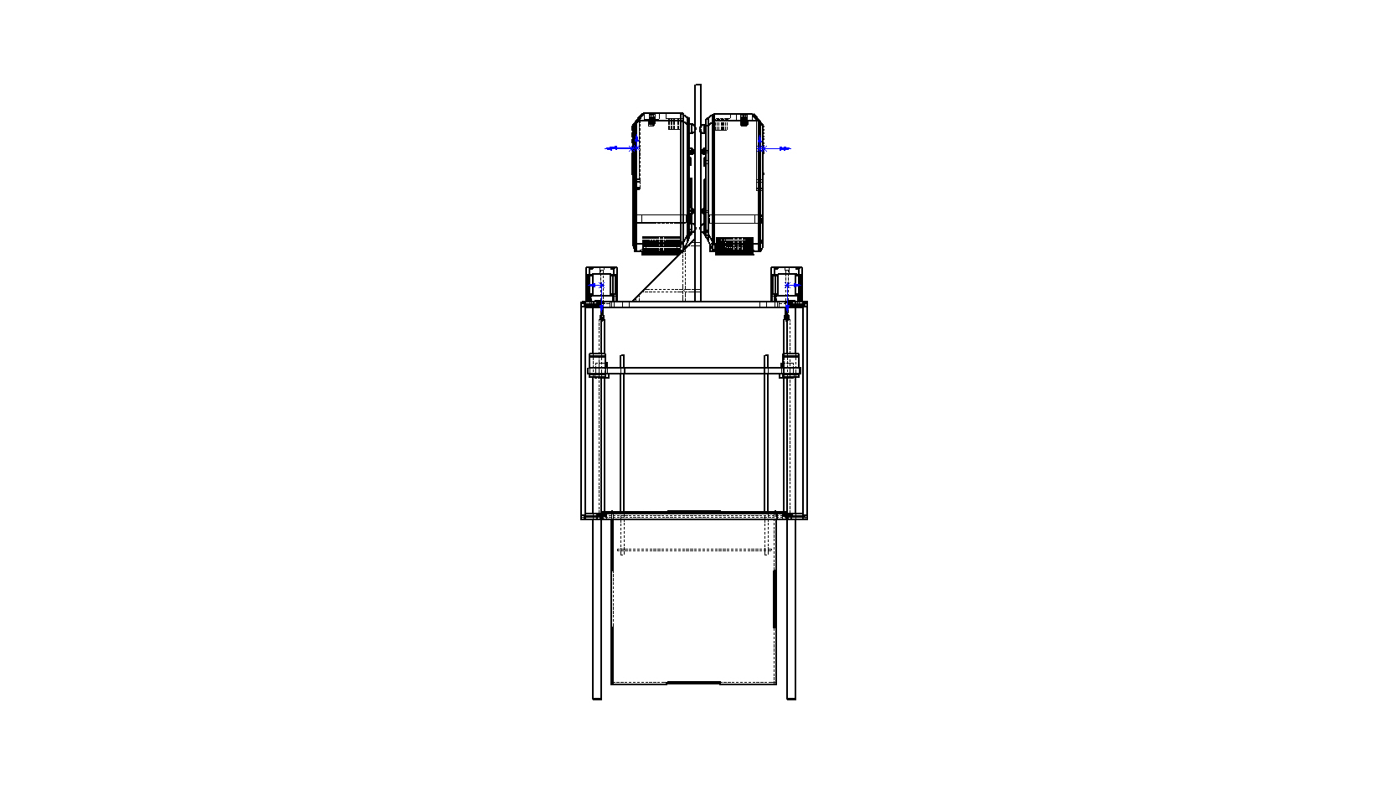
Presentations/DesignPres/Jeff's Material/FrontForPresentation.JPG
