dan-olsen/SeniorDesign/Presentations/DesignPres/Jeff's Material/SideViewForPresentation.JPG

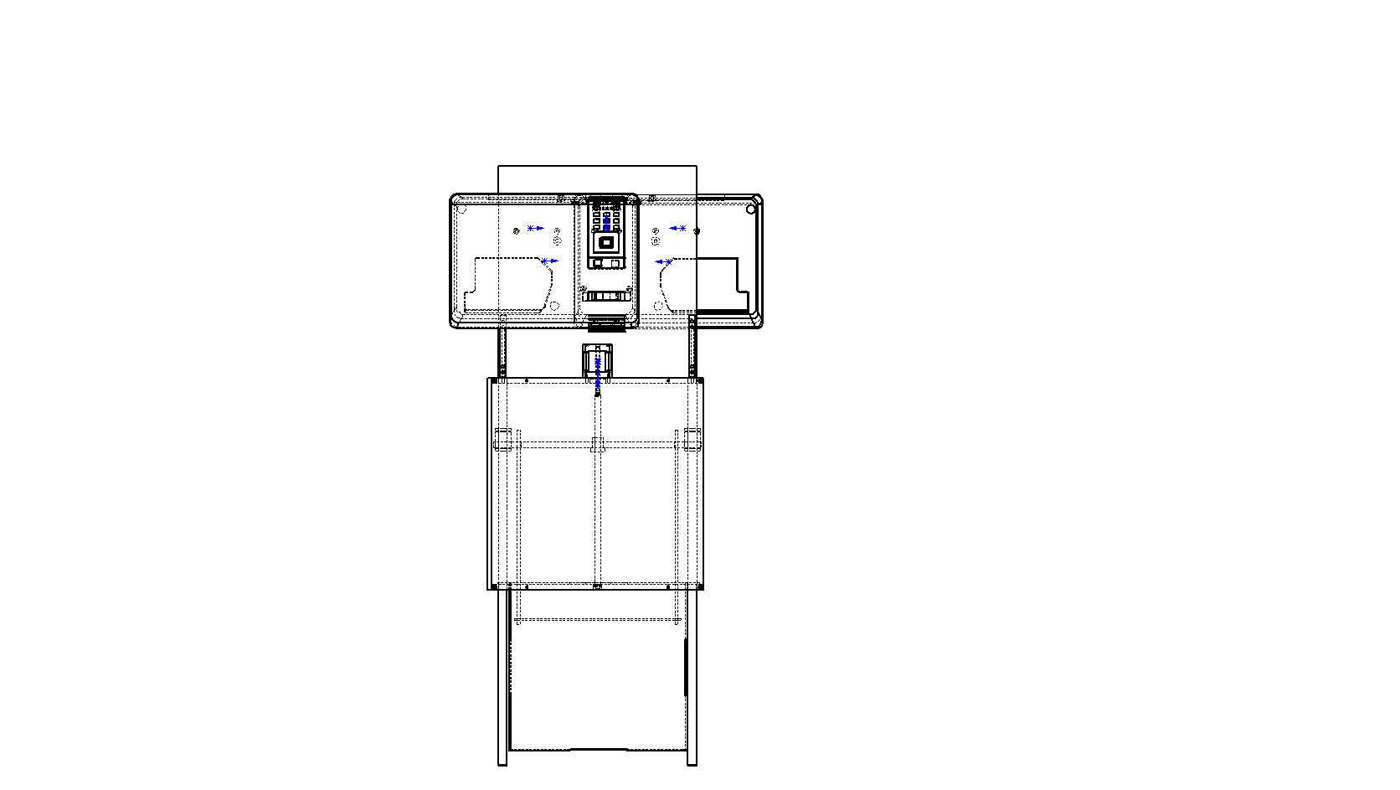
Presentations/DesignPres/Jeff's Material/SideViewForPresentation.JPG
