dan-olsen/SeniorDesign/(list of files, cad)

Other CAD files:
Presentations/DesignPres/Jeff's Material/SideViewForPresentation.SLDDRW
