dan-olsen/SeniorDesign/Presentations/ProposalPres/Next Steps.pptx

## Next Steps

- Finish Prototype
- Finalize LibreCAM
- Complete User Documentation
- Package Initial Release
- Compete in Cornell Cup
