dan-olsen/SeniorDesign/DesignReport/Appendix/Website Screenshots/SIU Engineering Students Use Crowdfunding for 3D Printer.pdf

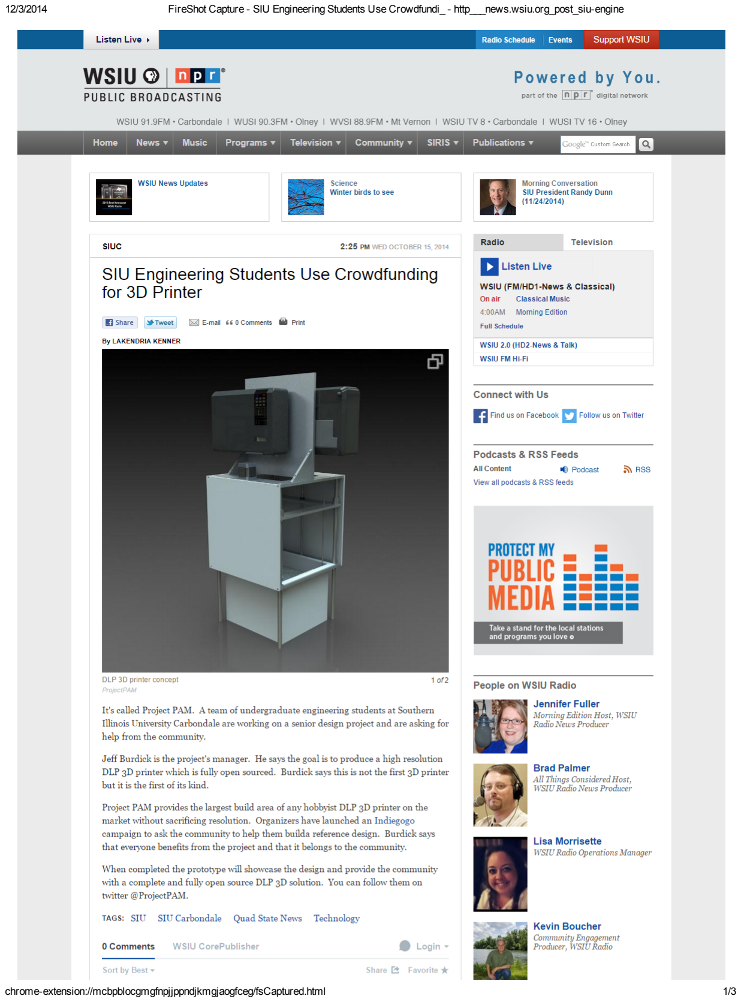
[picture p160: page 1]

12/3/2014 | FireShot Capture SIU Engineering Students Use Crowdfundi_ http___news.wsiu.org_post_siuengine
chromeextension://mcbpblocgmgfnpjjppndjkmgjaogfceg/fsCaptured.html | 1/3

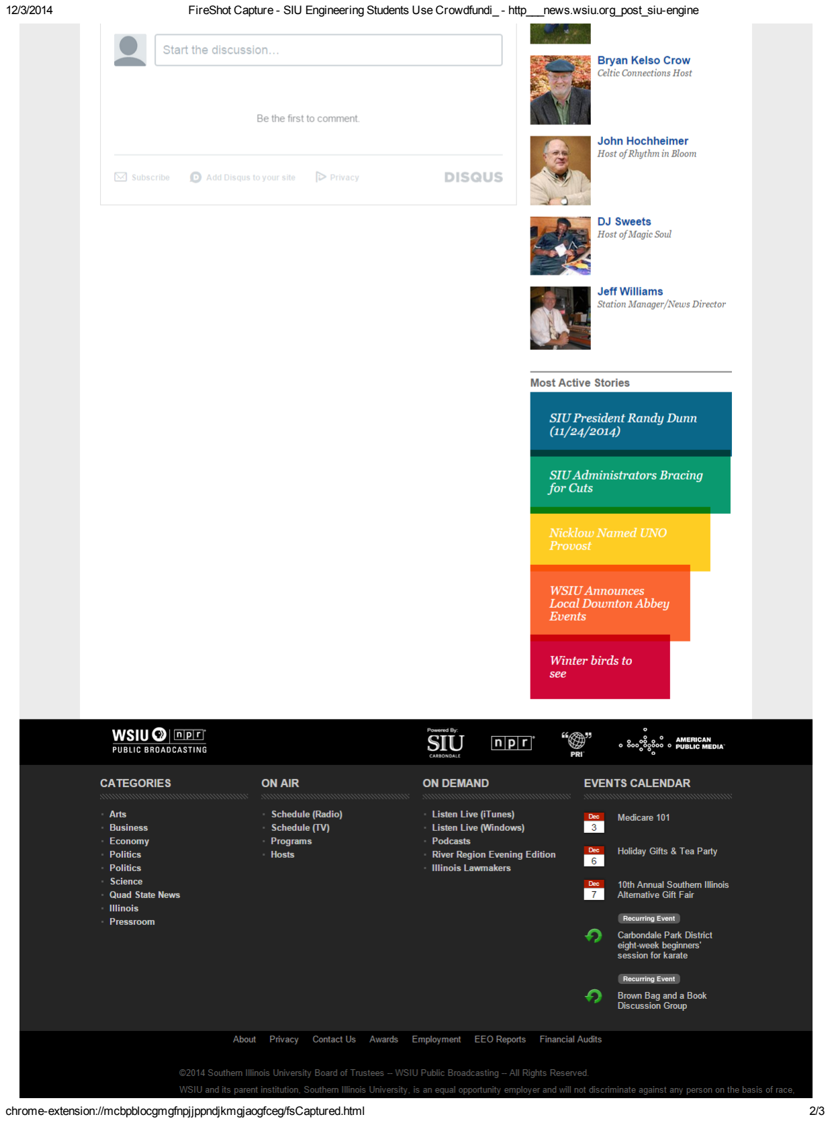
[picture p161: page 2]

chromeextension://mcbpblocgmgfnpjjppndjkmgjaogfceg/fsCaptured.html | 2/3

chromeextension://mcbpblocgmgfnpjjppndjkmgjaogfceg/fsCaptured.html | 3/3
