dan-olsen/SeniorDesign/DesignReport/Appendix/Website Screenshots/Project PAM - College Students Look to Create an Entirely Open Source DLP 3D Printer - 3DPrint.com.pdf

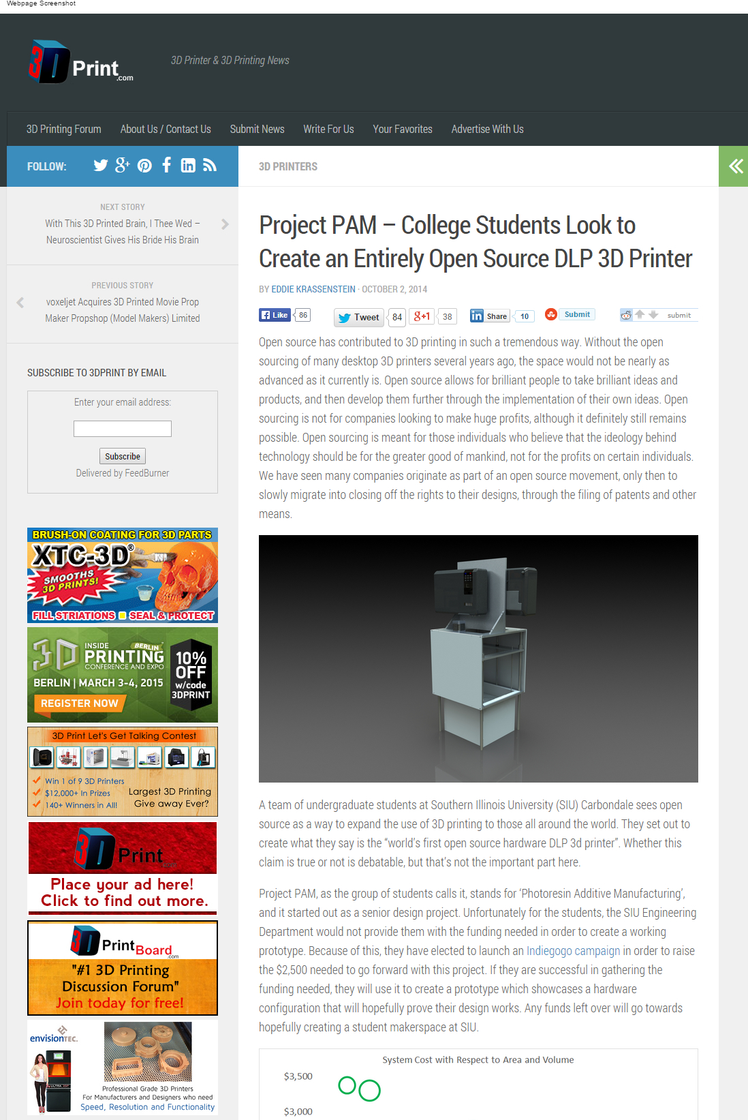
[picture p162: page 1]
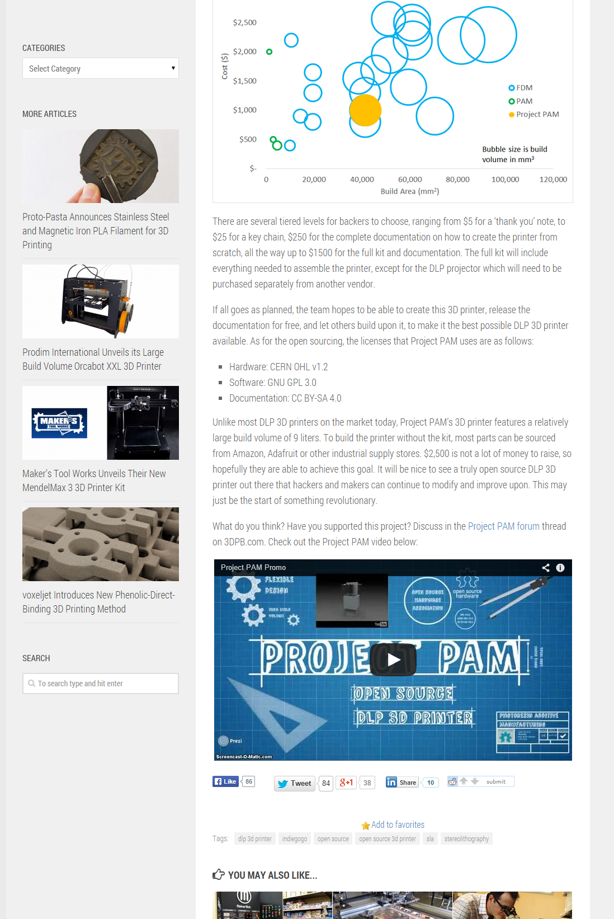
[picture p163: page 2]
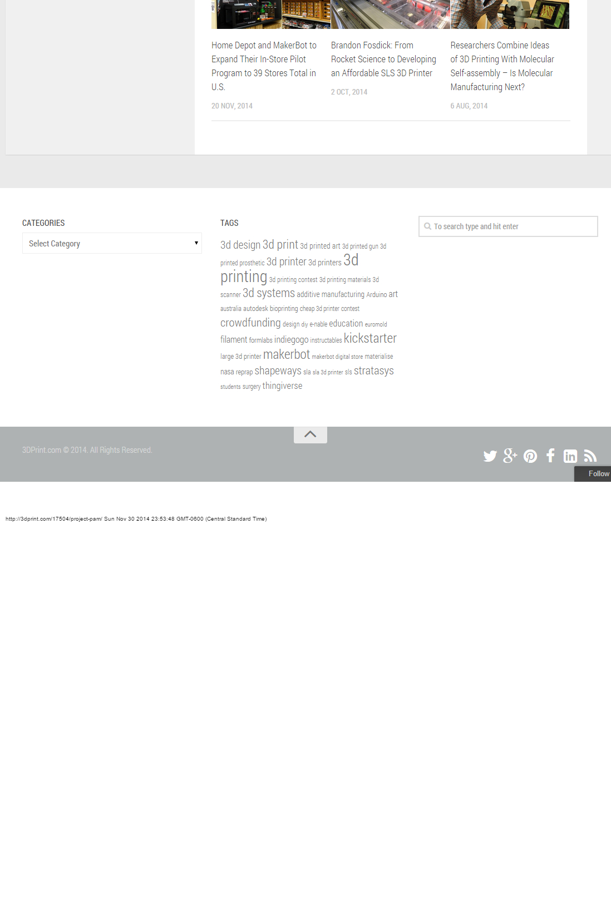
[picture p164: page 3]
