dan-olsen/SeniorDesign/DesignReport/Appendix/Images/Open Source DLP 3D Printer Project Pam - 3D Printing Industry3.png

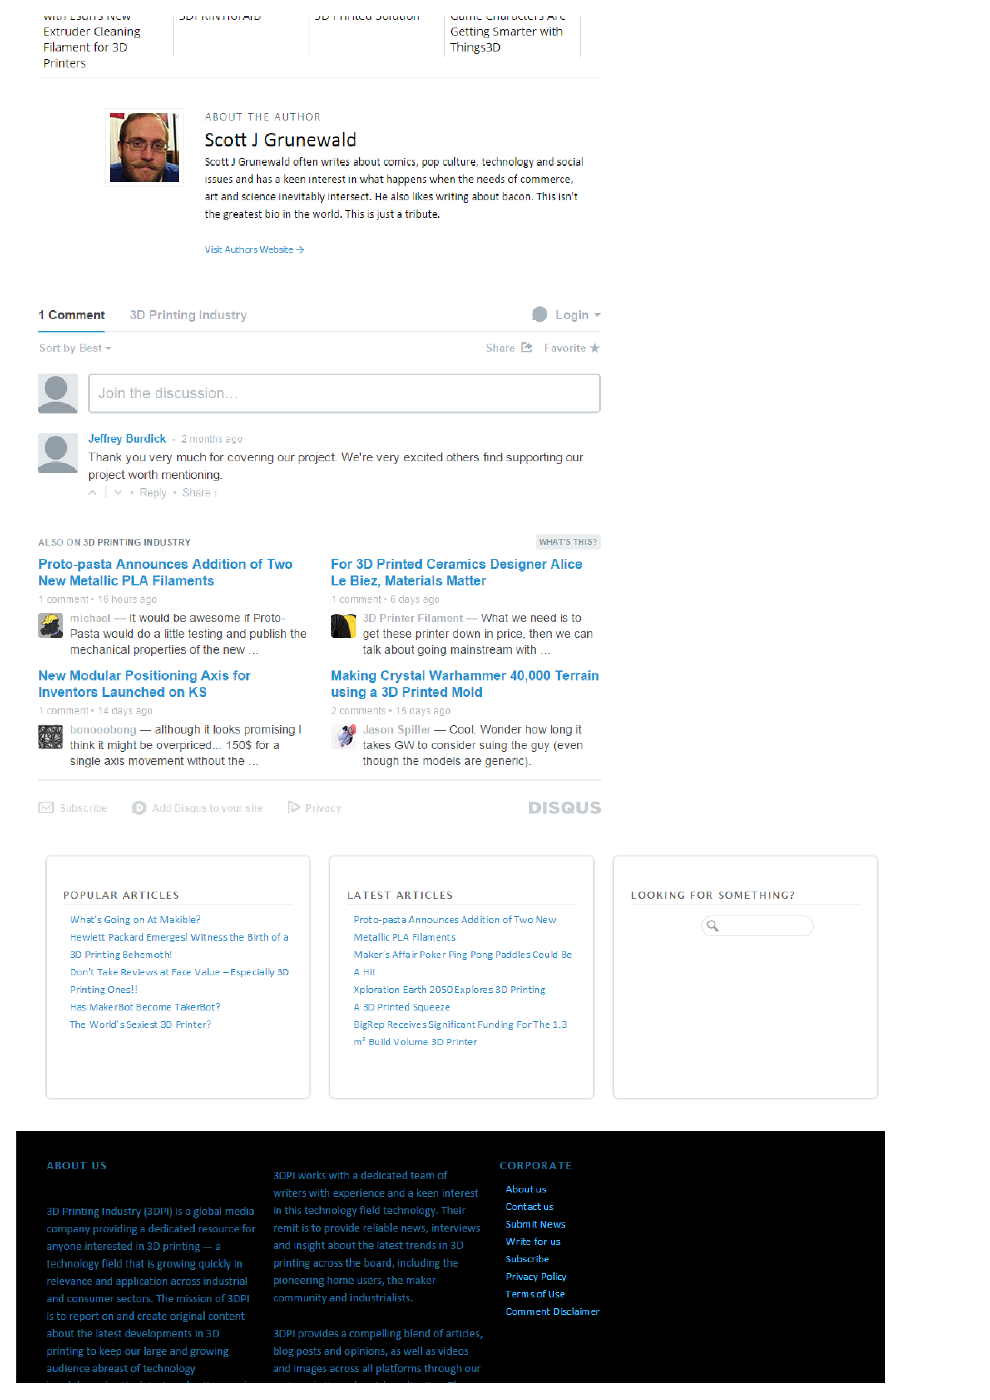
DesignReport/Appendix/Images/Open Source DLP 3D Printer Project Pam - 3D Printing Industry3.png
