dan-olsen/SeniorDesign/DesignReport/Appendix/Images/Printer Assembly1.png

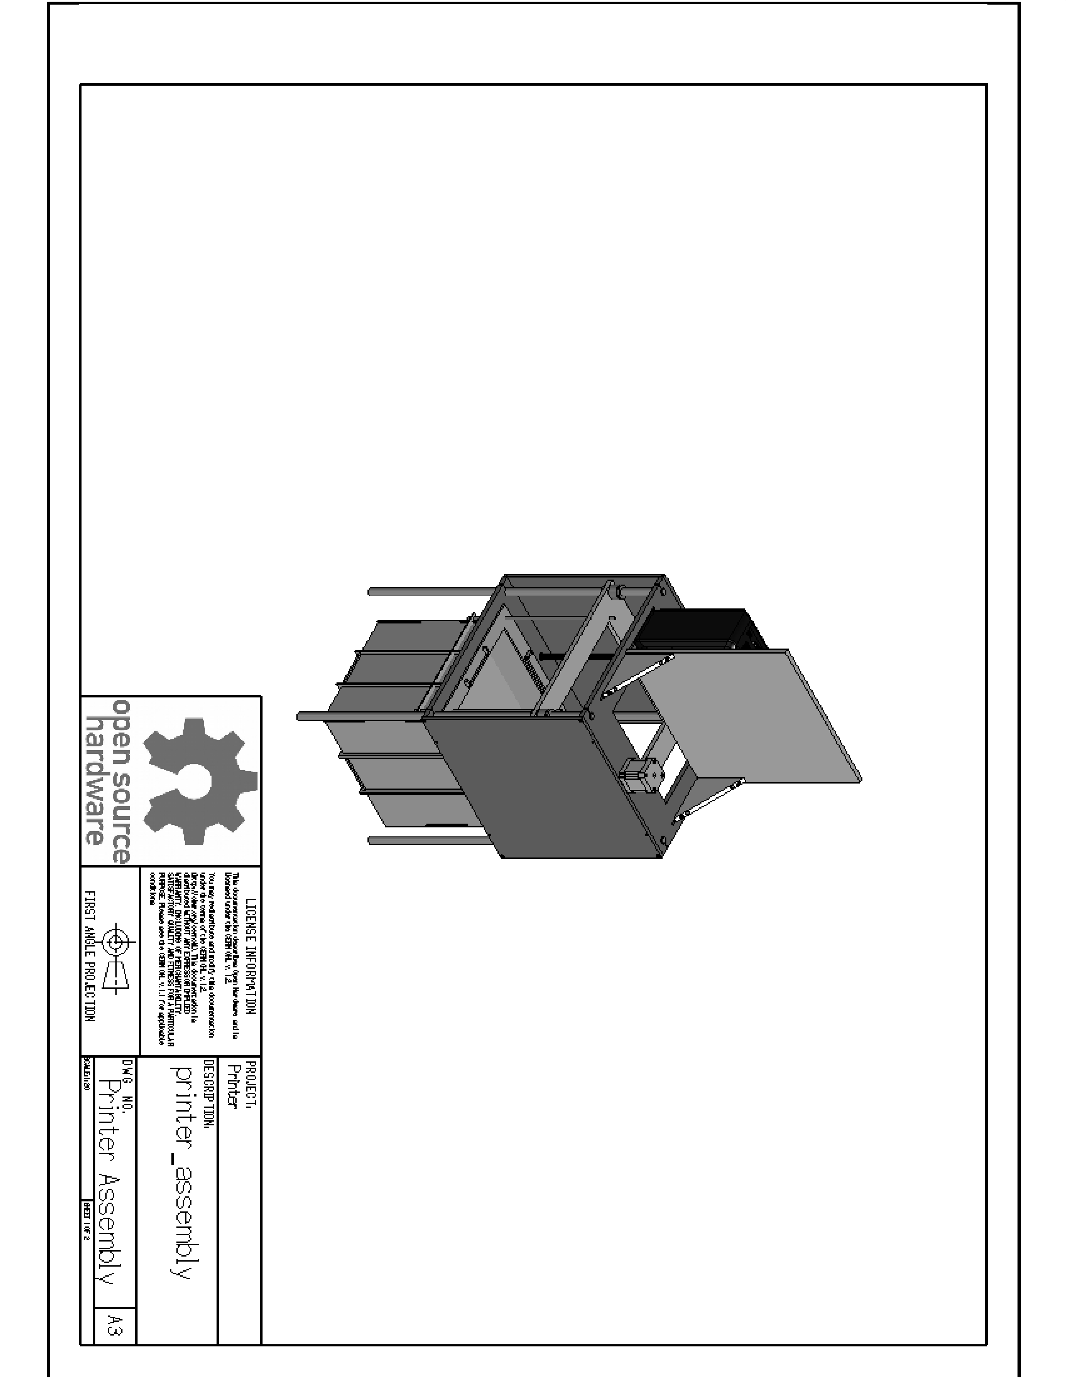
DesignReport/Appendix/Images/Printer Assembly1.png
