dan-olsen/SeniorDesign/DesignReport/Appendix/Images/Printer Assembly2.png

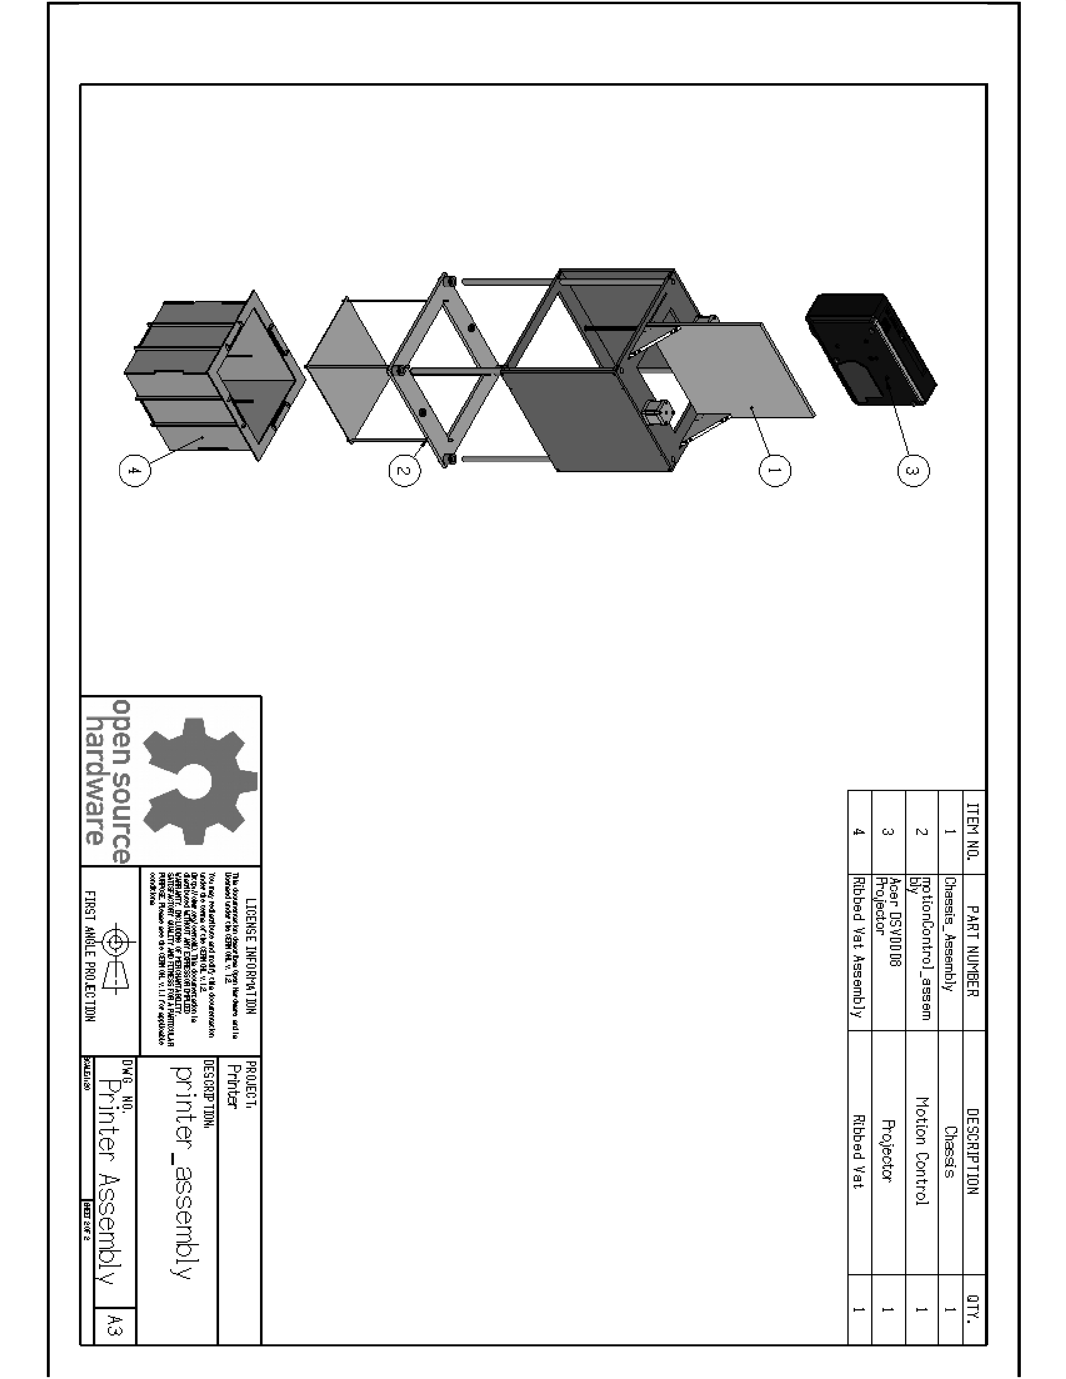
DesignReport/Appendix/Images/Printer Assembly2.png
