dan-olsen/SeniorDesign/DesignReport/Appendix/Images/Project PAM - College Students Look to Create an Entirely Open Source DLP 3D Printer - 3DPrint.com1.png

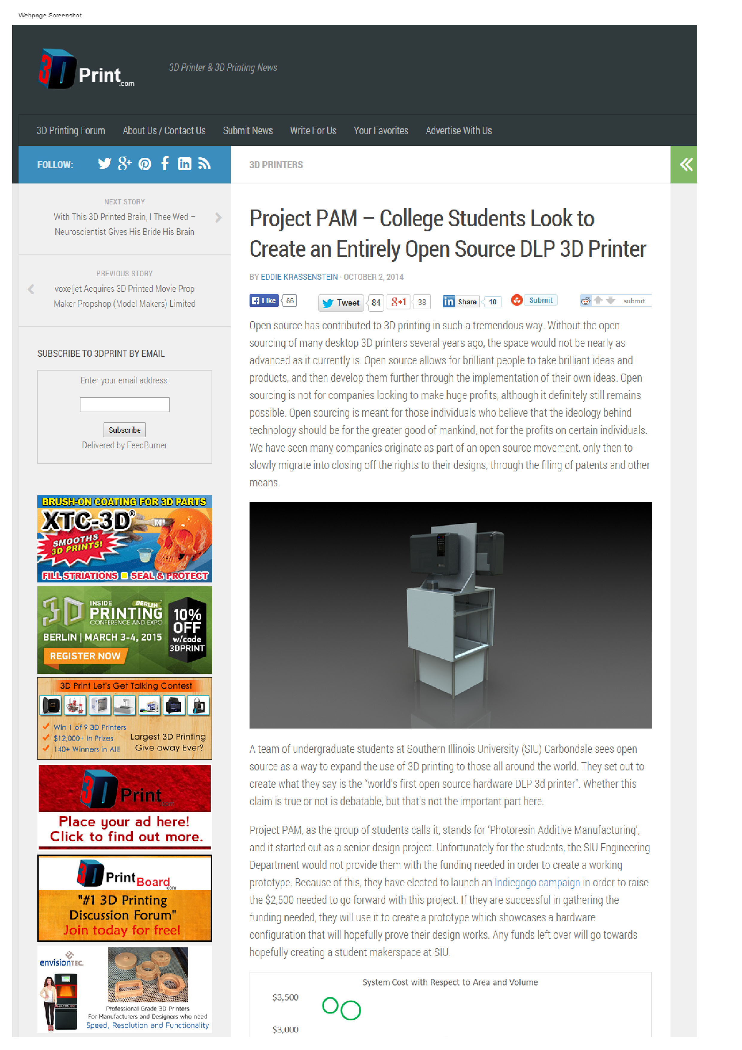
DesignReport/Appendix/Images/Project PAM - College Students Look to Create an Entirely Open Source DLP 3D Printer - 3DPrint.com1.png
