dan-olsen/SeniorDesign/DesignReport/Appendix/Images/SIU Engineering Students Use Crowdfunding for 3D Printer1.png

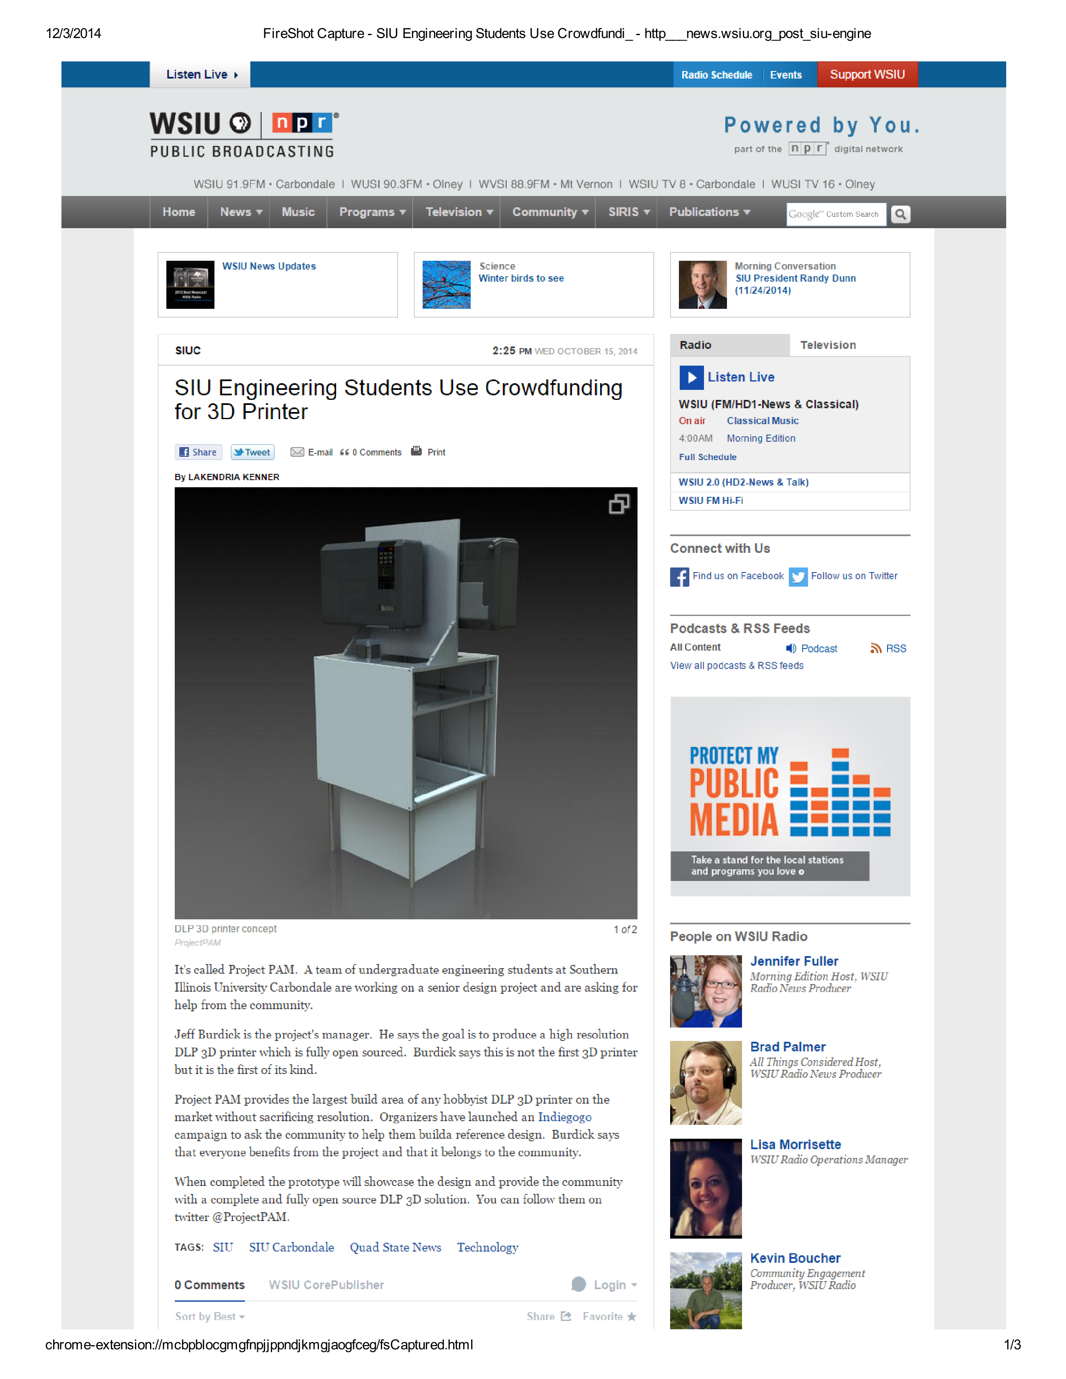
DesignReport/Appendix/Images/SIU Engineering Students Use Crowdfunding for 3D Printer1.png
