dan-olsen/SeniorDesign/Photos/Test Prints/2014-11-26 16.27.20.jpg

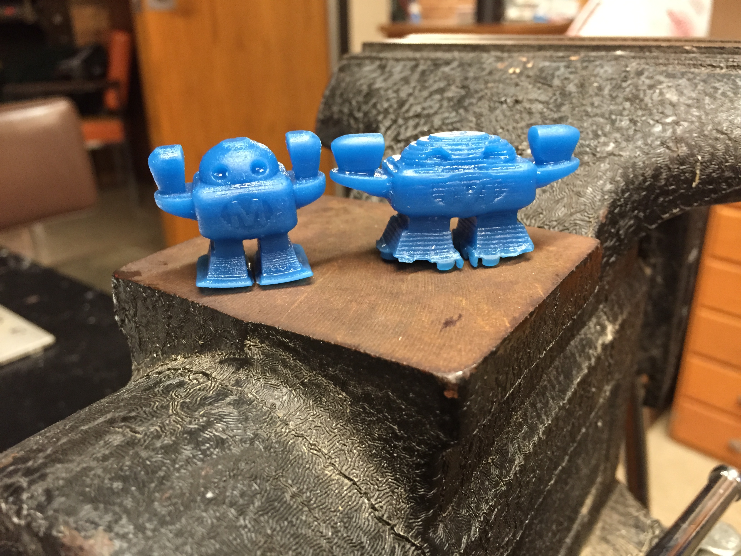
Photos/Test Prints/2014-11-26 16.27.20.jpg
