dan-olsen/SeniorDesign/Photos/Test Prints/2014-12-01 20.57.48.jpg

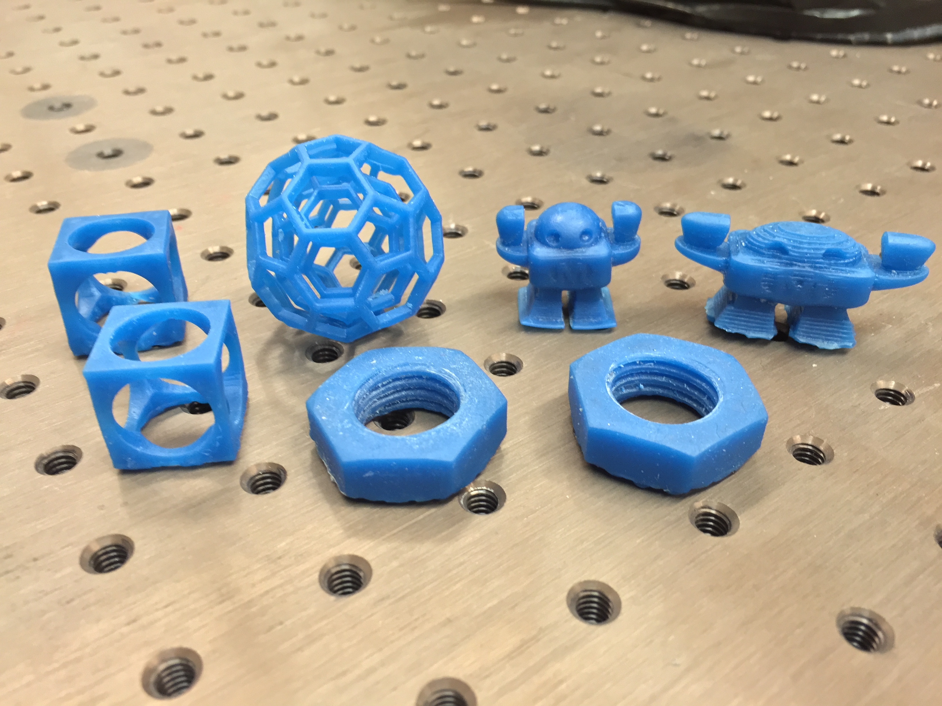
Photos/Test Prints/2014-12-01 20.57.48.jpg
