dan-olsen/SeniorDesign/Photos/Test Prints/2014-12-02 09.45.33.jpg

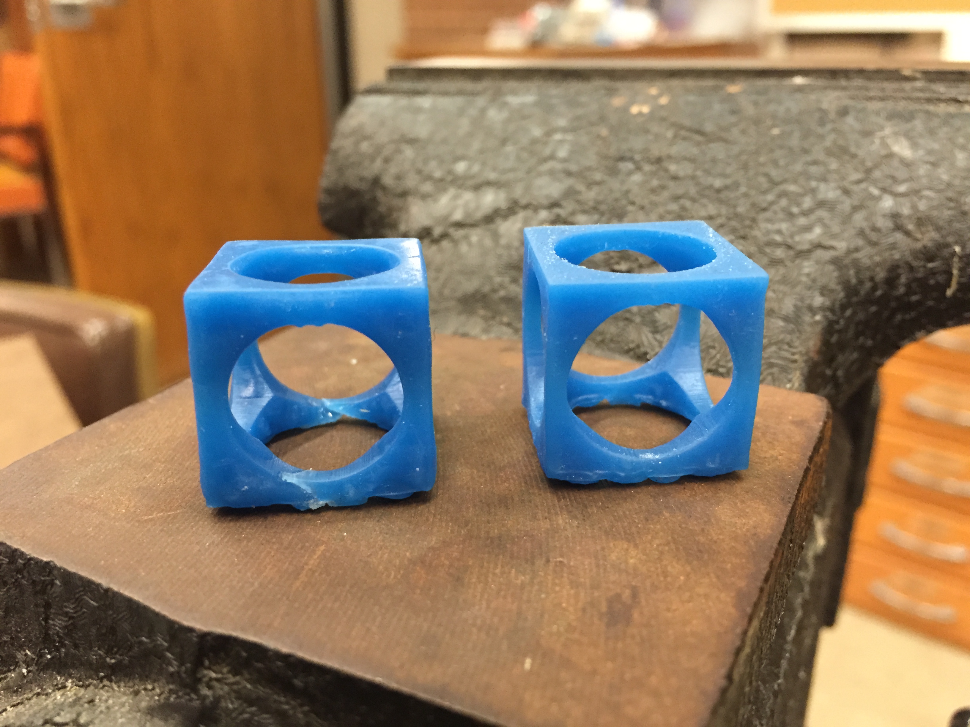
Photos/Test Prints/2014-12-02 09.45.33.jpg
