dan-olsen/SeniorDesign/Photos/Test Prints/2014-12-02 09.49.49.jpg

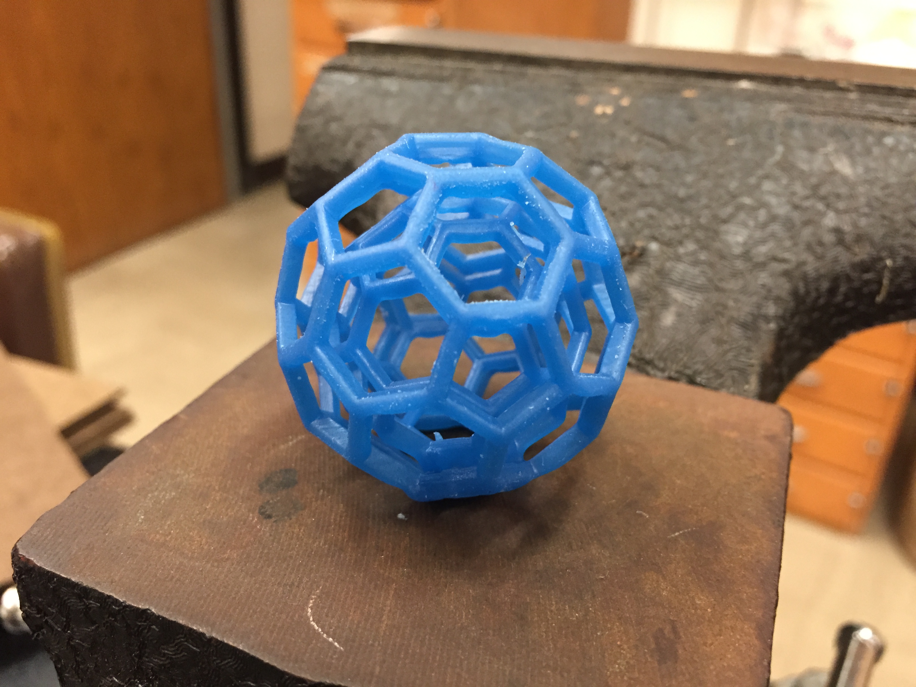
Photos/Test Prints/2014-12-02 09.49.49.jpg
