dan-olsen/SeniorDesign/Class Bullcrap/MotorTestResults.xlsx

step/mm | mm/min | mm/sec^2 | Voltage | Amps (min) | Amps (max) | Results
440.945 | 160 | 20.0 | 12 | 0.112 | 0.118 | smooth movement
440.945 | 240 | 20.0 | 12 | 0.05 | 0.07 | faster and still smooth\
440.945 | 320 | 20.0 | 12 | 0.07 | 0.12 | much faster smooth still no misstep
440.945 | 400 | 20.0 | 12 | n/a | n/a | missteps completely
440.945 | 360 | 20.0 | 12 | n/a | n/a | missteps in middle
440.945 | 340 | 20.0 | 12 | n/a | n/a | still misstepping
440.945 | 320 | 10.0 | 12 | 0.07 | 0.13 | accelerates almost just as fast
440.945 | 320 | 5.0 | 12 | 0.07 | 0.12 | reaches max velocity
440.945 | 320 | 2.5 | 12 | 0.06 |  | depending on length of move, maynot reach max velocity
440.945 | 320 | 1.0 | 12 | 0.06 | 0.07 | same as 2.5
440.945 | 240 | 1.0 | 12 | 0.05
440.945 | 240 | 2.5 | 12 | 0.06 | 0.07
440.945 | 240 | 5.0 | 12 | 0.05
440.945 | 240 | 10.0 | 12 | 0.06
440.945 | 240 | 20.0 | 12 | 0.06
440.945 | 240 | 20.0 | 18 | 0.12
440.945 | 240 | 20.0 | 8 |  |  | misstep
