dan-olsen/SeniorDesign/DesignReport/Appendix/Timeline_75_DMO.pdf

ID | Task Name | Duration | Start | Finish | Predecessors | Resource Names
1 | Indiegogo | 56 days | Mon 8/18/14 | Mon 11/3/14
2 | Prepare Indiegogo | 31 days | Mon 8/18/14 | Mon 9/29/14 | | DMO,CWS
3 | Run Indiegogo | 25 days | Tue 9/30/14 | Mon 11/3/14 | 2 | TEAM
4 | Linear Motion | 41 days | Thu 8/28/14 | Thu 10/23/14
5 | Order Parts from Departments | 6 days | Thu 8/28/14 | Thu 9/4/14 | | JPB,DMO
6 | Assemble Preliminary Linear Motion Jig | 10 days | Fri 9/5/14 | Thu 9/18/14 | 5 | JPB,CWB,NBT
7 | Assemble Motor Controler Board | 5 days | Fri 9/5/14 | Thu 9/11/14 | 5 | NAL
8 | Test Preliminary Liner Motion System | 5 days | Fri 9/19/14 | Thu 9/25/14 | 6,7 | JPB,CWS,NAL
9 | Optimize Linear Motion System | 20 days | Fri 9/26/14 | Thu 10/23/14 | 8 | CWS,NAL
10 | Software | 40 days | Tue 9/30/14 | Mon 11/24/14
11 | Printer Control Software | 40 days | Tue 9/30/14 | Mon 11/24/14 | 2 | DMO
12 | Grbl H-Bridge Support | 22 days | Fri 10/24/14 | Mon 11/24/14 | 9 | CWS,NAL
13 | CAD Models | 78 days | Mon 8/18/14 | Wed 12/3/14
14 | Research GD&T | 16 days | Mon 8/18/14 | Mon 9/8/14 | | NBT
15 | Design Coupler | 10 days | Tue 9/9/14 | Mon 9/22/14 | 14 | NBT,JPB
16 | New Vat Design | 20 days | Tue 9/23/14 | Mon 10/20/14 | 15 | NBT
17 | GD&T Models | 32 days | Tue 10/21/14 | Wed 12/3/14 | 16 | NBT
18 | Projector/Resins | 54 days | Fri 9/19/14 | Wed 12/3/14
19 | Chassis Assembly | 48 days | Fri 9/19/14 | Tue 11/25/14 | 6 | JPB
20 | Projector/Optics Assembly | 9 days | Tue 11/4/14 | Fri 11/14/14 | 3 | CWB
21 | First System Test | 1 day | Wed 11/26/14 | Wed 11/26/14 | 20,19 | TEAM
22 | Troubleshooting/Debugging | 5 days | Thu 11/27/14 | Wed 12/3/14 | 21 | TEAM
23 | Presentation Phase | 23 days | Tue 11/4/14 | Thu 12/4/14
24 | Report Rough Draft | 8 days | Tue 11/4/14 | Thu 11/13/14 | 3 | CWB
25 | Presentation | 5 days | Fri 11/14/14 | Thu 11/20/14 | 24 | TEAM
26 | Write Report | 15 days | Fri 11/14/14 | Thu 12/4/14 | 24 | TEAM
27 | Documentation | 15 days | Fri 11/14/14 | Thu 12/4/14 | 24 | TEAM
28 | Demonstration | 1 day | Thu 12/4/14 | Thu 12/4/14 | 22,17 | TEAM
29 | Posters | 1 day | Thu 12/4/14 | Thu 12/4/14 | 22 | TEAM

JPB,DMO

JPB,CWB,NBT

NAL

NBT

NBT,JPB

8/17 | 8/24 | 8/31 | 9/7 | 9/14 | 9/21
| | September

Task

Split

Milestone

Summary

Project Summary

Inactive Task

Inactive Milestone

Inactive Summary

Manual Task

Duration-only

Manual Summary Rollup

Manual Summary

Start-only

Finish-only

External Tasks

External Milestone

Deadline

Progress

Manual Progress

Page 1

Project: Timeline_75_DMO
Date: Thu 12/4/14

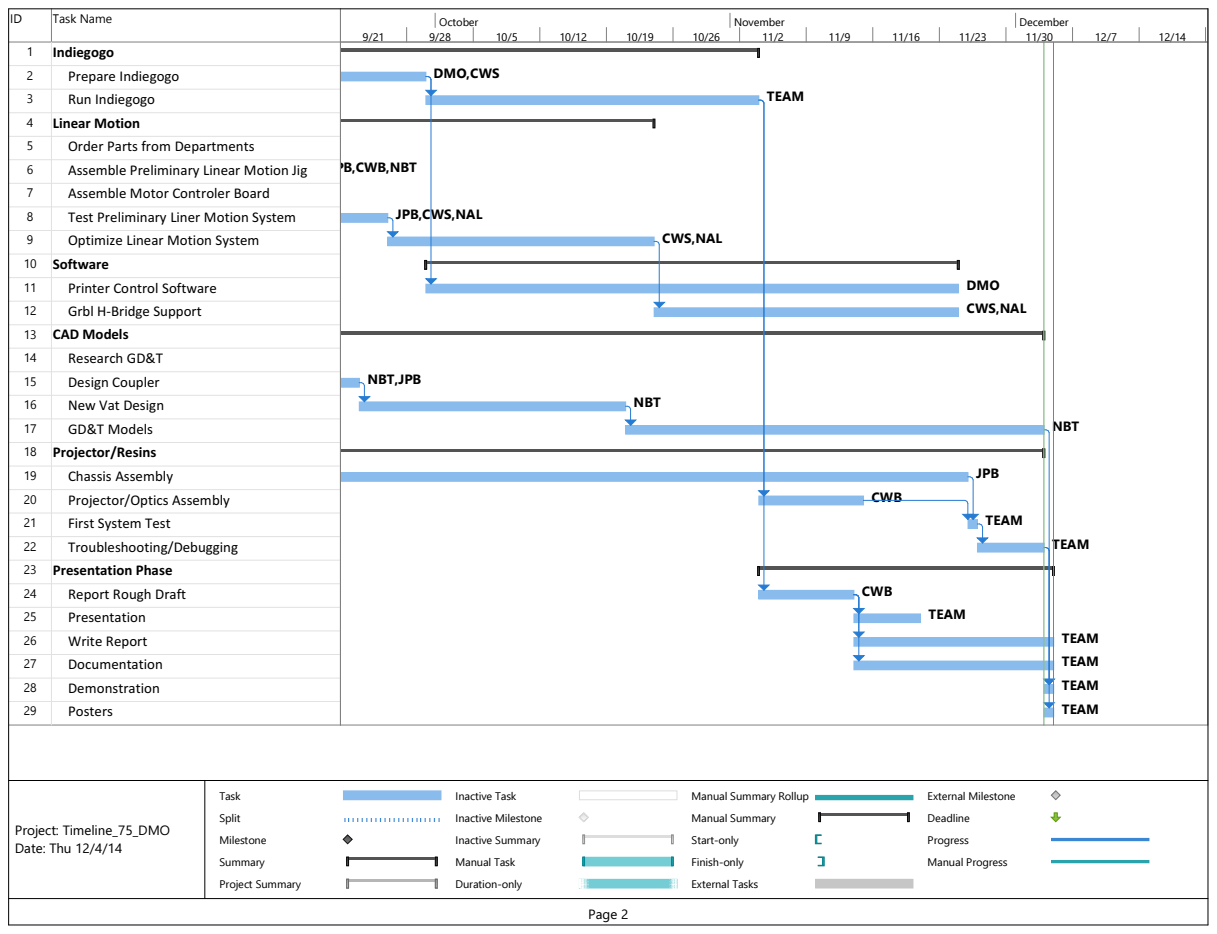
[picture p186: page 2]
DMO; CWS,NAL; NBT,JPB; NBT; JPB; CWB; TEAM; October; November; December; Task; Split; Milestone; Summary; Project Summary; Inactive Task; Inactive Milestone; Inactive Summary; Manual Task; Duration-only; Manual Summary; Start-only; Finish-only; External Tasks; External Milestone; Deadline; Progress; Manual Progress; Page 2; Project: Timeline_75_DMO Date: Thu 12/4/14

ID | Task Name

1 Indiegogo | | JPB,CWS,NAL | DMO,CWS CWS,NAL | TEAM
2 Prepare Indiegogo
3 Run Indiegogo
4 Linear Motion
5 Order Parts from Departments
6 Assemble Preliminary Linear Motion Jig
7 Assemble Motor Controler Board
8 Test Preliminary Liner Motion System
9 Optimize Linear Motion System
10 Software
11 Printer Control Software
12 Grbl H-Bridge Support
13 CAD Models
14 Research GD&T
15 Design Coupler
16 New Vat Design
17 GD&T Models
18 Projector/Resins
19 Chassis Assembly
20 Projector/Optics Assembly
21 First System Test
22 Troubleshooting/Debugging
23 Presentation Phase
24 Report Rough Draft
25 Presentation
26 Write Report
27 Documentation
28 Demonstration
29 Posters

JPB,CWB,NBT

CWB

Manual Summary Rollup
