dan-olsen/SeniorDesign/DesignReport/Appendix/Timeline_75_DMO_proposed_reworked.pdf

ID | Task Name | Duration | Start | Finish | Predecessors | Resource Names
1 | Build Phase | 30 days | Mon 8/18/14 | Fri 9/26/14
2 | Order Parts | 5 days | Mon 8/18/14 | Fri 8/22/14 | | CWS,NAL
3 | Linear Motion Assembly | 20 days | Mon 8/25/14 | Fri 9/19/14 | 2 | JPB,CWS,NAL
4 | GD&T Linear Motion CAD Models | 20 days | Mon 8/25/14 | Fri 9/19/14 | 2 | NBT
5 | Test Liner Motion System | 0 days | Mon 9/22/14 | Mon 9/22/14 | 3,4 | JPB,CWS,NAL
6 | Resin Tests | 5 days | Mon 8/18/14 | Fri 8/22/14 | | CWB
7 | GD&T Resin Vat CAD Models | 5 days | Mon 8/18/14 | Fri 8/22/14 | | NBT
8 | Vat Assembly | 10 days | Mon 8/25/14 | Fri 9/5/14 | 6,7 | CWB
9 | Chassis Assembly | 15 days | Mon 8/18/14 | Fri 9/5/14 | | JPB
10 | GD&T Chassis CAD Models | 15 days | Mon 8/18/14 | Fri 9/5/14 | | NBT
11 | Printer Control Software | 30 days | Mon 8/18/14 | Fri 9/26/14 | | DMO
12 | GD&T Projector/Optics CAD Models | 10 days | Mon 9/8/14 | Fri 9/19/14 | 8,9,10 | NBT
13 | Projector/Optics Assembly | 10 days | Mon 9/8/14 | Fri 9/19/14 | 9,8,10 | CWB,JPB
14 | Test Photoresin Cure with Projector | 0 days | Mon 9/22/14 | Mon 9/22/14 | 13,12
15 | System Assembly | 5 days | Mon 9/22/14 | Fri 9/26/14 | 13,3 | JPB,CWB,NAL,CWS
16 | Testing Phase | 30 days | Mon 9/29/14 | Fri 11/7/14
17 | First System Test | 5 days | Mon 9/29/14 | Fri 10/3/14 | 15,11 | TEAM
18 | Troubleshooting/Debugging | 25 days | Mon 10/6/14 | Fri 11/7/14 | 17 | TEAM
19 | Presentation Phase | 25 days | Mon 11/10/14 | Fri 12/12/14
20 | Write Report | 15 days | Mon 11/10/14 | Fri 11/28/14 | 18 | TEAM
21 | Documentation | 15 days | Mon 11/10/14 | Fri 11/28/14 | 18 | TEAM
22 | Demonstration | 5 days | Mon 12/1/14 | Fri 12/5/14 | 21,20 | TEAM
23 | Posters | 5 days | Mon 12/1/14 | Fri 12/5/14 | 21,20 | TEAM
24 | Presentation | 5 days | Mon 12/8/14 | Fri 12/12/14 | 22,23 | TEAM

CWS,NAL

CWB

NBT

CWB

JPB

NBT

8/17 | 8/24 | 8/31 | 9/7 | 9/14
| | September

Task

Split

Milestone

Summary

Project Summary

Inactive Task

Inactive Milestone

Inactive Summary

Manual Task

Duration-only

Manual Summary Rollup

Manual Summary

Start-only

Finish-only

External Tasks

External Milestone

Deadline

Progress

Manual Progress

Page 1

Project: Timeline_75_DMO_prop Date: Thu 12/4/14

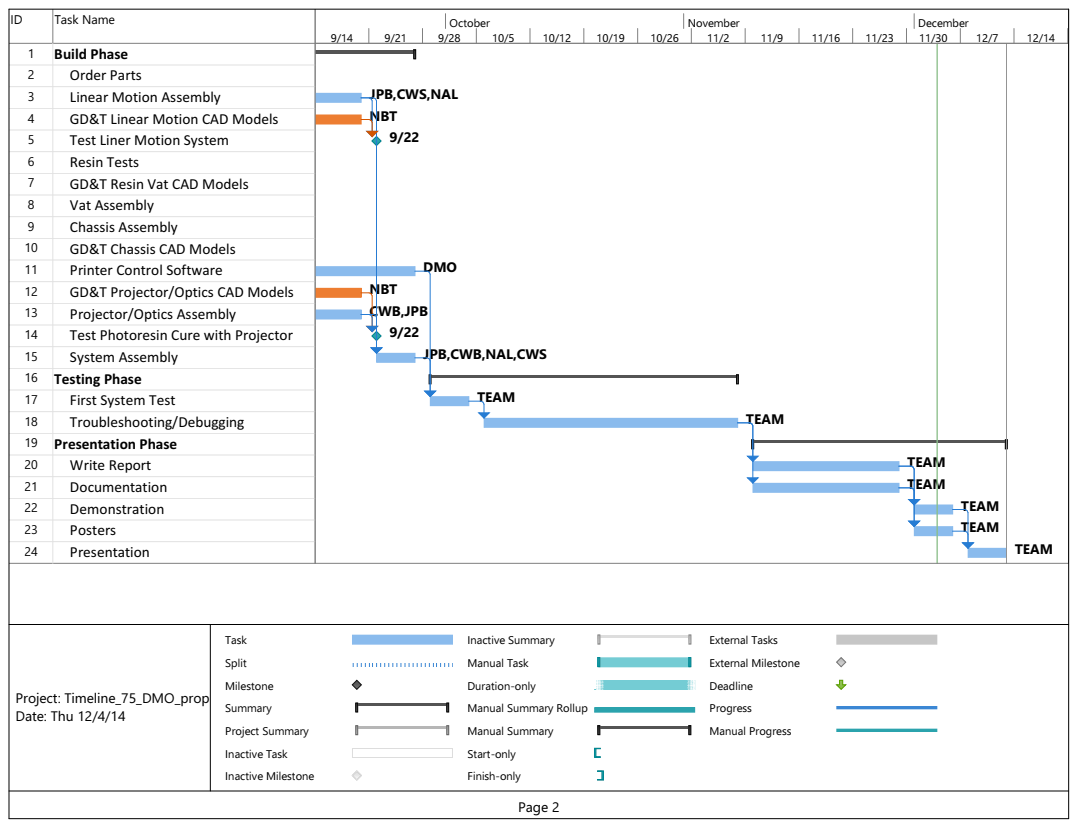
[picture p187: page 2]
NBT; DMO; TEAM; October; November; December; Task; Split; Milestone; Summary; Project Summary; Inactive Task; Inactive Milestone; Inactive Summary; Manual Task; Duration-only; Manual Summary; Start-only; Finish-only; External Tasks; External Milestone; Deadline; Progress; Manual Progress; Page 2; Project: Timeline_75_DMO_prop Date: Thu 12/4/14

ID | Task Name

1 | Build Phase | JPB,CWS,NAL
2 | Order Parts
3 | Linear Motion Assembly
4 | GD&T Linear Motion CAD Models
5 | Test Liner Motion System
6 | Resin Tests
7 | GD&T Resin Vat CAD Models
8 | Vat Assembly
9 | Chassis Assembly
10 | GD&T Chassis CAD Models
11 | Printer Control Software
12 | GD&T Projector/Optics CAD Models
13 | Projector/Optics Assembly
14 | Test Photoresin Cure with Projector
15 | System Assembly
16 | Testing Phase
17 | First System Test
18 | Troubleshooting/Debugging
19 | Presentation Phase
20 | Write Report
21 | Documentation
22 | Demonstration
23 | Posters
24 | Presentation

NBT
CWB,JPB
JPB,CWB,NAL,CWS

Manual Summary Rollup
