dan-olsen/SeniorDesign/Proposal/Sources/GUIDrawings.pdf

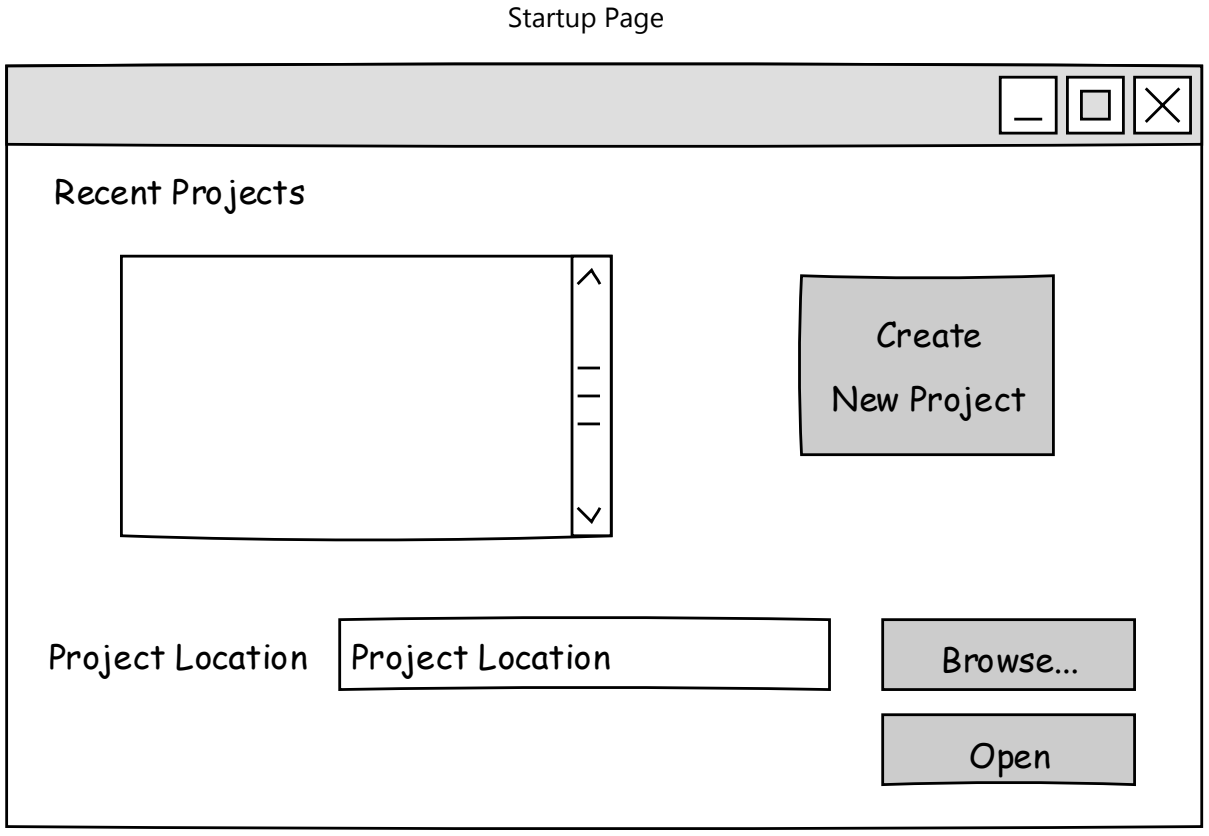
[picture p188: figure]
Startup Page; Recent Projects; Open; Create; New Project

Project Location Project Location | Browse...

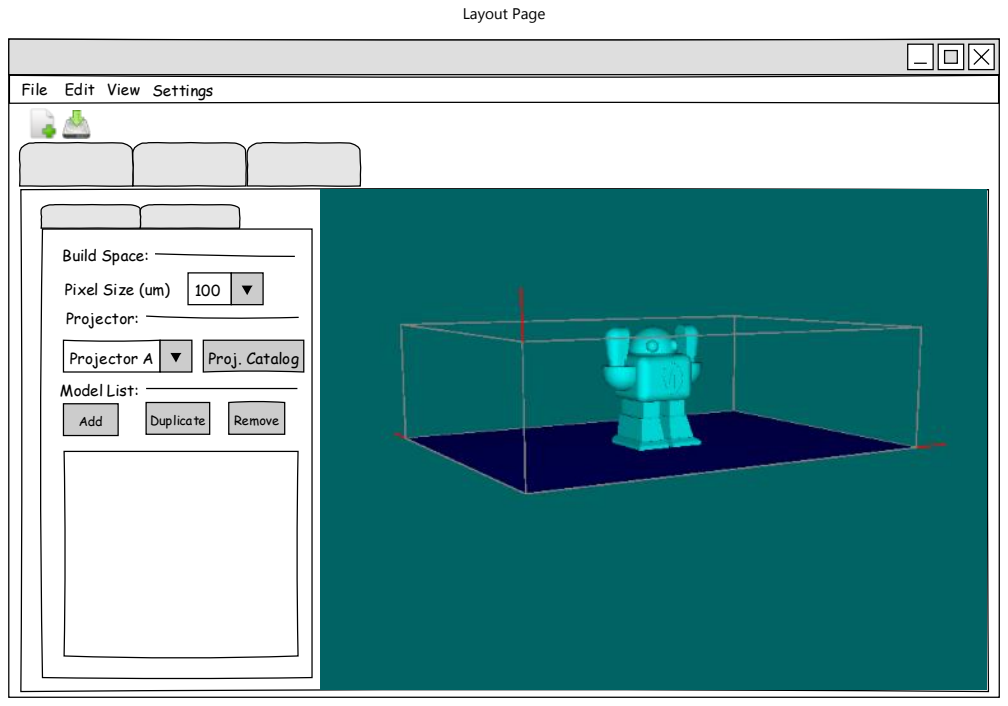
[picture p189: page 2]
Layout Page; Model List:; Build Space:; Add; Duplicate; Remove; Pixel Size (um); Projector:; Projector A; Proj. Catalog

File Edit View Settings

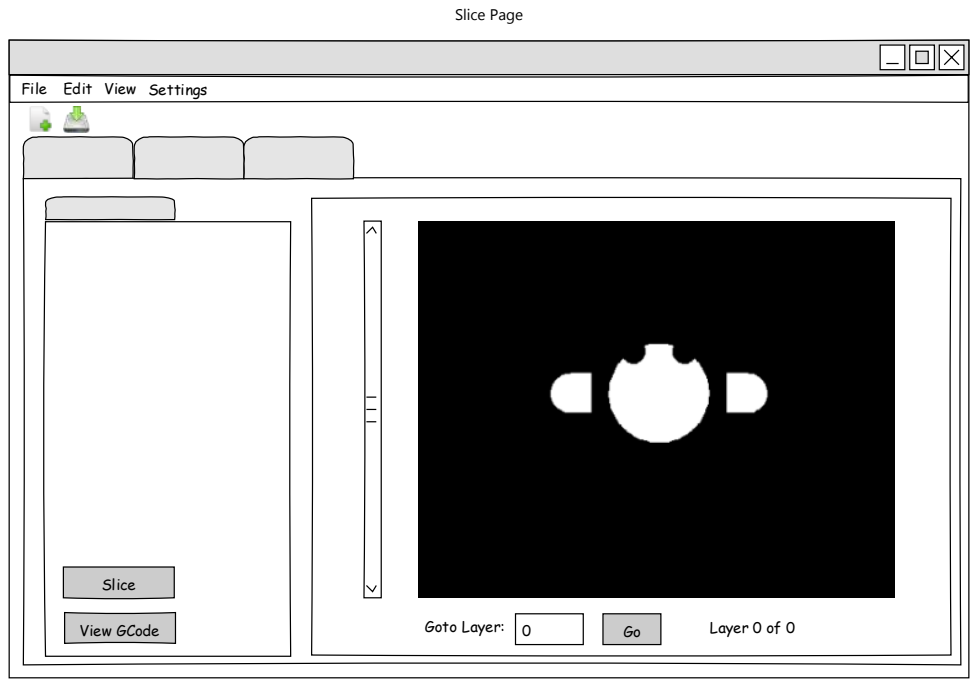
[picture p190: page 3]
Slice Page; View GCode; Goto Layer:; Layer 0 of 0; Slice

File Edit View Settings

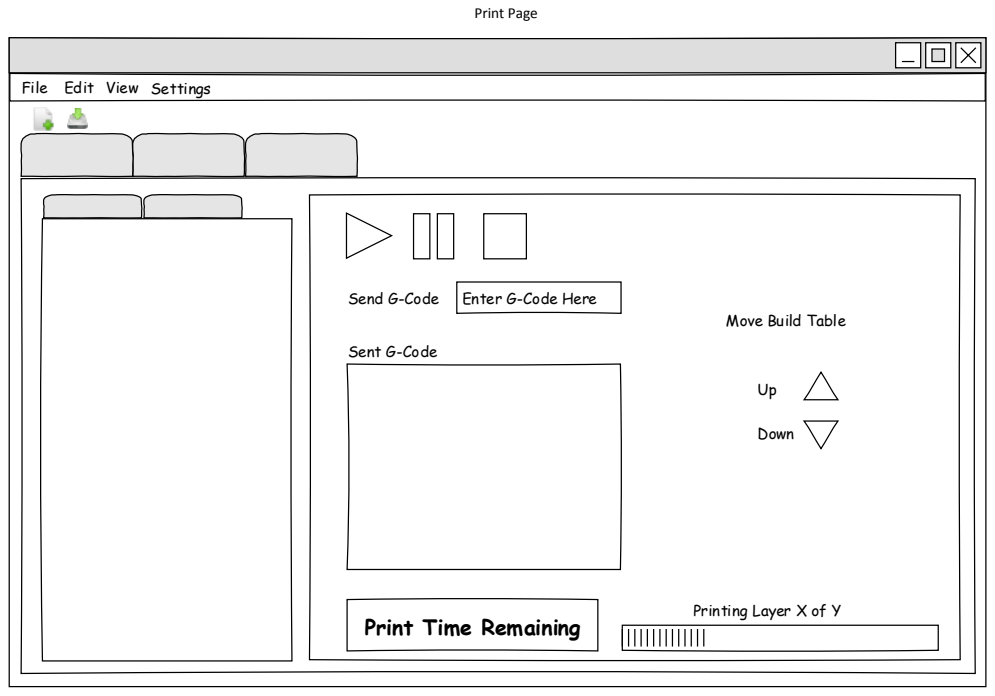
[picture p191: page 4]
Print Page; Send G-Code; Enter G-Code Here; Sent G-Code; Down

File Edit View Settings

Move Build Table

Printing Layer X of Y

Print Time Remaining
