dan-olsen/SeniorDesign/DesignReport/Appendix/Google Analytics/Analytics All Web Site Data Audience Overview 20140901-20141202.pdf

## Sep 1, 2014 Dec 2, 2014 Audience Overview

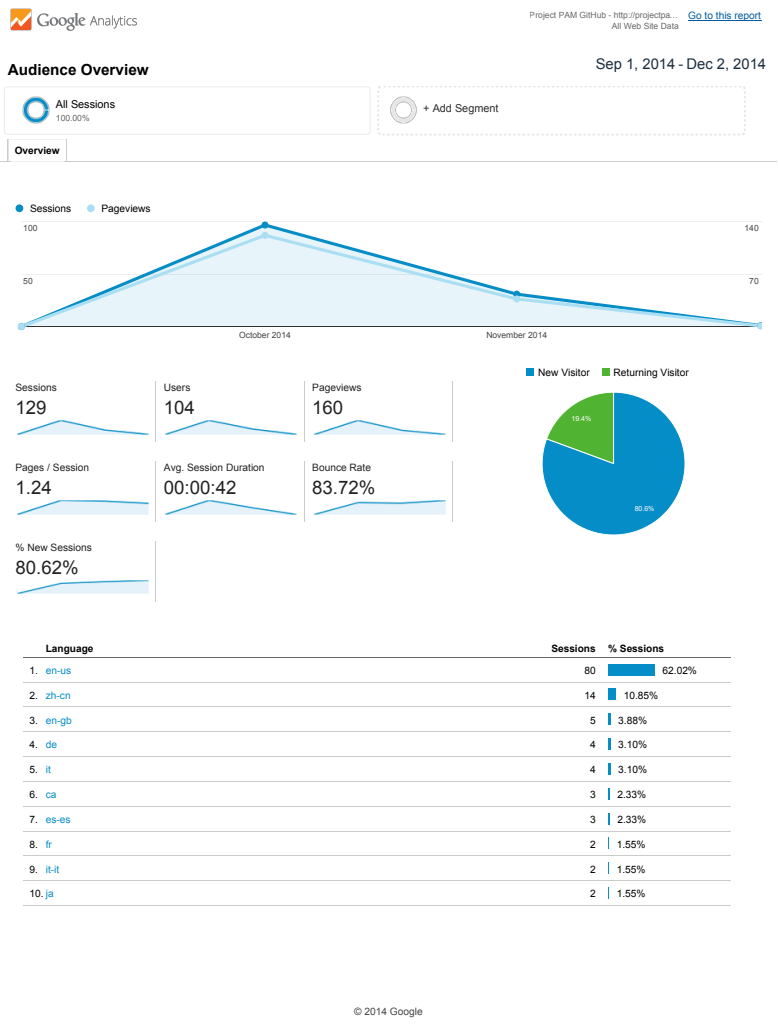
[picture p192: page 1]
Language; Sessions % Sessions; Overview; + Add Segment; Sessions; Pageviews; October 2014; November 2014; Sessions 129; Users 104; Pageviews 160; Pages / Session 1.24; Bounce Rate 83.72%; % New Sessions 80.62%; New Visitor; Returning Visitor; © 2014 Google; All Sessions 100.00%

Project PAM GitHub http://projectpa… Go to this report (https://www.google.com/analytics/web/?hl=en)

All Web Site Data

Avg. Session Duration
