dan-olsen/SeniorDesign/DesignReport/Appendix/Google Analytics/Analytics All Web Site Data My Dashboard 20140901-20141202.pdf

My Dashboard | Sep 1, 2014 Dec 2, 2014

## New Users

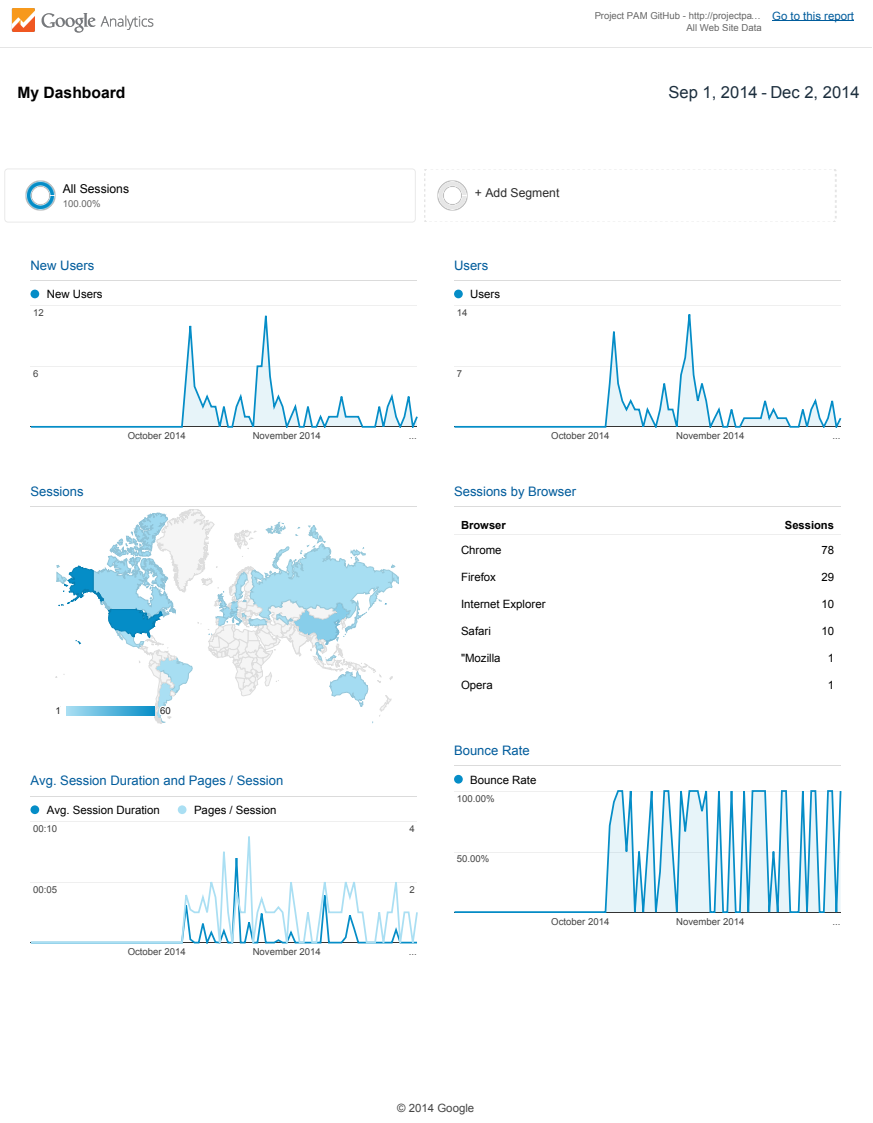
[picture p193: page 1]
Sessions; Users; Browser; Chrome; Firefox; Internet Explorer; Safari; "Mozilla; Opera; Bounce Rate; + Add Segment; New Users; October 2014; November 2014; Avg. Session Duration; Pages / Session; © 2014 Google; All Sessions 100.00%

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

All Web Site Data

Sessions by Browser

Avg. Session Duration and Pages / Session
