dan-olsen/SeniorDesign/(commit log)

2014-08-26 Move files from Google Drive to GitHub
    [Budget.xlsx, Budget_75_JPB.xlsx, marketGap.xlsx]
2014-08-26 Add AIL_75_JPB.xlsx
    [AIL_75_JPB.xlsx]
2014-08-26 Separate Fall and Spring Semester AIL
    [AIL_75_JPB_Fall.xlsx, AIL_75_JPB_Spring.xlsx]
2014-08-28 Add Parts Order Form
    [ECE_ME Parts Order Form-14P.xls]
2014-08-28 Add Attendance Sheet
    [Team75-AttendanceSrD-CWB.xlsx]
2014-08-28 add Updated Order Form
    [ECE_Parts Order Form_75.xlsx]
2014-08-29 Update AIL and Timeline
    [AIL_75_JPB_Fall.xlsx]
2014-09-02 Remove Parts Order Form Template
    [ECE_ME Parts Order Form-14P.xls]
2014-09-02 Update ECE Parts Order Form to Proper Format
    [ECE_Parts Order Form_75.xlsx]
2014-09-02 Update Budget and Timeline
    [Budget.xlsx]
2014-09-09 Update AIL
    [AIL_75_JPB_Fall.xlsx]
2014-09-09 Update ECE Parts Order Form
    [ECE_Parts Order Form_75.xlsx]
2014-09-15 Update Budget to reflect Parts Order Form
    [Budget_75_JPB.xlsx]
2014-09-21 Add empty ME order form
    [ME_Parts Order Form_75.xlsx]
2014-09-24 Add more content
    [marketGap.xlsx]
2014-09-24 Change Market Gap colors
    [marketGap.xlsx]
2014-09-25 Change market gap color
    [marketGap.xlsx]
2014-09-30 AIL Updated
    added grbl h-bridge todo
    [AIL_75_JPB_Fall.xlsx]
2014-09-30 Add MediaOutlist.xlsx
    [MediaOutlist.xlsx]
2014-10-01 Add more emails
    [MediaOutlist.xlsx]
2014-10-01 Add DE emails
    [MediaOutlist.xlsx]
2014-10-01 Add contacted on dates
    [MediaOutlist.xlsx]
2014-10-09 Add more contacts
    [MediaOutlist.xlsx]
2014-10-09 Update Media Outlist
    [MediaOutlist.xlsx]
2014-10-09 Add Wk7 Report and update AIL
    [AIL_75_JPB_Fall.xlsx]
2014-10-09 Add MotorTestResults
    [MotorTestResults.xlsx]
2014-10-21 Remove empty row
    [AIL_75_JPB_Fall.xlsx]
2014-11-13 Rename DesignPres dir to ProposalPres
    [marketGap.xlsx]
2014-11-13 Add proposalpres for basis of design pre
    [marketGap.xlsx]
2014-11-16 Add Jeff's Material
    [SideViewForPresentation.SLDDRW]
2014-11-18 Update Budget
    [Budget_75_JPB.xlsx]
2014-12-01 rename last years 3d printer design report
2014-12-02 Update Market Gap Formatting
    [marketGap.xlsx]
2014-12-02 Add Test print photos
2014-12-04 Finished report
    [Budget_75_JPB.xlsx]
